ReadHeadRedemption/SeniorDesignSp26Su26/Website/Documents/Team/Andrew Photo.jpg

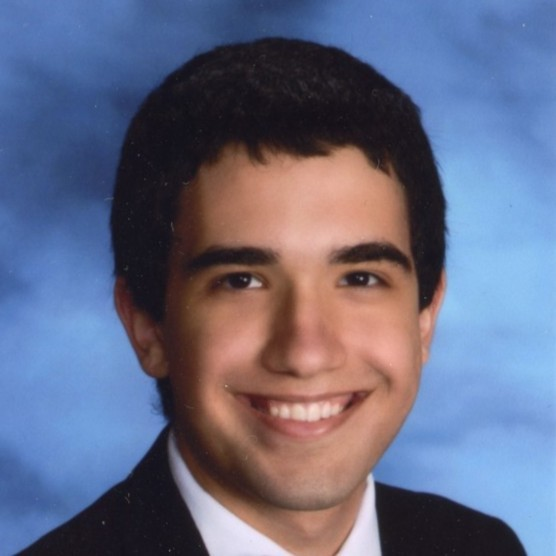
Website/Documents/Team/Andrew Photo.jpg
