ReadHeadRedemption/SeniorDesignSp26Su26/Website/Documents/Team/EthanPhoto.jpg

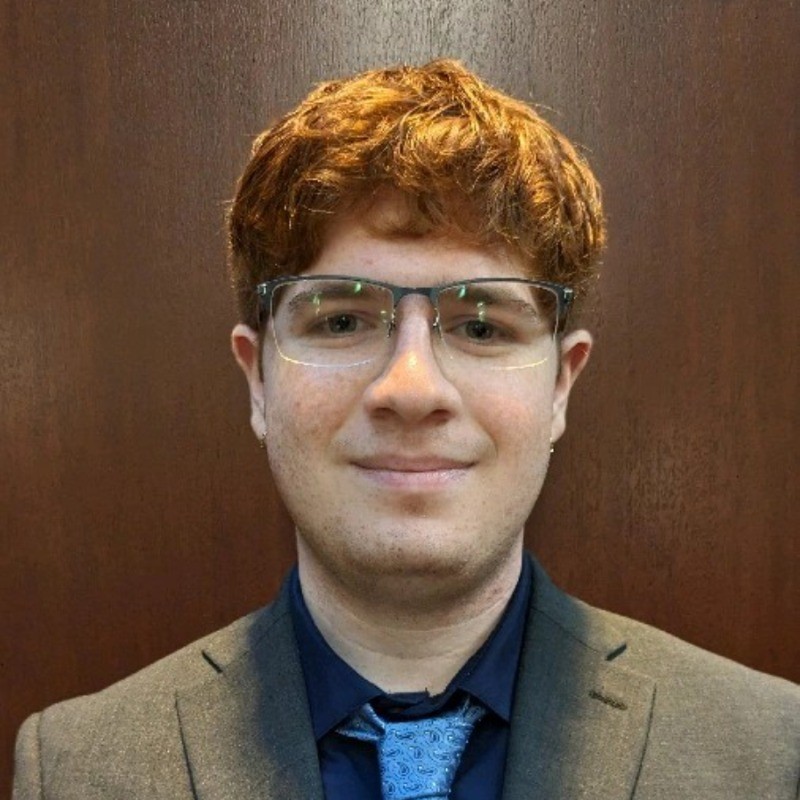
Website/Documents/Team/EthanPhoto.jpg
