ReadHeadRedemption/SeniorDesignSp26Su26/Website/Documents/SD1/D&C Submission.pdf

## Conductive Inking Prototype

Group 7 Authors:

Ethan Baker | Andrew Eppich | Jeremy Jiang | Giancarlo Luna
Computer Engineering | Computer Engineering | Computer Engineering | Electrical Engineering

Review Committee:

Dr. Avra Kundu | ECE | | Lab Manager
Dr. Nazanin Rahnavard | ECE | Professor
Michael Haas (tentative) | Tensentric | Vice President of Engineering

Advisors:

Dr. Arthurs Weeks | ECE | Senior Lecturer/Sponsor
Dr. Chung Yong Chan | ECE | Senior Lecturer

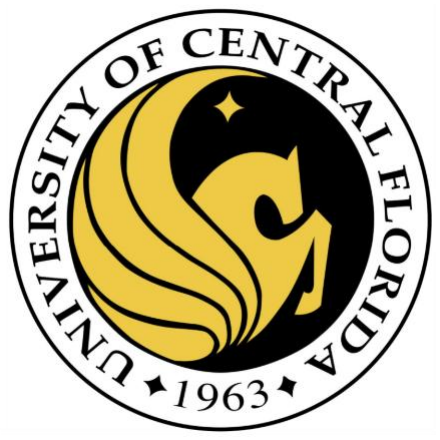
[picture p26: figure]

## Table of Contents

## Table of Figures

Figure 1 - House of Quality | 12
Figure 2 - Prototype Illustration | 13
Figure 3 - Hardware Diagram | 14
Figure 4 - Software Flowchart | 15

## Table of Tables

Table 1 - Engineering Specifications | 10
Table 2 - Project Budget Estimations | 16
Table 3 - Project Milestones | 16
Table 4 - Work Distribution | 17

## Chapter 2 – Project Description

## 2.1 Motivation and Background

Conductive ink and other additive technologies are relatively new methods of creating circuits. Traditionally, Printed Circuit Boards (PCBs) have been complex to design, requiring multiple stages to make a functional board. The simplest boards that most hobbyists can make are nothing more than milled copper using a traditional CNC machine. By using conductive ink, it is possible to make circuits in an additive method. Beyond creating PCBs on rigid surfaces, it allows for new inventive uses such as the uses that have been observed in the RF industry which allow for creating receivers on curved surfaces. Conductive ink also expands the possibilities of what materials can be used in PCB design, allowing for flexible PCBs or ones made for biosensors. Even the simplest uses of conductive ink expand the possibilities for the average individual to get involved in circuit design through conductive ink pens which can be used to literally draw circuits on paper.

The Conductive Inking Prototyping (CIP) is a project for UCF's ECE department senior design course over Spring 2026 – Summer 2026. The CIP is an additive manufacturing device sponsored by Dr. Arthur Weeks to add rapid PCB prototyping using conductive ink to UCF's manufacturing capabilities. By dispensing and then curing conductive ink on an appropriate substrate, it is possible to create both traditional rigid PCBs and also nontraditional PCBs on flexible and environmentally friendly materials. Additionally, it is possible to fix defective PCBs in a more permanent manner. Before this design, someone may need to jump a wire on the board or send a PCB back to design and manufacturing, which is often 2-week lead time at minimum. This solution will ultimately save time and money spent on production and shipping over boards that are made ‘out-of-house'.

The overall goal of this project is to allow UCF ECE department students the ability to design and test circuits more rapidly and with non-traditional technologies, expanding what is possible for their projects. The base of the project will consist of a striped Creality Ender 3 printer, and the electrical and software components will be completely redesigned to implement a modular printing head system. The goal of this system is to allow for printing heads that perform different functions to be swapped out. So not only can there be a conductive ink head that performs printing of traces on the PCB, but also an insulator ink head that would allow for traces to cross over each other, enabling enable more complex circuits.

## 2.2 Existing Product, Past Projects and Related Work

### 2.2.1 Prior Previous Work

2.2.1.1 Solder Paste Dispenser
The Solder Paste Dispenser (SPD) [1] is a previous Department of ECE senior design project by group 4 of fall 2024/spring 2025. The goal of the SPD was to take a modified Ender 3 printer and allow it to automate solder paste dispensing on a PCB when given the Gerber files. The paste would be dispensed via a pneumatic pump that would push the paste out. The SPD would manage quality control through a stereolithography system which could detect PCB placement as well as determining the height of paste mounds. The basic goal of the system was to achieve SMD sizes of 0603(imperial)/1608(metric), 0402(imperial)/1005(metric) as an advanced goal, and 0201(imperial)/0603(metric) as a stretch goal. The SPD replaced all the pre-existing circuitry with a custom motherboard and custom motor drivers. The SPD utilized a Raspberry Pi 4 to host a webserver for uploading Gerber files, as well as managing the stereoscopy. It also uses an ESP32-WROOM-32D to control the motor drivers and pneumatic pump, interface with limit switches and touchscreen, and to connect wirelessly to the Raspberry Pi. The SPD lacked the ability to cure the solder paste and required the use of an external reflow oven to finish the process. This provided a good time saving method for people who had multiple boards to manufacture or lacked a stencil but required the use of a second device to finish the process and could not place components independently.

Our project serves to act as almost a preliminary machine to the SPD through its ability to make the circuit boards that the SPD could finish with solder paste. Our stretch goal of the project is to eliminate the need for the SPD entirely by adding a feature to also extrude solder paste so the PCB can be designed all on one machine. This would create a one stop shop for single sideboard manufacturing and give the ability to solder paste existing circuit boards.

### 2.2.2 Existing and Related Products

2.2.2.1 Voltera V-One
The Voltera V-One [2] is a pre-existing 4 in 1 PCB design platform. The V-One is capable of dispensing silver ink, dispensing solder paste, milling with a drill head, and curing with a reflow heat bed. The Voltera V-One represents an ideal end goal for our project with its manufacturing prowess. It can use silver ink to make PCBs without milling, or it can mill copper boards to design more traditional PCBs. Once the silver ink is set, it can be cured using the built-in reflow hotplate. The V-One is also capable of milling to design two-layer PCBs using rivets to connect their layers. Finally, it can place solder paste to finish the board. Once all components are placed by hand, the V-One can act as a reflow hotplate to cure the solder paste. The V-One is currently listed at $3500 with shipping for the base option and $4200 when adding the milling head. While the V-One provides extensive manufacturing options when making a PCB, its cost keeps it out of the hands of most individuals without significant financial investment.

The high cost of this device has sponsored us to try and make an open-source variant with similar capabilities for less than half the cost. This would lead to a base lack of some features such as milling capabilities as that is a stretch goal for us but would lower the cost significantly and creating an open-source device would allow other users to adding features they want.

2.2.2.2 Voltera NOVA
The Voltera NOVA [3] is another manufacturing device produced by Voltera that is designed for manufacturing that is more like screen printing. The NOVA is more focused on designing circuits on flexible materials. It can design one sided circuits which are ideal for non-traditional boards or wearable electronics. The NOVA uses an insulator ink to allow for crossovers but is incapable of allowing for component placement on both sides of the board. Like the V-One, the NOVA uses EFD 5cc syringe barrels sold by Voltera but also allows for more freedom in material choice by sourcing materials from suppliers. The NOVA does not list a price but instead gives the option to request a quote from Voltera; however, the price of the smart dispenser and smart probe heads are $1599.99 and $1199.99 respectively, which is also prohibitive to many. The NOVA does not have a hotplate or any built-in curing method for materials which provides the need for another device for completing any circuit built by the NOVA.

Our project while heavily inspired by the NOVA and V-One, would make up for the lack of heating ability to finish on the nova and would improve on the high cost of the NOVA and it’s attachments. The probe head would only be needed for a nonplanar base such as a flexible material. As that is a stretch goal for us there is no initial need for such an expensive head. We can also cut down on the cost of the smart dispenser head by keeping it simple and using a linear actuator to extrude ink and determining the amount left by the heigh of the actuator head then the system can accept a variety of materials and also tell their fill state.

2.2.2.3 Circuit Jet
The Circuit Jet by Electronic Inks [4] is a desktop PCB printer that uses inkjet technology like the NOVA to print PCBs on a variety of substrates. The printer uses cartridges similar to traditional ink cartridges, and they can be disposed of in the same way. Not too much is given on the manufacturer's site, but it can be inferred that the Circuit Jet functions in a similar manner to the NOVA and suffers the same drawbacks such as a lack of ink curing capability.

This device, while simplistic in its nature, keeps it comparatively lower cost to the Volterra devices also lacks the curing ability of the Volterra V-One and lacks the variation of materials of the Volterra nova. Our project will strive to add curing features and standardization with the Volterra syringes to give more variety to the ink choice.

2.2.2.4 Brother MFC-J450DW
Brother Inkjet printers (or any other type of classic inkjet printer) can be modified to print with conductive ink [5]. Inkjet printers typically use piezoelectric or heat-based deposition methods. When a current is passed through, the nozzle will either heat slightly, creating a gas bubble depositing the ink, or the piezoelectric material will slightly expand pushing ink out. This option, while the least refined, is also the least expensive option. Using an inkjet printer cuts down on cost and allows rapid prototyping of circuits for under $200 depending on ink material and printer choice. However, the downsides of this method are numerous as the circuits are limited to printing only on paper. This means that traditional soldering or curing won't be a viable option as it will destroy the paper. Copper tape makes it possible to connect the printed traces to components, but tape is not mechanically solid for designing a production circuit. Using a traditional inkjet printer also means there is no way of curing the circuit, such as by UV, which means an additional machine will be needed.

The Brother Inkjet printers provide an initial starting point for considering the design of our printer as an additive device but this modification to the printers serves this project as inspiration and a starting point for us to create a device that can accept standardized syringes rather than having to modify ink cartridges. This project will also allow for real functional PCB design rather than just printing conductive circuits on ink which will allow for real soldering and stronger connectivity between components.

2.2.2.5 Aerosol Jet 5x
The Aerosol Jet 5x designed by Optomec [6] is an advanced 5 axis additive inkjet circuit manufacturing machine. The 5x can print not just with conductive inks but with a variety of other materials. The 5x also has capabilities for UV curing and laser sintering. Using the inkjet methodology and 5-axis printing, the 5x can also print on a variety of material, which allows for both traditional hard and flexible PCBs. On the manufacturer's site there is no price listed, but the option is given to contact for a quote. The only main drawback besides the assumably exorbitant price is the lack of drilling ability, so it is only possible to create circuits that can connect SMD components on one side (unless the object is pre-milled as shown in one of the example videos).

This product serves as a high scale inspiration of what we would like our project to imitate. While infeasible in the time span of senior design this project was chosen to inspire us for additive methods and to serve for future senior design students as a place for them to pick up where our project left off. It would be an ideal stretch goal for our project to be capable of 5 axis additive manufacturing as it would greatly expand the options of how we can manufacture PCBs.

## 2.3 Description of Features and Functionalities

As this project involves modifying an Ender 3, the features and functions that follow are designed to replace most electrical components and printer firmware as well as change the extrusion technology. The resulting system includes integrated features for operational control, design inspection, and verification.

Users begin by transferring a Gerber file of their PCB design to the slicer on their computer, which converts it to G-code for the printer. The system processes the Gerber file and translates the circuit trace patterns into precise movement instructions for the printer. Once the PCB substrate is properly positioned, users initiate the printing process through an integrated interface. The touchscreen interface provides complete control over printer operations, including print initiation, file selection, manual head positioning, and wireless transfer of schematics.

Accurate PCB positioning is achieved through an alignment fixture consisting of an L-bracket and magnets to hold the PCB in place, establishing a consistent reference origin for all printer movements. A magnetic build surface secures the PCB substrate and prevents its movement during the ink dispensing process, ensuring precise trace deposition and minimizing printing errors. Adding a rubber base to the magnets would increase the friction to prevent slippage as well as preventing the magnet bases from overheating.

The printer incorporates an integrated camera mounted to the dispenser assembly for calibration and quality inspection. The imaging system establishes the PCB origin by detecting alignment markers, such as April tags (or some similar way of detecting locations on the baseplate) on positioning brackets or board edges. This enables accurate trace placement relative to the substrate. The camera provides magnified views of deposited traces for manual inspection of trace width, spacing, and continuity. Users can verify each layer's quality before proceeding to the next, ensuring proper alignment and identifying defects such as breaks or spacing errors early in the fabrication process.

## 2.4 Goals and Objectives

2.4.1 Project Goals
The main goal of this project was to build a conductive ink printer to create PCBs by modifying an Ender 3 3D printer into a modular system. The goals are listed below:

2.4.1.1 Basic Goals:
- Modify a Creality Ender 3 to function as a conductive ink printer with 12-16 mils trace widths
- Design and implement a swappable head system to enable rapid switching between conductive ink dispensing and other potential functionalities such as insulator ink
- Develop system for automatic head detection
- Ensure proper trace isolation and spacing (minimum 12 mils) per schematic specifications
- Design and implement a user-friendly printer-side interface for printer control, parameter configuration, and PCB design selection

2.4.2.2 Advanced Goals:
- Use computer vision to validate printed traces against schematic specifications
- Enable the creation of crossover traces
- Allow the user to manually intervene in the operation of the conductive ink printer
- Incorporate a hotplate with programmable temperature control for curing and bonding conductive or insulating ink deposits

2.4.2.3 Stretch Goals:
- Create a head that performs solder pasting
- Enable part avoidance for post-hoc PCB modifications
- Design and integrate a milling head as an additional swappable tool option to enable the milling of vias for double-sided PCBs
- Develop a head for component placement
- Create a head to evenly distribute and cure a varnish to create a solder mask on the PCB while avoiding covering pads that should be exposed
- Create a web server for people to remotely request PCBs to be printed, which then can be fulfilled by an operator
- Enable printing on non-planar surfaces

2.4.2 Project Objectives
The objectives to achieve the goals are as follows:

2.4.2.1 Objectives for Basic Goals:
- Research and select appropriate conductive ink formulations compatible with dispensing systems
- Design custom mounting brackets and adapters for the swappable head mechanism

- Implement I2C or serial communication between the printer and tool heads with embedded identification chips, enabling firmware to detect head type and configure parameters accordingly
- Implement a slicer to convert a copper layer schematic into G-code
- Find what amount of pressure on the ink is necessary to obtain various desired trace widths through the nozzle
- Calibrate X/Y/Z axis movements and dispensing rates to achieve precise trace placement
- Select appropriate touchscreen hardware, develop GUI software, and integrate with printer firmware for seamless user control

Our basic goals focus on providing advanced PCB prototyping capabilities to existing, functional 3D printing platforms. Using a swappable head design, we can expand the range of fabrication modes and applications beyond standard FDM printing. Additionally, developing multi-layer deposition techniques with dielectric insulating layers would allow the creation of crossover traces, significantly expanding circuit design possibilities beyond simple single-layer circuits. The implementation of intelligent tool detection and configuration allows the system to automatically adapt to slicer parameters based on the installed head type using unique head IDs. The firmware modifications enable seamless transitions between different fabrication processes with minimal manual reconfiguration. The integration of computer vision for automated quality inspection provides users with real-time validation of printed traces against their original schematics, ensuring accuracy and reducing material waste from failed prints.

2.4.2.2 Objectives for Advanced Goals:
- Select and integrate appropriate solder paste dispensing hardware
- Incorporate a display directly on the printer for direct interaction
- Source a hotplate with programmable temperature control for reflow profiles
- Mount camera system to print head and implement computer vision algorithms to automatically inspect and validate printed traces against the original schematic design
- Implement pause/resume functionality, emergency stop controls, and manual parameter adjustment through the printer interface to enable operator intervention during printing
- Develop multi-layer deposition techniques for creating crossover traces with insulating ink

Conductive ink printers have a wide range of applications involving various PCB designs and complexities. Due to the unique requirements of complete PCB assembly, printing conductive traces alone is insufficient for functional prototypes. Many designs require component placement and soldering to create working circuits. To address this limitation while expanding the system's capabilities, our advanced goals provide the ability to create complete PCB assemblies through integrated solder paste dispensing and reflow soldering. These features streamline the entire fabrication process from trace printing to component bonding, minimizing manual intervention between stages. For example, a multi-layer PCB prototype can be fabricated over several hours with semi-automated transitions between conductive ink deposition, solder paste application, and thermal reflow for component attachment.

2.4.2.3 Objectives for Stretch Goals:
- Research CNC milling requirements, select compatible spindle/motor, and develop tool path generation algorithms for PCB milling and via drilling operations
- Implement model upload and part identification to avoid current packages on the PCB to place new traces without collision
- Implement surface scanning or mapping capabilities for non-planar detection
- Develop adaptive G-code generation for curved surface printing
- Design and integrate solder paste dispensing head with pneumatic pressure control system for automated paste deposition
- Develop pick-and-place head mechanism with vacuum gripper for automated component placement
- Develop web-based interface with user authentication, job queue management, and operator dashboard for remote PCB fabrication request fulfillment
- Design solder mask dispensing system with controlled application patterns and UV curing capabilities while implementing pad masking algorithms to preserve exposed connection points

As previously mentioned, the versatility of PCB prototyping platforms requires them to accommodate various substrate materials and fabrication techniques. Traditional subtractive methods like PCB milling remain essential for certain applications, particularly when working with rigid substrates or creating isolated copper regions. Complex circuit designs often require traces to cross over one another without electrical connection, a capability typically achieved through multi-layer PCBs or insulating bridge layers. Advanced prototyping scenarios may also involve non-planar surfaces for wearable electronics or conformal applications. If the system is limited to flat, single-layer substrate printing, it cannot accommodate these specialized use cases. Our stretch goals introduce CNC milling capabilities as an additional swappable head option, enabling both additive and subtractive fabrication methods on a single platform. By implementing surface scanning and adaptive path generation, we can accommodate curved or irregular surfaces for conformal electronics applications. This expansion would transform the platform from a single-purpose conductive ink printer into a comprehensive PCB prototyping workstation capable of addressing diverse fabrication requirements that researchers and makers encounter in their projects.

## 2.5 Engineering Specifications

Table 1 - Engineering Specifications

System Spec | Value | Description
Max flow rate | >=0.4 mL/s | The maximum rate we can extrude silver ink, relates to the production rate. Limited by the control mechanism that outputs ink.
Ink laying precision* | .3 +/- mm | Informs ink placement

Trace width | 12 - 16 mil | The width that the machine is capable of performing at
Print area | ≥200 mm × ≥200 mm | The total area on the plate we can work on top of
XYZ resolution | .1 +/- mm | The precision of the printer
Syringe capacity | 10 mL | Total capacity that the machine can hold of ink
Substrate thickness | >=5 mm | The max thickness of the material to print on
Connectivity | 50 – 150 Mbps
Cost | >= 300 $ | The total this machine has been budgeted for in dollars
Max print speed | >=200 mm/s | Informs rate of production
Power consumption | ≤200 W average; ≤400 W peak | Measured at wall outlet
Component spec | Value | Description
connectivity | 50 – 150 Mbps | The goal is to create a stable connection for transmitting g-code
Curing temp* | <=175 C | The rated temperature for our ‘reference ink’ to cure at
Cure time* | <=5 Minutes | The time at rated temp it takes to cure

* - dependent on ink properties

## 2.6 House of Quality

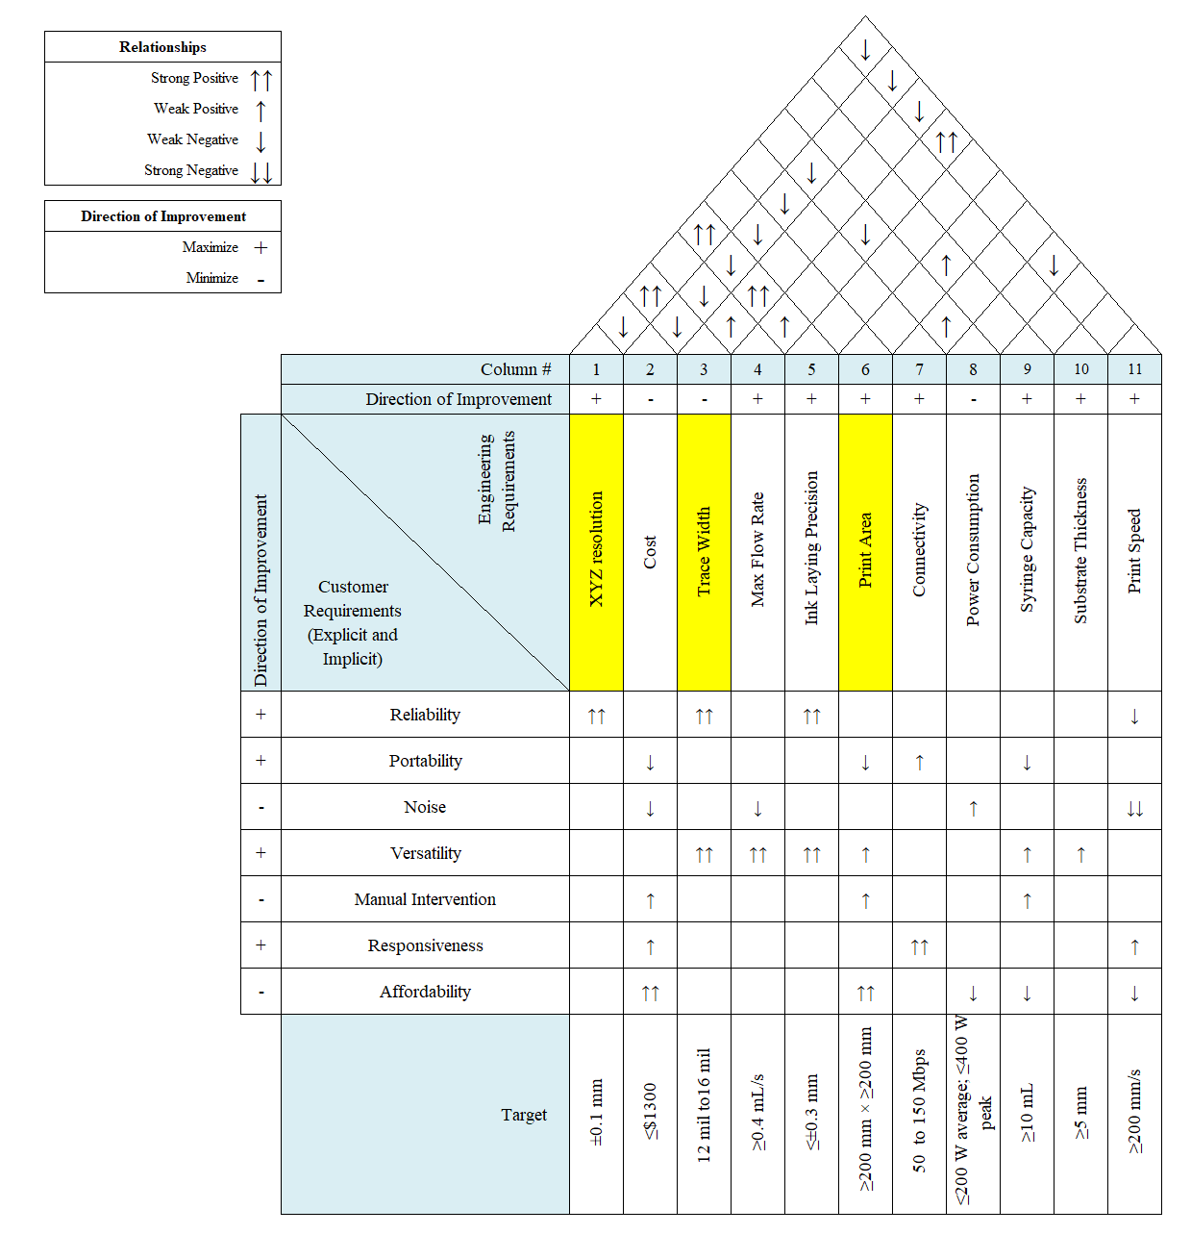
[picture p27: figure]

Figure 1 - House of Quality

We felt the customer would prioritize the requirements listed above for various reasons. The machine should have high accuracy to be effective for PCB prototyping. If the traces are too large or overlap, then it would lead to a failure of a PCB. Increased accuracy also relates to increased versatility, which we feel is a big selling point for this machine. We hope to increase surface area and support as many PCB designs as possible.

In addition, we decided customers would prefer high portability, low noise, minimized manual intervention, and high responsiveness as quality-of-life improvements. The printer should be relatively portable to compete with other printers like Voltera and beat large and immobile mills. Using an existing 3D printer somewhat restrains this portability in terms of dimensions, but increasing wireless connectivity and decreasing print area could help. For customers to willingly use this machine on their desktop or in a workshop, it would be preferable to keep noise low so as not to bother the user. Minimizing power consumption and spending more on quieter and more power efficient parts would help reduce noise. As for manual intervention, we would like to keep the need for it as minimal as possible, only requiring the user to upload the Gerber file, swap a head if necessary, and start the printing process. However, we intend to support complete control over the machine by the user if desired.

Additionally, we would like to minimize the cost of this project to make it a less expensive product compared to alternatives.

## 2.7 Prototype Illustration

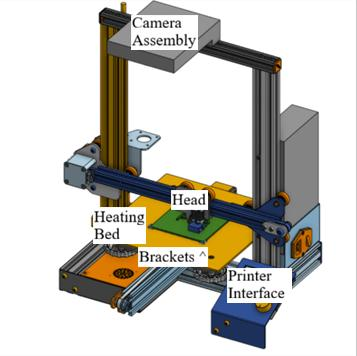
[picture p28: figure]

Figure 2 - Prototype Illustration

This image represents a rough draft of the finalized product. The base of it will be a modified version of an Ender 3. Most of the mechanical body will be kept the same, but the printer's electronics will be replaced. The standard dial and screen will be replaced with updated components to further electrical component replacement. A camera will be added (location may vary) to capture an image of the PCB that will be lined up with and compared to the Gerber reference. Mounts will also be added to hold the PCB in place while the ink printer is active. The base of the printer will be replaced with a new heat bed to reach the higher temperatures needed for the silver ink to cure. The head of the printer will finally be replaced completely with a new head capable of storing an ink cartridge with a linear actuator to push silver ink onto the PCB. The head will also be designed to be modular to allow for the variety of inks (and further features in our stretch goals).

## 2.8 Hardware Flowchart

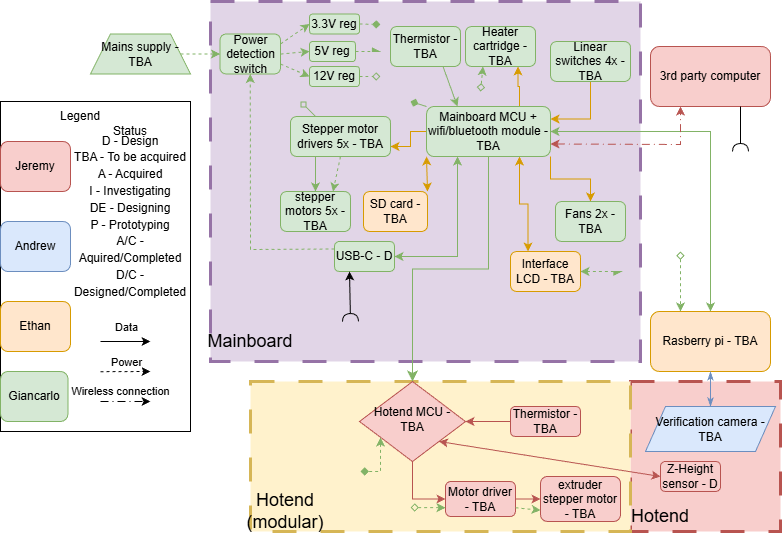
[picture p29: figure]

Figure 3 - Hardware Diagram

This hardware flowchart makes a couple of assumptions. That all data lines will use some kind of protocol and for legibility we chose to not denote the exact protocol. We will be documenting the exact protocols in use in another diagram better suited for this info.

## 2.9 Software Flowchart

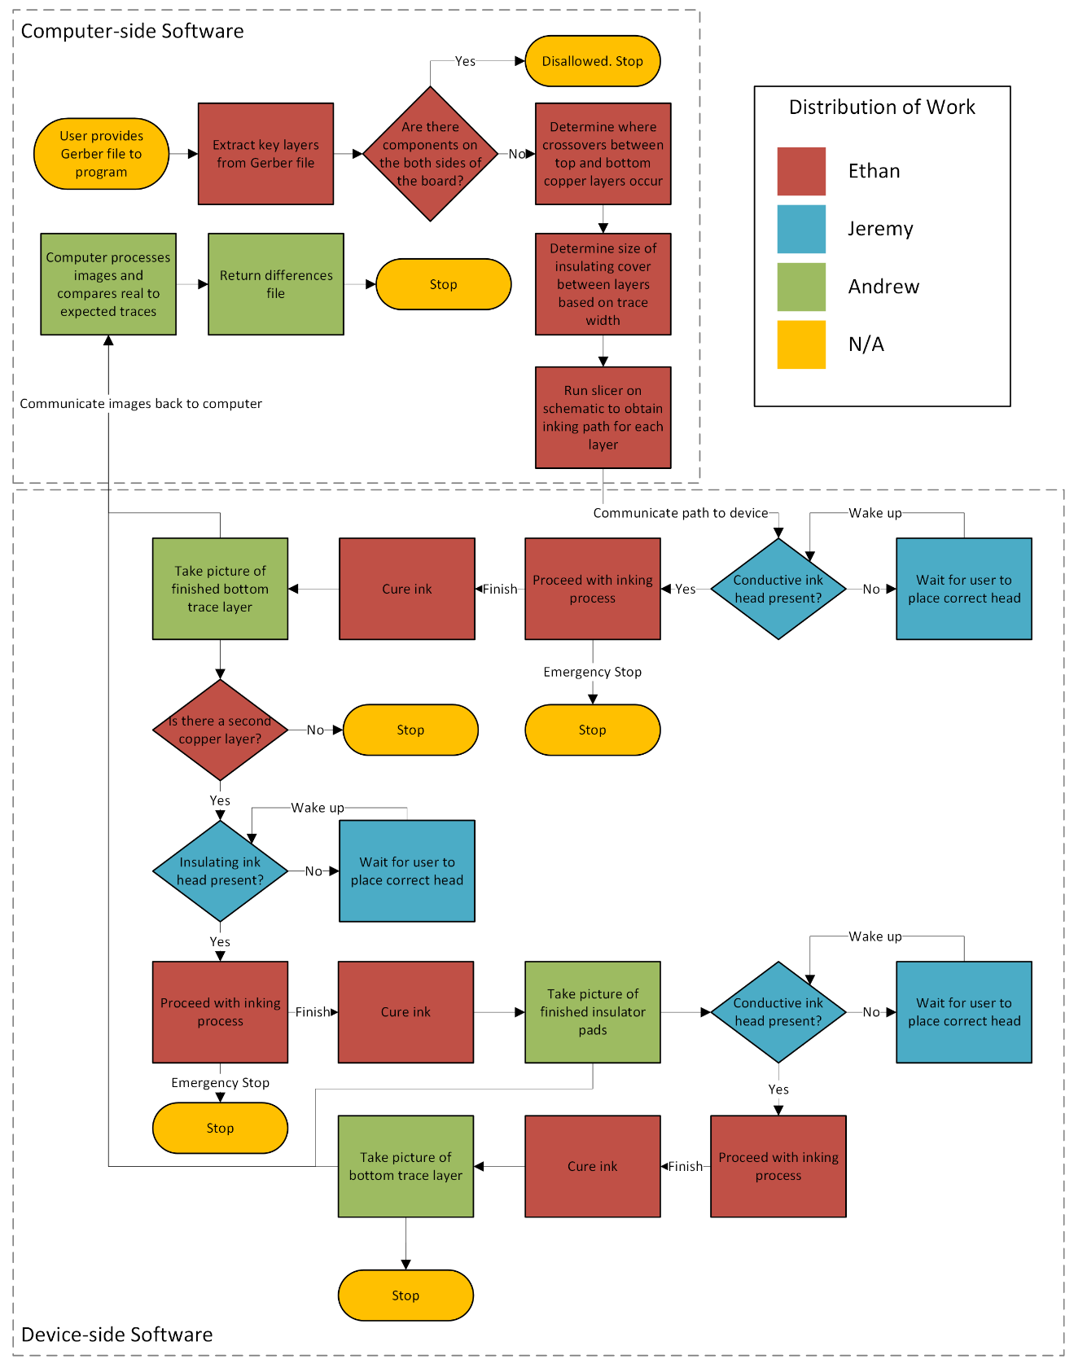
[picture p30: figure]

Figure 4 - Software Flowchart

## 2.10 Budget and Financing

This project is being sponsored by Dr. Arthur Weeks from the Department of Electrical and Computer Engineering at UCF. The budget table is provided below:

Table 2 - Project Budget Estimations

Subsystem/Category | Estimated Cost
Printer Hardware* | $280
Dispensing System | $305
Control System | $90
Swappable Head System | $70
Vision System | $70
Mechanical Components | $80
PCB Manufacturing | $140
Shipping & Handling | $50
Contingency (20%) | $215
Total | $1300
*The 3D printer was donated to the project and excluded from the total cost

## 2.11 Milestones

Table 3 - Project Milestones

Milestone Number | Milestone Description | Start Date | Estimated End Date | Advisors and requirements
1 | Select Reviewers and sponsors | 1/13/26 | 1/26/25 | Get email agreement from all reviewers and secure sponsorship
2 | Finish D&C Report | 1/13/26 | 1/25/26 | All team members finish writing respective sections of D&C report and we have 1 week to review
3 | D&C Review Meeting | 1/26/26 | 1/29/26 | Review D&C report with Dr. Chan and finish any edits before due date on 1/30/26
4 | D&C Group Meeting | 2/2/26 | 2/4/26 | Meet with group advisor for approval of D&C and overall project
5 | Upload D&C to website | 2/4/26 | 2/6/26 | Upload D&C to website and ensure all reviewers have access
6 | Start Midterm Report | 2/9/26 | 3/26/28 | Work on midterm report and finish a week early to give more time to meet with advisors/reviewers
7 | Start working on demo | 2/9/26 | 4/14/26 | Work on demo while finishing paper
8 | Work on PCB Design | 3/10/26 | 4/28/26 | Work on PCB design for motherboard and order over break

9 | Midterm Report Meeting | 3/30/26 | 4/1/26 | Meet with advisor to discuss midterm report
10 | Finish Final Report | 4/6/26 | 4/21/26 | Finish writing final report once midterm report is finished
11 | Record Demo Video | 4/14/26 | 4/21/26 | Record demo video

Table 4 - Work Distribution

Task | Primary | Secondary
Motherboard PCB Design | Gianni | Ethan
System Power | Gianni | Ethan
Standard Head PCB Design | Jeremy | Andrew
Slicer Modification | Ethan | Andrew
Camera Vision | Andrew | Ethan
Head Embedded Programing | Jeremy | Andrew
Device Communication Handshakes | Gianni | Jeremy
Printer Interface Embedded Programming | Ethan | Andrew
Head Housing CAD Design | Jeremy | Gianni

## Appendices

## Appendix A – References

[1] “Project showcases,” Spring 2025 Showcase – CREOL, The College of Optics and Photonics, https://creol.ucf.edu/academics/senior-design/spring-2025/ (accessed Jan. 25, 2026).
[2] | “Voltera | V-one | PCB | printer: | Drill, | dispense, | and | reflow,” | Voltera,
https://store.voltera.io/products/v-one (accessed Jan. 21, 2026).
[3] “Flexible material dispensing - nova printed electronics platform,” Voltera Inc., https://www.voltera.io/products/nova (accessed Jan. 25, 2026).
[4] “Circuit jet,” Electroninks, https://electroninks.com/circuit-jet/ (accessed Jan. 25, 2026).
[5] Maximous, “Print conductive circuits with an inkjet printer,” Instructables, https://www.instructables.com/Print-Conductive-Circuits-With-An-Inkjet-Printer/(accessed Jan. 25, 2026).
[6] “AJ 5X,” Optomec, https://optomec.com/aj-5x/ (accessed Jan. 25, 2026).
