ReadHeadRedemption/SeniorDesignSp26Su26/Website/Documents/Team/Gianni Photo.jpg

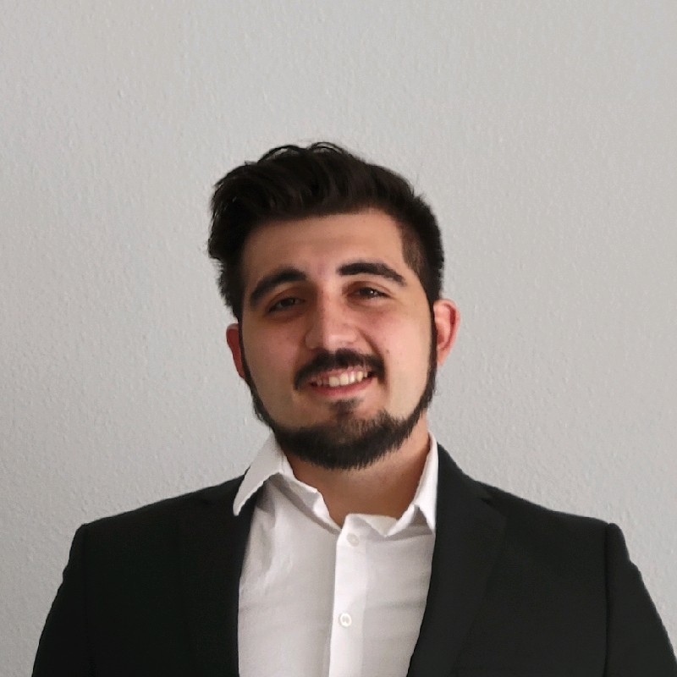
Website/Documents/Team/Gianni Photo.jpg
