ReadHeadRedemption/SeniorDesignSp26Su26/Website/Documents/Team/Jeremy Photo.jpg

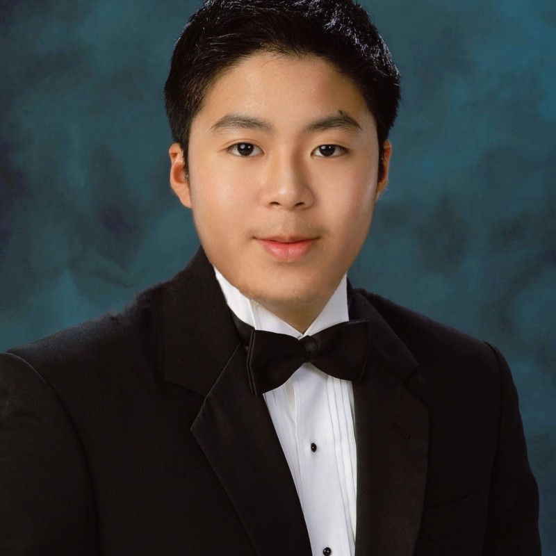
Website/Documents/Team/Jeremy Photo.jpg
