ReadHeadRedemption/SeniorDesignSp26Su26/Hardware/Folder of holdin/ESP32-S3-WROOM-2_Reference_Design/ESP32-S3-WROOM-2_V1.3_Reference_Design/05_BOM/BOM(V0.7)_ESP32-S3-WROOM-2.xls

BOM(V0.7)_ESP32-S3-WROOM-2
Item | Quantity | Reference | Value | Package | ICs | Description | Notes
1 | 2 | C1, C4 | TBD | C0201 | Capacitor | Ceramic Capacitors | Defined by RF Test
2 | 1 | C2 | 10 nF / 10 V (10%) | C0201 | Capacitor | Ceramic Capacitors
3 | 3 | C3, C7, C14 | 1 uF / 6.3 V (20%) | C0201 | Capacitor | Ceramic Capacitors
4 | 1 | C6 | 10 uF / 6.3 V (20%) | C0402 | Capacitor | Ceramic Capacitors
5 | 5 | C8, C9, C10, C13, C15 | 0.1 uF / 6.3 V (10%) | C0201 | Capacitor | Ceramic Capacitors
6 | 1 | C11 | TBD | C0201 | Capacitor | Ceramic Capacitors | Defined by RF Test
7 | 1 | C12 | TBD | C0201 | Capacitor | Ceramic Capacitors | Defined by RF Test
8 | 1 | L2 | TBD | L0201 | Inductor | Inductor | Defined by RF Test
9 | 1 | L3 | TBD | L0201 | Inductor | Inductor | Defined by RF Test
10 | 1 | C16 | TBD | C0201 | Capacitor | Ceramic Capacitors | Defined by RF Test
11 | 1 | L1 | 2.0 nH (0.1 nH), 600 mA | L0201 | Inductor | Inductor | Defined by RF Test
12 | 1 | R4 | 24 nH (3%), 140 mA | L0201 | Inductor | Inductor | Defined by RF Test
13 | 2 | R1(NC), R11, R12 | 10 KΩ (1%), 1/20 W | R0201 | Resistor | Chip Resistors
14 | 1 | R3 | 499 Ω (1%), 1/20 W | R0201 | Resistor | Chip Resistors
15 | 10 | R5, R6, R7, R8, R9, R10, R13, R14, R15, R16 | 0 Ω (1%), 1/20 W | R0201 | Resistor | Chip Resistors
16 | 1 | D1 | TVS Diode, Bi-Direction, 3.3V | SOD882 | ESD / TVS | TVS Diode, 3.3 V
17 | 1 | U1 | ESP32-S3R8V, Wi-Fi + BT + MCU + 8MB 1.8V OSPI PSRAM | QFN56_0P4_7 | Chip | Wi-Fi + BT + MCU + PSRAM
18 | 1 | U2 | 1.65 ~ 2.0 V, 200MHz, Standard & Octal SPI & DOPI | BGA25-6X8-1P0 | Chip | 1.8 V OSPI FLASH
19 | 1 | Y1 | 40 MHz, ±10 ppm, 15 pF, 100 uW | XTAL3225 | Cystal | 40 MHz Cystal
20 | 1 | Shield Box | Shield Box Size: 17.6 mm * 15.8 mm * 2.3 mm, T = 0.20 mm | - | - | -
21 | 1 | PCB | ESP32-S3-WROOM-2 V1.2, 4L, 18 mm * 25.5 mm * 0.8 mm, Halogen-free, Matte black for Solder mask and white for silkscreen, immersion gold and 50 Ω impedance control. | - | - | -
*Please be noted that C16, C11, C12, L2 and L3 are recommended to use Murata for good quality and accuracy.
