ReadHeadRedemption/SeniorDesignSp26Su26/Hardware/KiCAD files/Footprint libraries/PCA9534PW/PCA9534PW_118.step

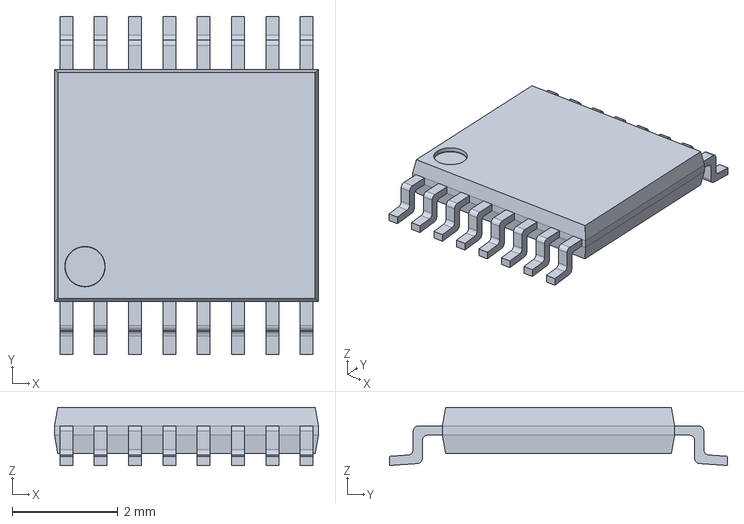
[picture p33: CAD file, 2026-04-26]
Hardware/KiCAD files/Footprint libraries/PCA9534PW/PCA9534PW_118.step
5.00 x 6.41 x 1.10 mm
