ReadHeadRedemption/SeniorDesignSp26Su26/Hardware/KiCAD files/LM2576_Var_Volt_Reg/LibraryFiles/MBR360G/MBR360G.step

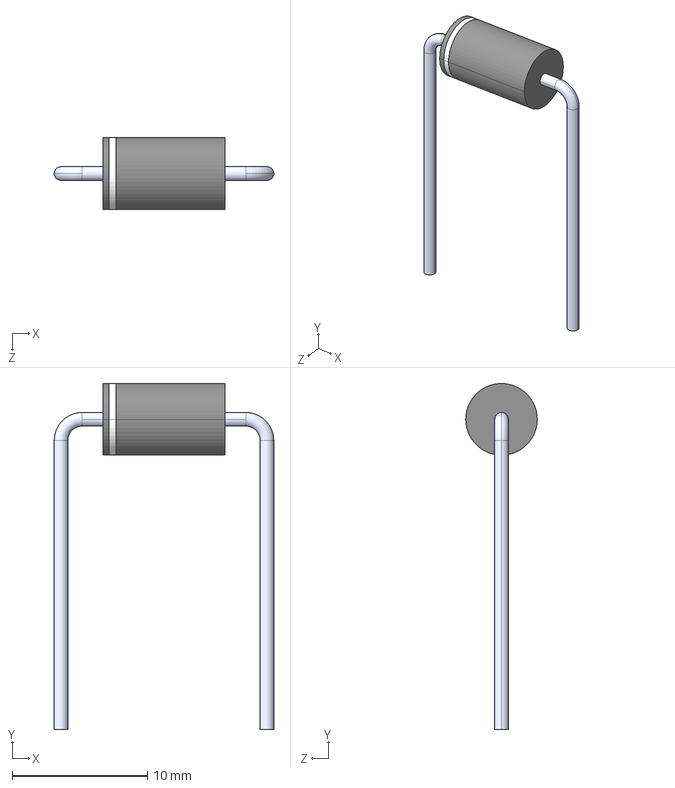
[picture p34: CAD file, 2026-04-08]
Hardware/KiCAD files/LM2576_Var_Volt_Reg/LibraryFiles/MBR360G/MBR360G.step
16.3 x 25.6 x 5.30 mm
