ReadHeadRedemption/SeniorDesignSp26Su26/Hardware/KiCAD files/LM2679PiRegulator/PartsLibrary/2100LL-221H-RC/3D/2100LL-221H-RC.stp

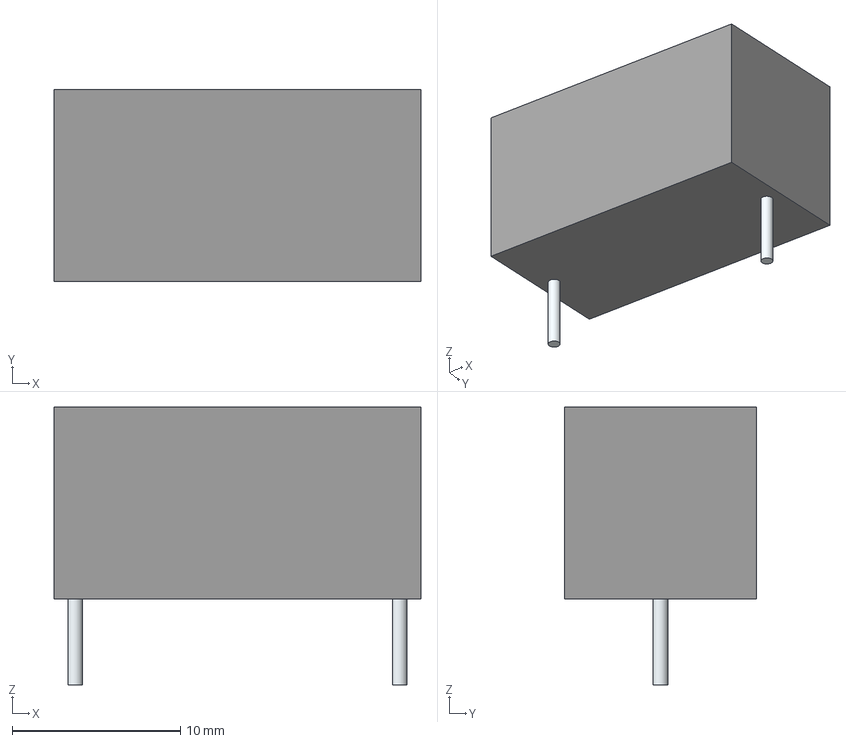
[picture p35: CAD file, 2026-04-21]
Hardware/KiCAD files/LM2679PiRegulator/PartsLibrary/2100LL-221H-RC/3D/2100LL-221H-RC.stp
21.8 x 11.4 x 16.5 mm
Leads
