ReadHeadRedemption/SeniorDesignSp26Su26/Hardware/KiCAD files/parts libraries/exported libraries/DRV8825pwp/DRV8825PWP.step

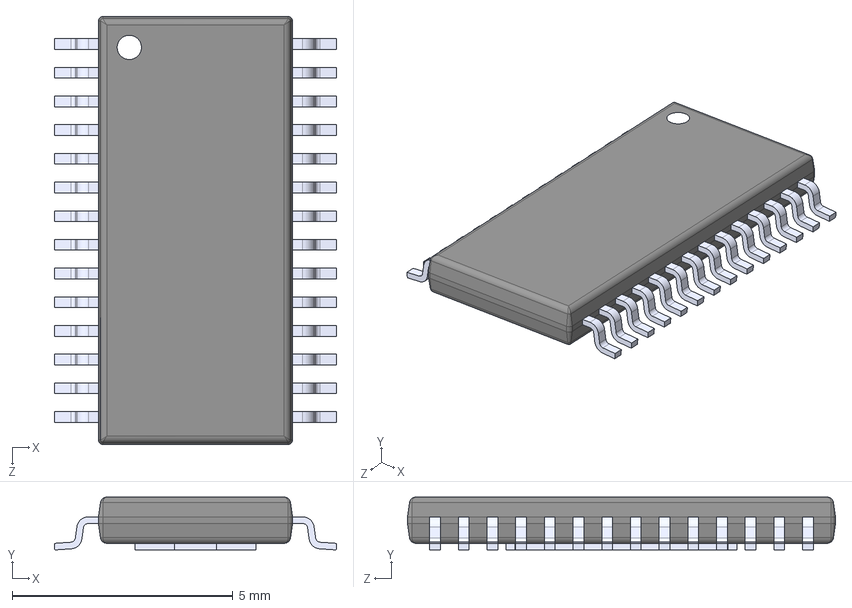
[picture p36: CAD file, 2026-04-20]
Hardware/KiCAD files/parts libraries/exported libraries/DRV8825pwp/DRV8825PWP.step
6.40 x 1.20 x 9.70 mm
