ReadHeadRedemption/SeniorDesignSp26Su26/Hardware/KiCAD files/parts libraries/exported libraries/IL9341 TFT/TFT_320x240_touch_r0.step

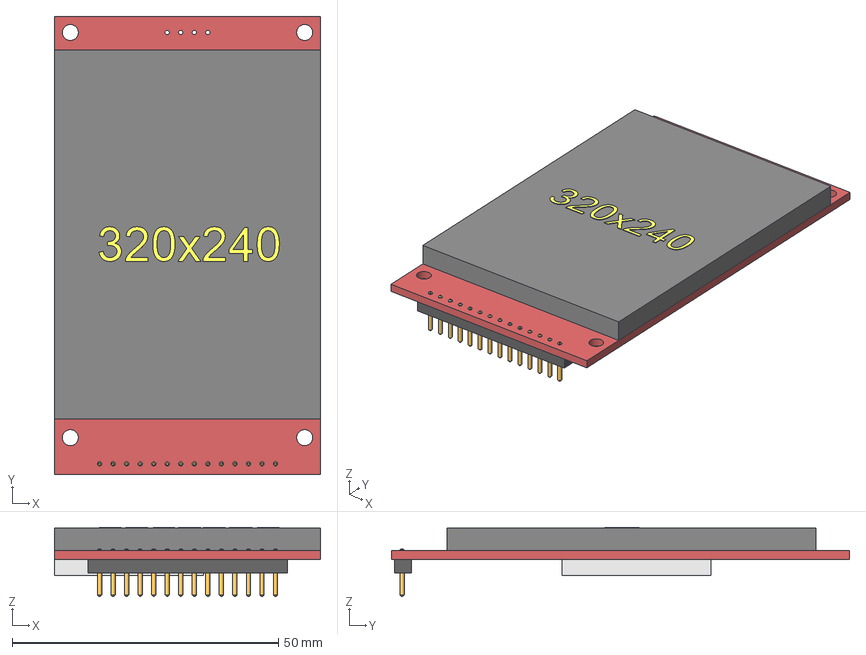
[picture p37: CAD file, 2026-04-02]
Hardware/KiCAD files/parts libraries/exported libraries/IL9341 TFT/TFT_320x240_touch_r0.step
50.0 x 86.0 x 13.1 mm
Body-header
Body-pins
Body-display
Body-sdcard
Body-board
