ReadHeadRedemption/SeniorDesignSp26Su26/Hardware/KiCAD files/parts libraries/exported libraries/STM32H7/STM32H723VEH6/3D/STM32H723VEH6.stp

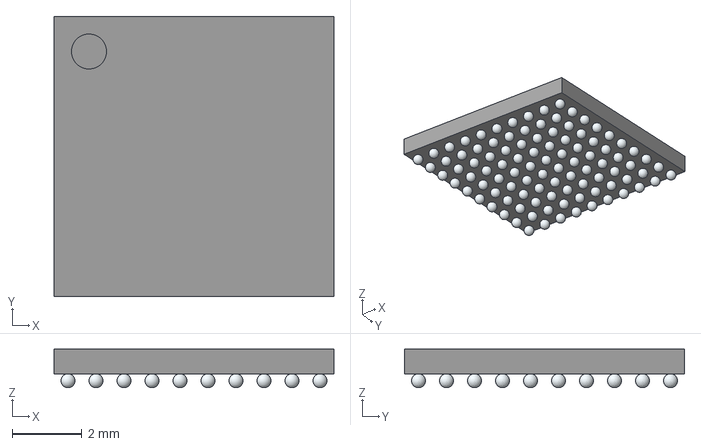
[picture p38: CAD file, 2026-04-02]
Hardware/KiCAD files/parts libraries/exported libraries/STM32H7/STM32H723VEH6/3D/STM32H723VEH6.stp
8.00 x 8.00 x 1.10 mm
