ReadHeadRedemption/SeniorDesignSp26Su26/Hardware/KiCAD files/parts libraries/exported libraries/Trimmer pot. 100k/3361P-1-104GLF.step

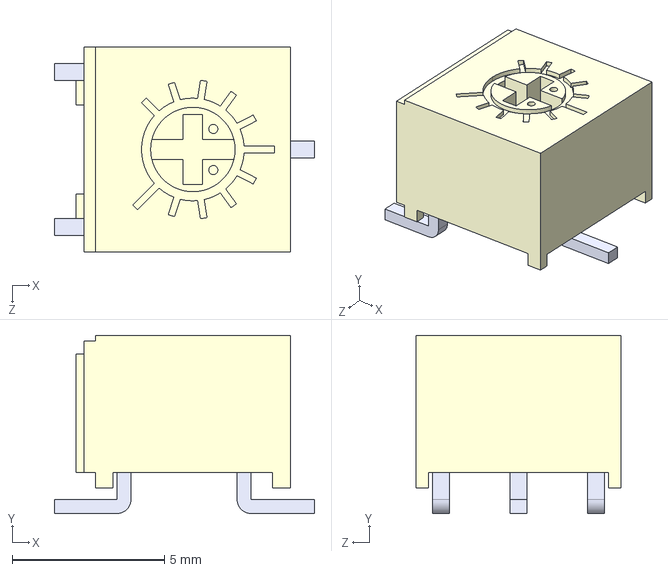
[picture p39: CAD file, 2026-04-20]
Hardware/KiCAD files/parts libraries/exported libraries/Trimmer pot. 100k/3361P-1-104GLF.step
8.53 x 5.84 x 6.71 mm
