ReadHeadRedemption/SeniorDesignSp26Su26/Hardware/KiCAD files/parts libraries/exported libraries/USB_Connectors/USB-A1VSB6.step

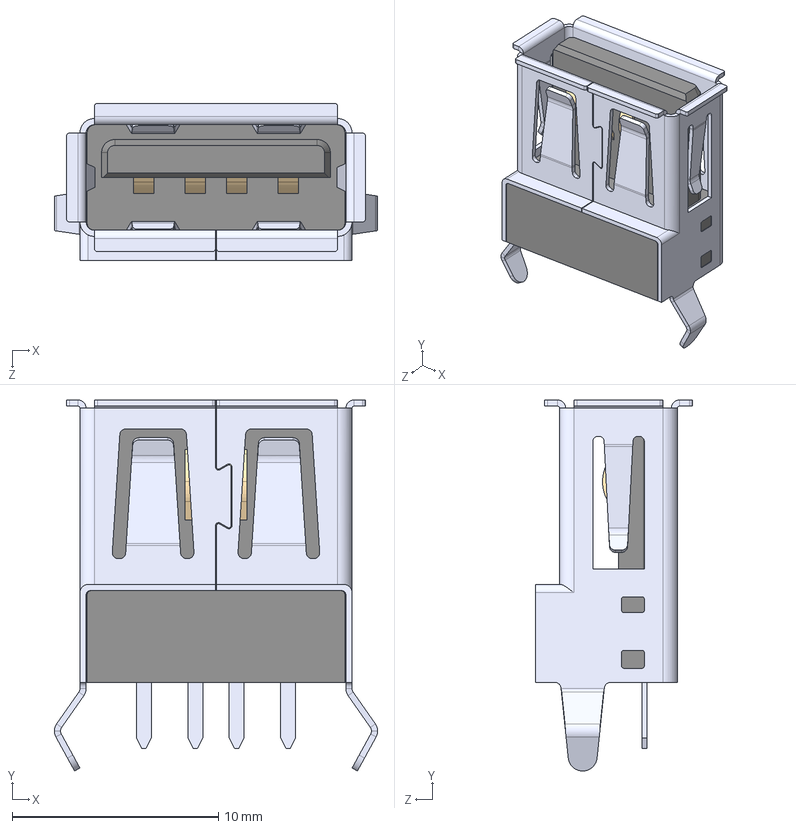
[picture p40: CAD file, 2026-04-08]
Hardware/KiCAD files/parts libraries/exported libraries/USB_Connectors/USB-A1VSB6.step
15.7 x 18.0 x 7.64 mm
