ReadHeadRedemption/SeniorDesignSp26Su26/Hardware/KiCAD files/reference schematics/Senior design/drv8825 reference/Stepper-motor-driver-DRV8825-board-hardware-design-main/OUTPUTS/V1.2.0/Stepper_driver_DRV8825_3D.step

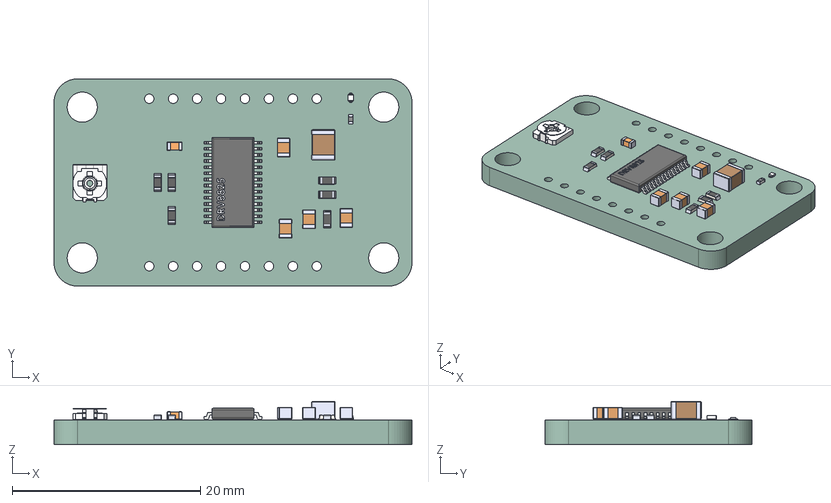
[picture p41: CAD file, 2026-04-21]
Hardware/KiCAD files/reference schematics/Senior design/drv8825 reference/Stepper-motor-driver-DRV8825-board-hardware-design-main/OUTPUTS/V1.2.0/Stepper_driver_DRV8825_3D.step
38.0 x 22.0 x 4.58 mm
User Library-R0603-1 x 6
CL21A106KPFNNWE x 4
DRV8825 IC
06035A910JAT2A
SML-P11MTT86
User Library-TC-33X-2
RL0402JR-070R51L
C1210C335K5RACAUTO
_autosave-Stepper motor driver DRV8825 board_PCB
