ReadHeadRedemption/SeniorDesignSp26Su26/(list of files, cad)

Other CAD files:
Hardware/KiCAD files/LM2679PiRegulator/PartsLibrary/2100LL-221H-RC/Allegro/2100ll221hrc.psm
Hardware/KiCAD files/LM2679PiRegulator/PartsLibrary/2100LL-221H-RC/DEHDL/2100ll_221h_rc/chips/chips.prt
Hardware/KiCAD files/parts libraries/exported libraries/STM32H7/STM32H723VEH6/Allegro/bga100c80p10x10_800x800x110.psm
Hardware/KiCAD files/parts libraries/exported libraries/STM32H7/STM32H723VEH6/DEHDL/stm32h723veh6/chips/chips.prt
Hardware/KiCAD files/parts libraries/exported libraries/STM32H723zGT6 THIS ONE/STM32H723ZGT6/Allegro/qfp50p2200x2200x160-144n.psm
Hardware/KiCAD files/parts libraries/exported libraries/STM32H723zGT6 THIS ONE/STM32H723ZGT6/DEHDL/stm32h723zgt6/chips/chips.prt
