ReadHeadRedemption/SeniorDesignSp26Su26/Hardware/KiCAD files/reference schematics/Senior design/drv8825 reference/Stepper-motor-driver-DRV8825-board-hardware-design-main/CAD/Change Log.xlsx

CHANGE LOG
 | Latest version |  |  | v1.1.1
 |  | Product name: |  | Stepper motor driver DRV8825 board
 |  | Release date: |  | 12.7.2021.
 |  | Release author: |  | Ivan
Version: | v1.0.0 | Author: | Ivan | Date: | 15.4.2021.
List of Changes
 | Initial document
Version: | v1.1.1 | Author: | Ivan | Date: | 12.7.2021.
List of Changes
 | Dodana PWR LED
 | Pomaknute oznake na zadnjoj strani jer ih header prekrije kada se stavi
 | OSH logo pomaknut na sredinu pločice
 | Dodan pull-up na SLEEP i RST pin
 | Stavljen simbol za motor
 | Stavljen novi fiducial
 | Popravljen footprint za C1 s 0805 na 1210
