ReadHeadRedemption/SeniorDesignSp26Su26/Hardware/KiCAD files/Swapping hotend board/Swapping hotend board-B_Mask.pdf

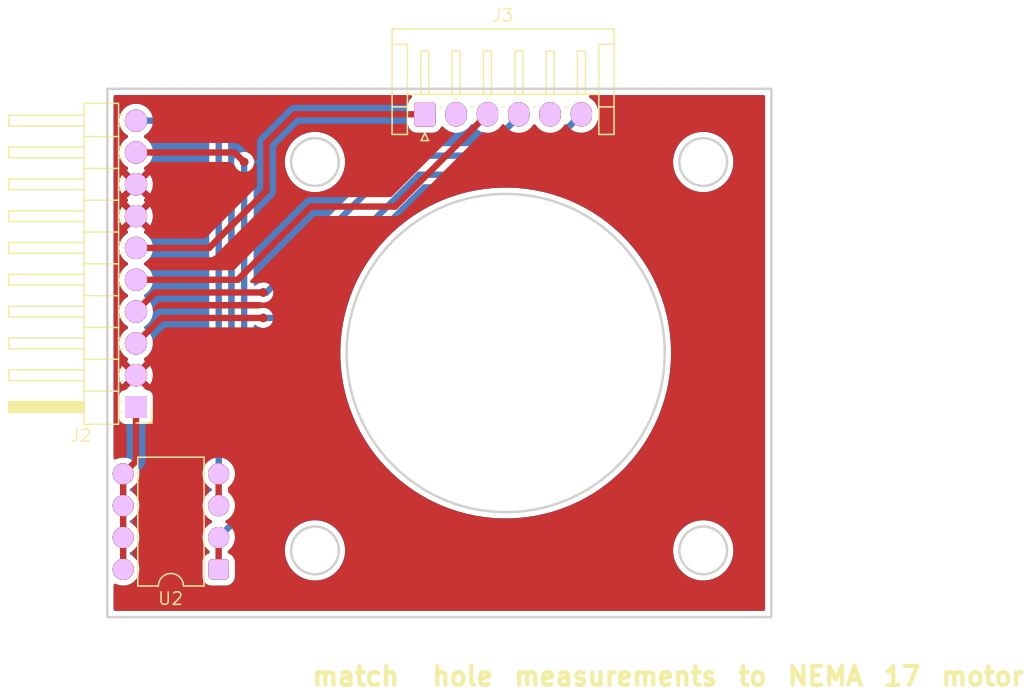
[picture p43: page 1]

match hole measurements to NEMA 17 motor U2
