ReadHeadRedemption/SeniorDesignSp26Su26/Hardware/KiCAD files/Swapping hotend board/Swapping hotend board-B_Silkscreen.pdf

match hole measurements to NEMA 17 motor U2
