ReadHeadRedemption/SeniorDesignSp26Su26/Hardware/KiCAD files/Swapping hotend board/Swapping hotend board-Edge_Cuts.pdf

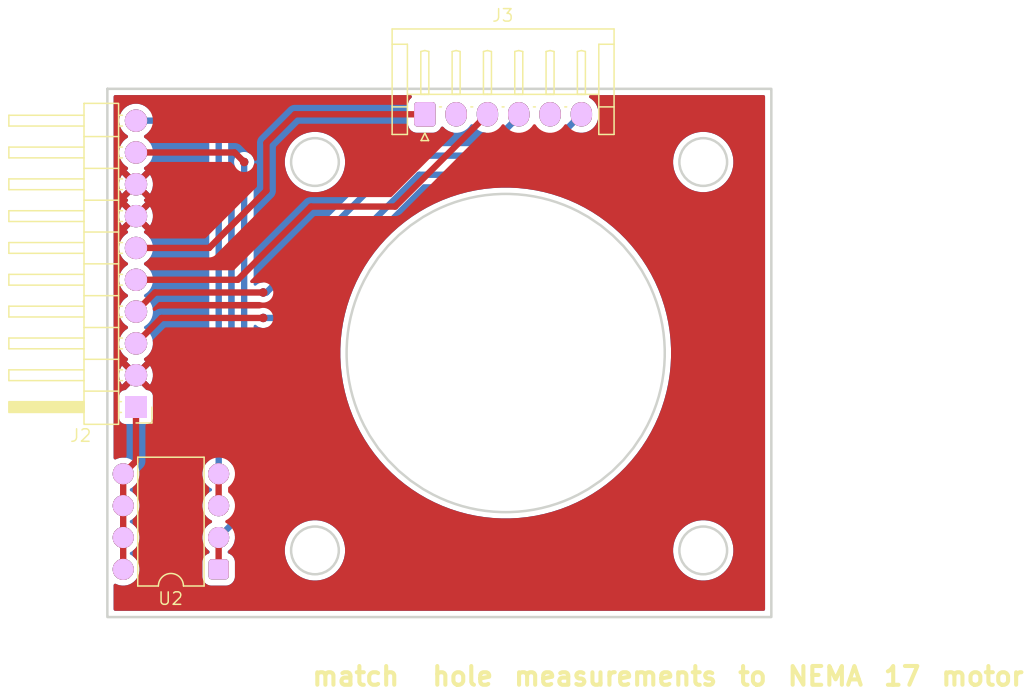
[picture p44: page 1]

match hole measurements to NEMA 17 motor U2
