ReadHeadRedemption/SeniorDesignSp26Su26/Hardware/KiCAD files/Swapping hotend board/Swapping hotend board-F_Mask.pdf

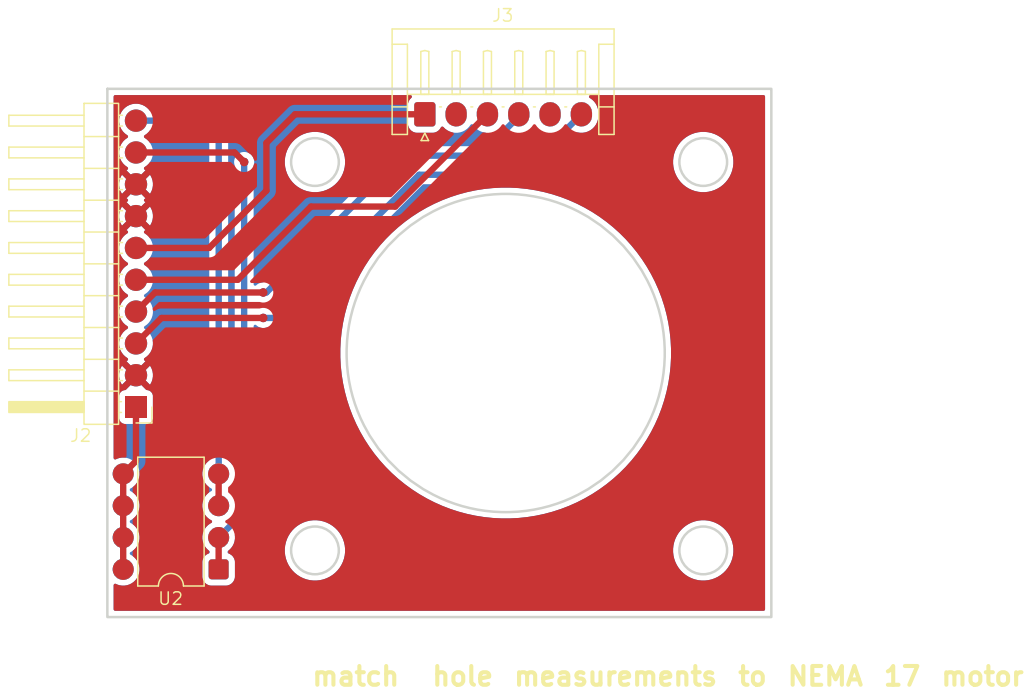
[picture p46: page 1]

match hole measurements to NEMA 17 motor U2
