ReadHeadRedemption/SeniorDesignSp26Su26/Hardware/Review PDF's/Initial PCB review/Mainboard Layout 5-22-2026 Schem.pdf

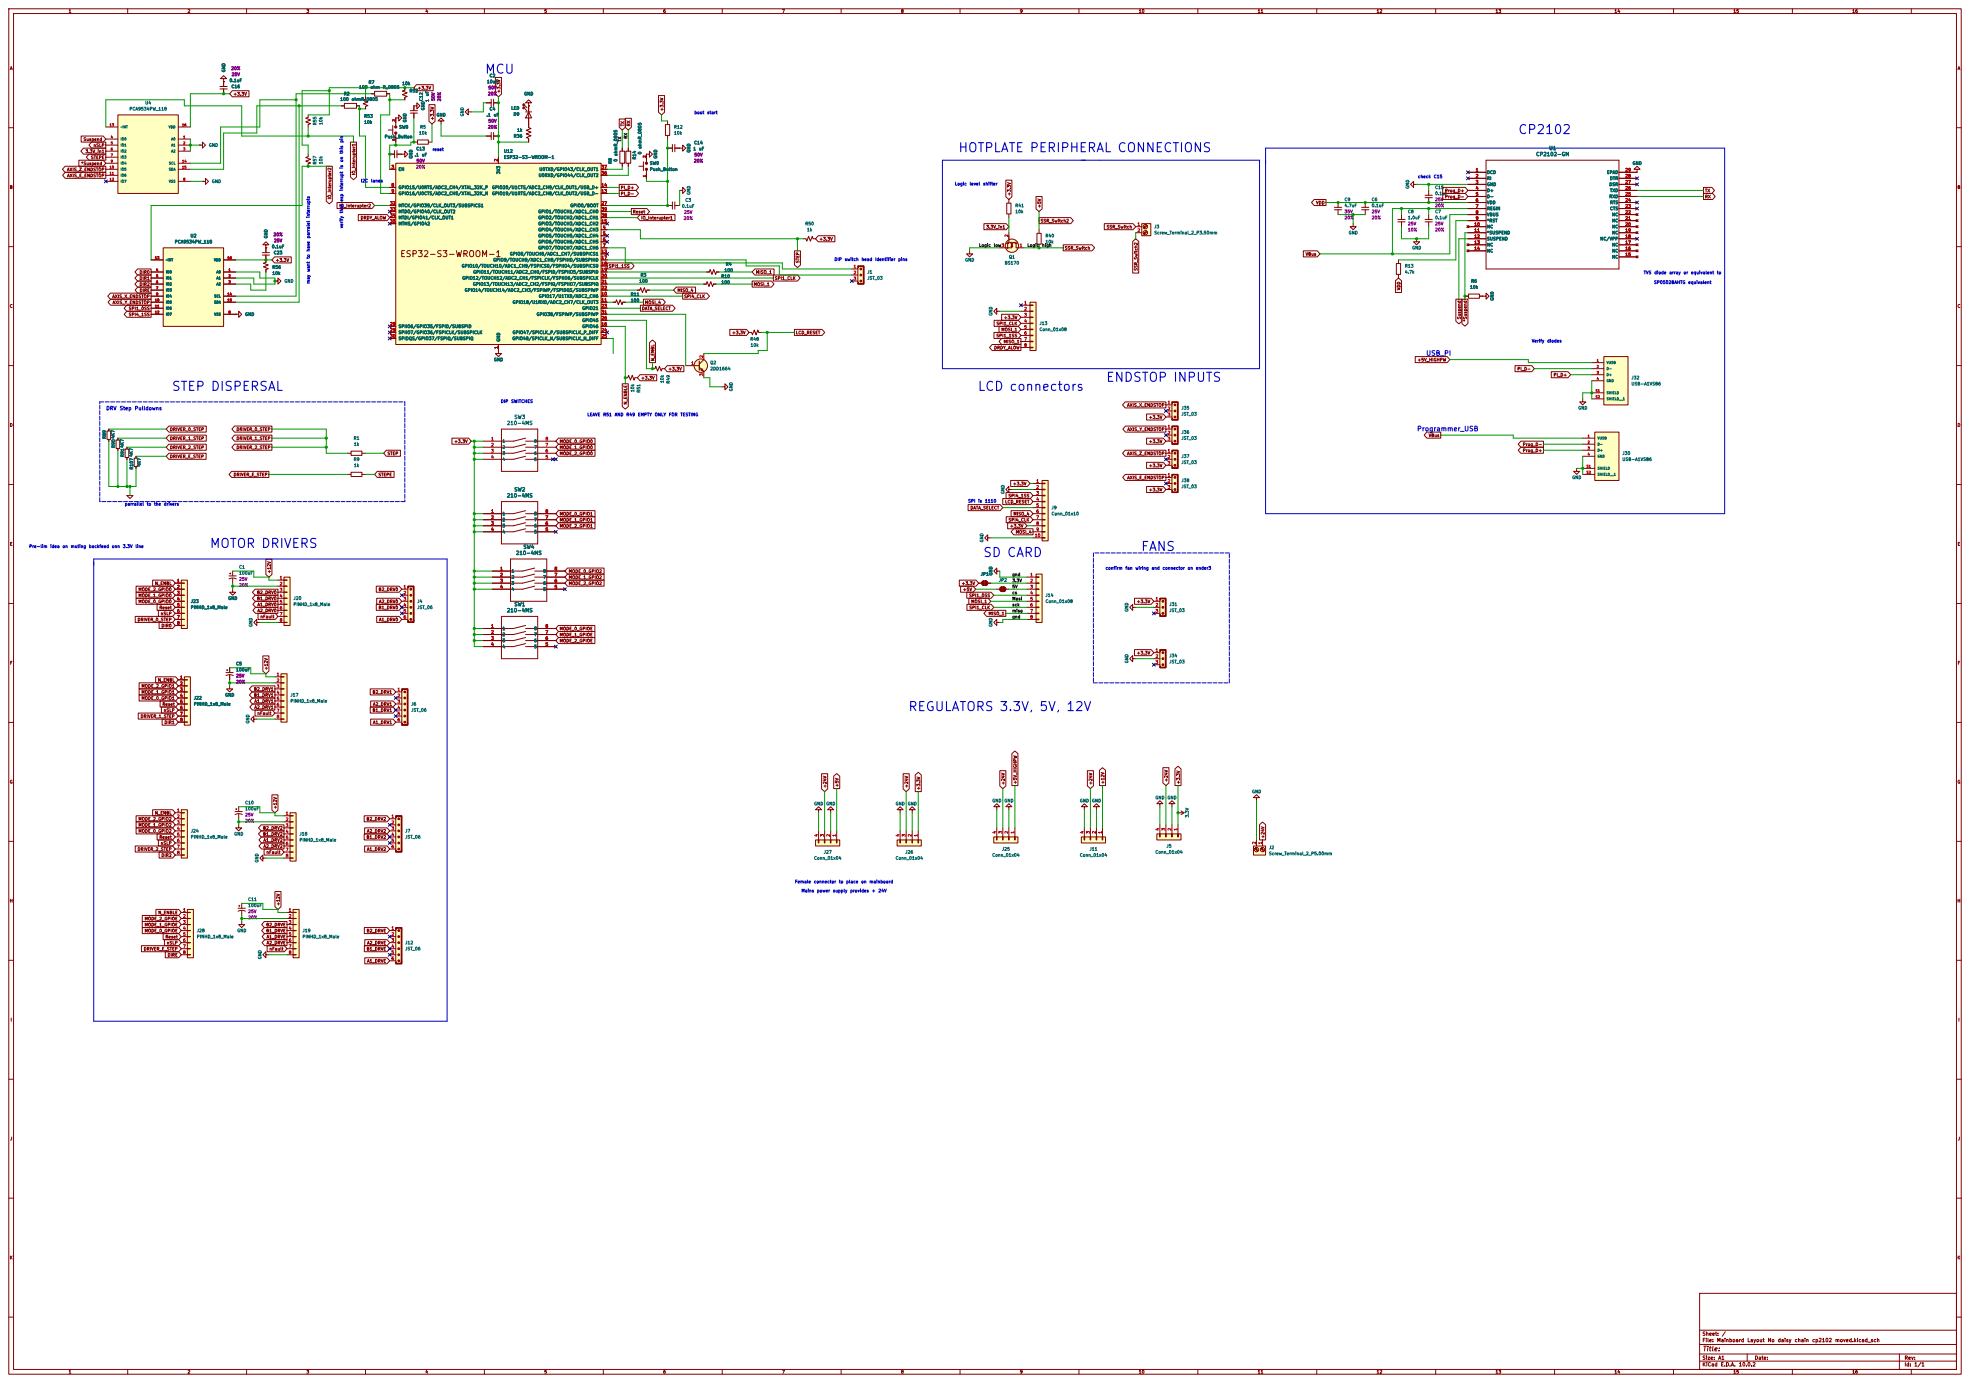
[picture p48: page 1]

boot start may want to have parralel interrupts

Logic level shifter HOTPLATE PERIPHERAL CONNECTIONS

USB_PI DIP switch head Identifier pins

TVS diode array or equivalent to SP0502BAHTG equivalent

LEAVE R51 AND R49 EMPTY ONLY FOR TESTING

Pre-lim idea on muting backfeed onn 3.3V line

confirm fan wiring and connector on ender3

Mains power supply provides + 24V

Sheet: /
File: Mainboard Layout No daisy chain cp2102 moved.kicad_sch
Title:

Size: A1 | Rev:
KiCad E.D.A. 10.0.2 | Id: 1/1
