ReadHeadRedemption/SeniorDesignSp26Su26/Hardware/Review PDF's/Initial PCB review/Max temperature V1 board layout.pdf

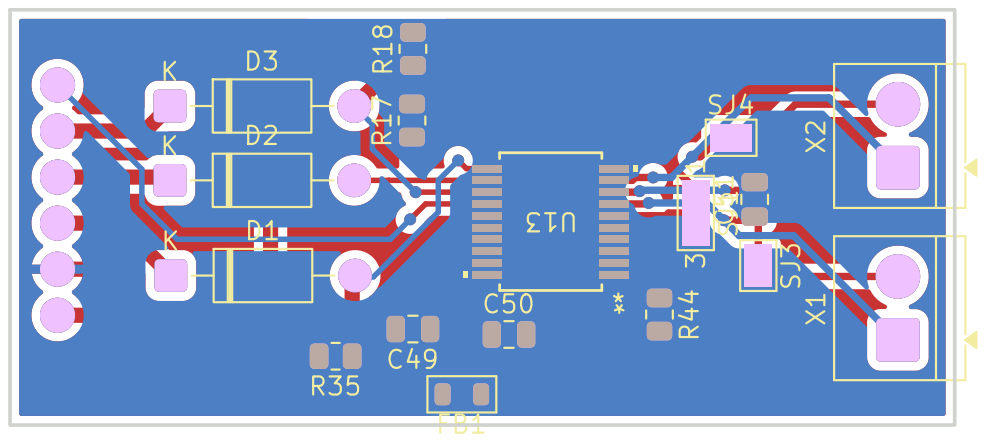
[picture p49: page 1]

Size: A4 | Rev:
KiCad E.D.A. 10.0.2 | Id: 1/2

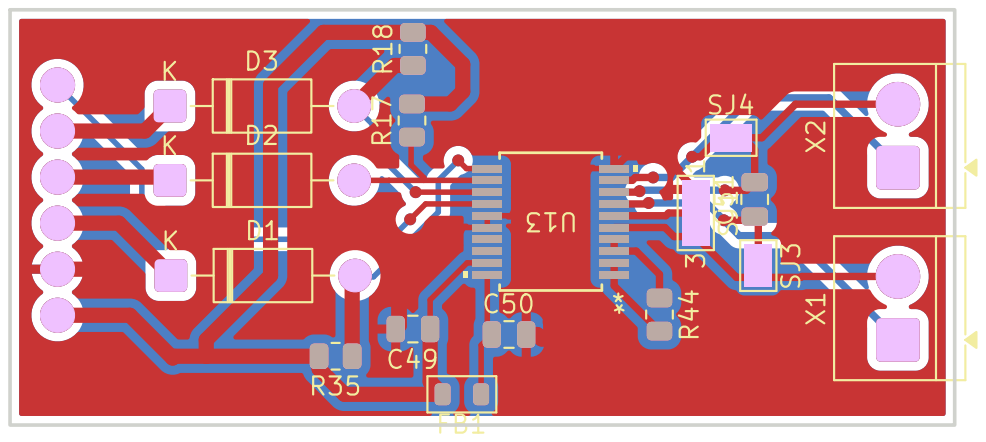
[picture p50: page 2]

Size: A4 | Rev:
KiCad E.D.A. 10.0.2 | Id: 2/2
