ReadHeadRedemption/SeniorDesignSp26Su26/Hardware/Review PDF's/Initial PCB review/Max temperature V1 Schem.pdf

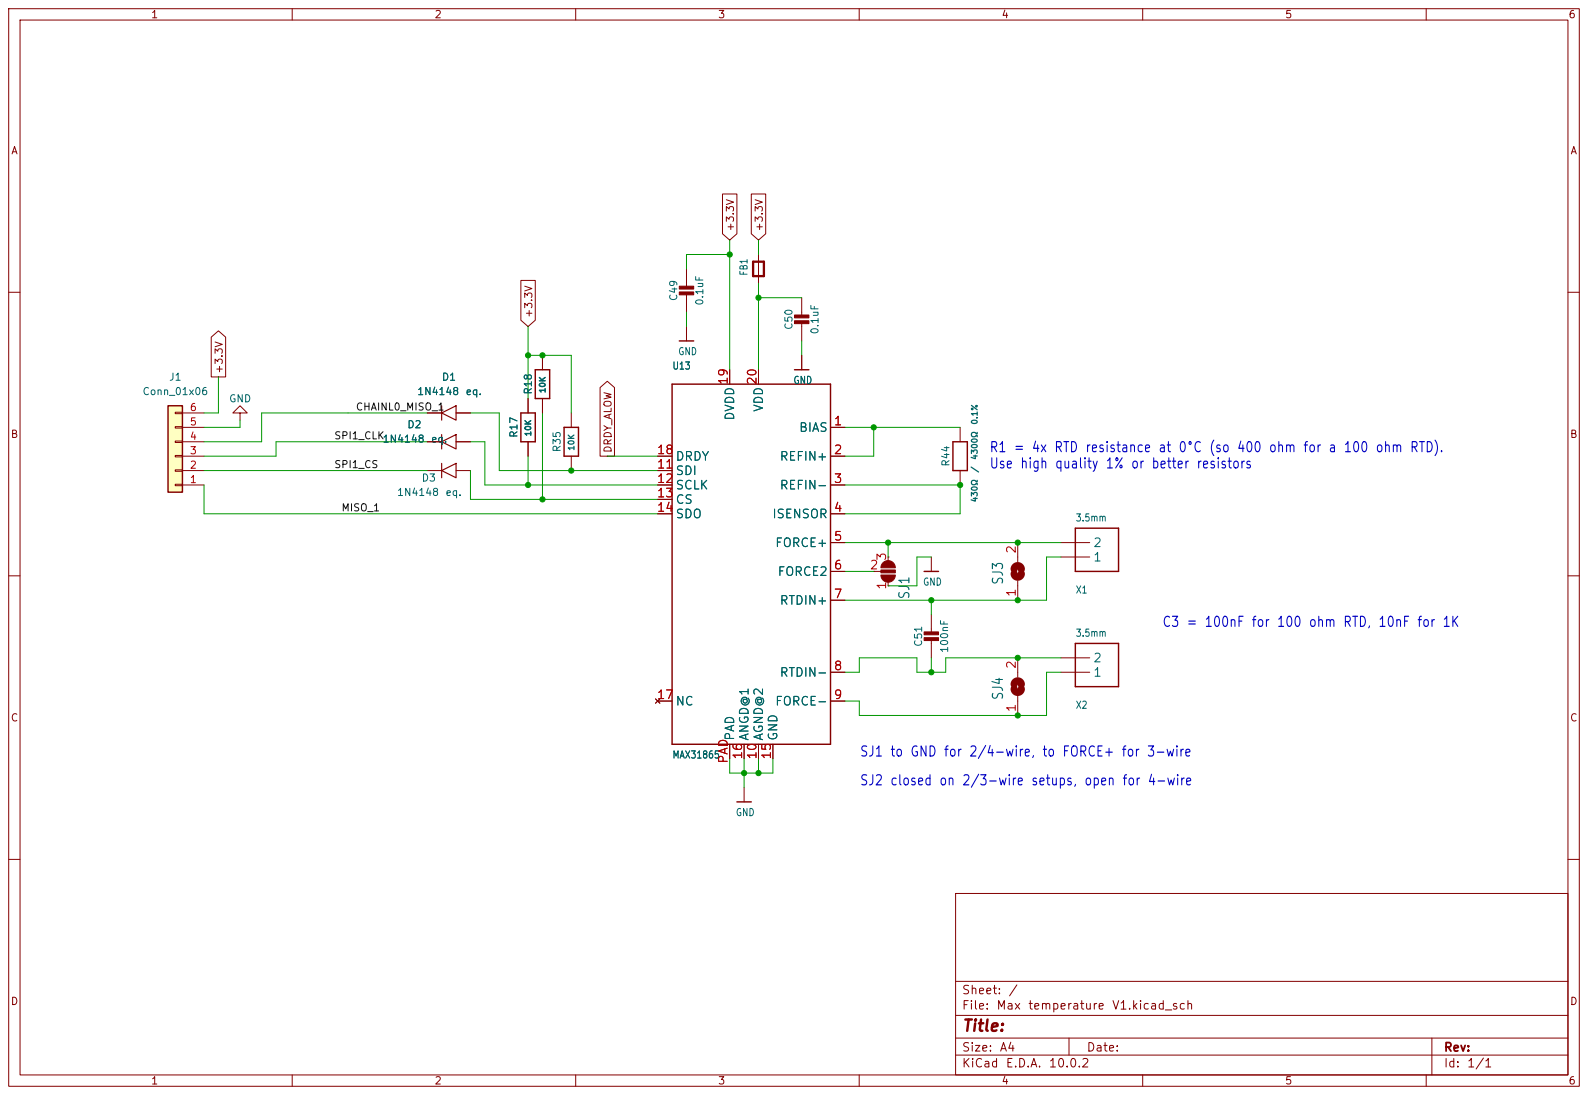
[picture p51: page 1]

R1 = 4x RTD resistance at 0°C (so 400 ohm for a 100 ohm RTD).
Use high quality 1% or better resistors

SJ2 closed on 2/3-wire setups, open for 4-wire

Size: A4 | Rev:
KiCad E.D.A. 10.0.2 | Id: 1/1
