ReadHeadRedemption/SeniorDesignSp26Su26/Hardware/Review PDF's/Initial PCB review/Swapping hotend board layout.pdf

match hole measurements to NEMA 17 motor U2


match hole measurements to NEMA 17 motor U2
