ReadHeadRedemption/SeniorDesignSp26Su26/Hardware/KiCAD files/reference schematics/Senior design/Duet3-Mainboard-6HC-master/Duet3_Mainboard_6HC_v1.02/Duet3_MB_6HC_Schematic_v1.02.pdf

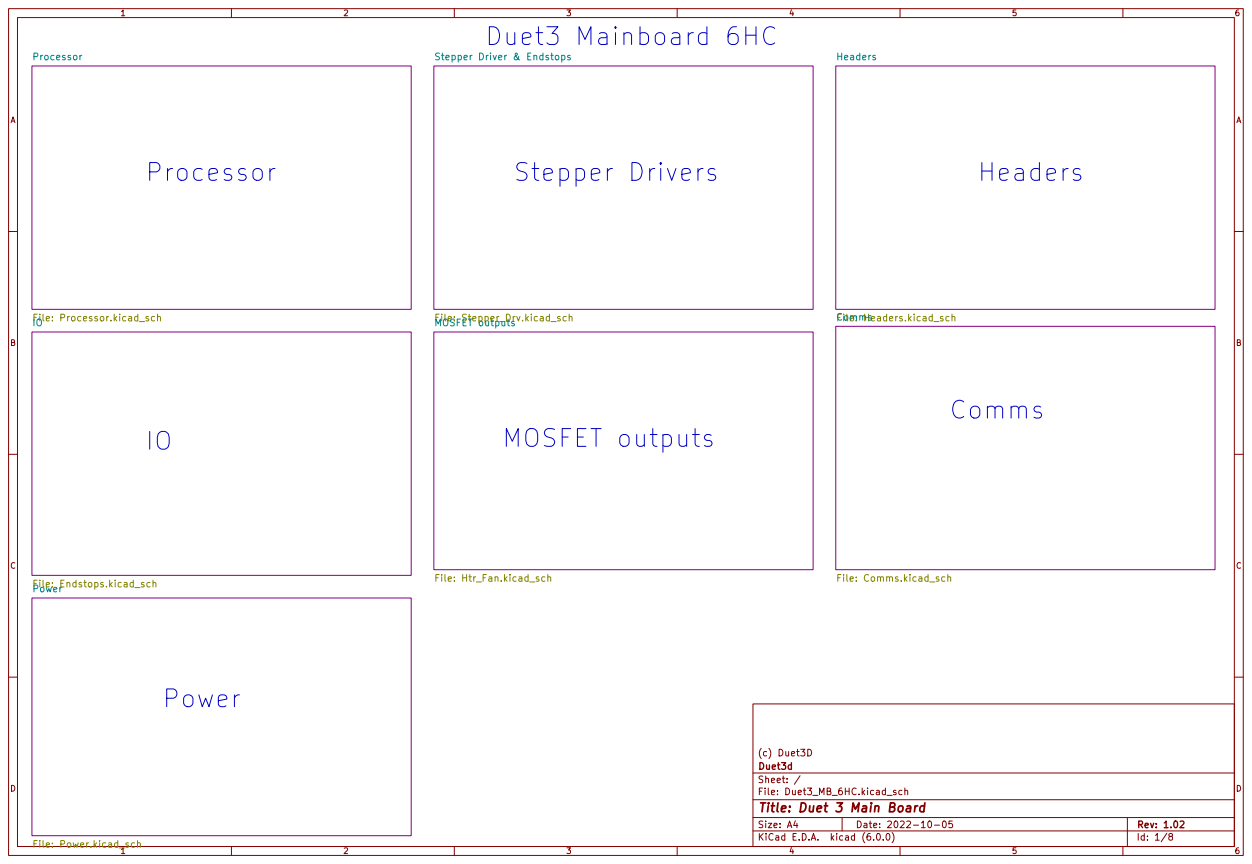
[picture p52: page 1]

Processor File: Processor.kicad_sch Power File: Power.kicad_sch

Headers Comms File: Headers.kicad_sch

Id: 1/8 Title: Duet 3 Main Board

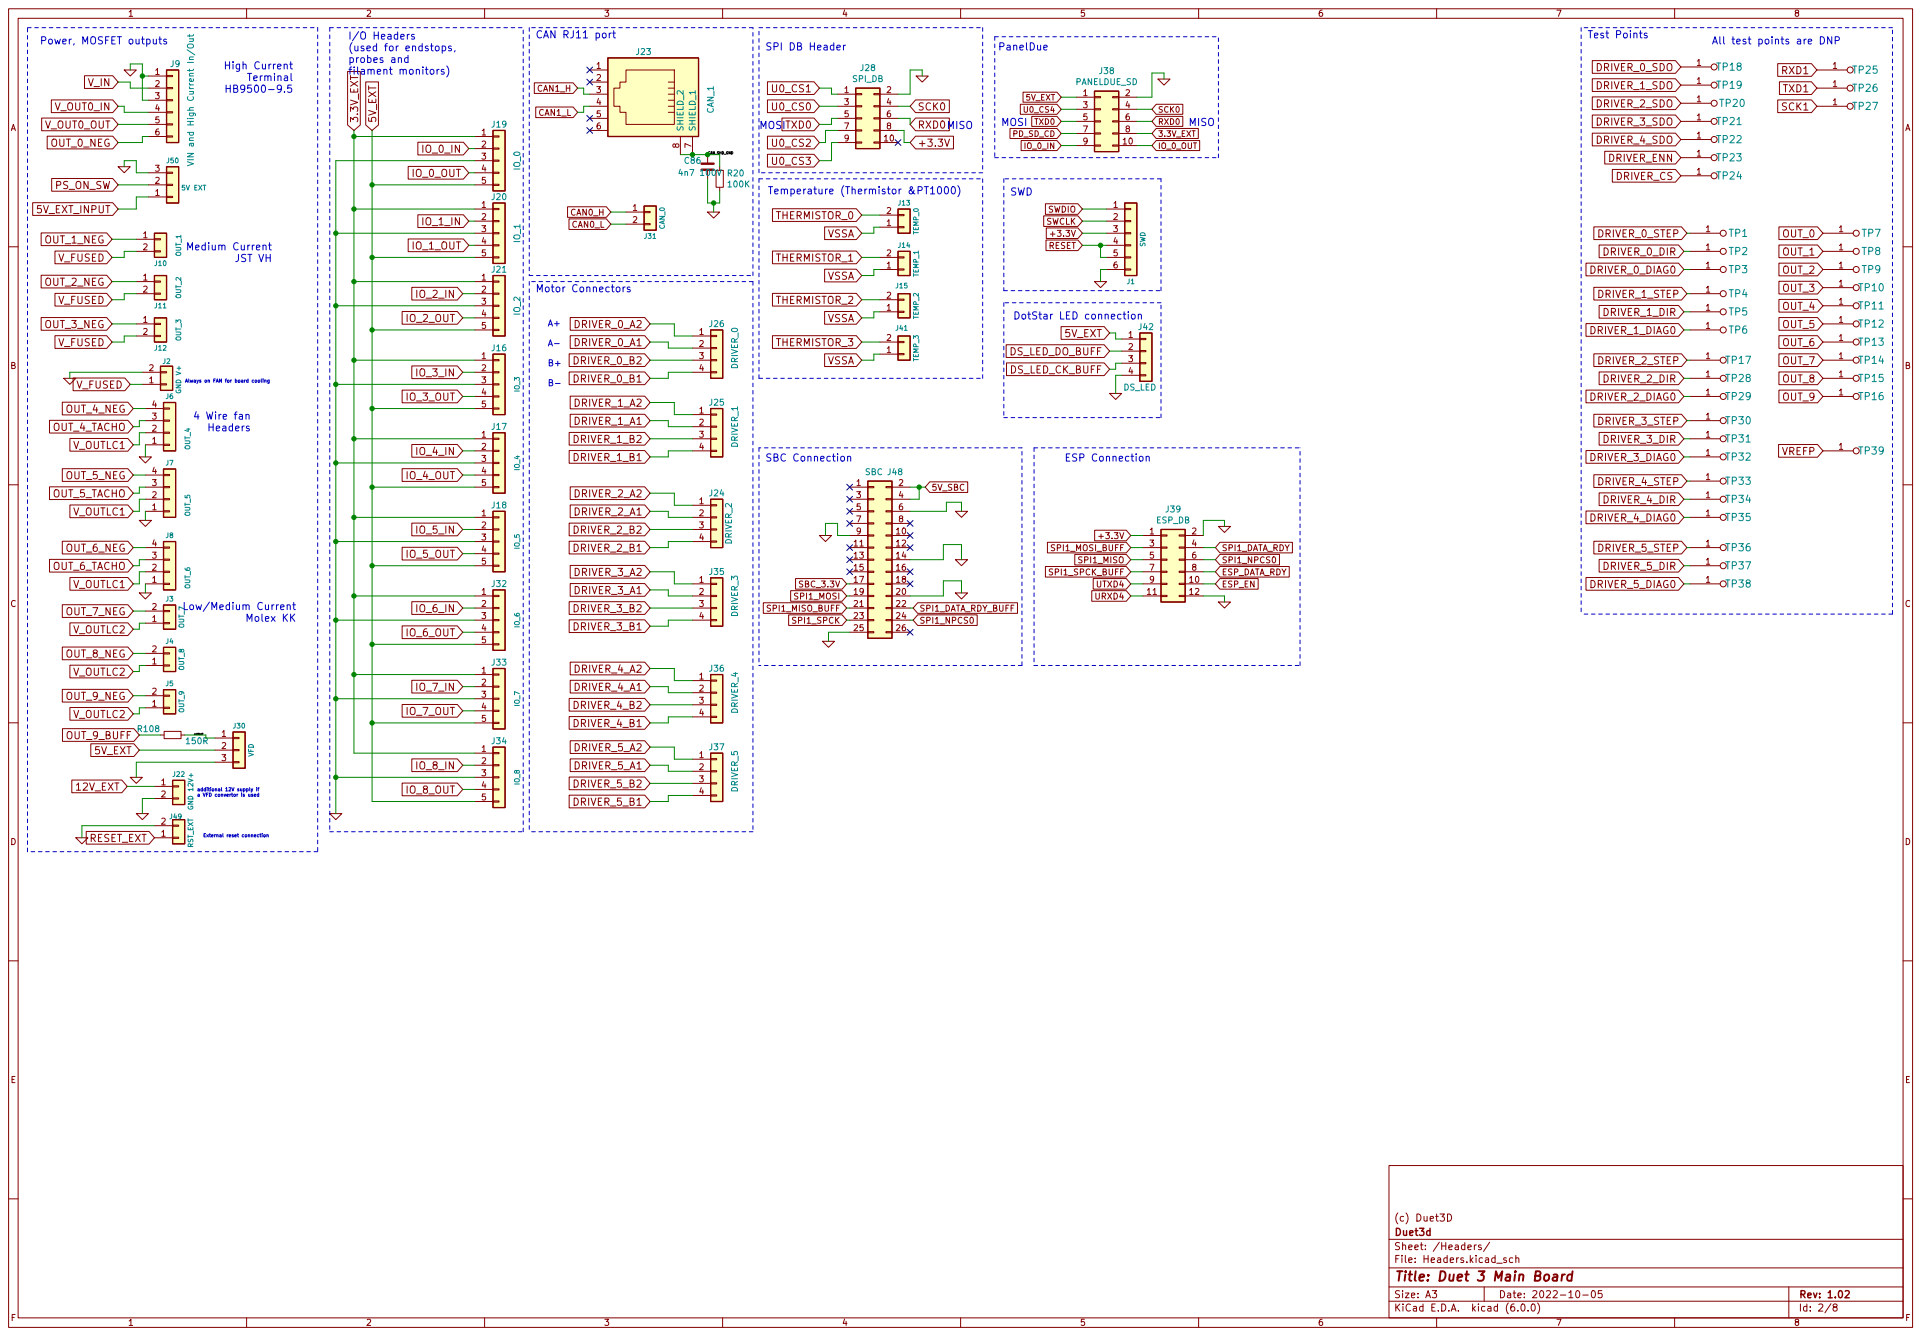
[picture p53: page 2]

J9 VIN and High Current In/Out 1
Always on FAN for board cooling High Current Terminal HB9500-9.5 Medium Current
5V EXT 1

SWD

additional 12V supply if a VFD convertor is used

(c) Duet3D
File: Headers.kicad_sch Sheet: /Headers/ Duet3d

Id: 2/8 Title: Duet 3 Main Board

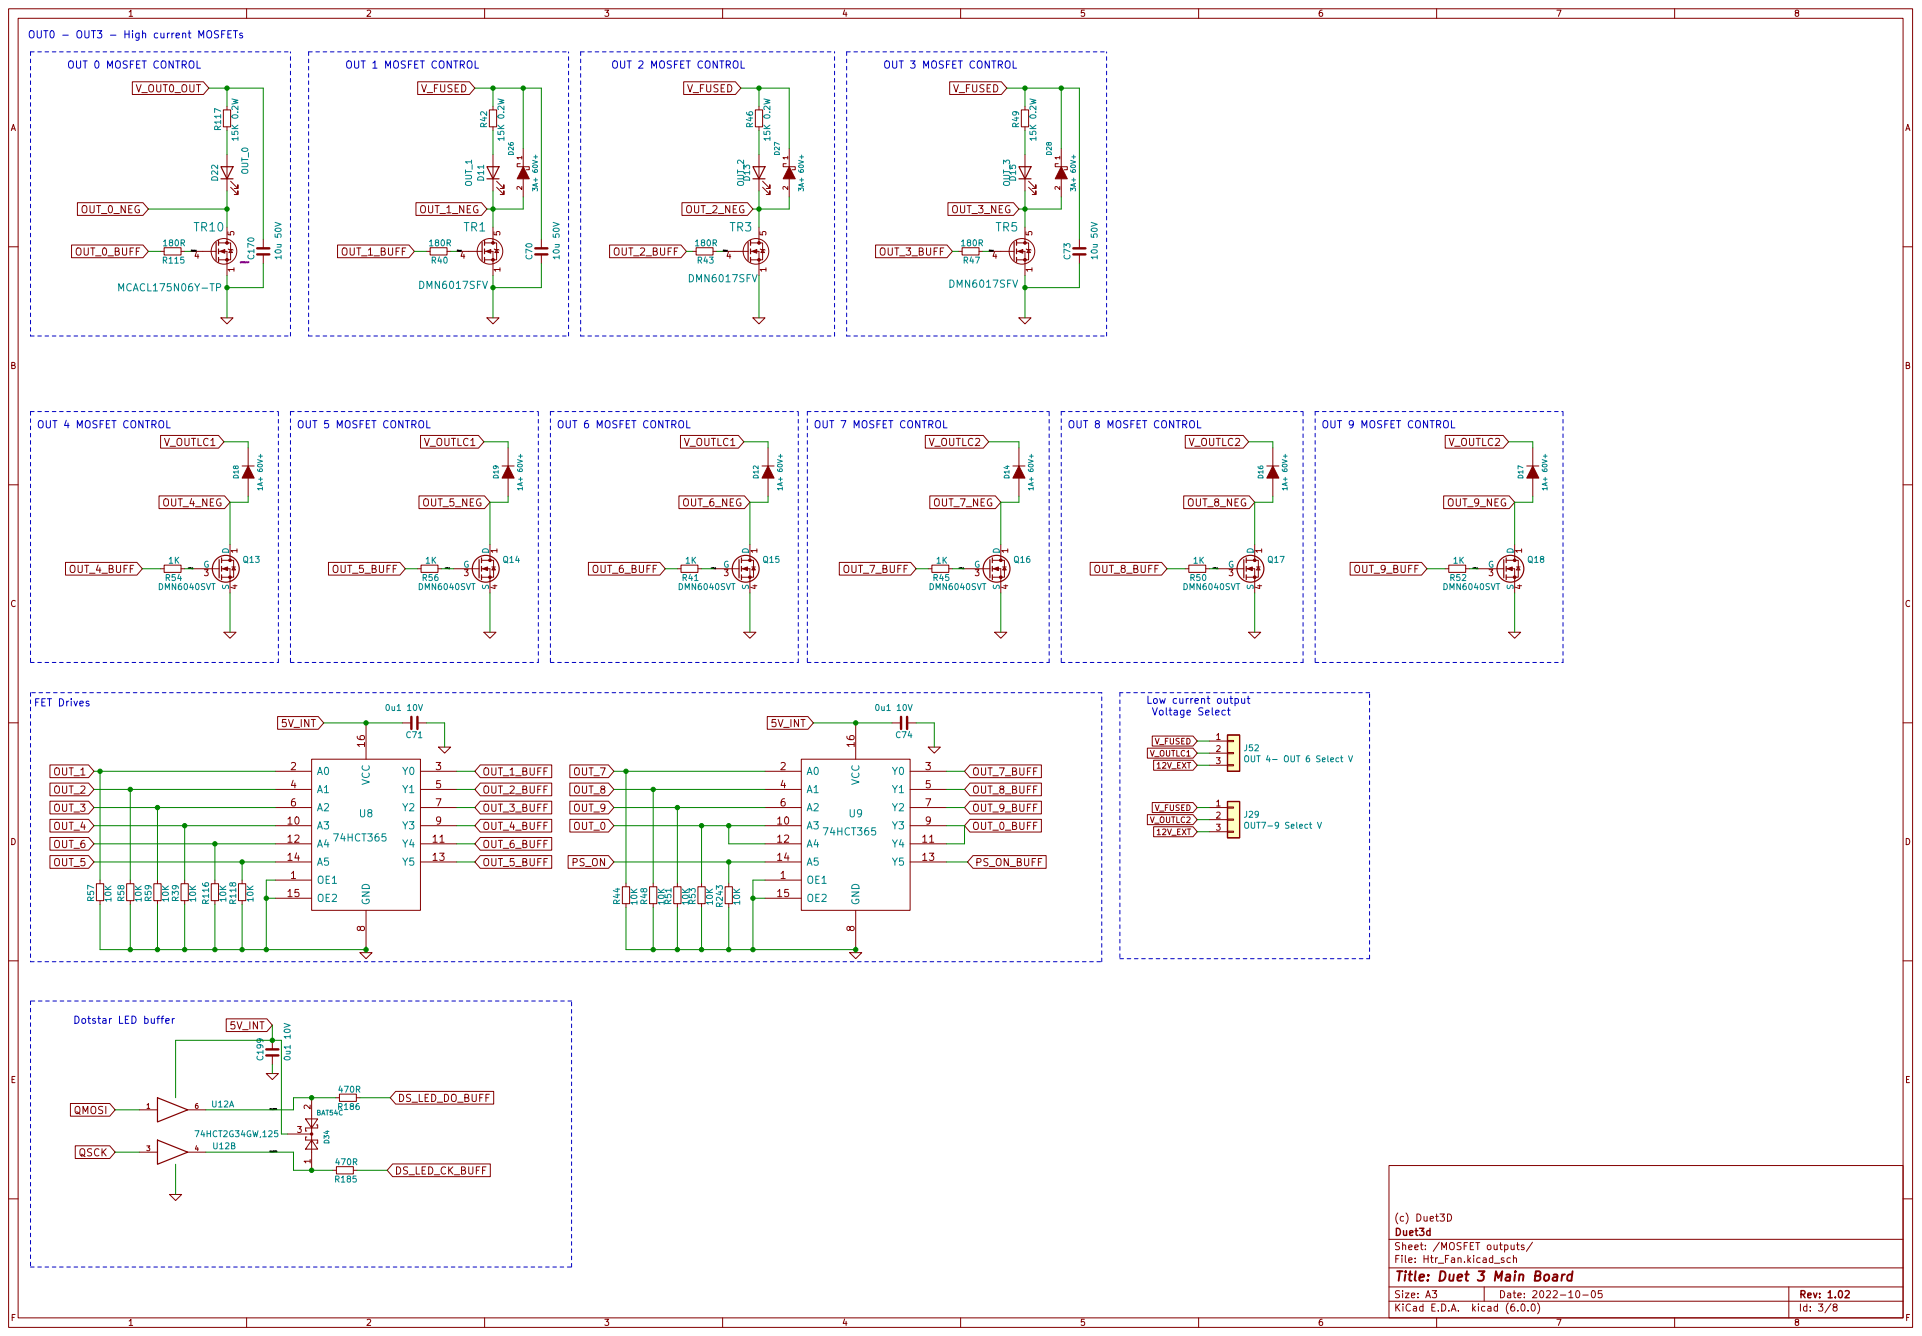
[picture p54: page 3]

OUT_1_NEG
FET Drives OUT 4 MOSFET CONTROL

File: Htr_Fan.kicad_sch
Id: 3/8 Title: Duet 3 Main Board

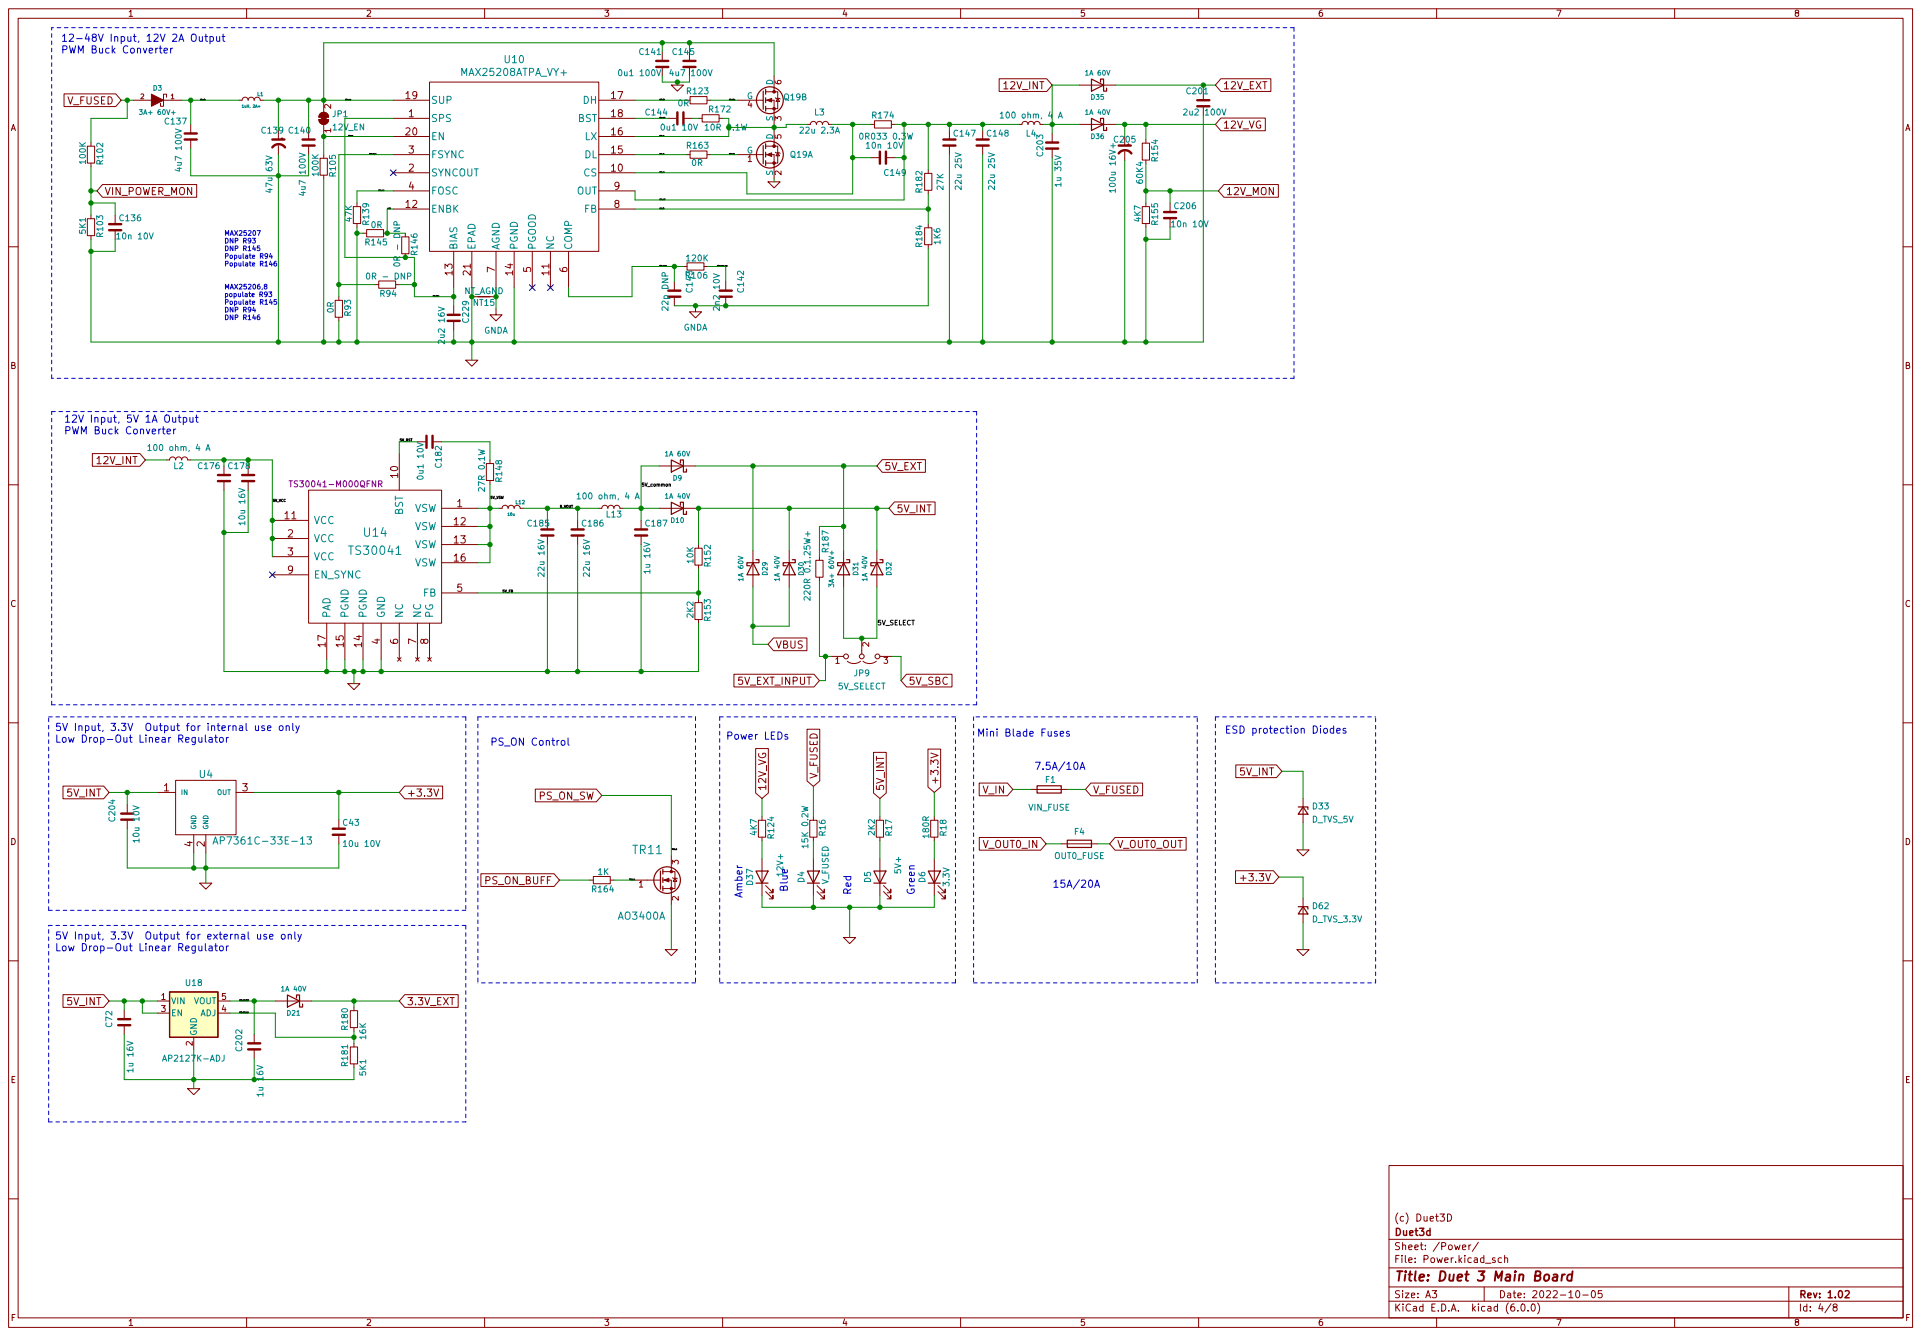
[picture p55: page 4]

2 EN 3 ADJ 4 VOUT 5 U18 AP2127K-ADJ C143 22p DNP R152 10K R153 2K2 C147 22u 25V

Low Drop-Out Linear Regulator

5V Input, 3.3V Output for external use only

(c) Duet3D
File: Power.kicad_sch Sheet: /Power/ Duet3d

Id: 4/8 Title: Duet 3 Main Board

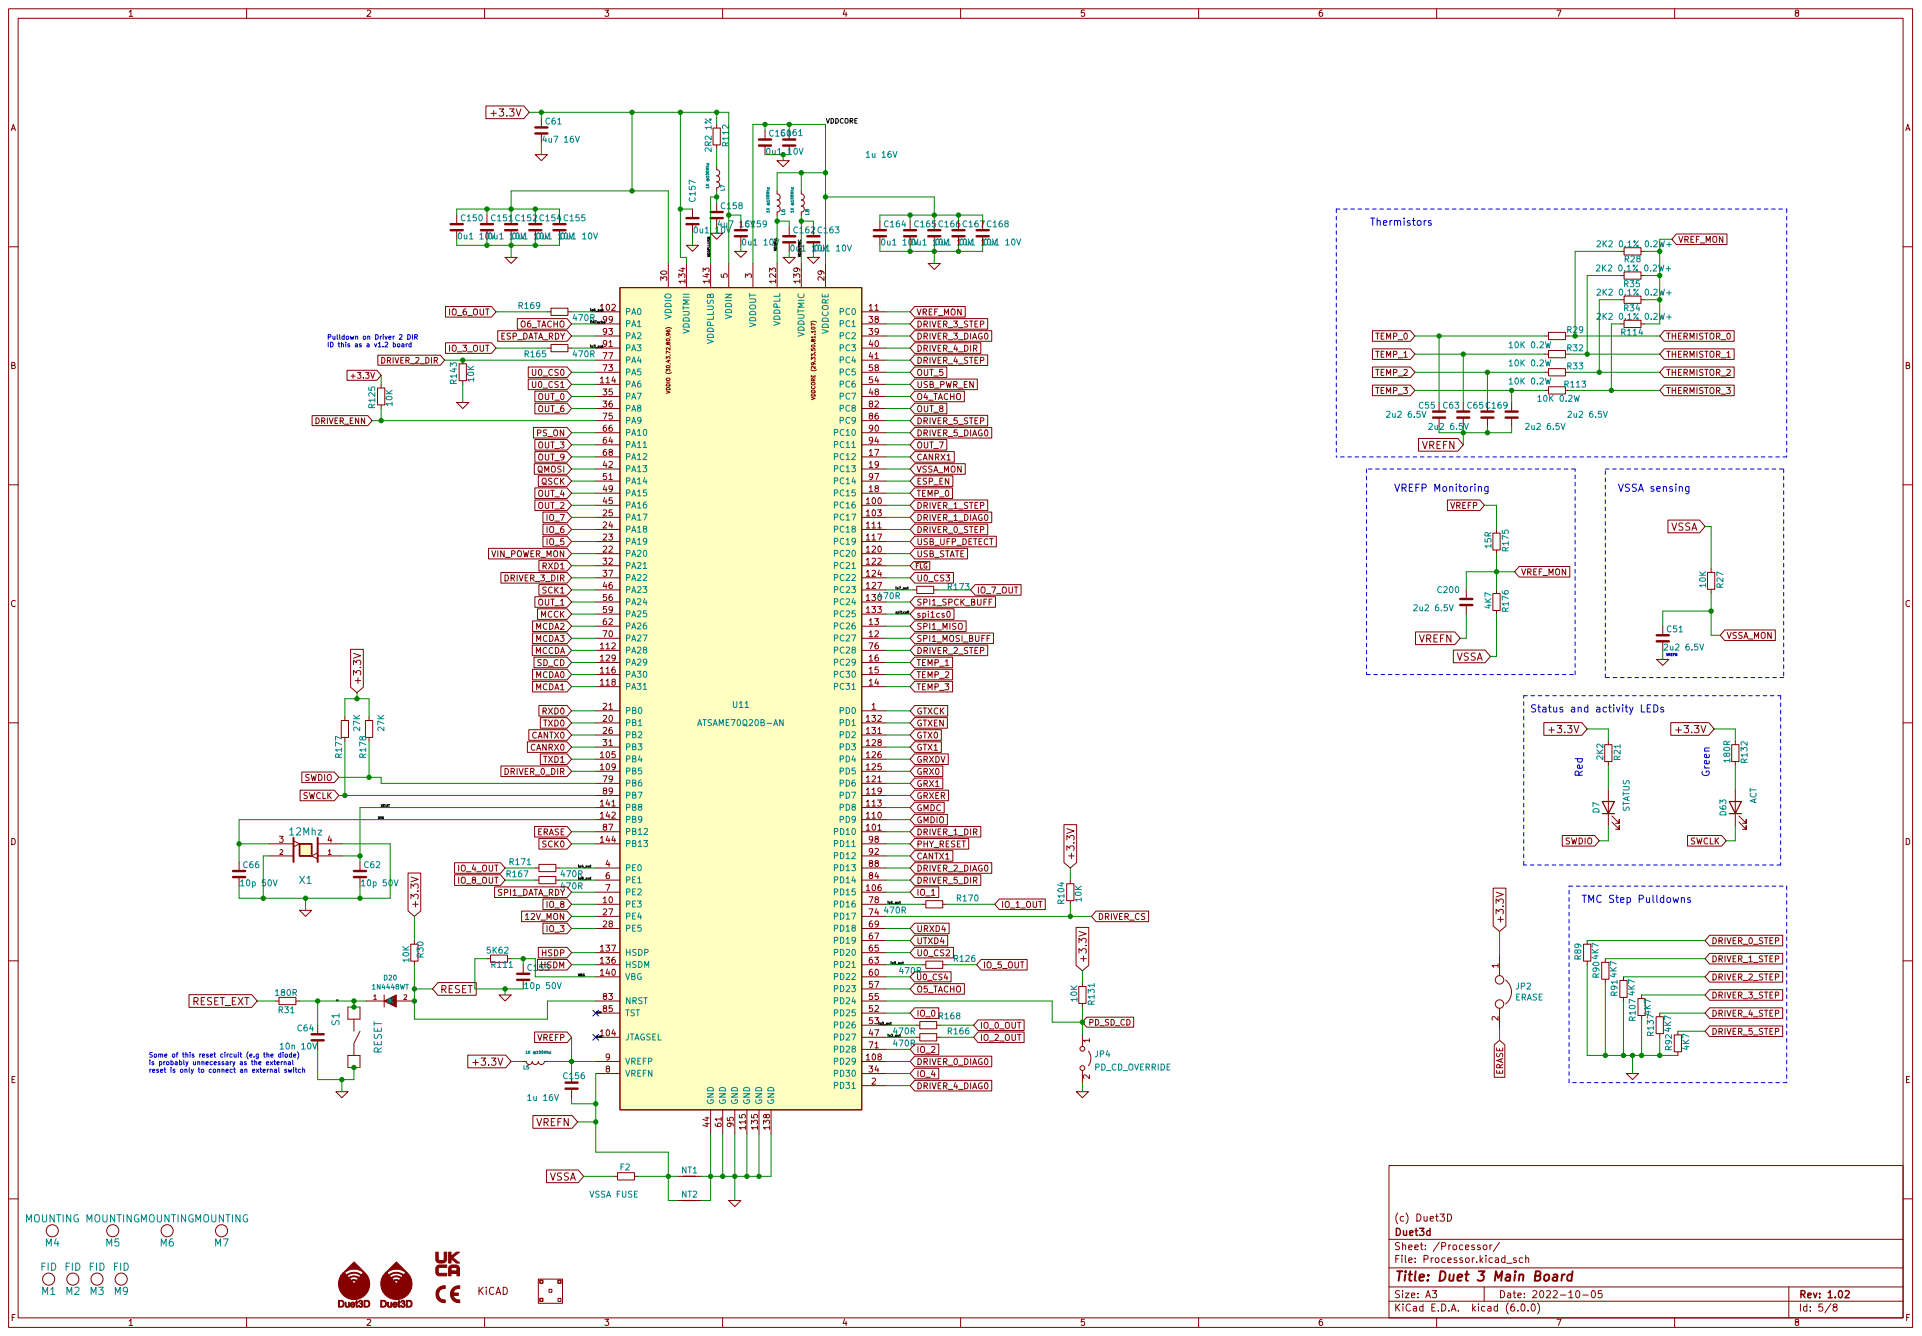
[picture p56: page 5]

Pulldown on Driver 2 DIR

10K 0.2W R32
10K 0.2W R33

Some of this reset circuit (e.g the diode)
is probably unnecessary as the external reset is only to connect an external switch

File: Processor.kicad_sch Sheet: /Processor/ Duet3d

Id: 5/8 Title: Duet 3 Main Board

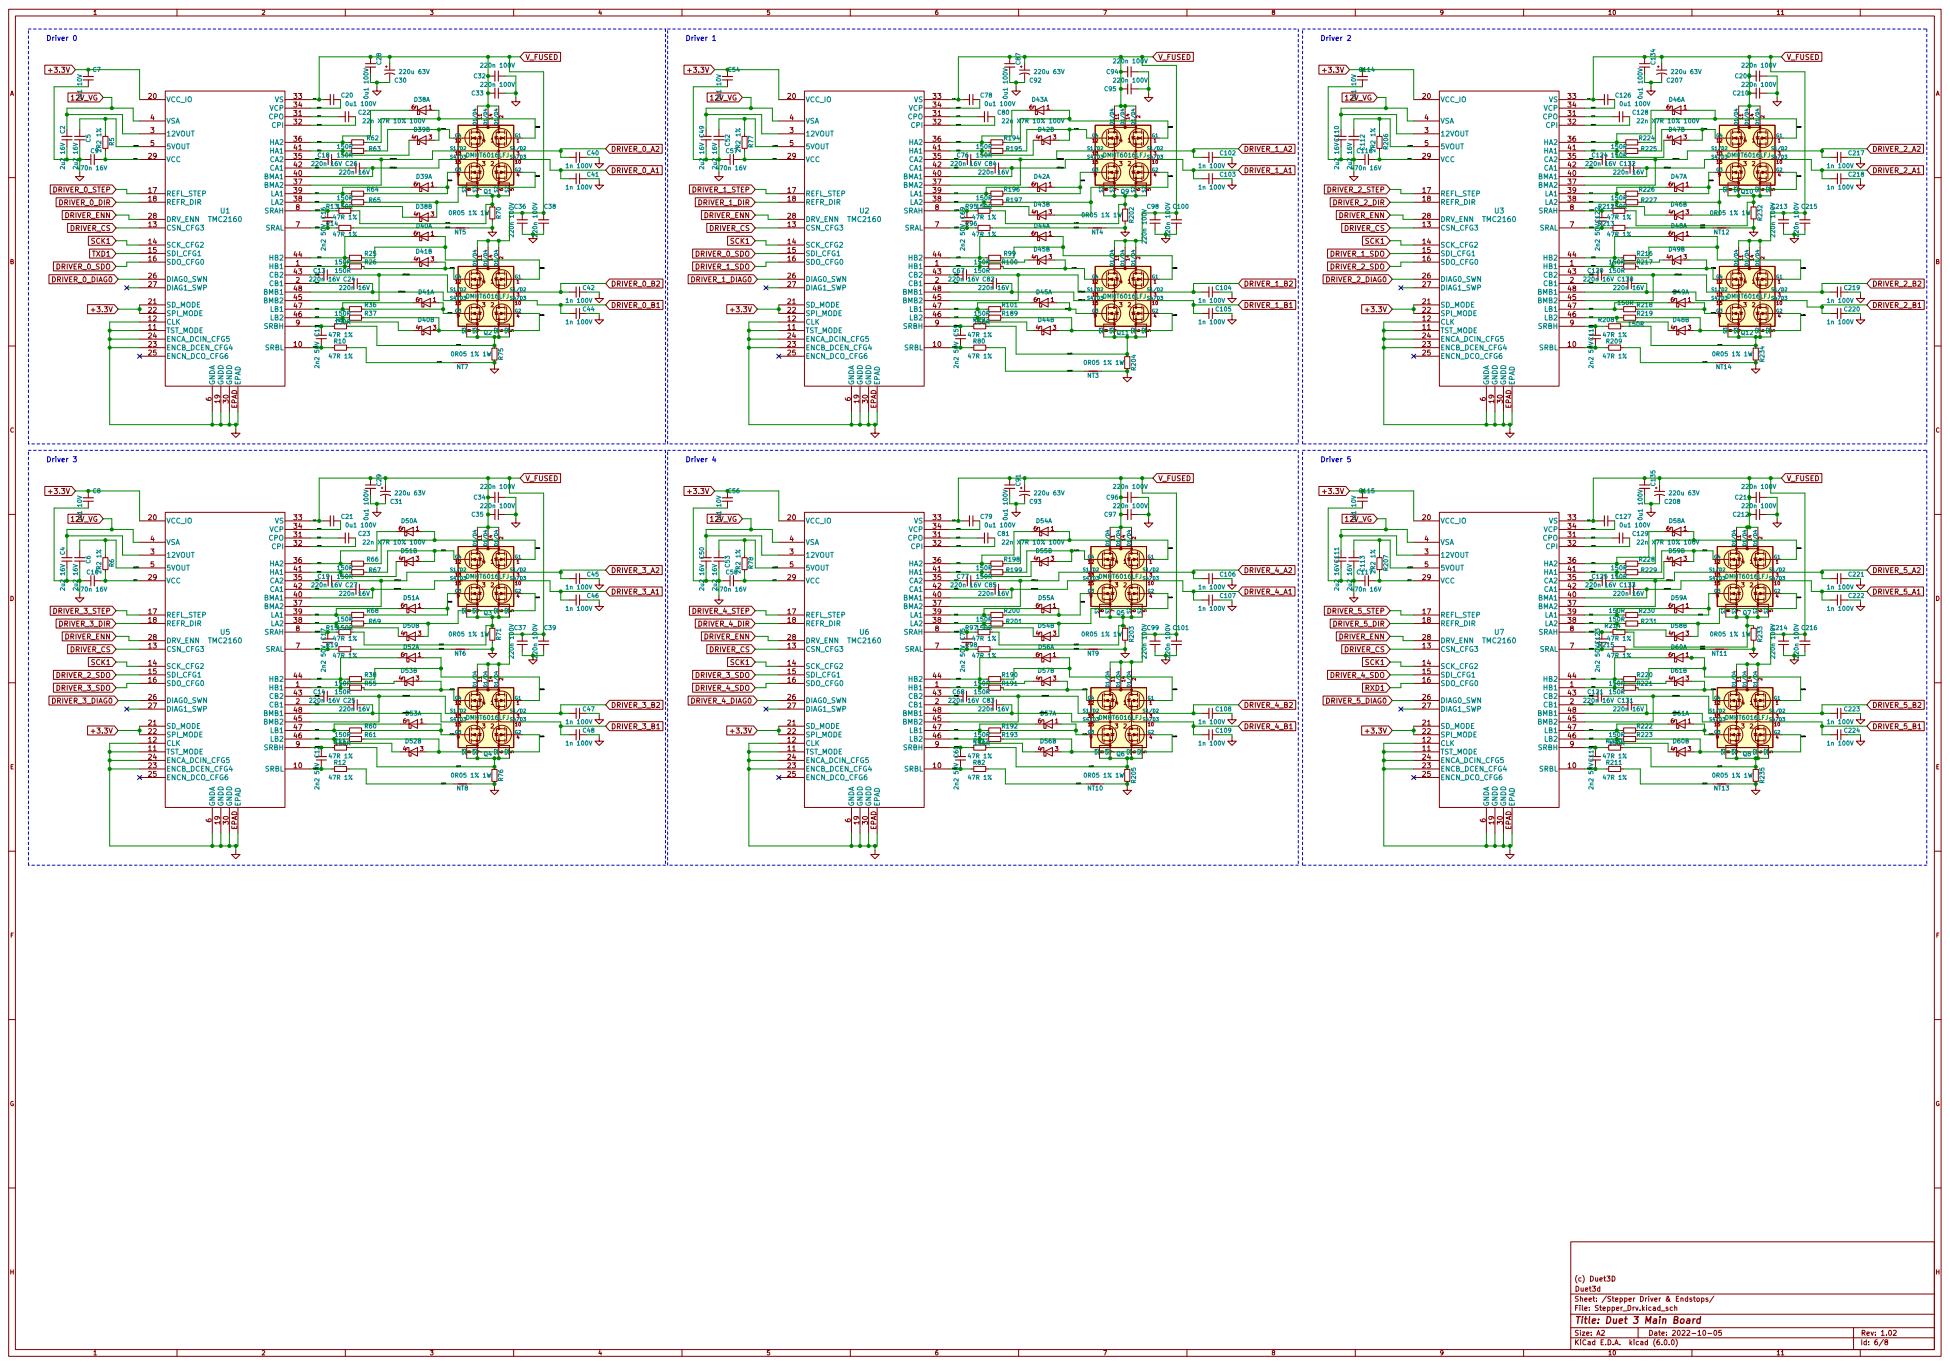
[picture p57: page 6]

6 SRAL 7 SRAH 8 SRBH 9 EPAD EPAD U1 TMC2160 R202 0R05 1% 1W

6 SRAL 7 SRAH 8 SRBH 9 EPAD EPAD U2 TMC2160 C59 2n2 50V

6 SRAL 7 SRAH 8 SRBH 9 EPAD EPAD U5 TMC2160 C10

6 SRAL 7 SRAH 8 SRBH 9 EPAD EPAD U6 TMC2160

(c) Duet3D
Sheet: /Stepper Driver & Endstops/ Duet3d

File: Stepper_Drv.kicad_sch
Id: 6/8 Title: Duet 3 Main Board

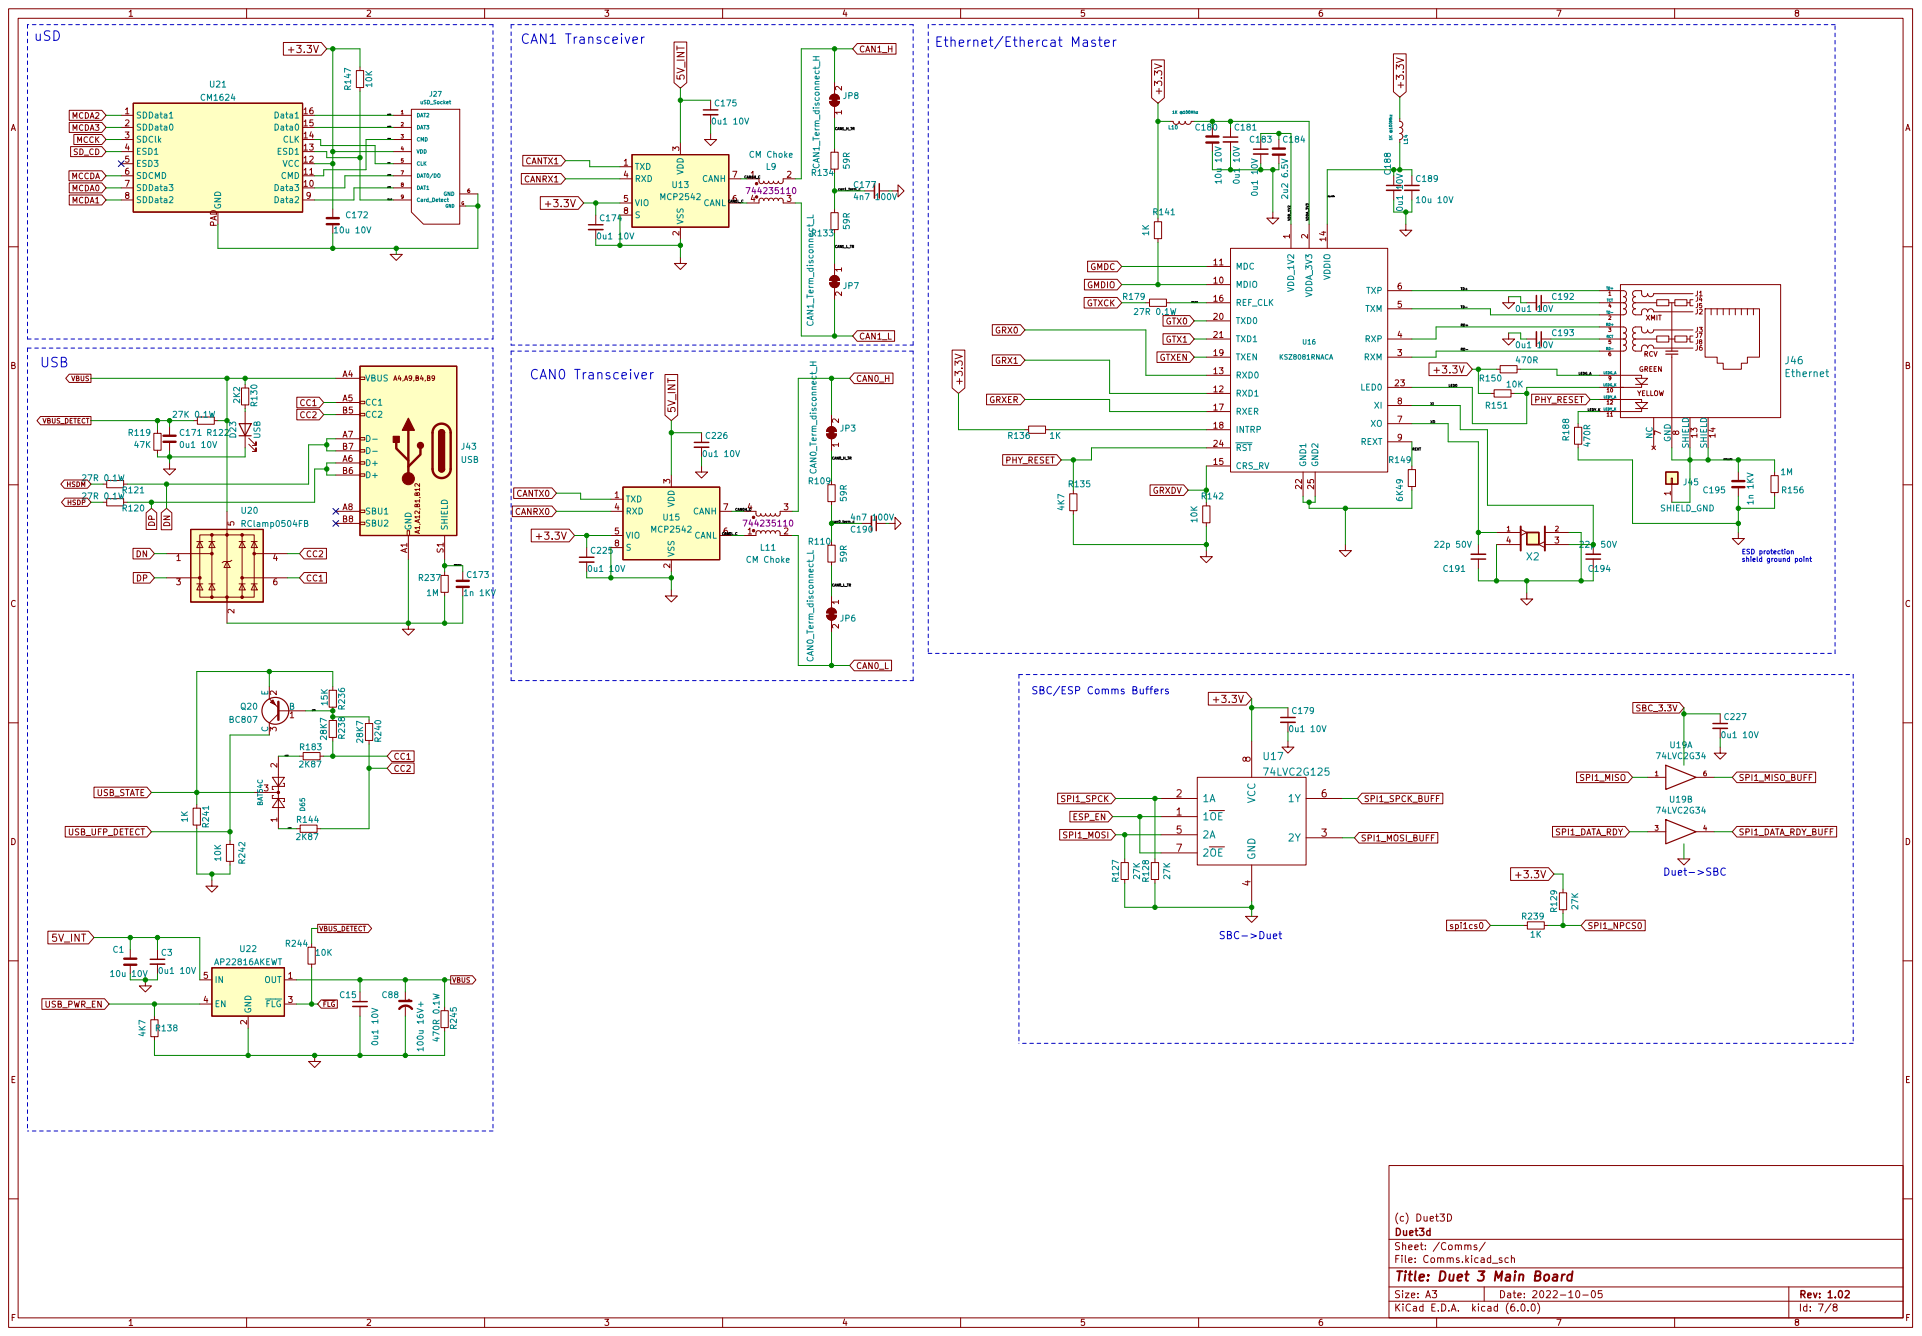
[picture p58: page 7]

3 RXD 4 VIO 5 CANL 6 CANH 7 S

1 MDIO 10 MDC 11 RXD1 12 RXD0 13 VDDIO 14 CRS_RV 15 REF_CLK 16 RXER 17

SBC/ESP Comms Buffers

(c) Duet3D
File: Comms.kicad_sch Sheet: /Comms/ Duet3d

Id: 7/8 Title: Duet 3 Main Board

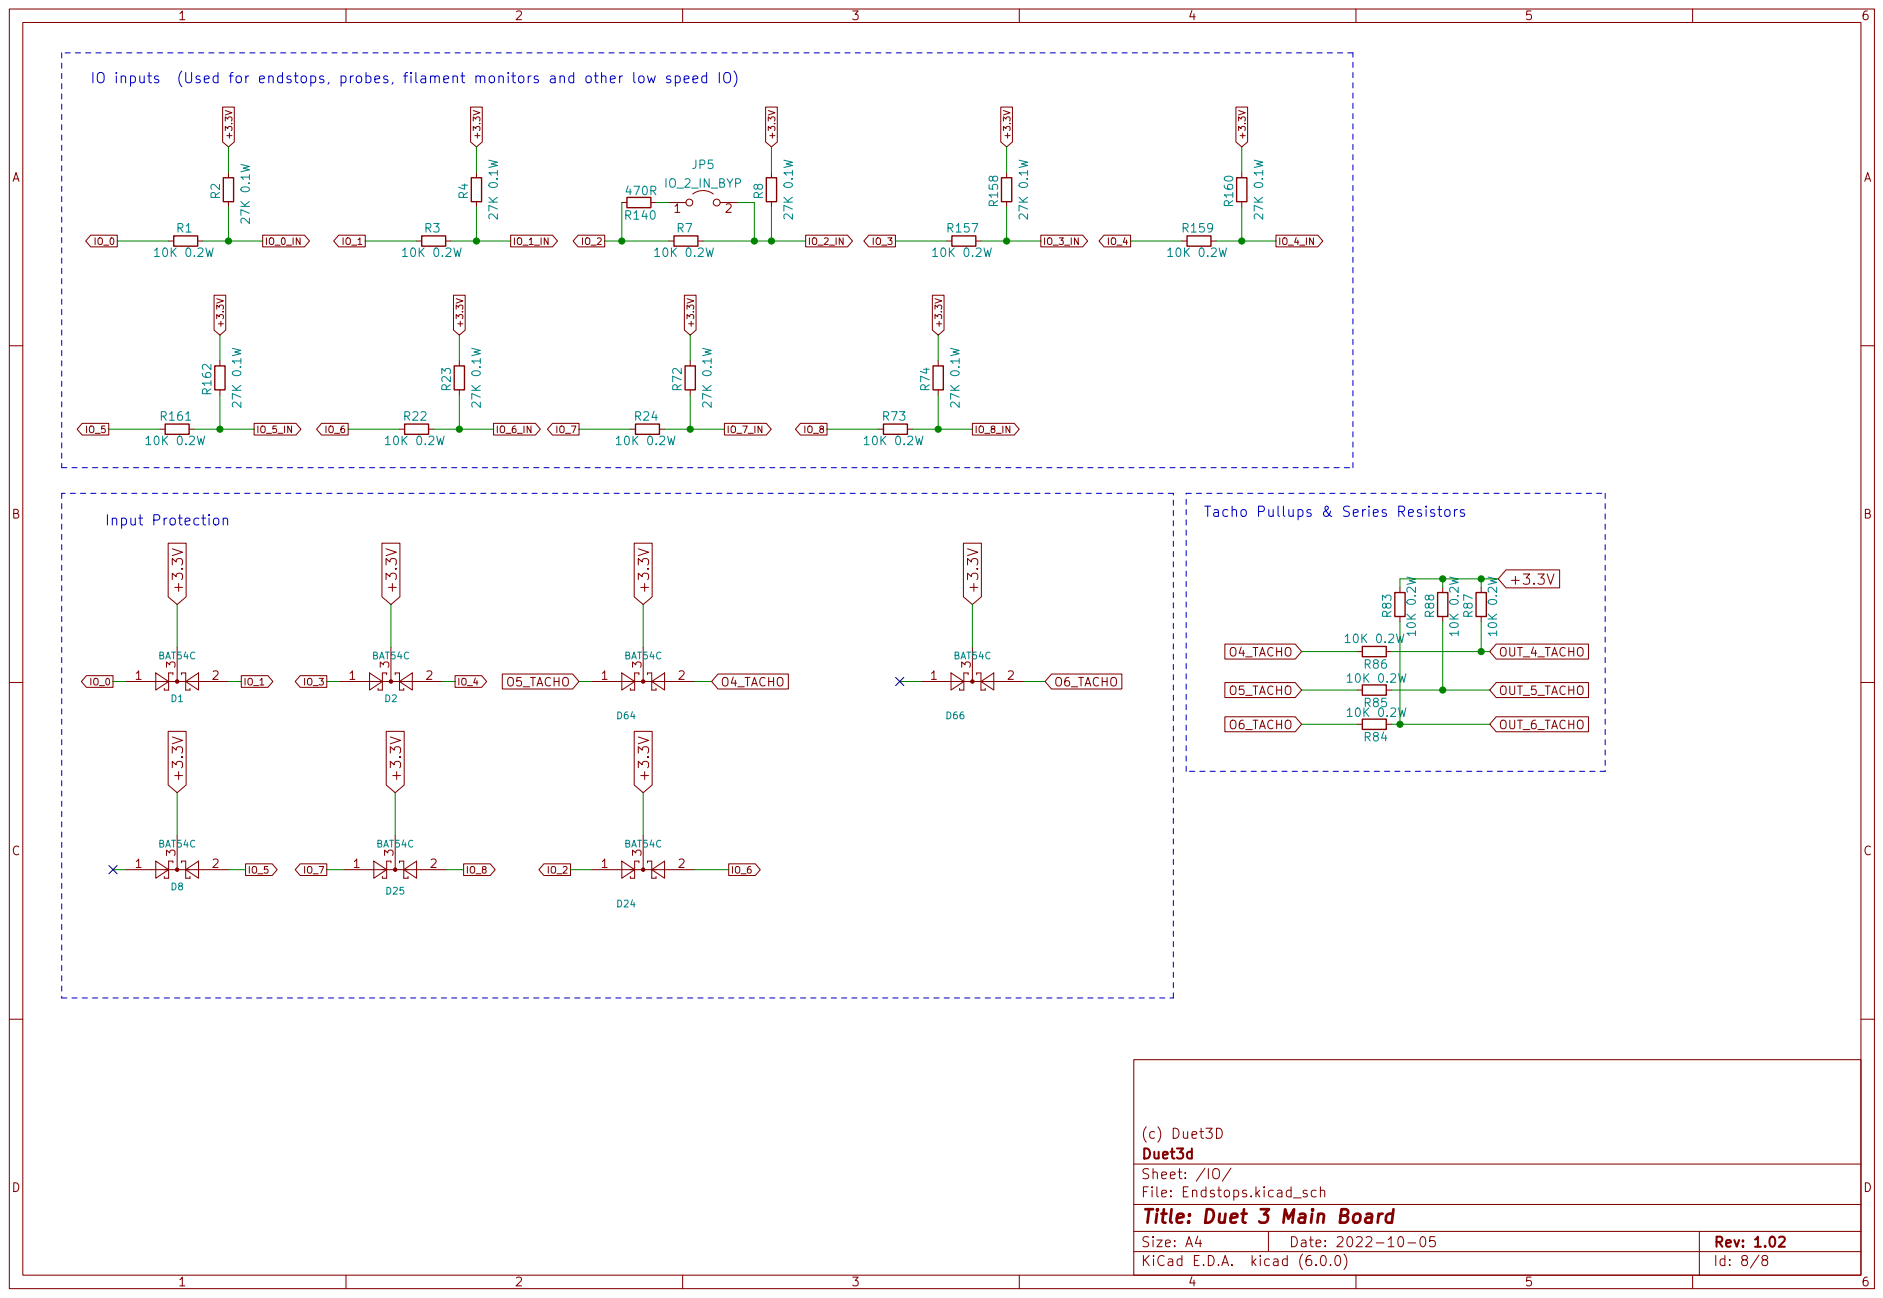
[picture p59: page 8]

IO inputs (Used for endstops, probes, filament monitors and other low speed IO)

(c) Duet3D
File: Endstops.kicad_sch Sheet: /IO/ Duet3d

Id: 8/8 Title: Duet 3 Main Board
