ReadHeadRedemption/SeniorDesignSp26Su26/Review PDF's/Initial PCB review/LM2576_Var_Volt_Reg.pdf

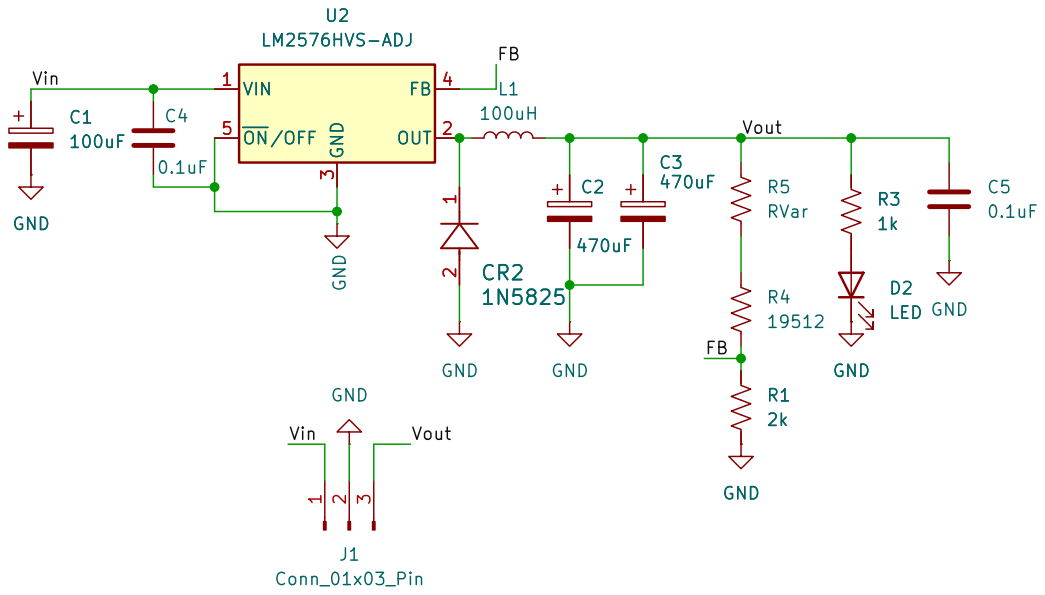
[picture p60: page 1]

Size: A4 | Rev:
KiCad E.D.A. 10.0.2 | Id: 1/1
