ReadHeadRedemption/SeniorDesignSp26Su26/Review PDF's/Initial PCB review/Swapping hotend board.pdf

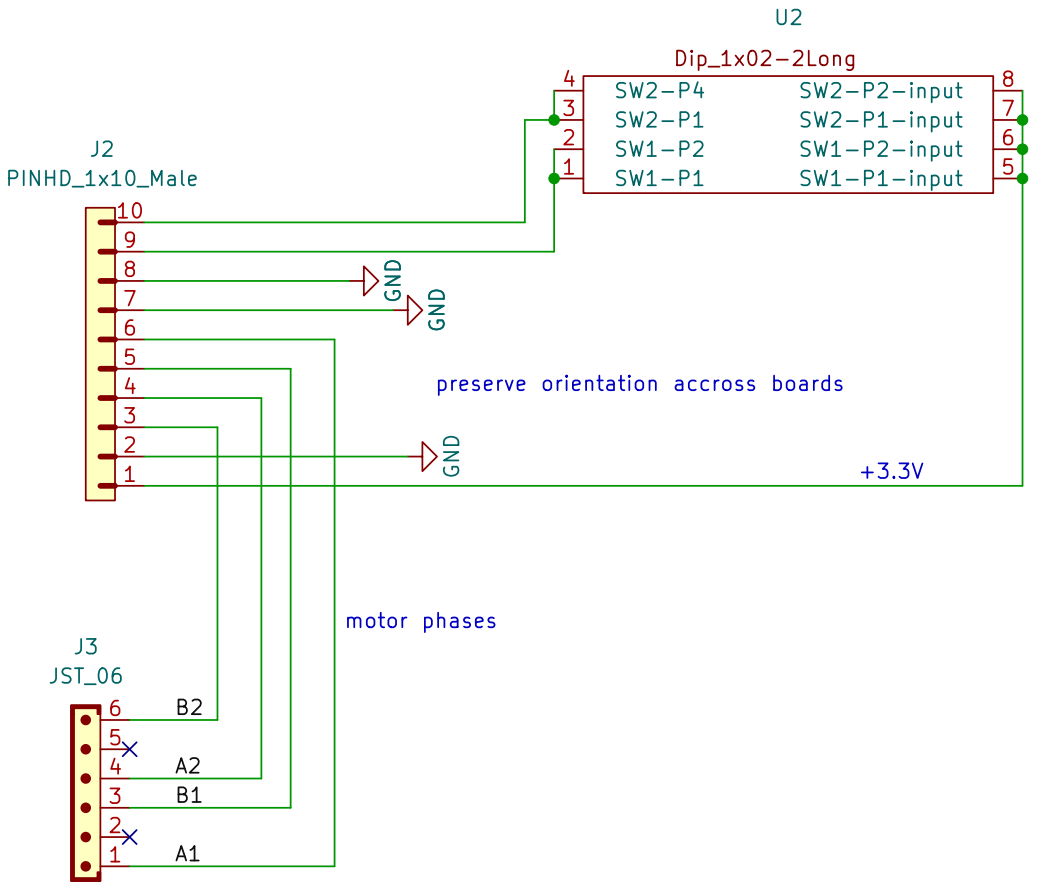
[picture p61: page 1]

preserve orientation accross boards +3.3V motor phases GNDGND

Sheet: /
File: Swapping hotend board.kicad_sch
Title:

Size: A4 | Rev:
KiCad E.D.A. 10.0.2 | Id: 1/1
