ReadHeadRedemption/SeniorDesignSp26Su26/Hardware/Review PDF's/Initial PCB review/LM2576_Var_Volt_Reg board layout.pdf

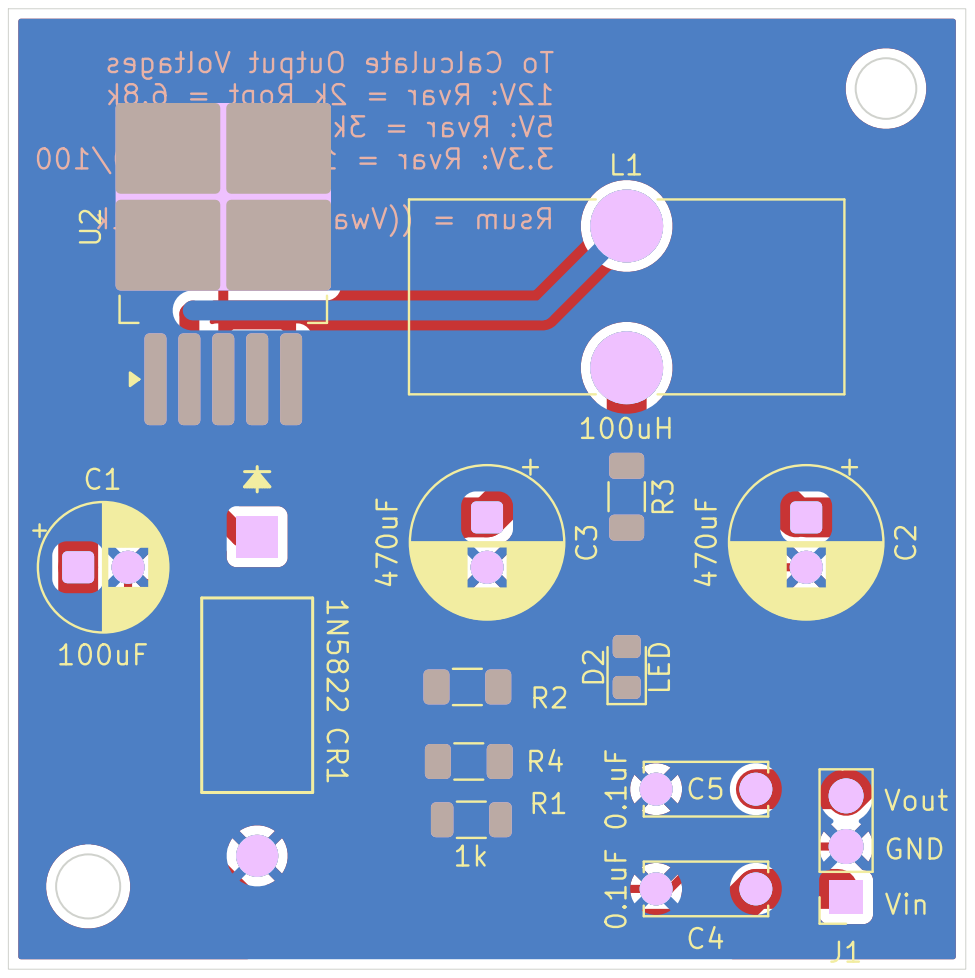
[picture p62: page 1]

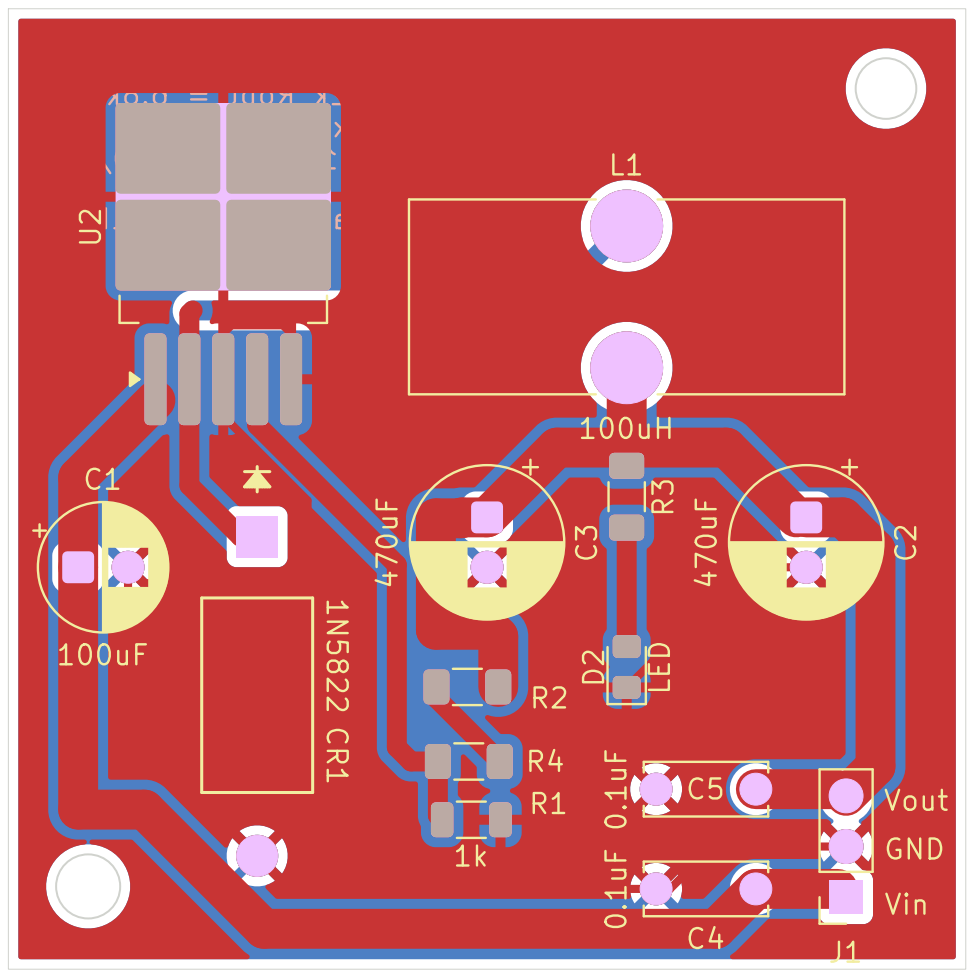
[picture p63: page 2]
