ReadHeadRedemption/SeniorDesignSp26Su26/Hardware/Review PDF's/Initial PCB review/LM2576_Var_Volt_reg Schem.pdf

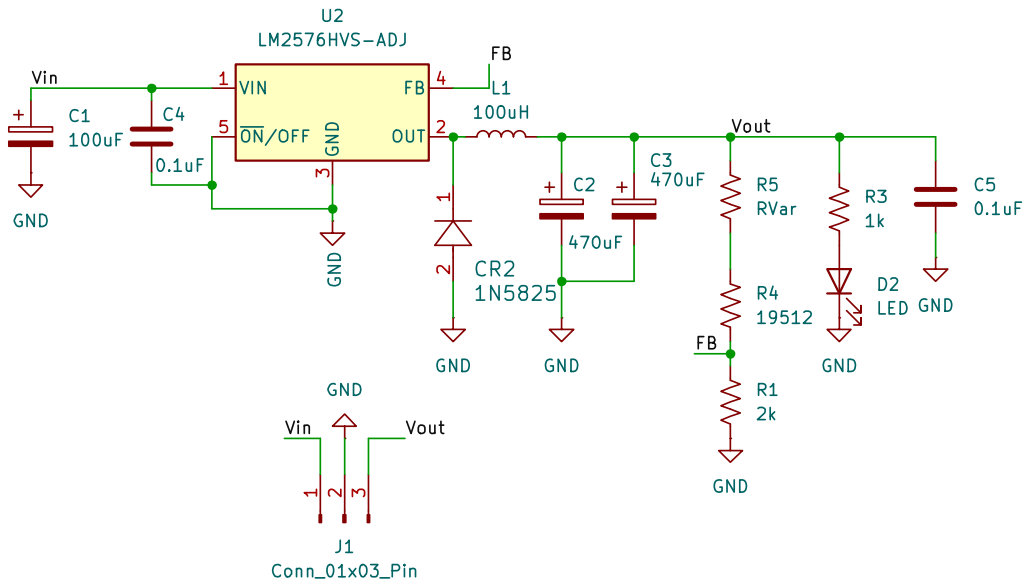
[picture p64: page 1]
