ReadHeadRedemption/SeniorDesignSp26Su26/Hardware/Review PDF's/Initial PCB review/LM2679PiRegulator Board Layout.pdf

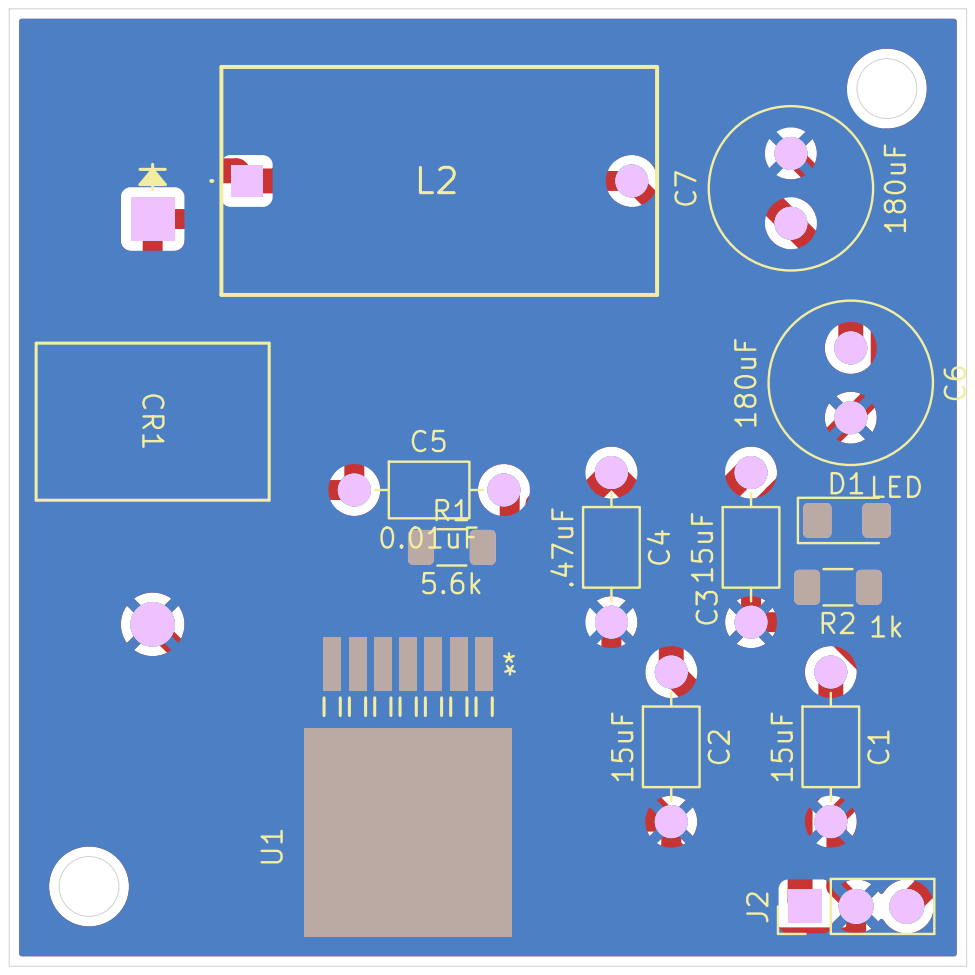
[picture p65: page 1]

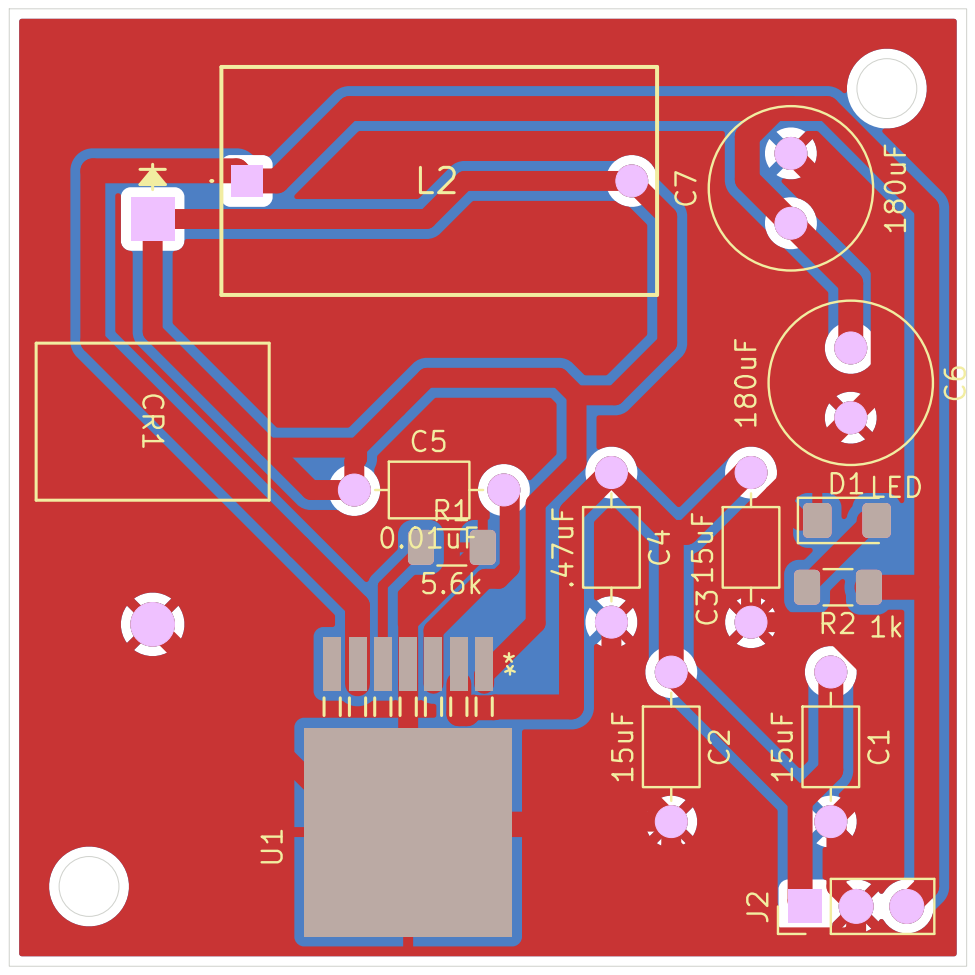
[picture p66: page 2]
