ReadHeadRedemption/SeniorDesignSp26Su26/Hardware/Review PDF's/Initial PCB review/Mainboard Layout 5-22-2026 board layout.pdf

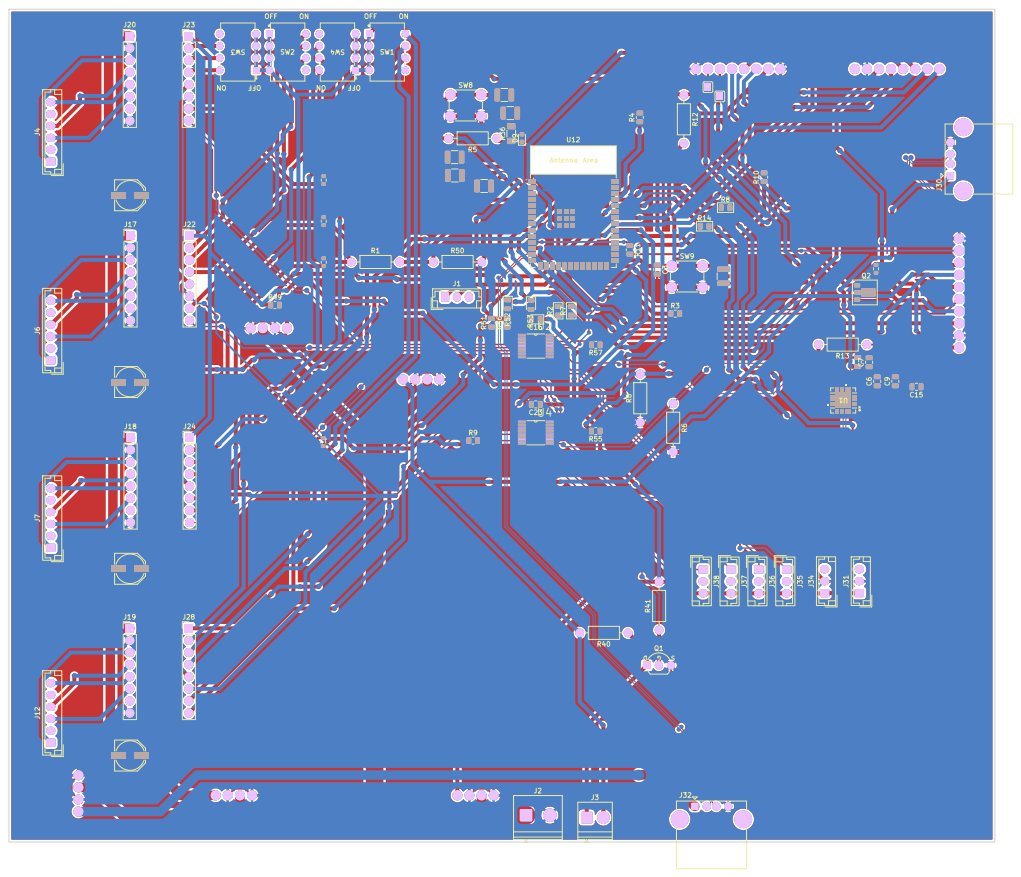
[picture p67: page 1]

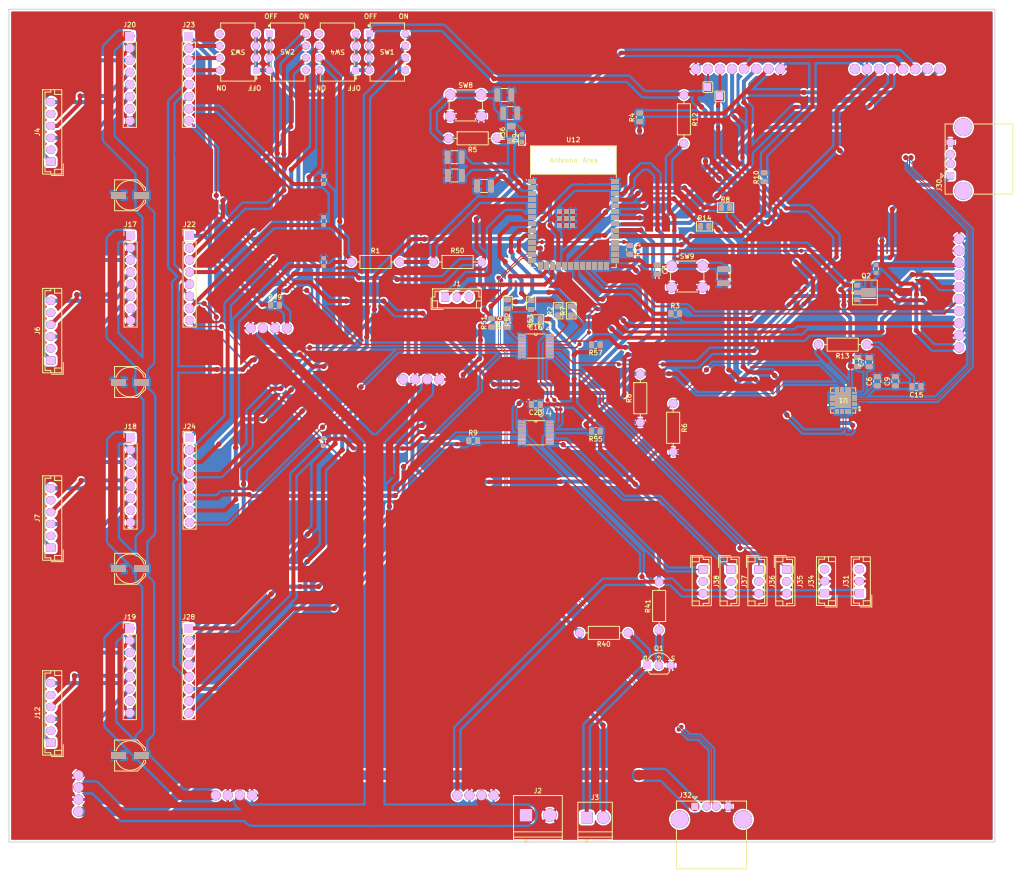
[picture p68: page 2]
