ReadHeadRedemption/SeniorDesignSp26Su26/Hardware/Review PDF's/Initial PCB review/ML2679PIRegulator Schem.pdf

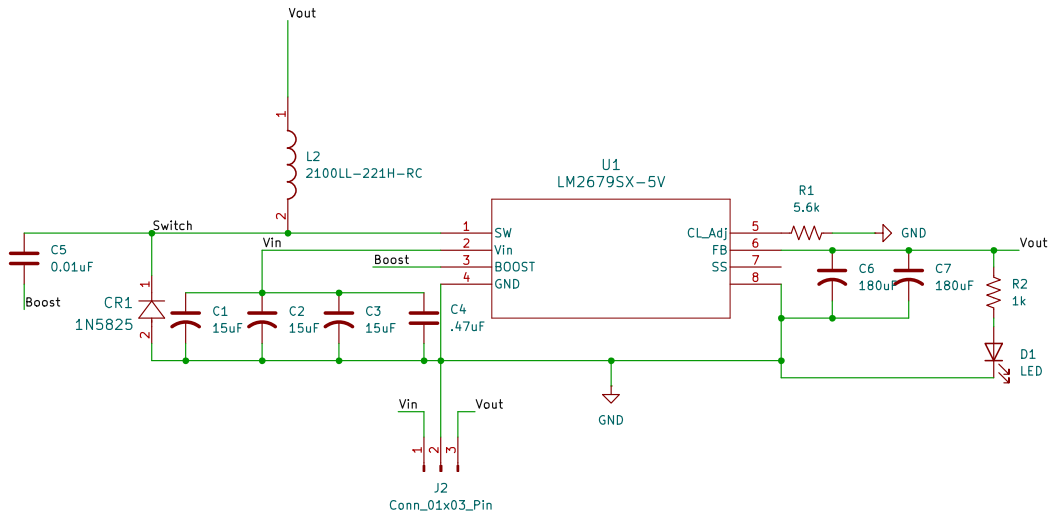
[picture p69: page 1]
