ReadHeadRedemption/SeniorDesignSp26Su26/Hardware/Review PDF's/Initial PCB review/Non swapping head board layout.pdf

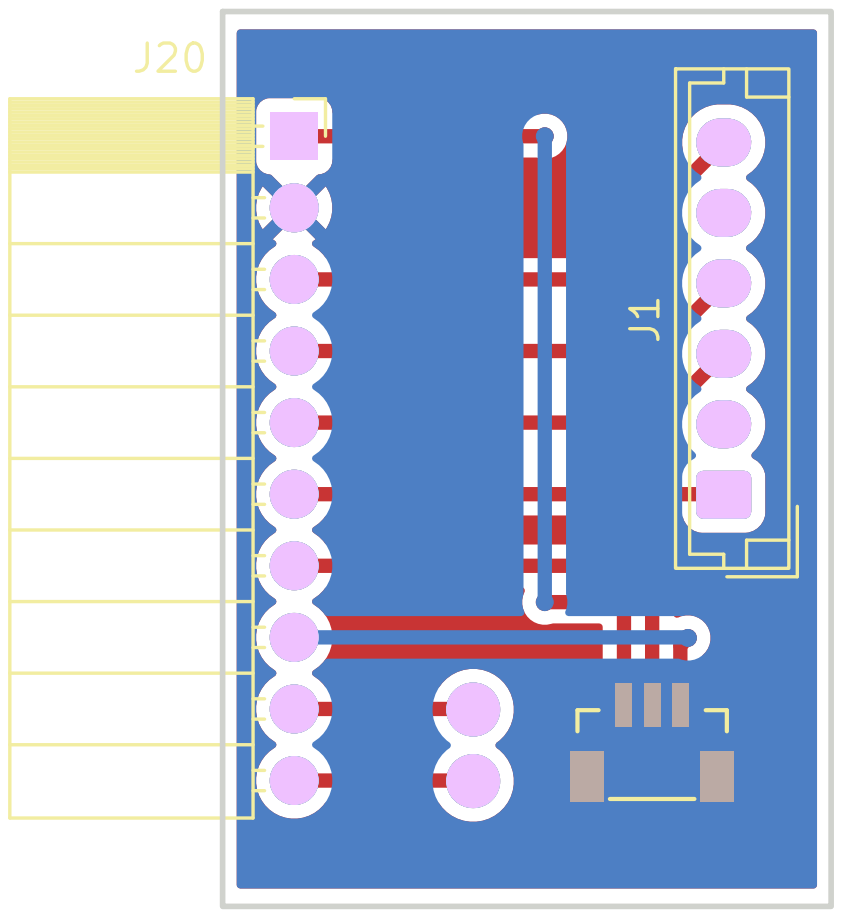
[picture p70: page 1]

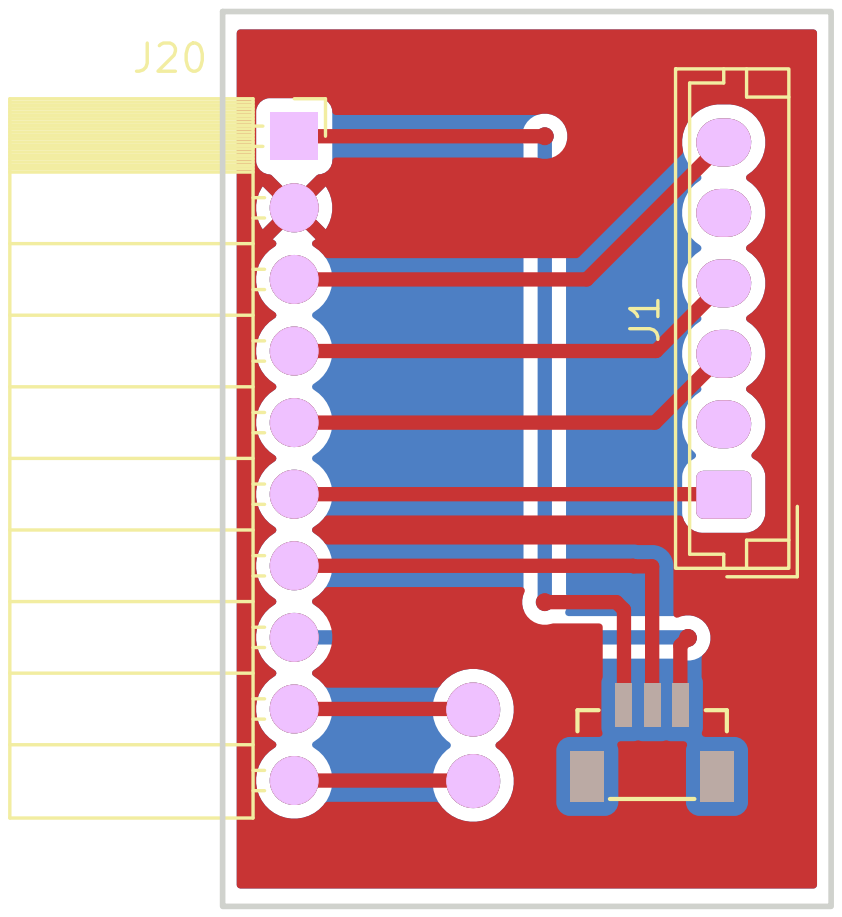
[picture p71: page 2]
