ReadHeadRedemption/SeniorDesignSp26Su26/Hardware/Review PDF's/Initial PCB review/Non Swapping Hotend Schem.pdf

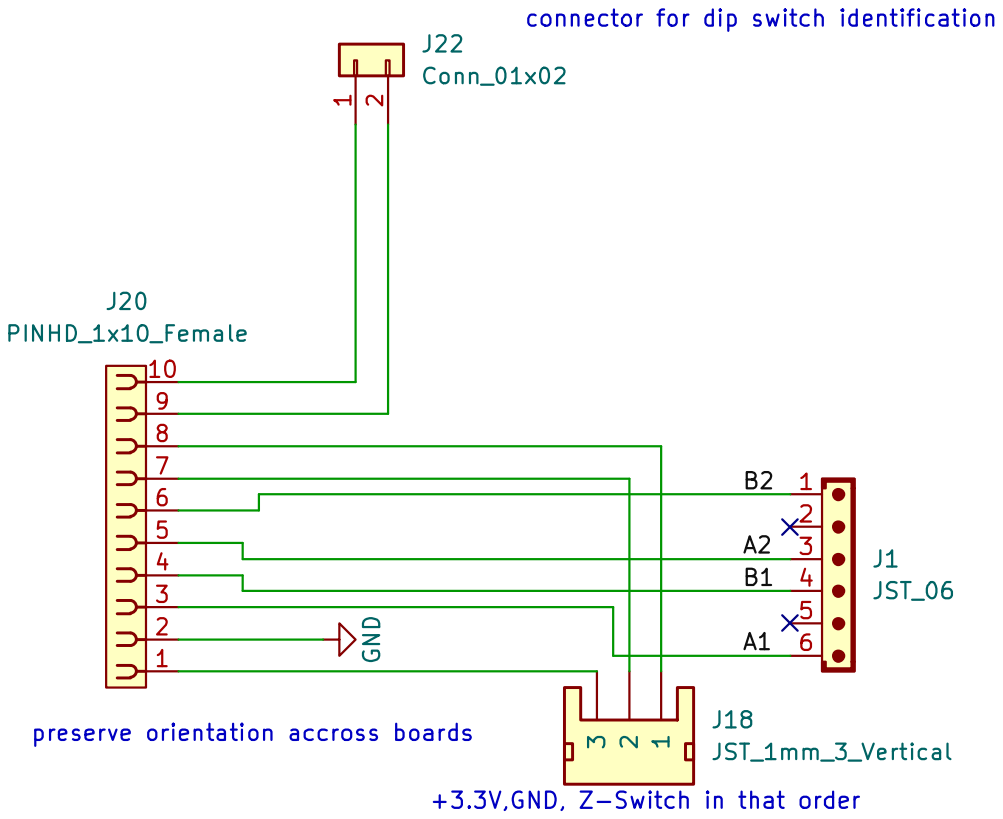
[picture p72: page 1]
