ReadHeadRedemption/SeniorDesignSp26Su26/Hardware/Review PDF's/Initial PCB review/Swapping Hotend Schem.pdf

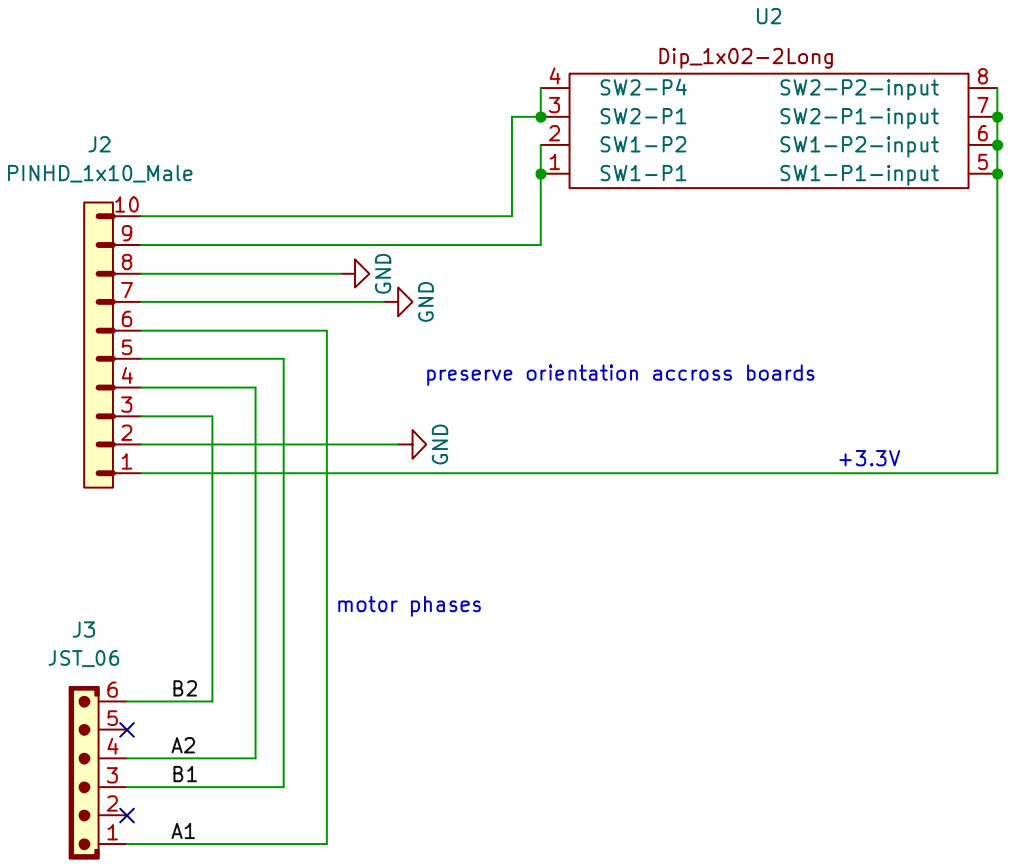
[picture p73: page 1]
