ReadHeadRedemption/SeniorDesignSp26Su26/Hardware/KiCAD files/reference schematics/Senior design/Duet3-Mainboard-6HC-master/Duet3_Mainboard_6HC_v0.5/Duet3_MB_schematic_v0.5.pdf

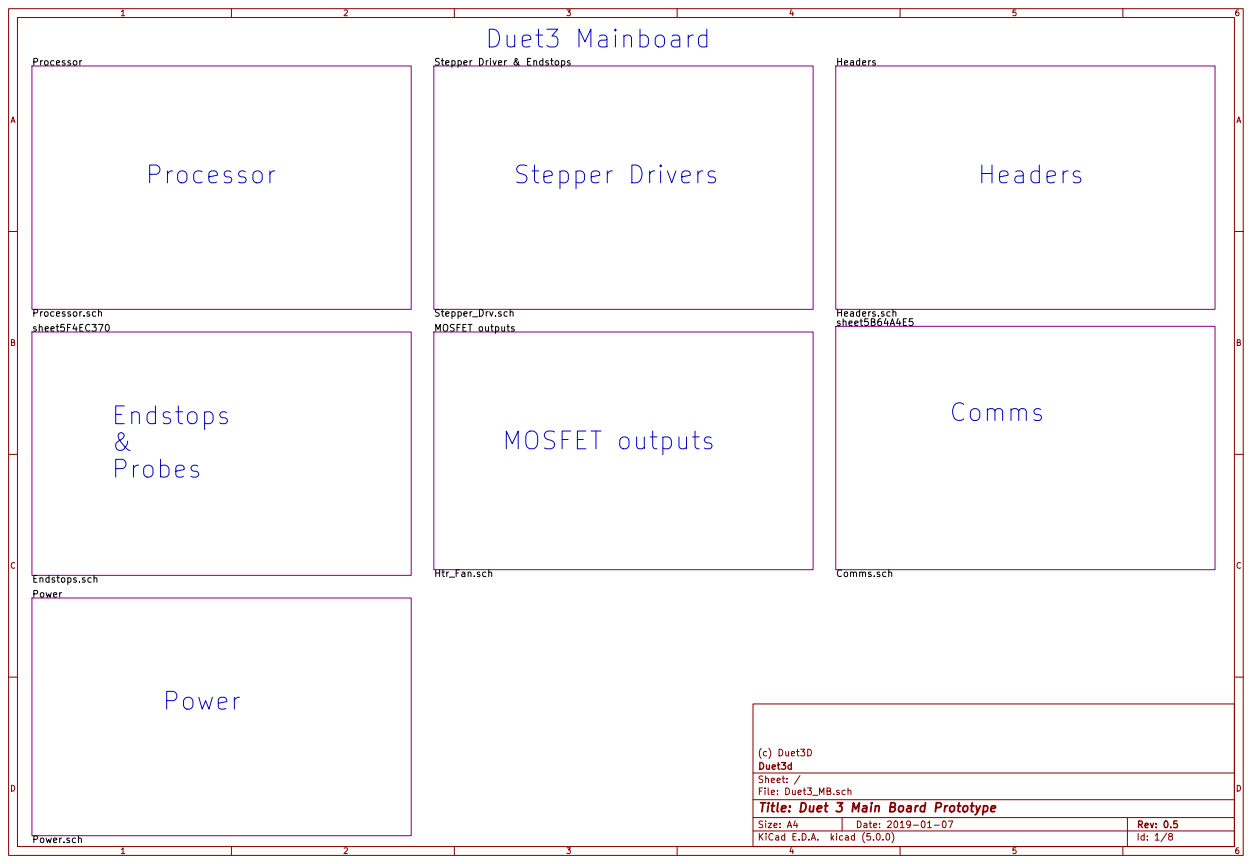
[picture p74: page 1]

Id: 1/8 Title: Duet 3 Main Board Prototype

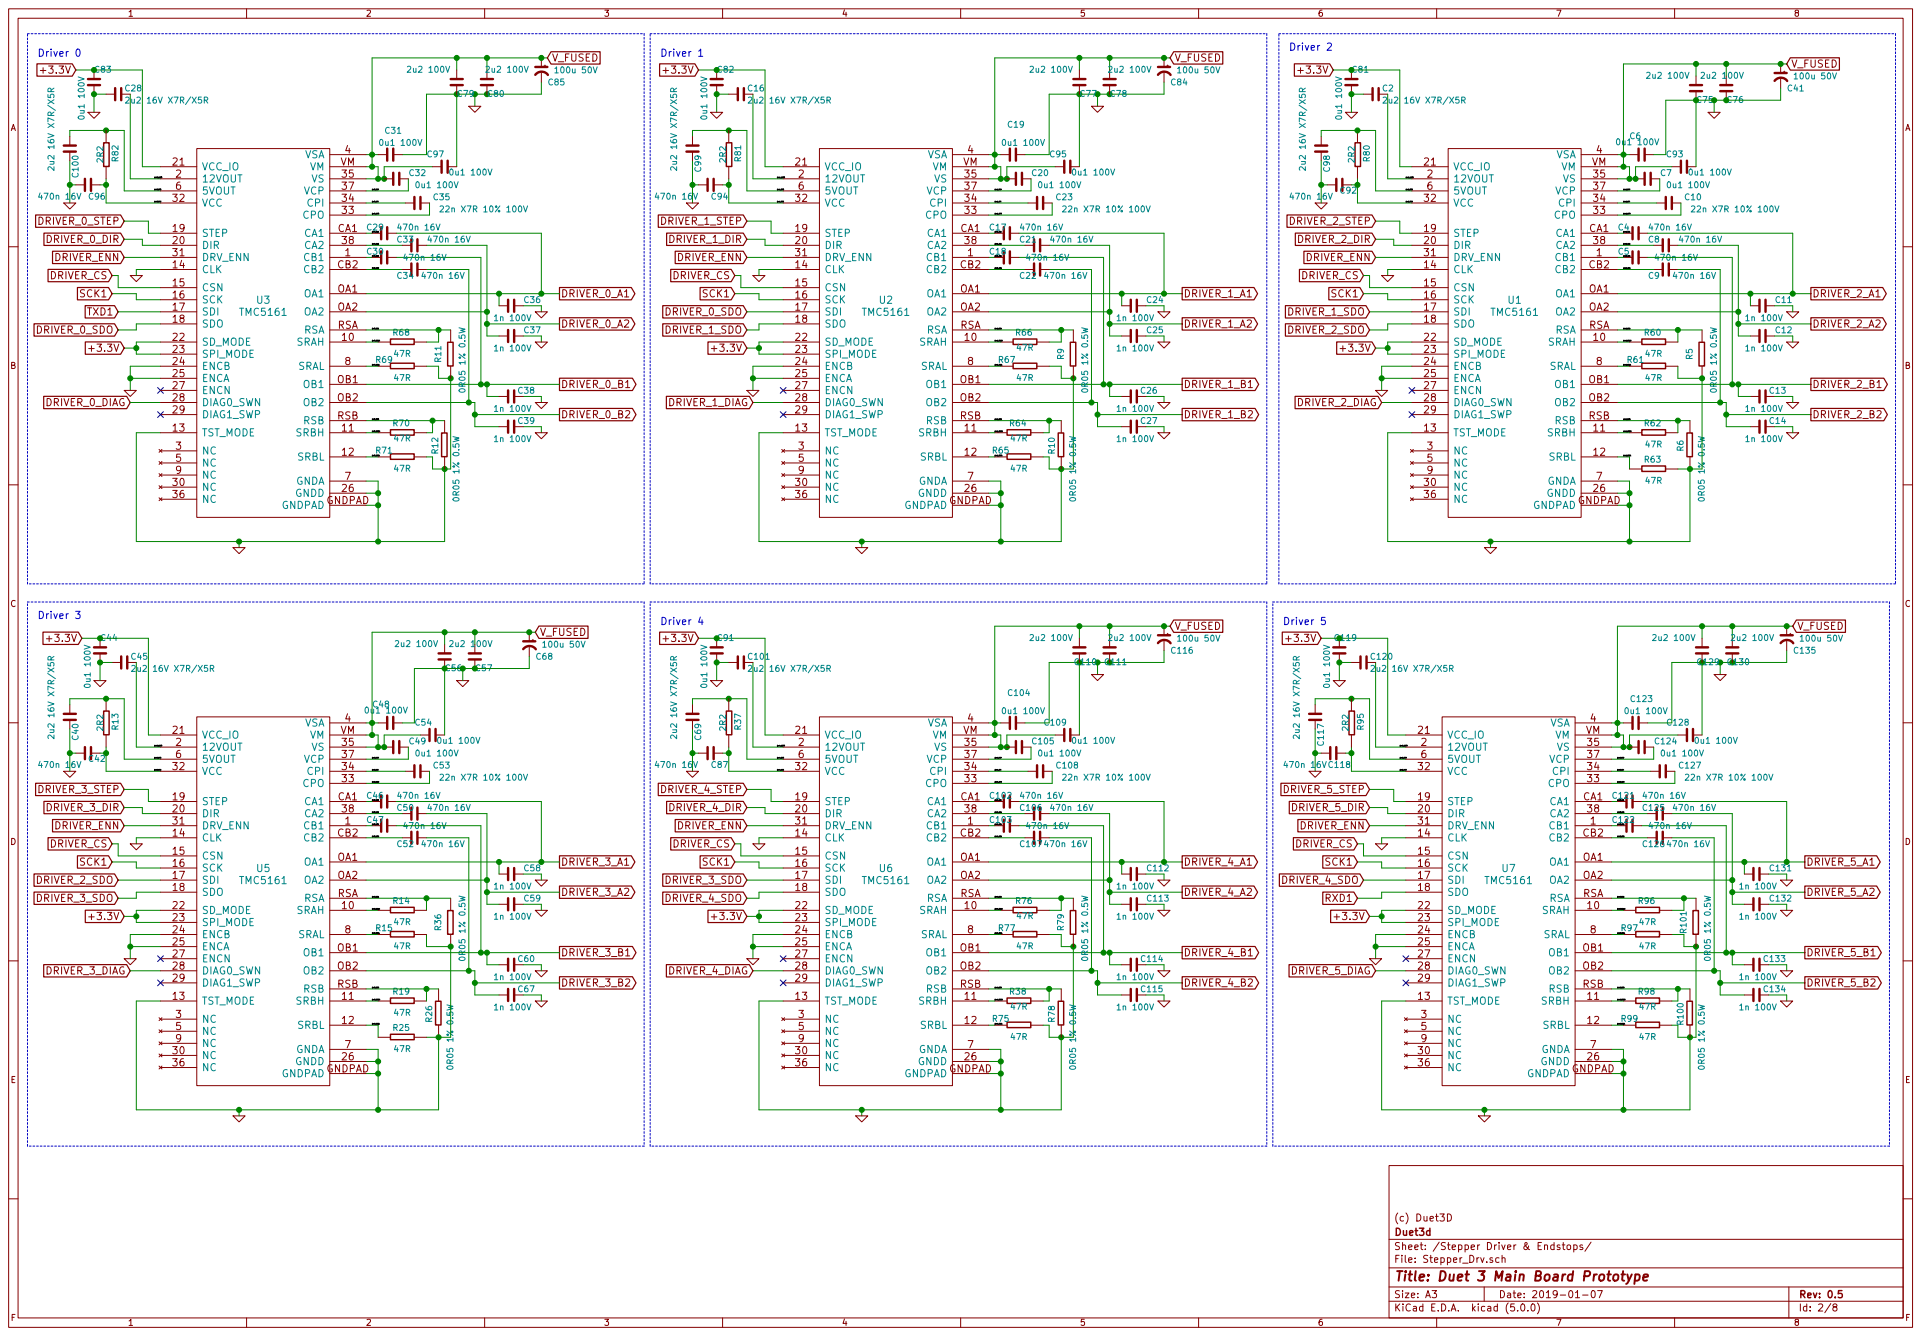
[picture p75: page 2]

(c) Duet3D
Sheet: /Stepper Driver & Endstops/ Duet3d

File: Stepper_Drv.sch
Id: 2/8 Title: Duet 3 Main Board Prototype

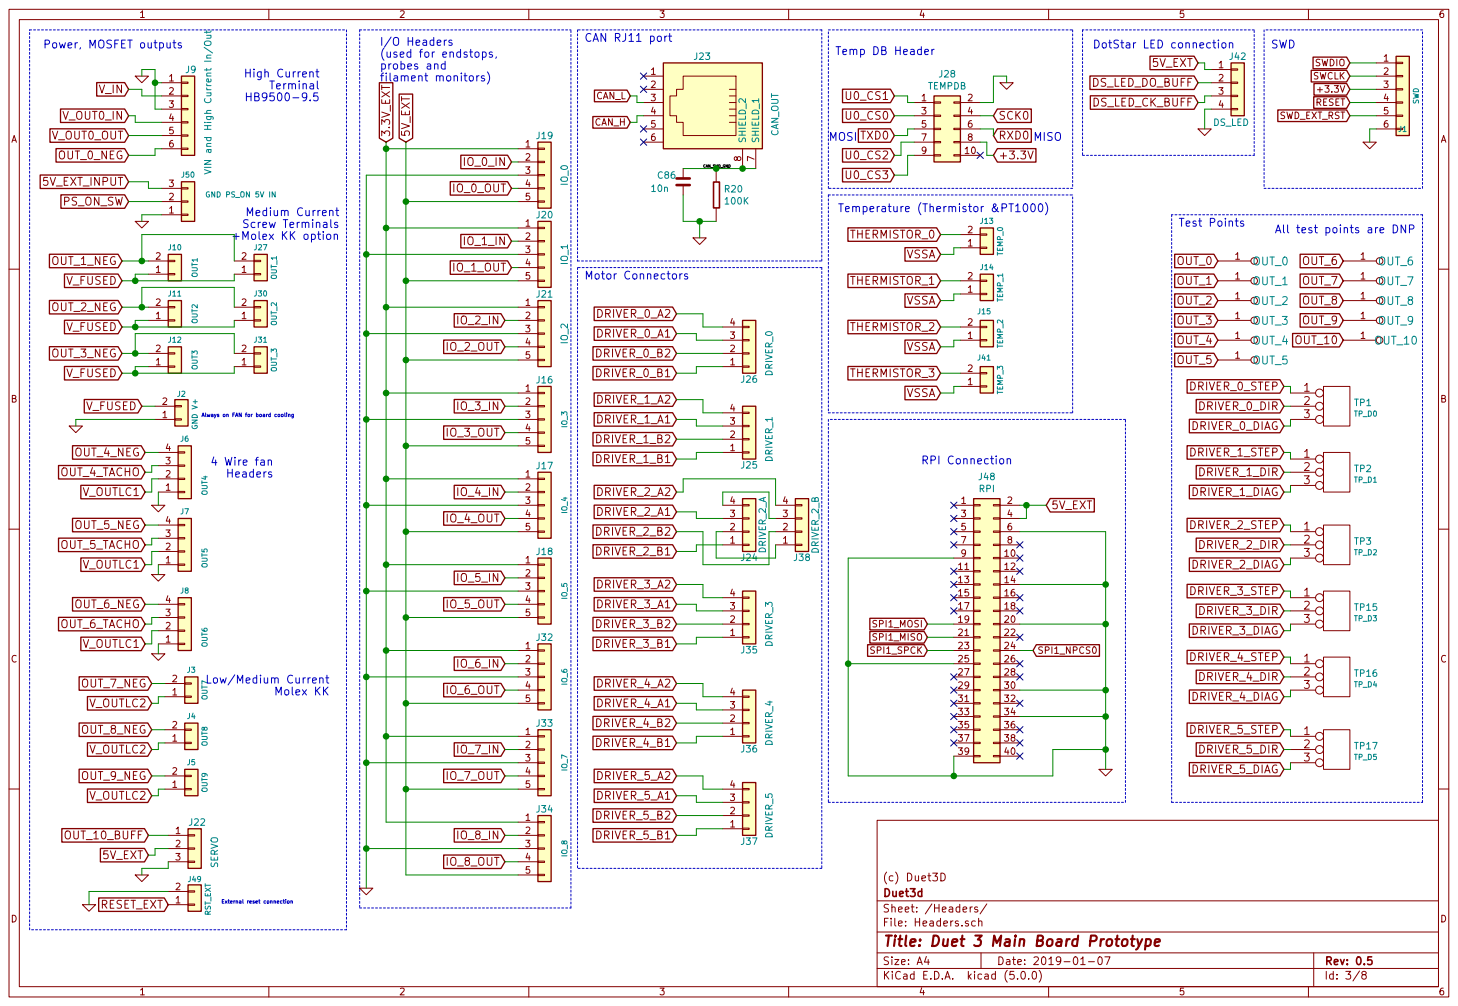
[picture p76: page 3]

All test points are DNP

Always on FAN for board cooling V_OUTLC2

(c) Duet3D
Id: 3/8 Title: Duet 3 Main Board Prototype File: Headers.sch Sheet: /Headers/ Duet3d

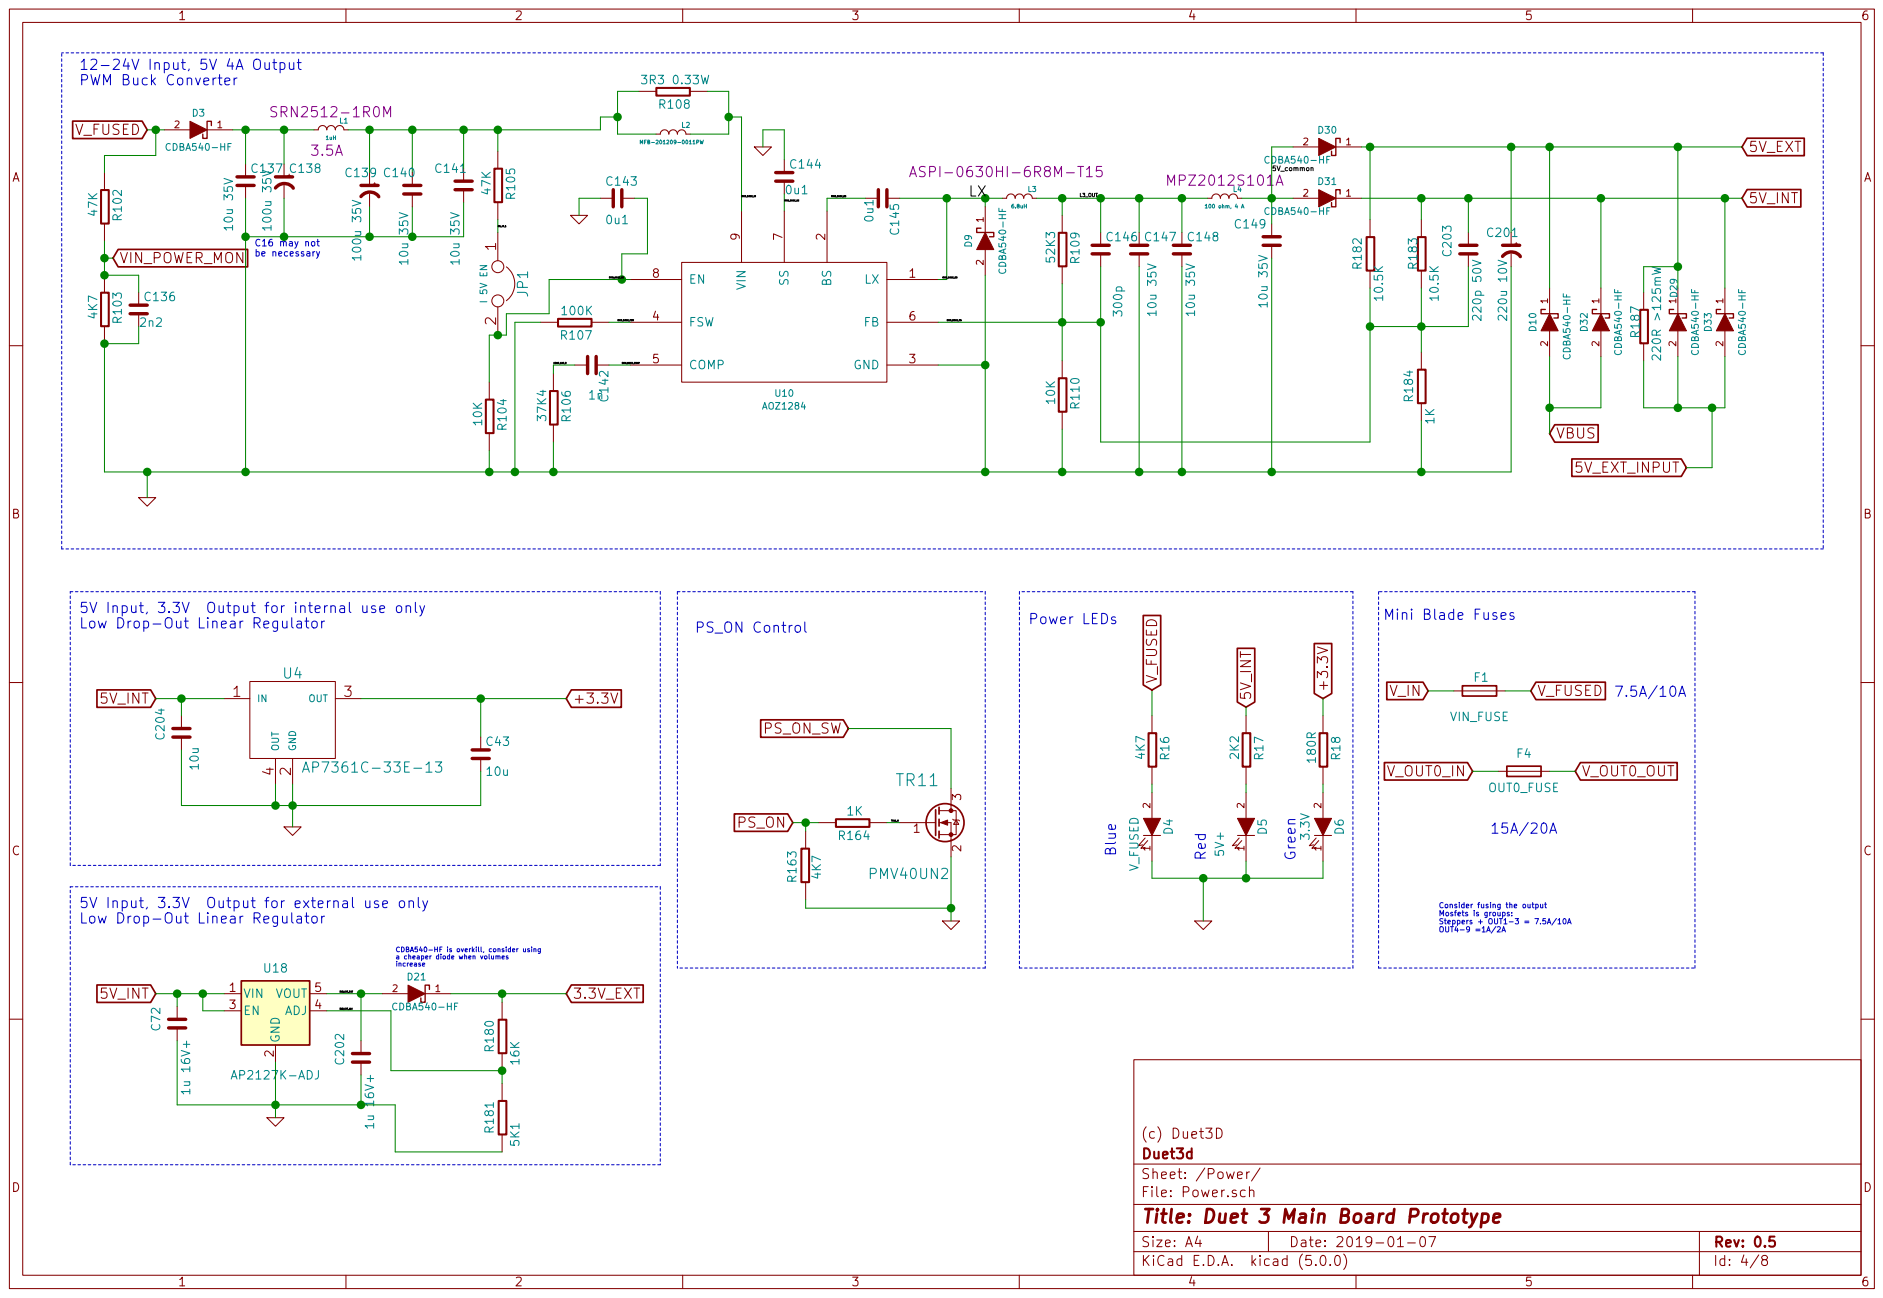
[picture p77: page 4]

2 GND 3 FSW 4 COMP 5 FB 6 SS

5V Input, 3.3V Output for internal use only
Low Drop-Out Linear Regulator

Consider fusing the output Mosfets is groups: Steppers + OUT1-3 = 7.5A/10A OUT4-9 =1A/2A 1

5V Input, 3.3V Output for external use only

CDBA540-HF is overkill, consider using
a cheaper diode when volumes

2 EN 3 ADJ 4 VOUT 5 U18 AP2127K-ADJ C72 1u 16V+ C202 1u 16V+ R180 16K

(c) Duet3D
Id: 4/8 Title: Duet 3 Main Board Prototype File: Power.sch Sheet: /Power/ Duet3d

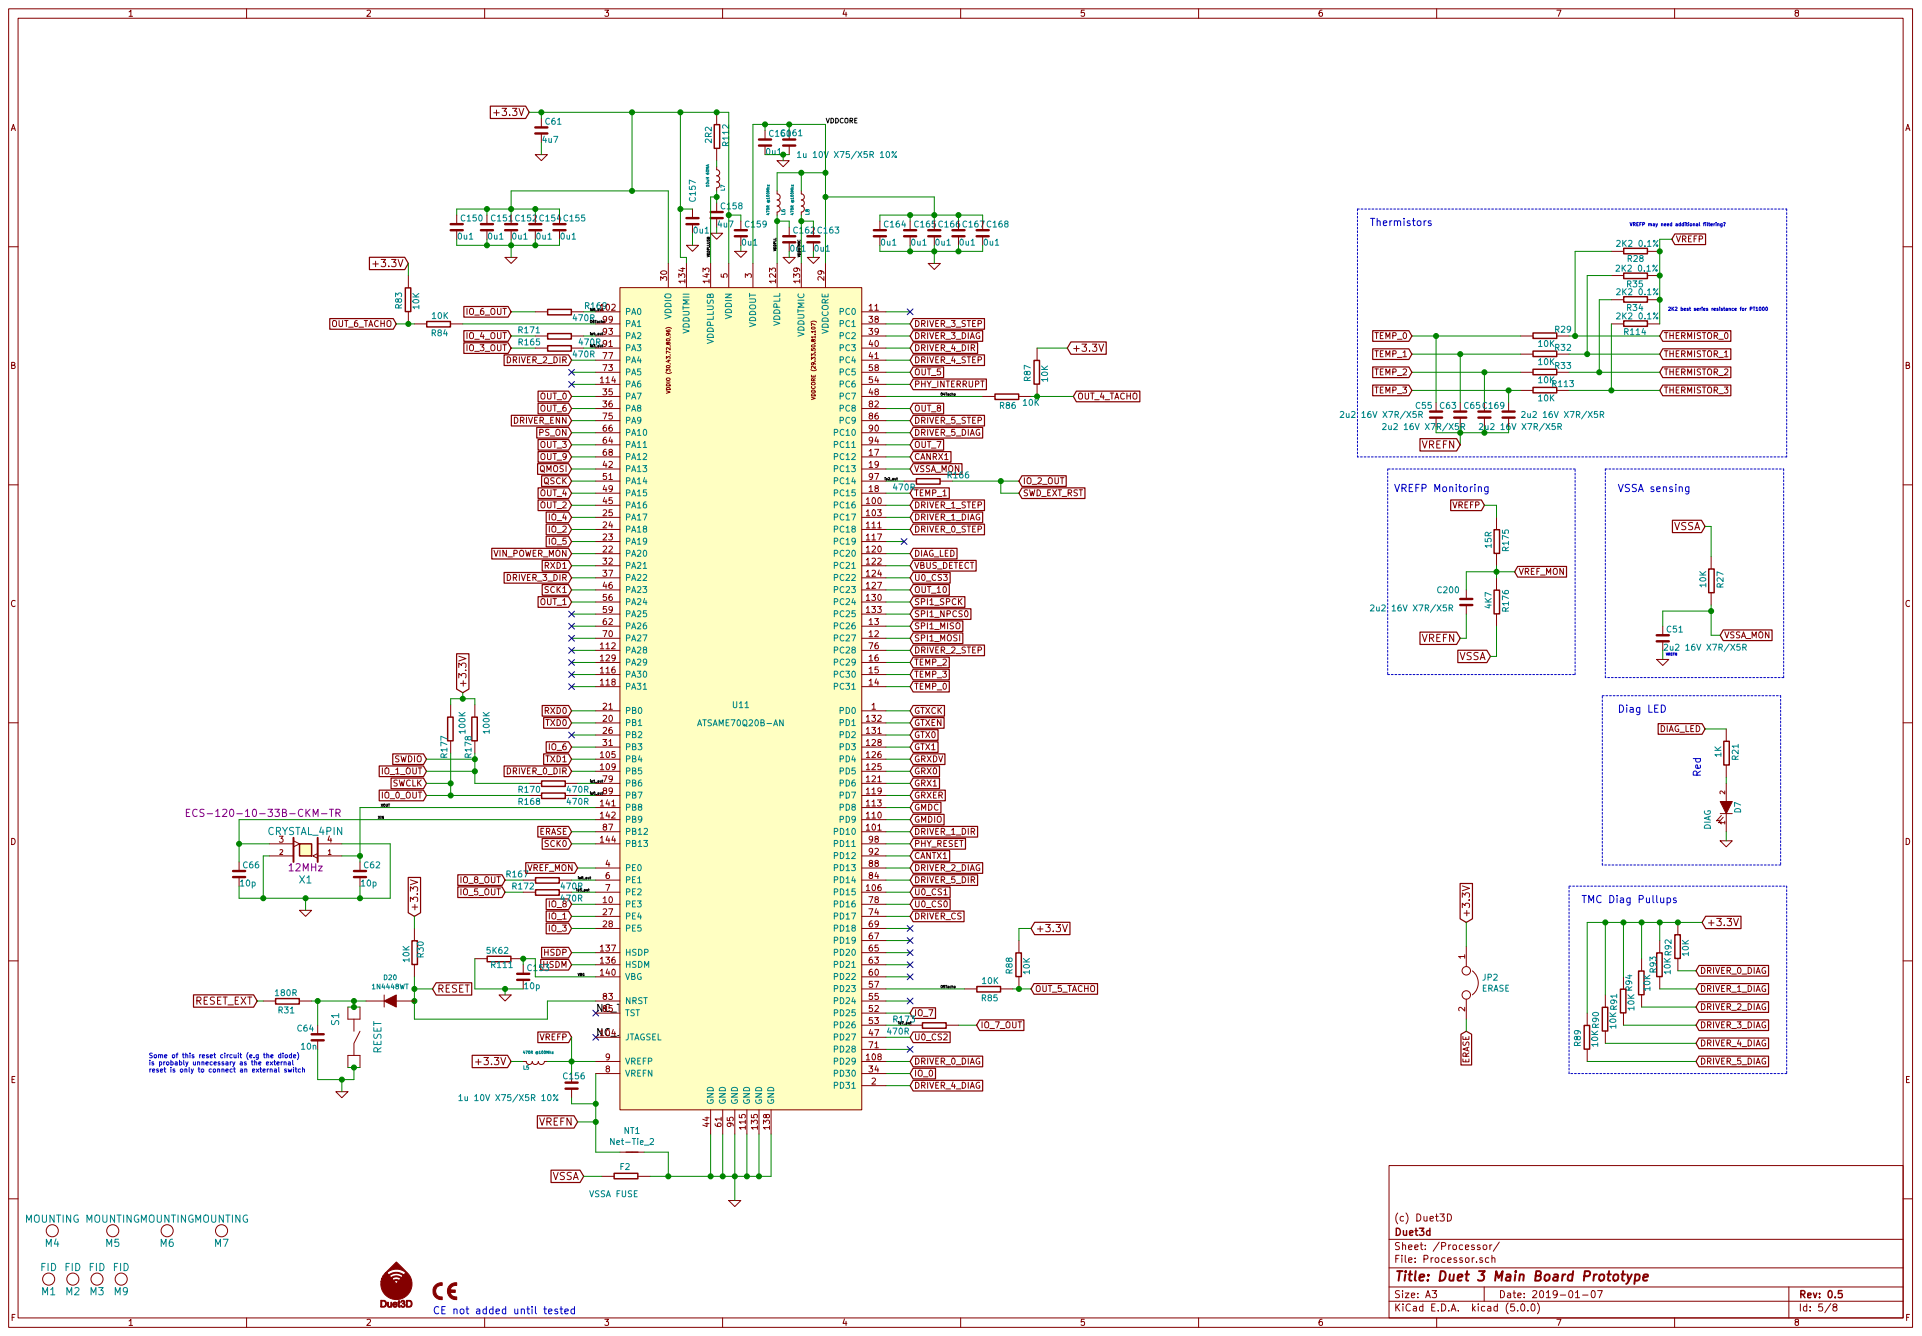
[picture p78: page 5]

1N4448WT Some of this reset circuit (e.g the diode)

(c) Duet3D
Id: 5/8 Title: Duet 3 Main Board Prototype File: Processor.sch Sheet: /Processor/ Duet3d

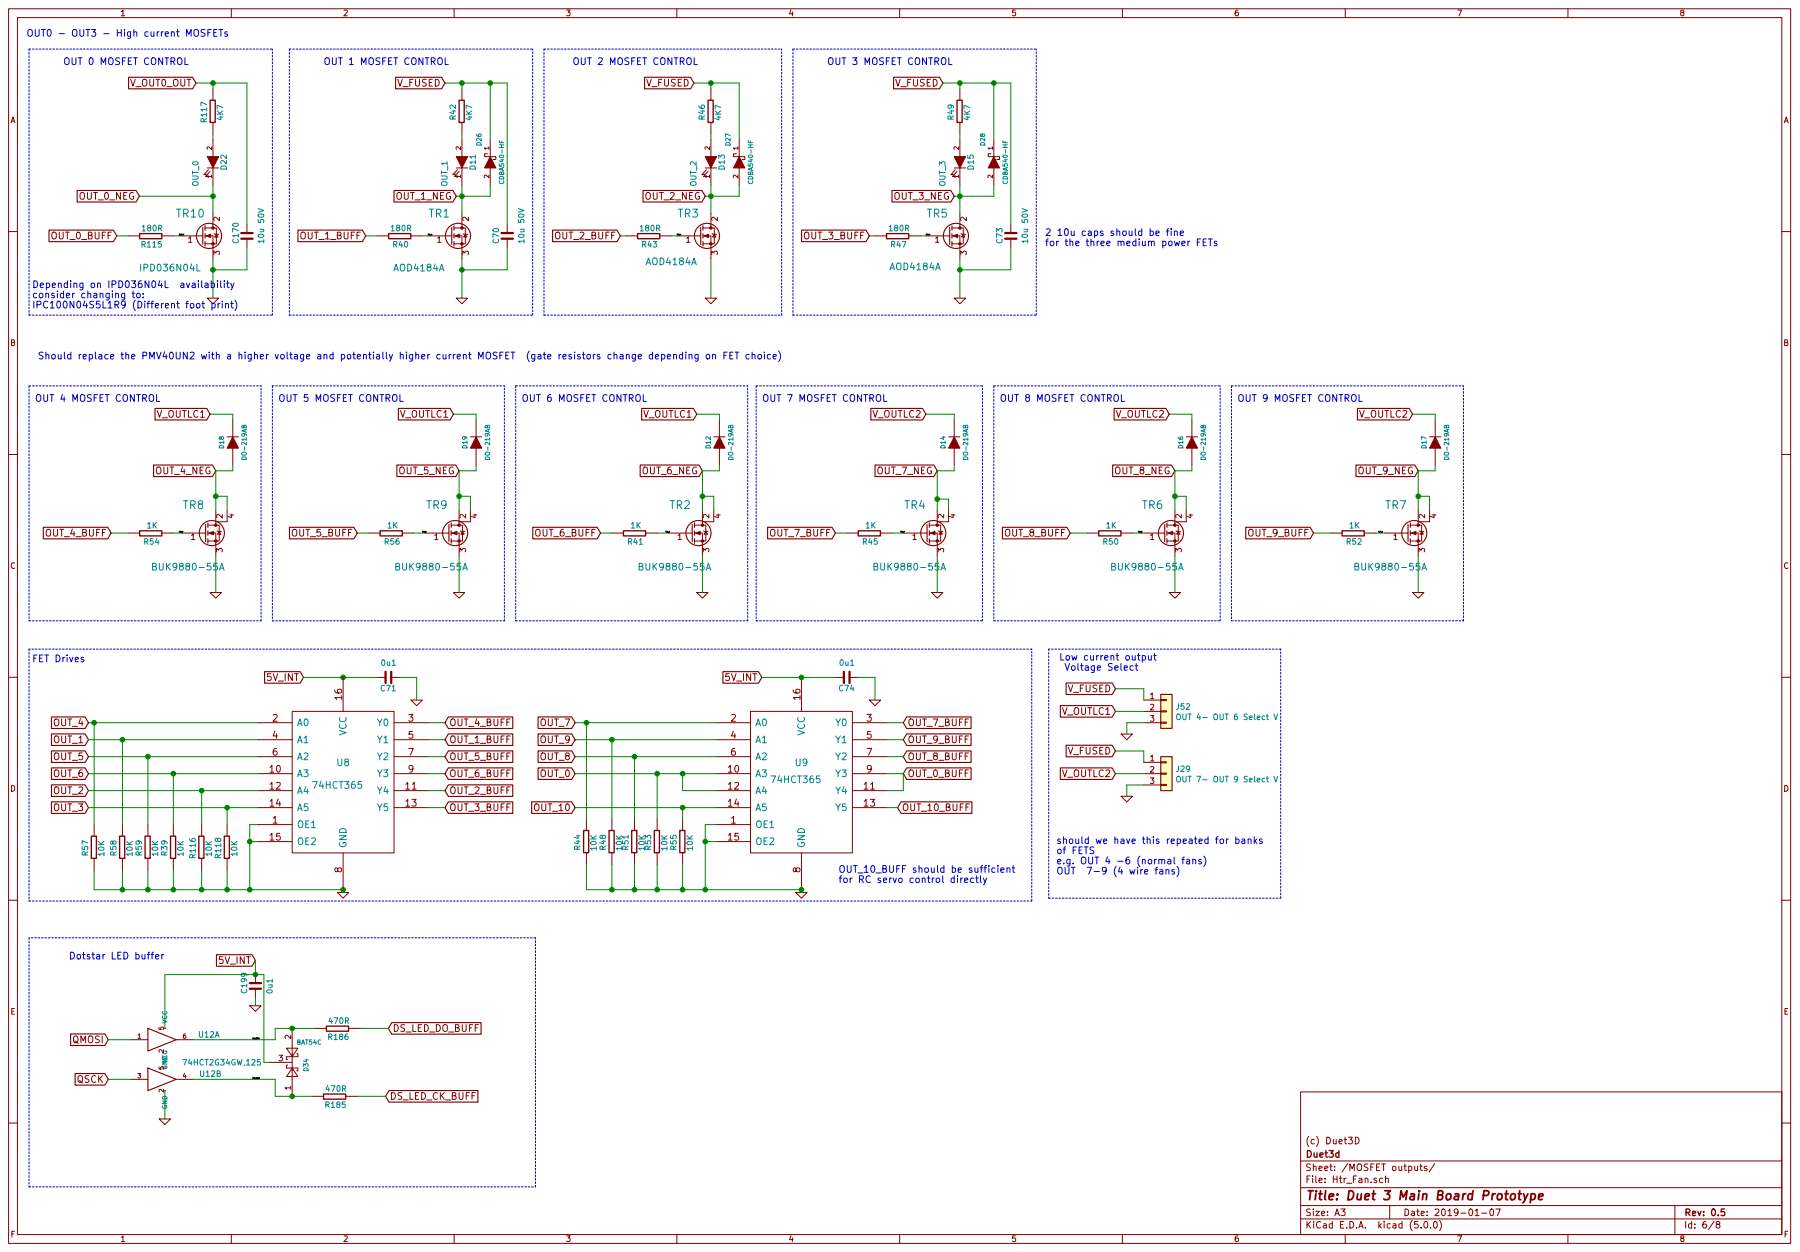
[picture p79: page 6]

OUT_0_BUFF
Should replace the PMV40UN2 with a higher voltage and potentially higher current MOSFET (gate resistors change depending on FET choice) 1

2 10u caps should be fine
for the three medium power FETs

J29OUT 7- OUT 9 Select V Low current output
Voltage Select

should we have this repeated for banks
of FETS
e.g. OUT 4 -6 (normal fans)

for RC servo control directly GND

File: Htr_Fan.sch
Id: 6/8 Title: Duet 3 Main Board Prototype

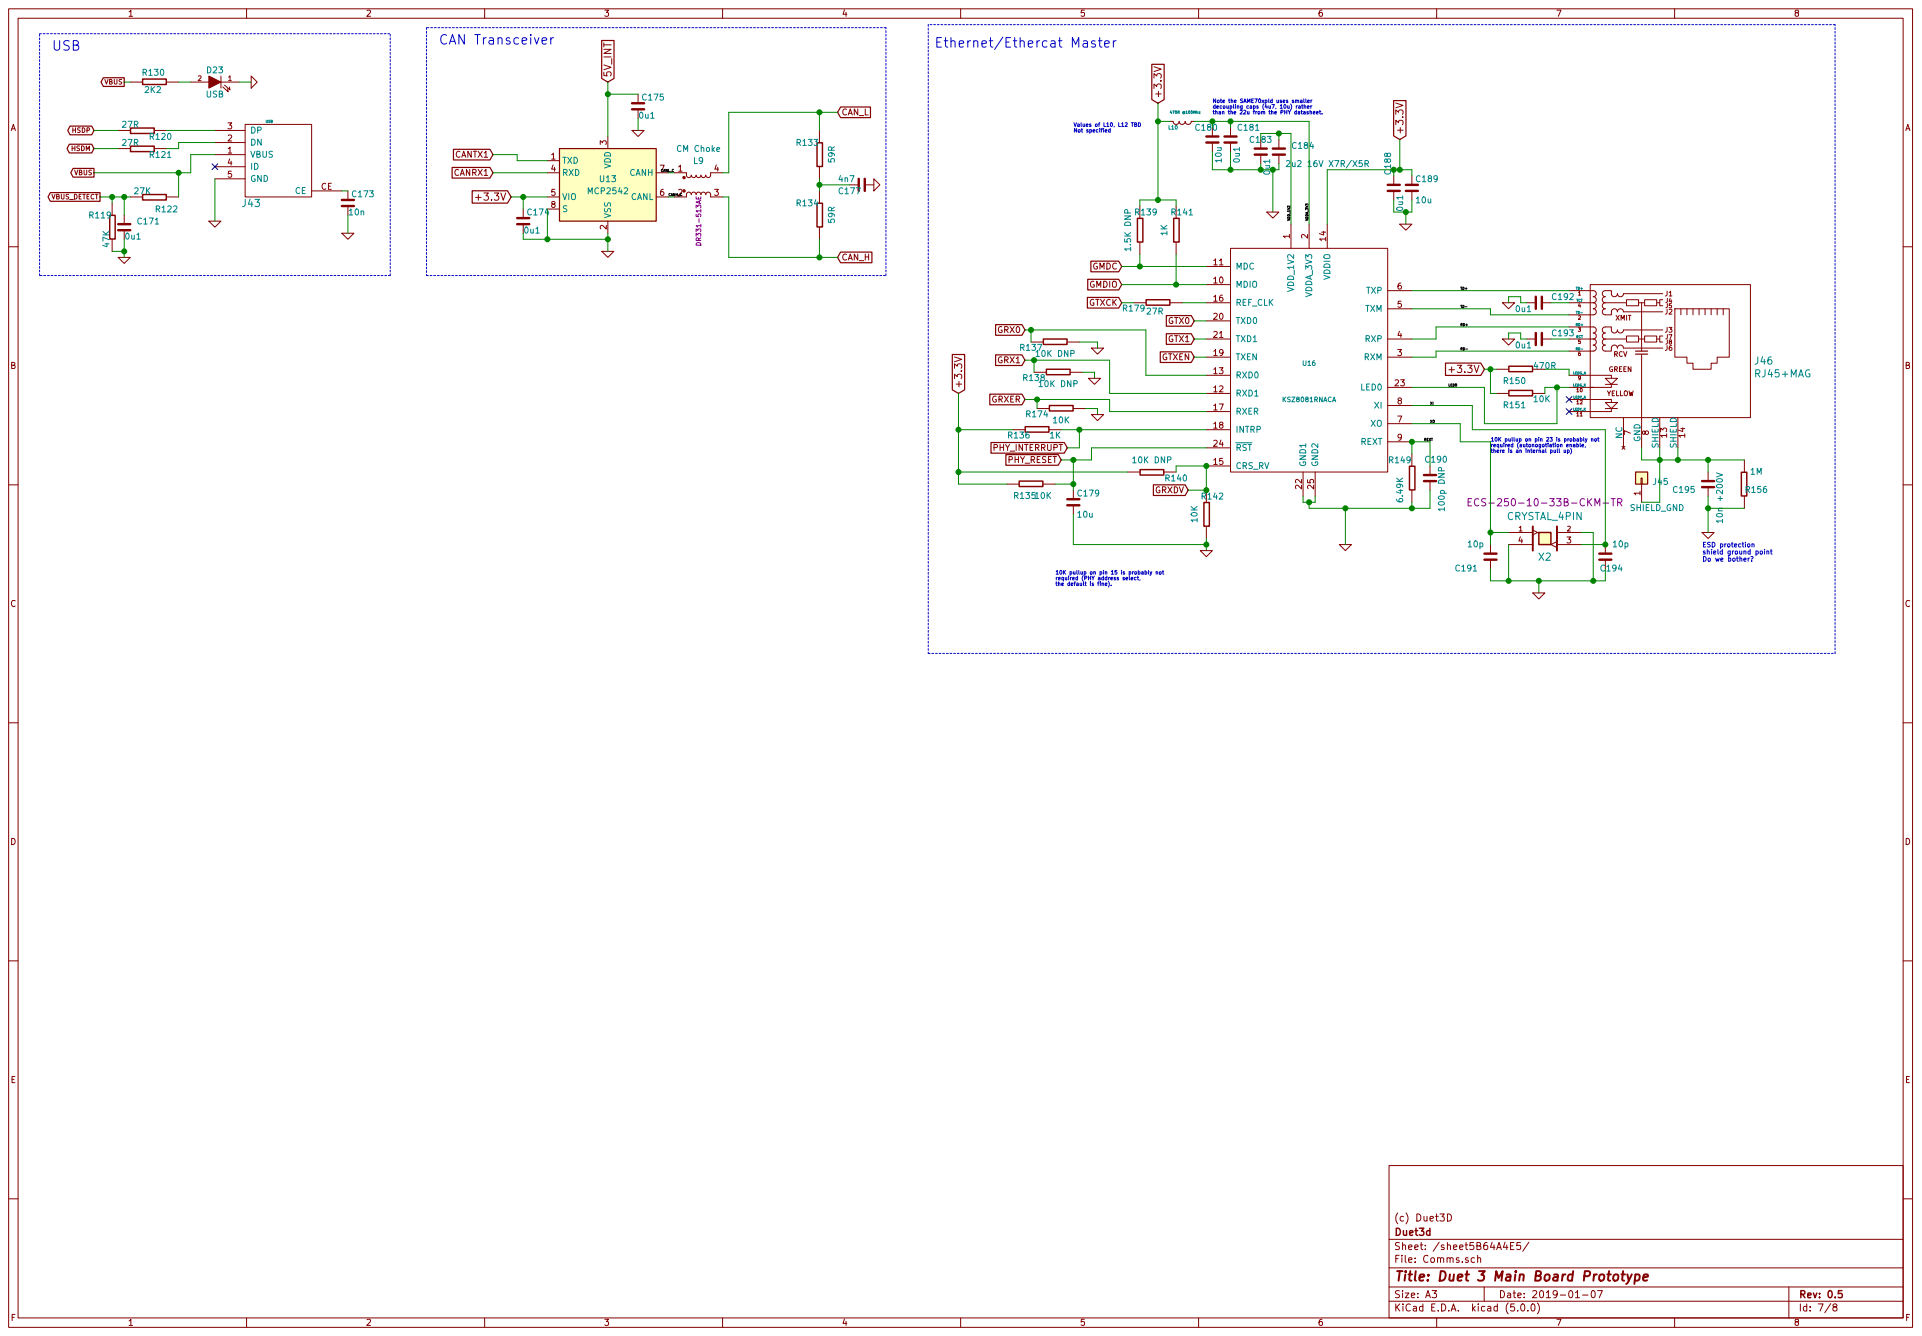
[picture p80: page 7]

CAN Transceiver

there is an internal pull up) Ethernet/Ethercat Master

R130 2 2K2 | 1 D23 USB R121

Note the SAME70xpld uses smaller decoupling caps (4u7, 10u) rather

than the 22u from the PHY datasheet.

3 RXD 4 VIO 5 CANL 6 CANH 7 S

1 MDIO 10 MDC 11 RXD1 12 RXD0 13 VDDIO 14 CRS_RV 15 REF_CLK 16 RXER 17

RD- RD+ TD- TD+ REXTXI XO

J45 SHIELD_GND
shield ground point Do we bother? 1

10K pullup on pin 15 is probably not required (PHY address select,

(c) Duet3D
Id: 7/8 Title: Duet 3 Main Board Prototype File: Comms.sch Sheet: /sheet5B64A4E5/ Duet3d

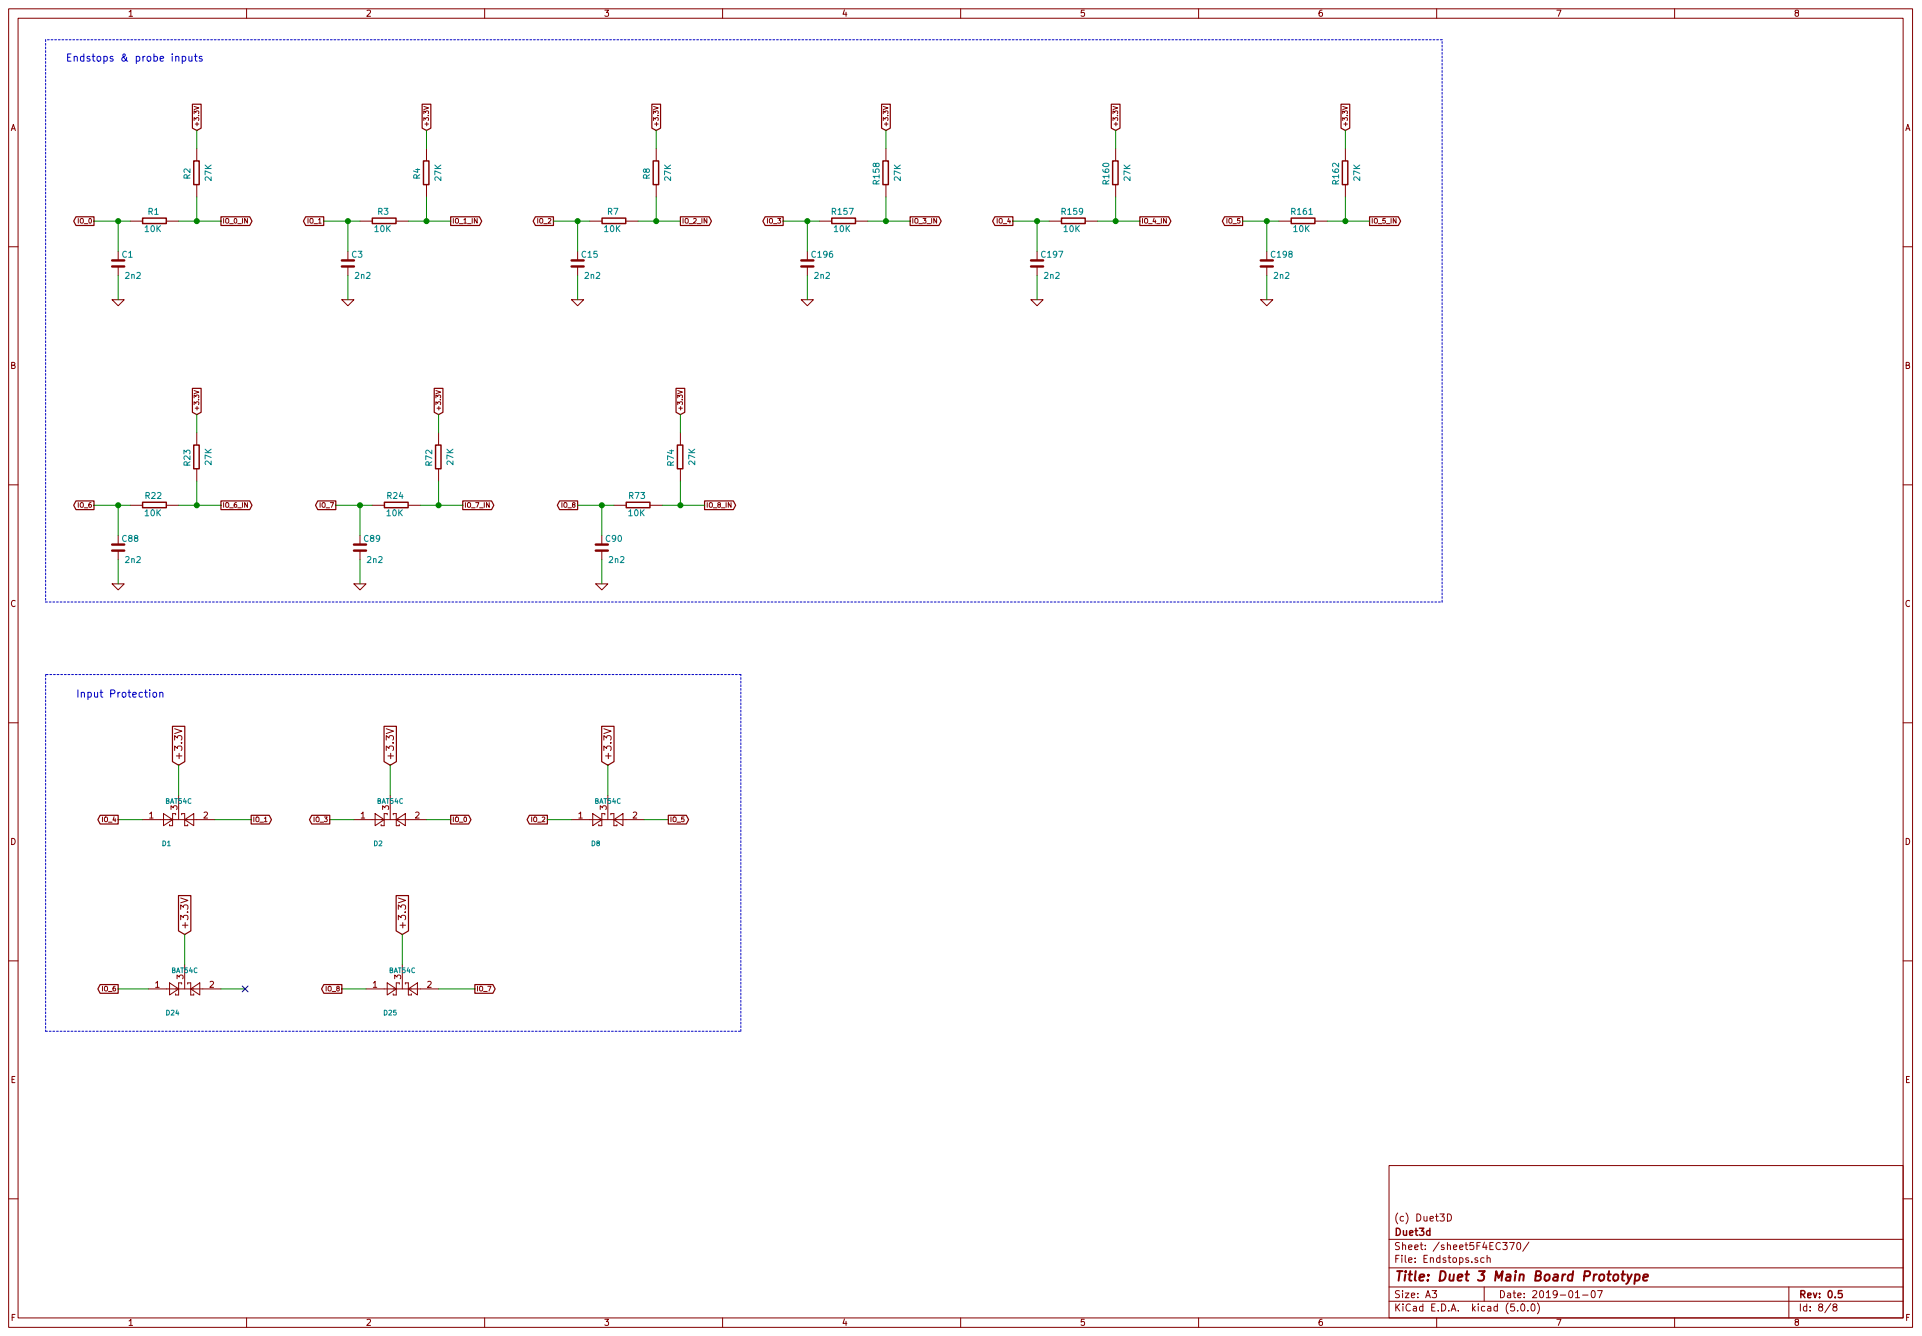
[picture p81: page 8]

File: Endstops.sch Sheet: /sheet5F4EC370/ Duet3d

Id: 8/8 Title: Duet 3 Main Board Prototype
