ReadHeadRedemption/SeniorDesignSp26Su26/Hardware/KiCAD files/reference schematics/Senior design/Duet3-Mainboard-6HC-master/Duet3_Mainboard_6HC_v0.6/Duet3_MB_schematic_v0.6.pdf

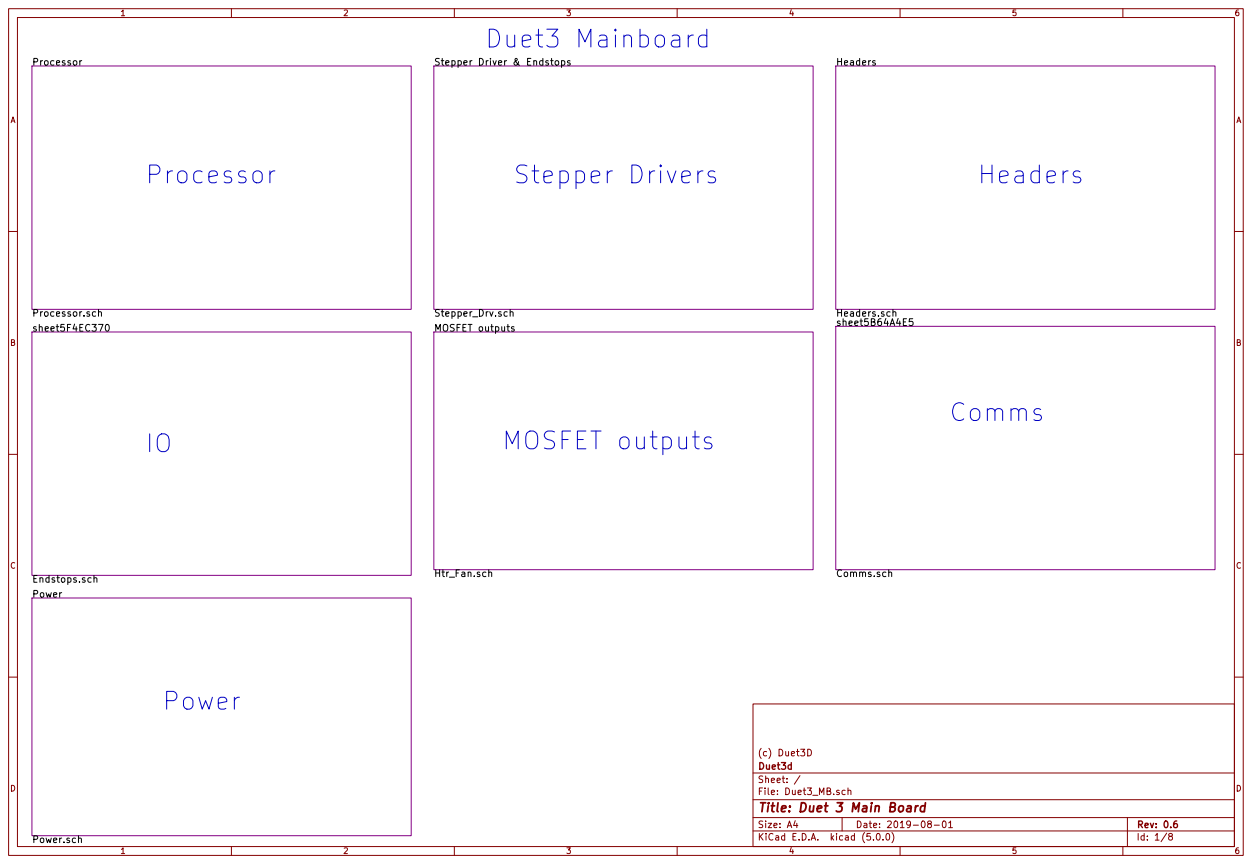
[picture p82: page 1]

Id: 1/8 Title: Duet 3 Main Board

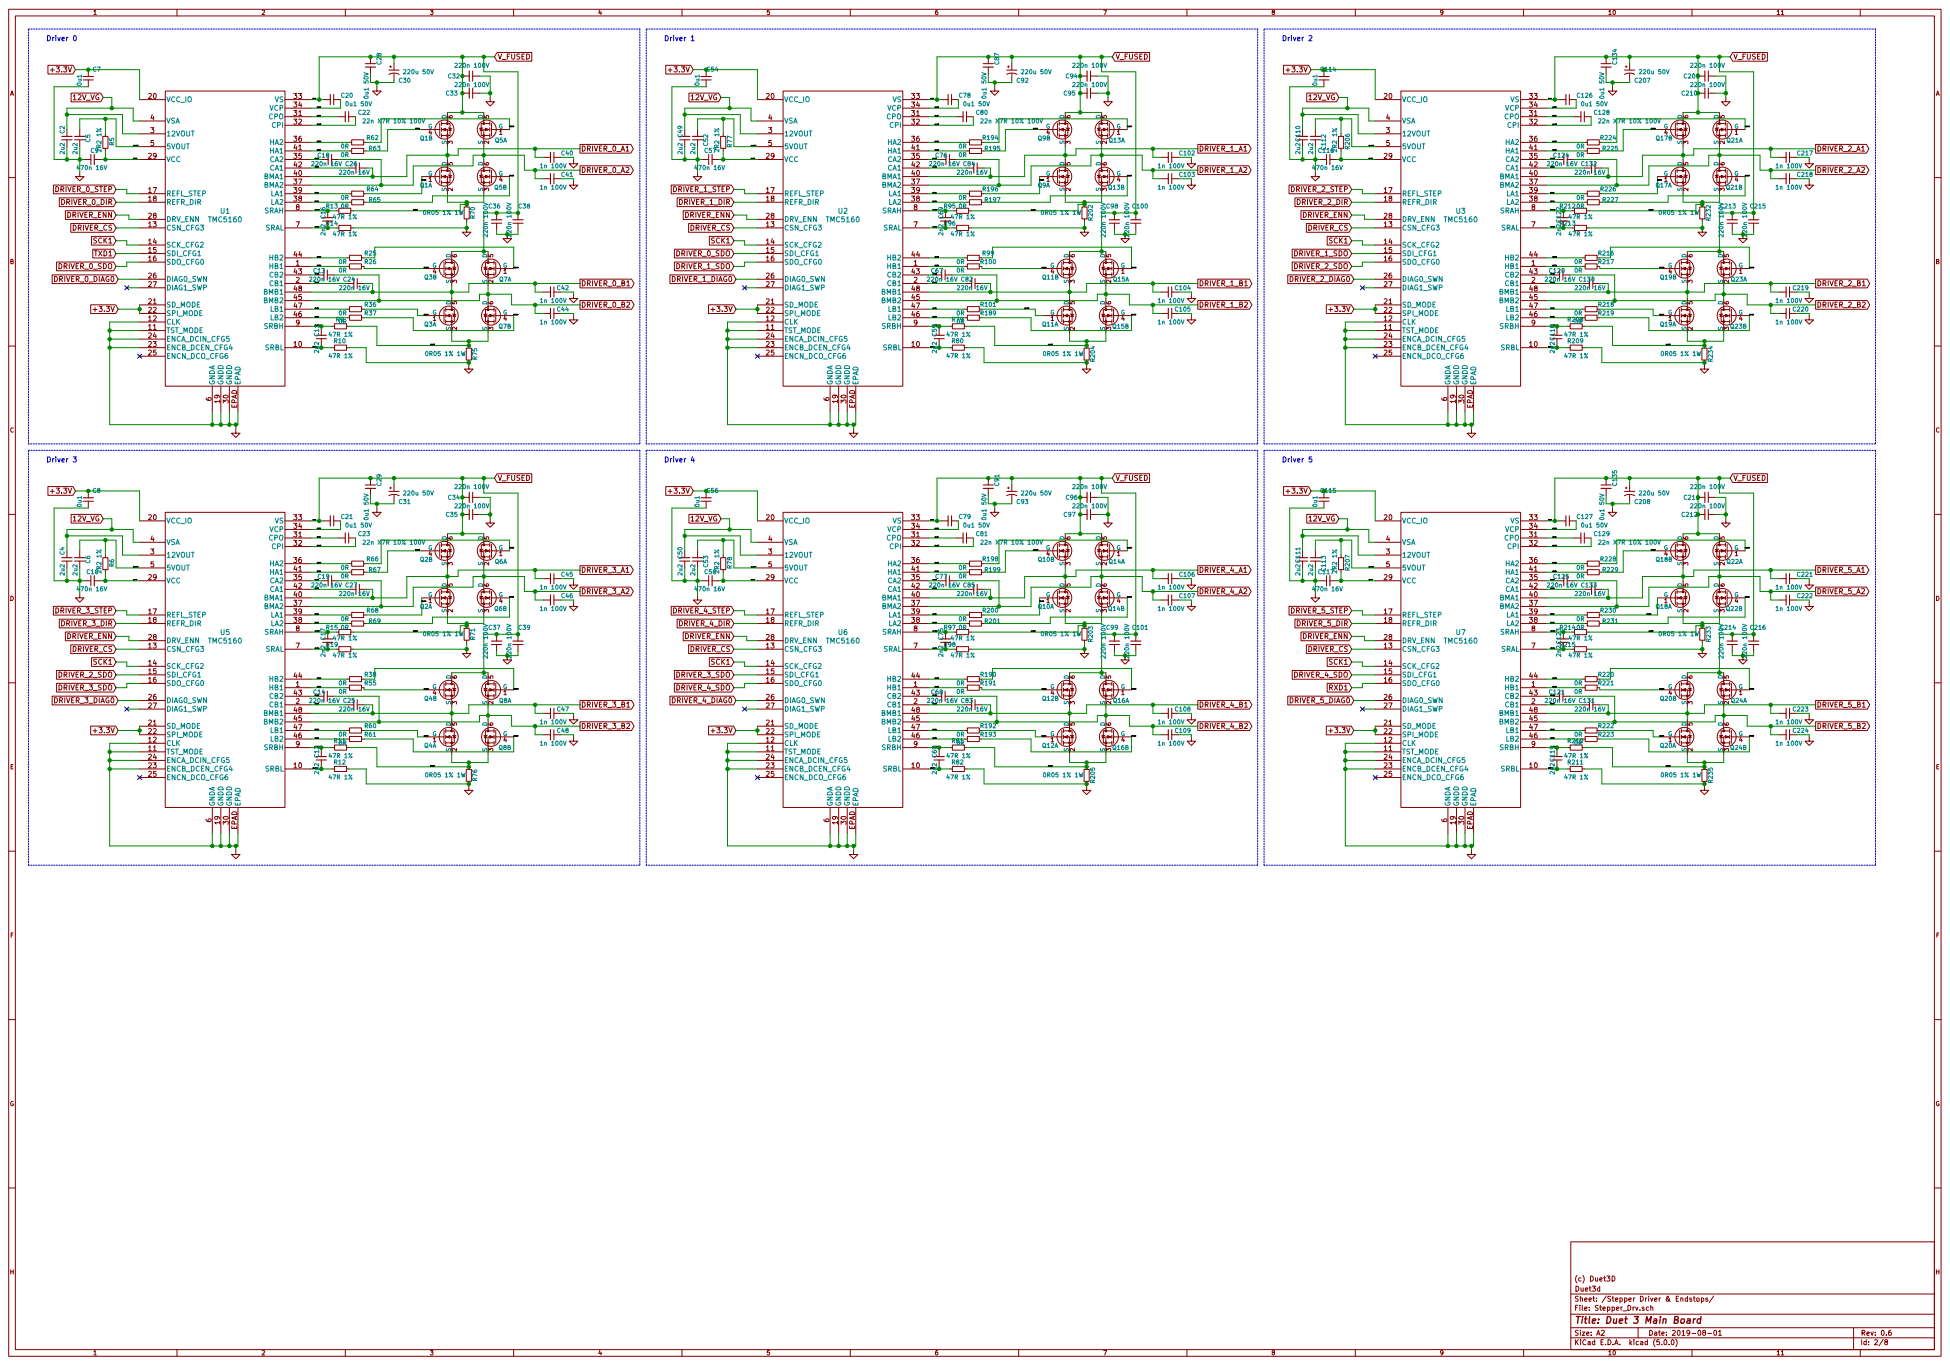
[picture p83: page 2]

6 SRAL 7 SRAH 8 SRBH 9 EPAD EPAD U1 TMC5160

6 SRAL 7 SRAH 8 SRBH 9 EPAD EPAD U2 TMC5160

6 SRAL 7 SRAH 8 SRBH 9 EPAD EPAD U5 TMC5160

6 SRAL 7 SRAH 8 SRBH 9 EPAD EPAD U6 TMC5160

(c) Duet3D
Sheet: /Stepper Driver & Endstops/ Duet3d

File: Stepper_Drv.sch
Id: 2/8 Title: Duet 3 Main Board

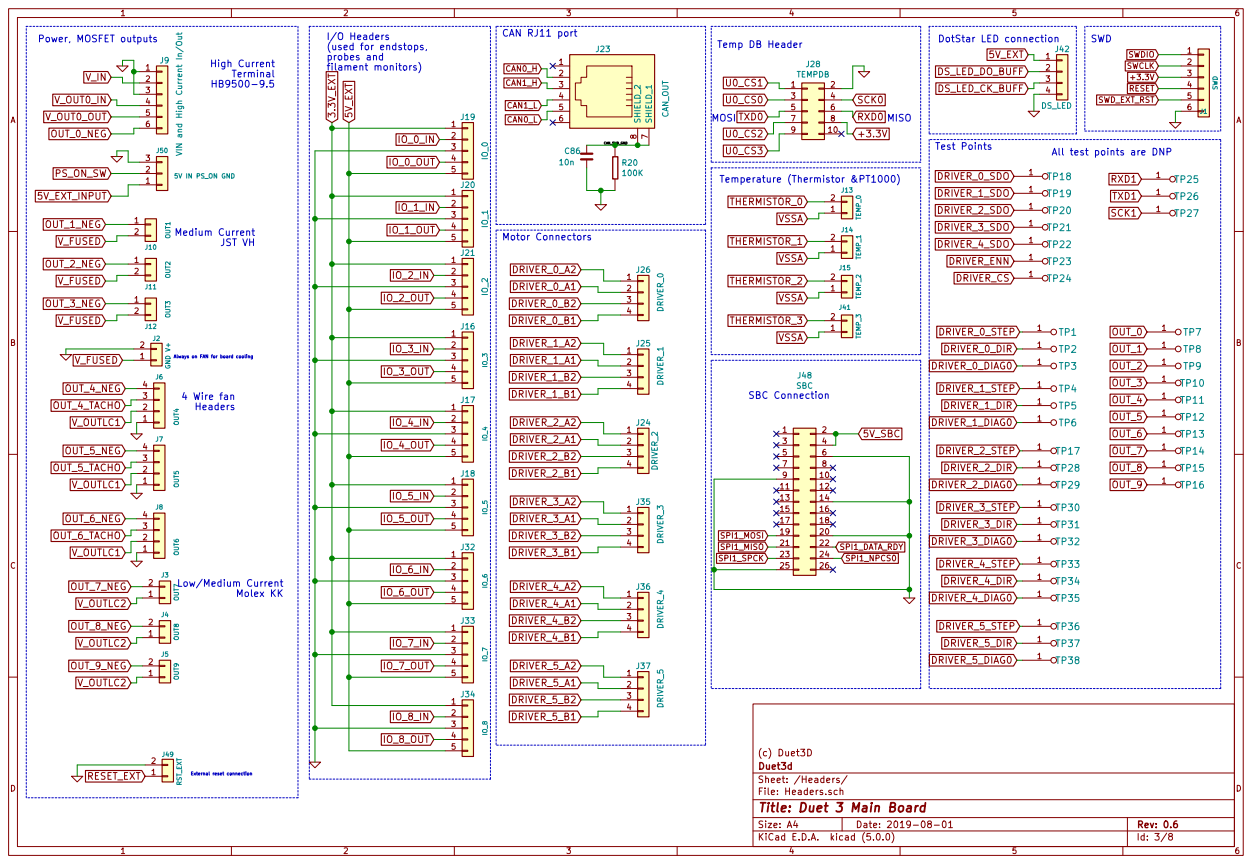
[picture p84: page 3]

J9 VIN and High Current In/Out OUT_0_NEG

All test points are DNP

Always on FAN for board cooling V_OUTLC2
V_FUSED

(c) Duet3D
File: Headers.sch Sheet: /Headers/ Duet3d

Id: 3/8 Title: Duet 3 Main Board

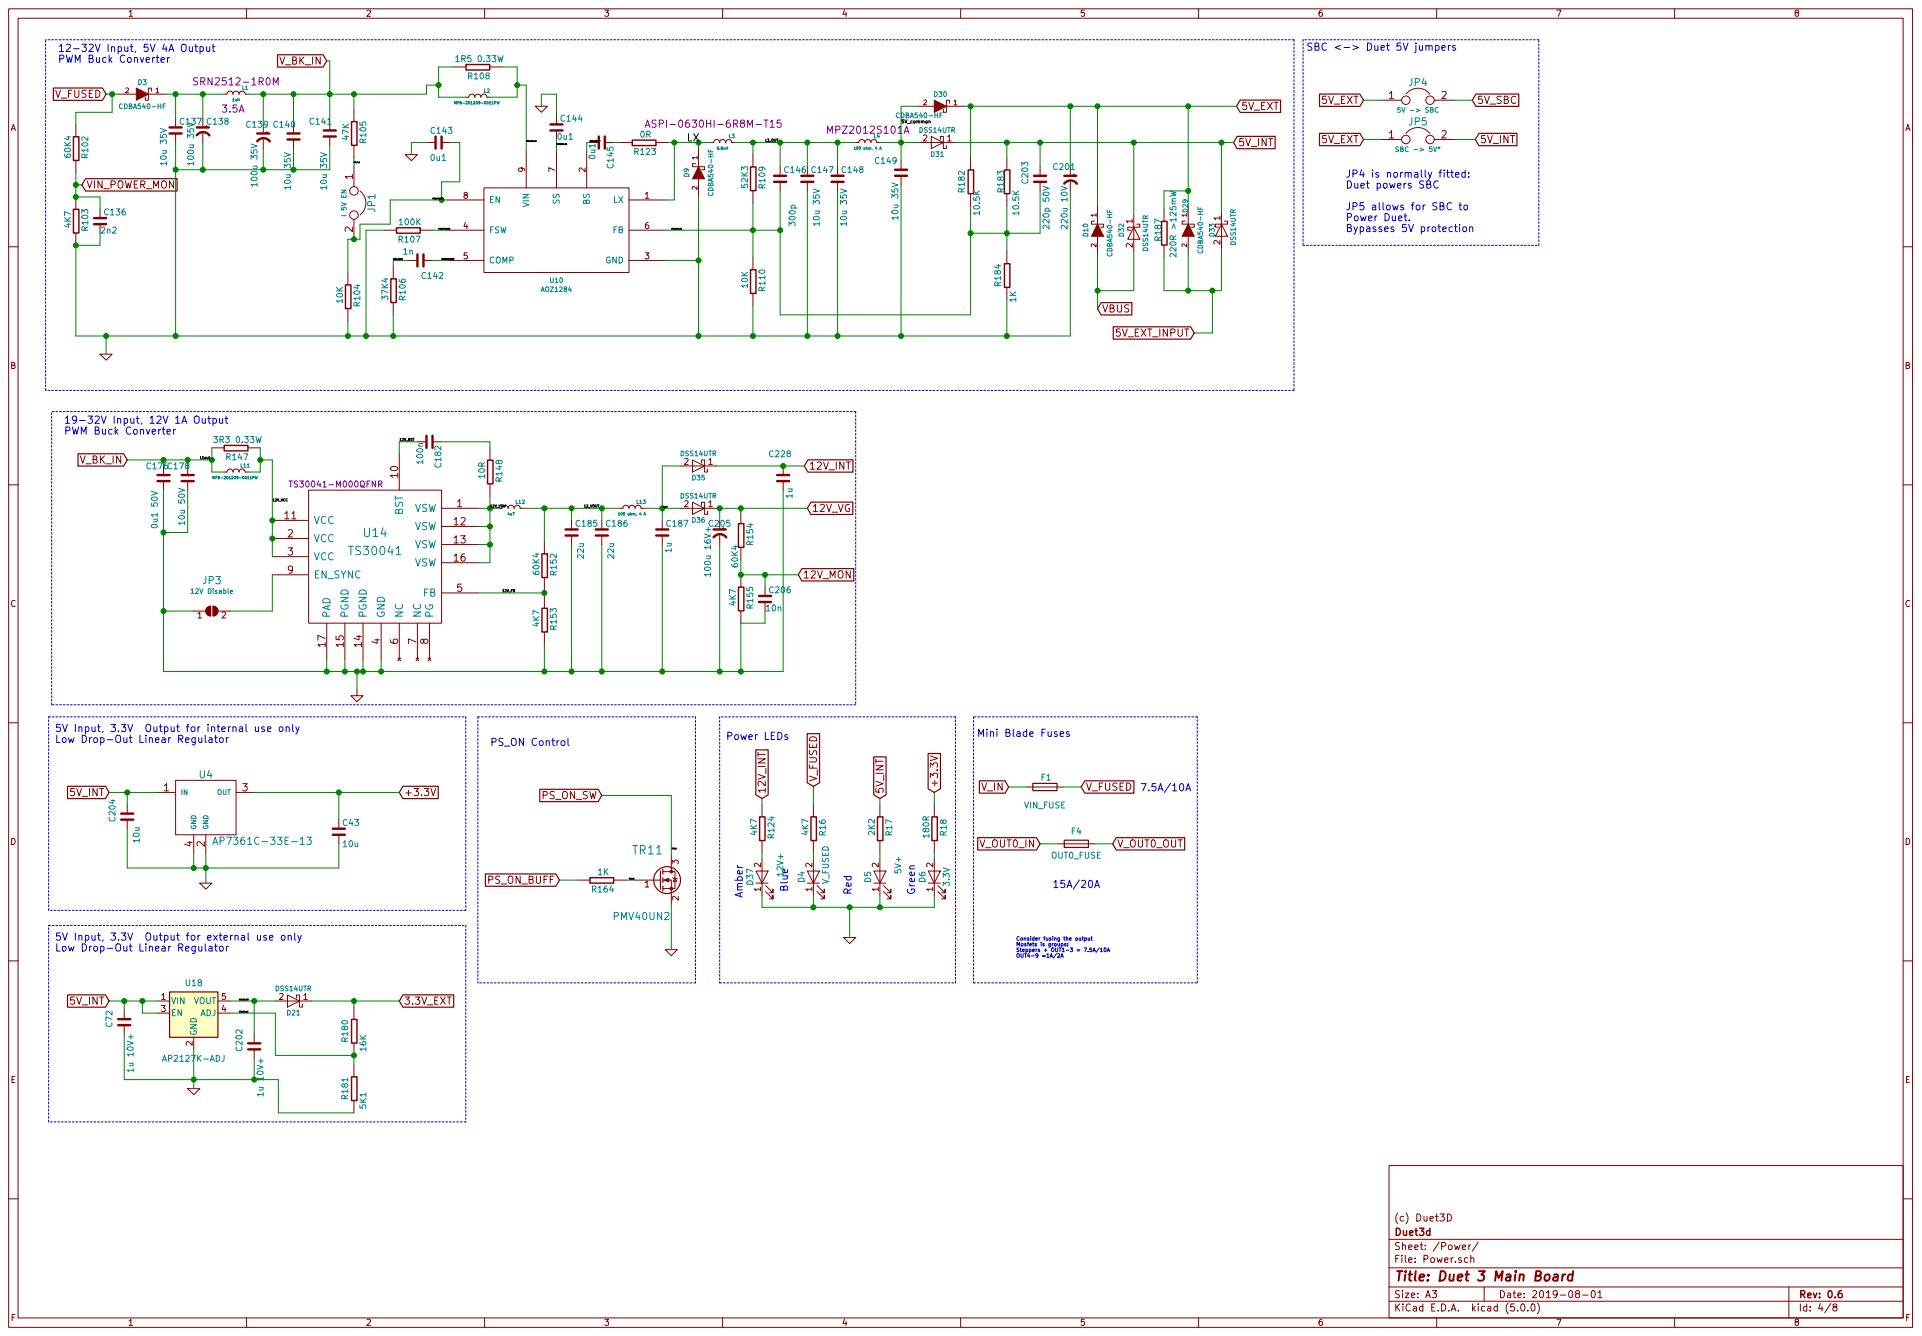
[picture p85: page 4]

2 GND 3 FSW 4 COMP 5 FB 6 SS

JP4 is normally fitted:
Duet powers SBC
JP5 allows for SBC to Power Duet. Bypasses 5V protection

5V Input, 3.3V Output for internal use only
Low Drop-Out Linear Regulator

Consider fusing the output Mosfets is groups: Steppers + OUT1-3 = 7.5A/10A OUT4-9 =1A/2A R164

5V Input, 3.3V Output for external use only

2 EN 3 ADJ 4 VOUT 5 U18 AP2127K-ADJ C72 1u 10V+ C202 1u 10V+ R180 16K R181 5K1

(c) Duet3D
File: Power.sch Sheet: /Power/ Duet3d

Id: 4/8 Title: Duet 3 Main Board

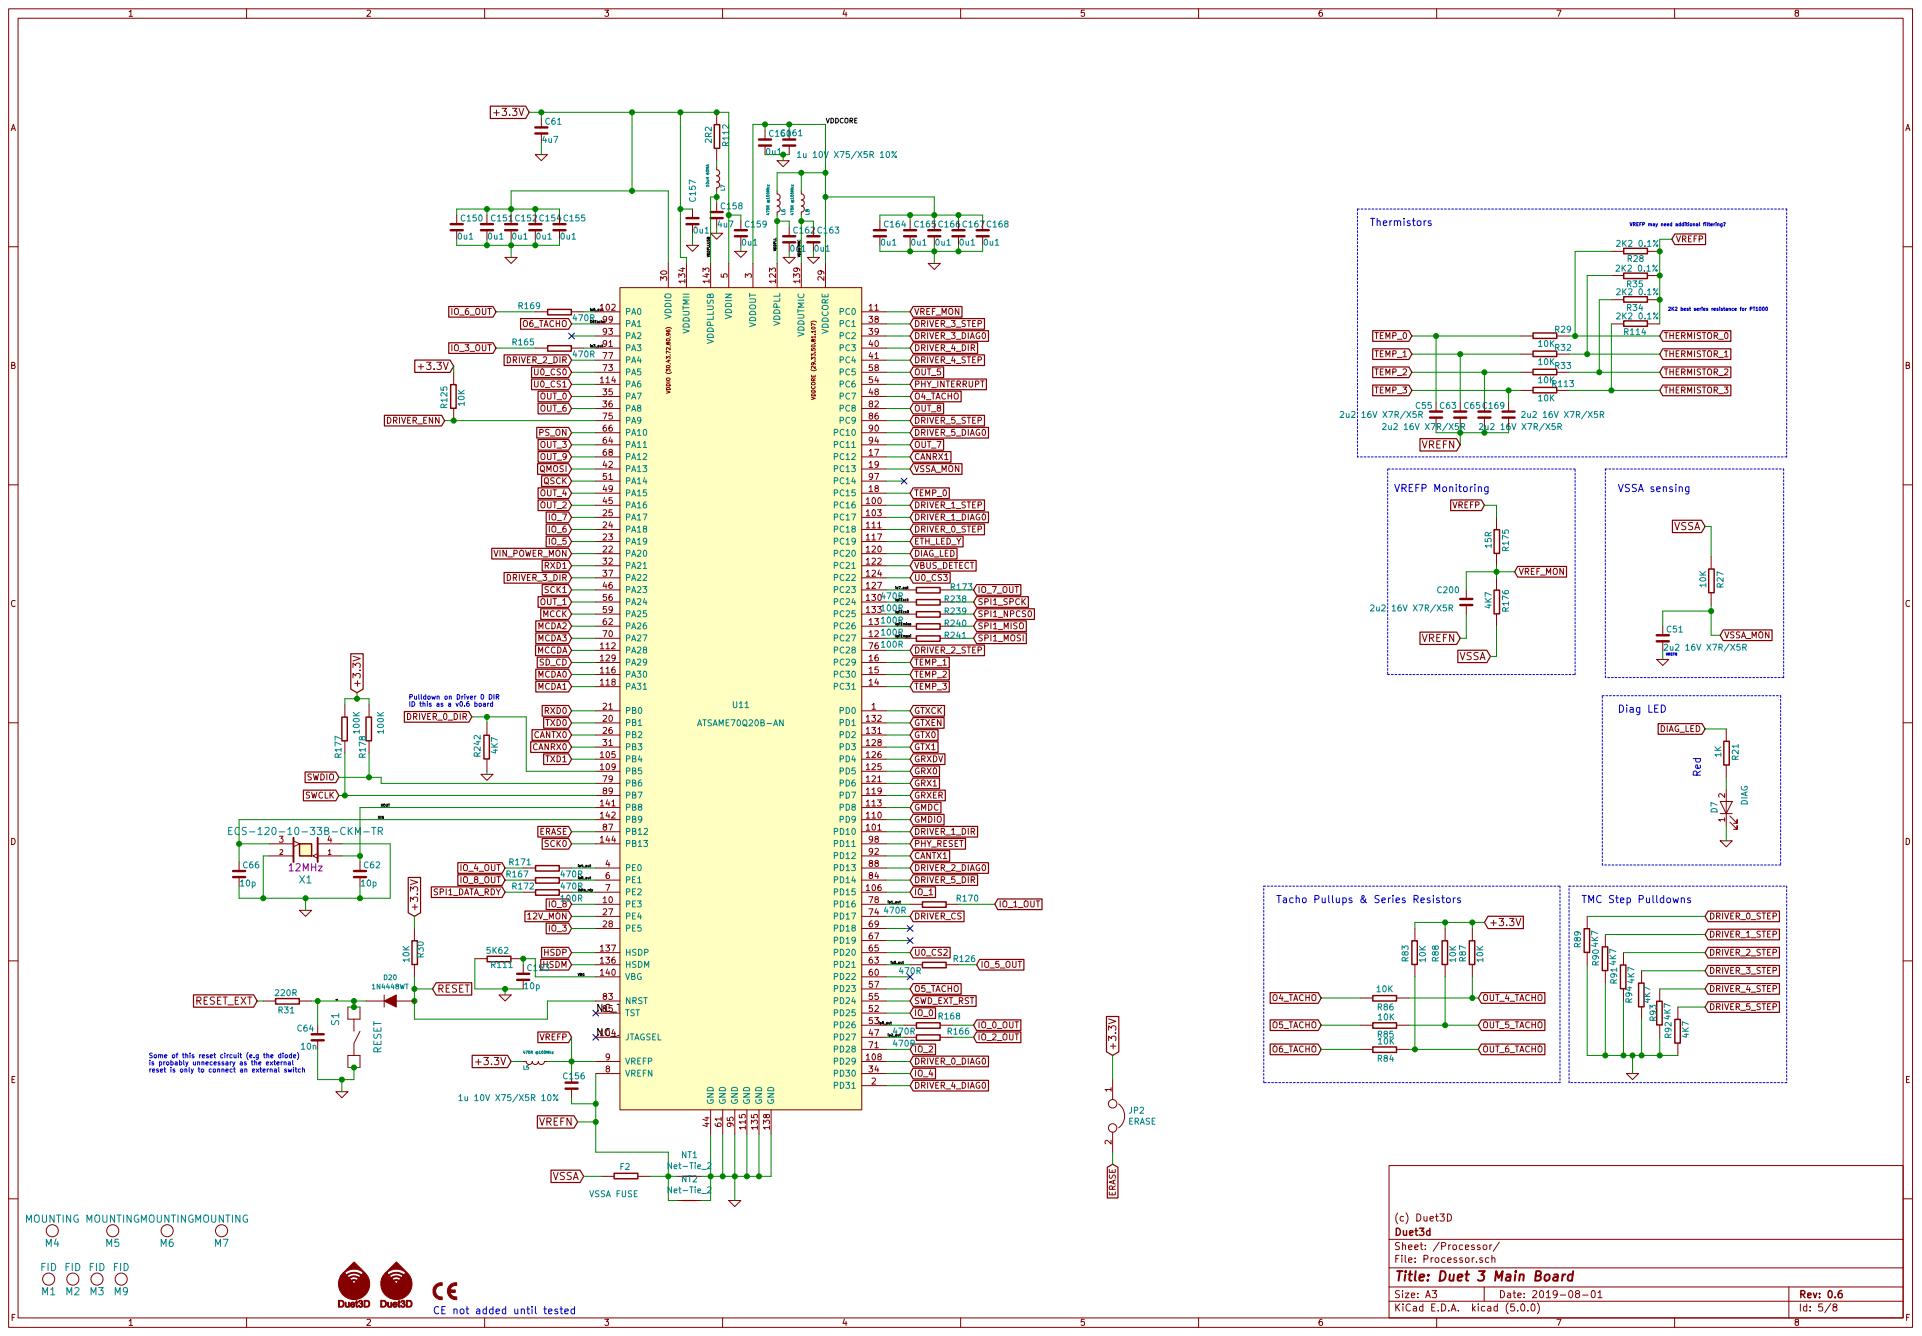
[picture p86: page 5]

Pulldown on Driver 0 DIR

1N4448WT Some of this reset circuit (e.g the diode)

(c) Duet3D
File: Processor.sch Sheet: /Processor/ Duet3d

Id: 5/8 Title: Duet 3 Main Board

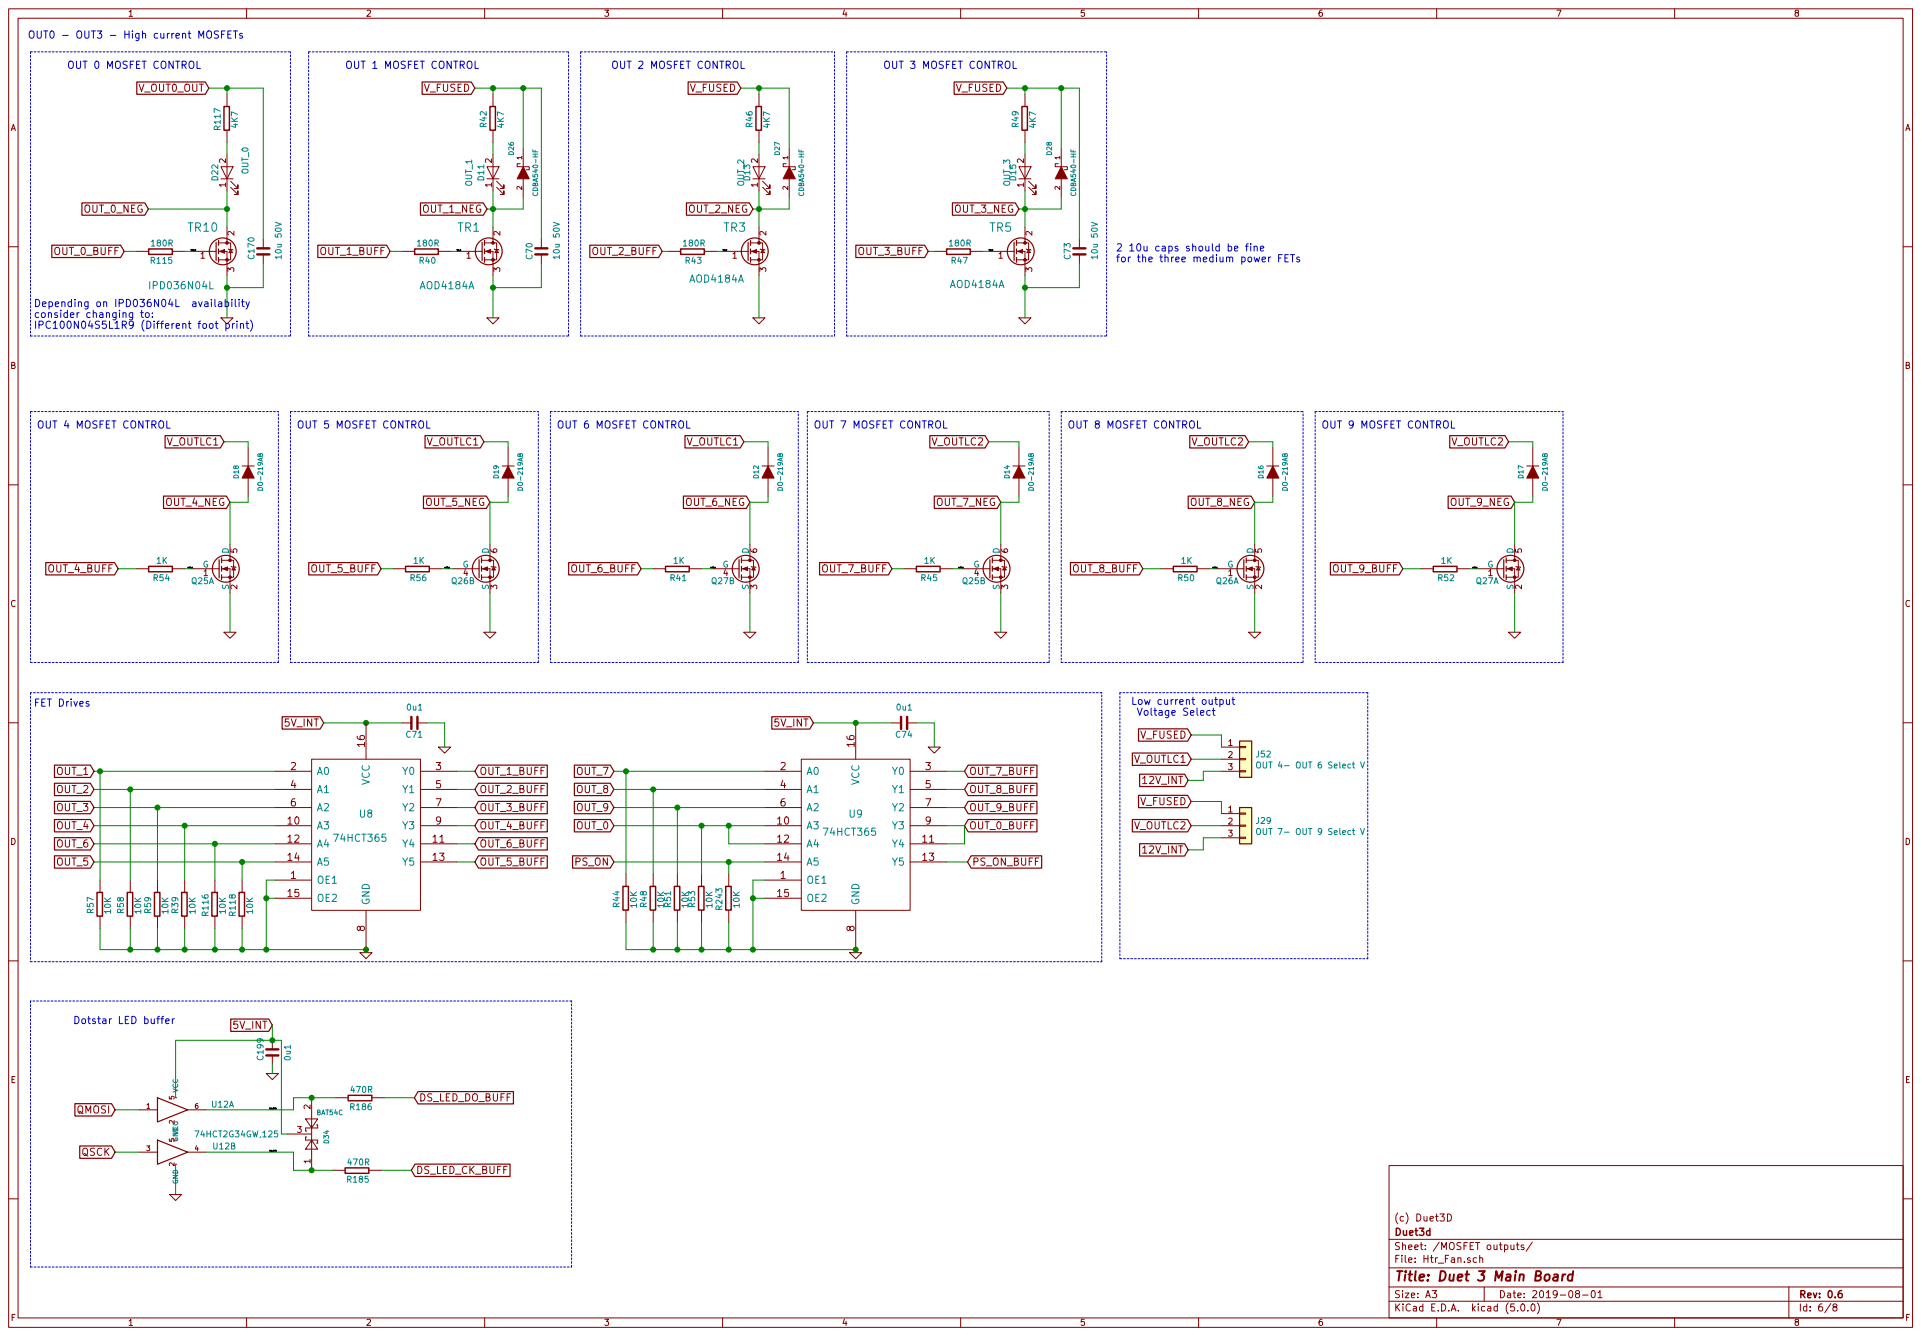
[picture p87: page 6]

2 10u caps should be fine
for the three medium power FETs

J29OUT 7- OUT 9 Select V Low current output
Voltage Select

File: Htr_Fan.sch
Id: 6/8 Title: Duet 3 Main Board

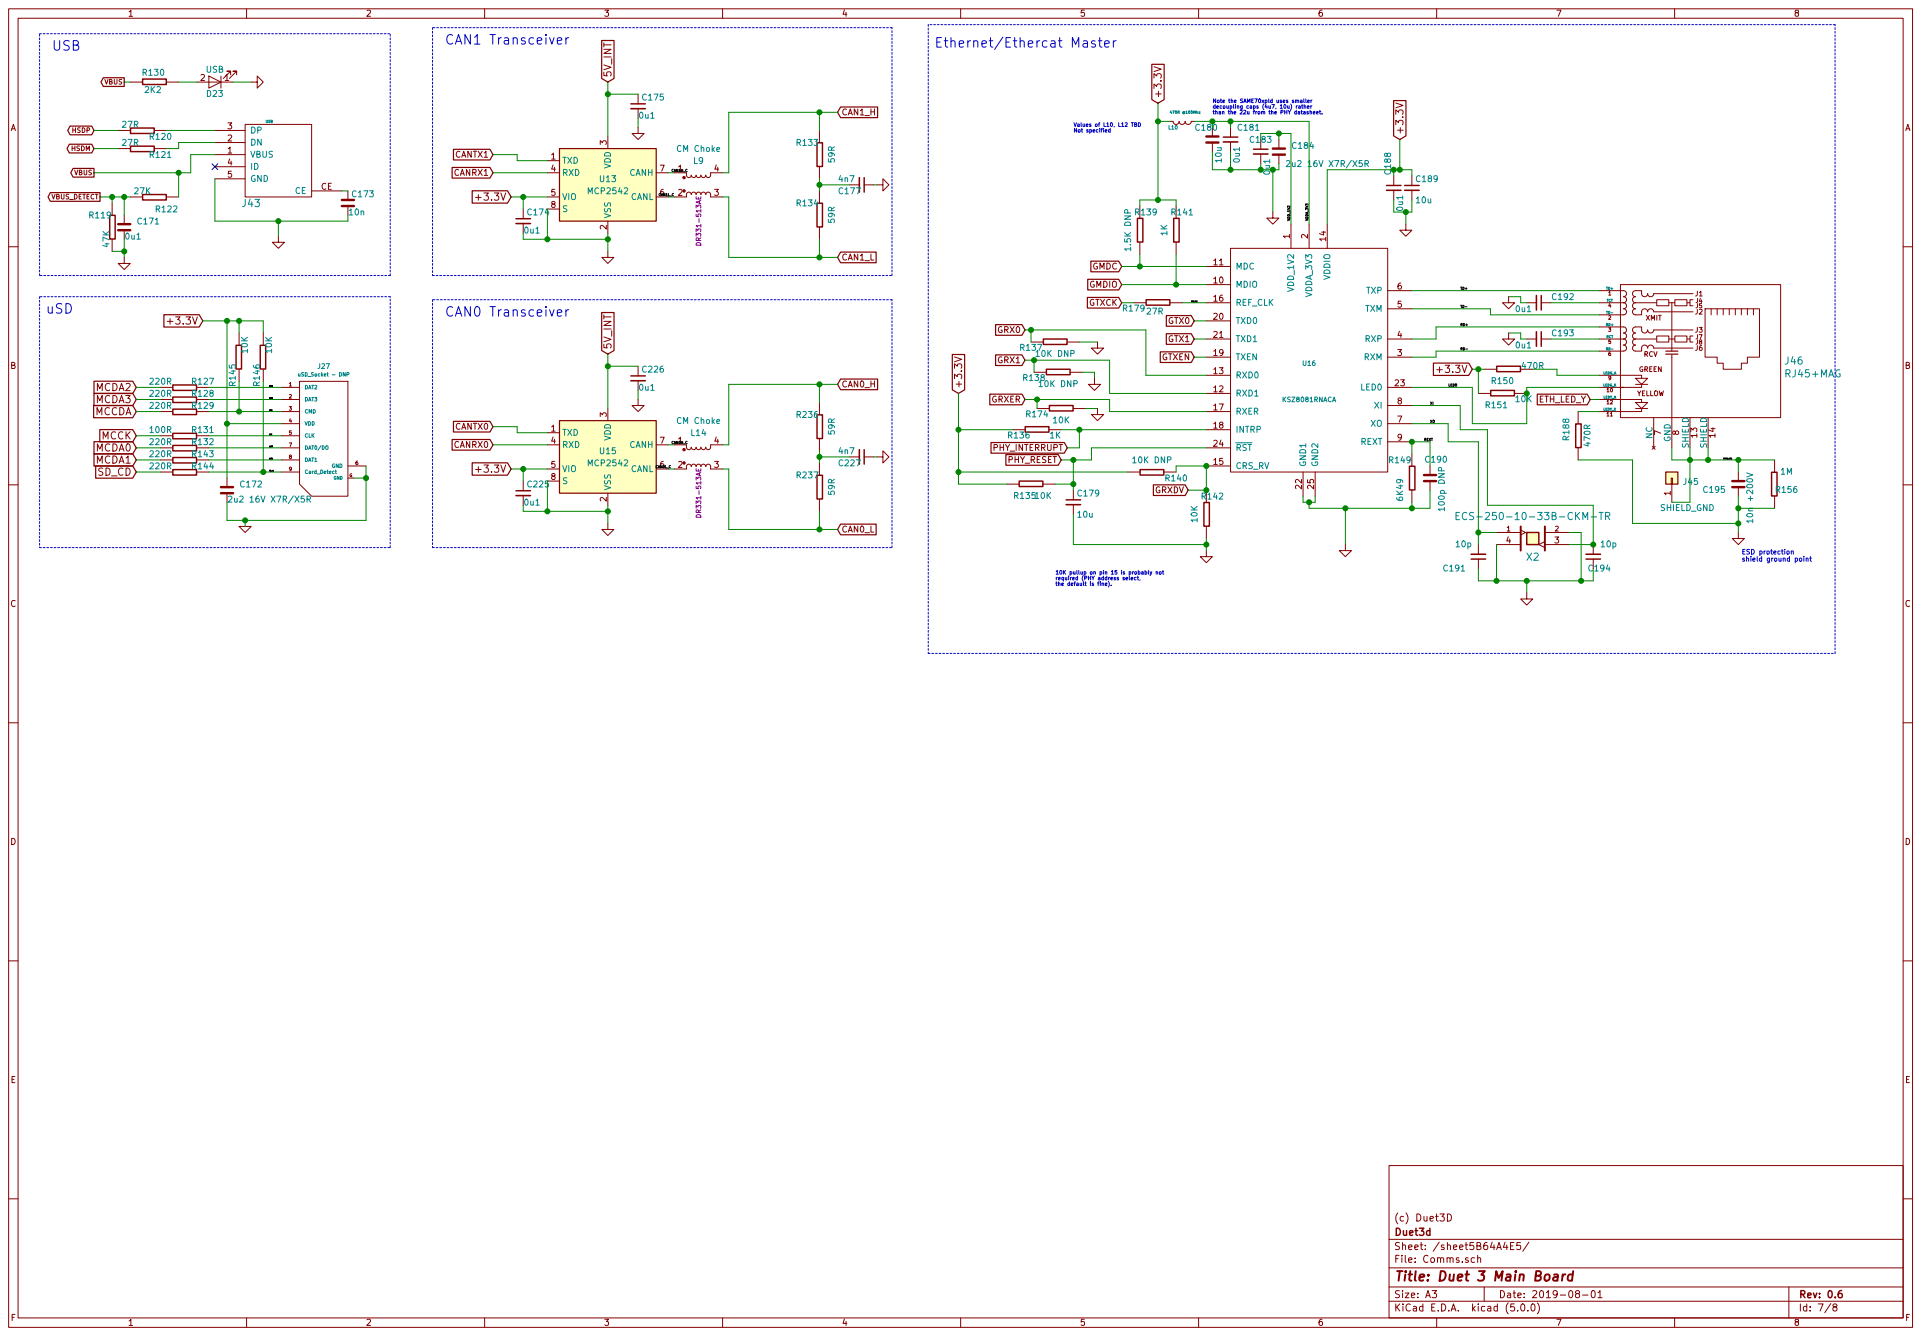
[picture p88: page 7]

CAN1 Transceiver

the default is fine). Ethernet/Ethercat Master

R130 2 2K2 | 1 D23 USB R121

Note the SAME70xpld uses smaller decoupling caps (4u7, 10u) rather

than the 22u from the PHY datasheet.

3 RXD 4 VIO 5 CANL 6 CANH 7 S

1 MDIO 10 MDC 11 RXD1 12 RXD0 13 VDDIO 14 CRS_RV 15 REF_CLK 16 RXER 17

RD- RD+ TD- TD+ REXTXI XO

10K pullup on pin 15 is probably not required (PHY address select,

(c) Duet3D
File: Comms.sch Sheet: /sheet5B64A4E5/ Duet3d

Id: 7/8 Title: Duet 3 Main Board

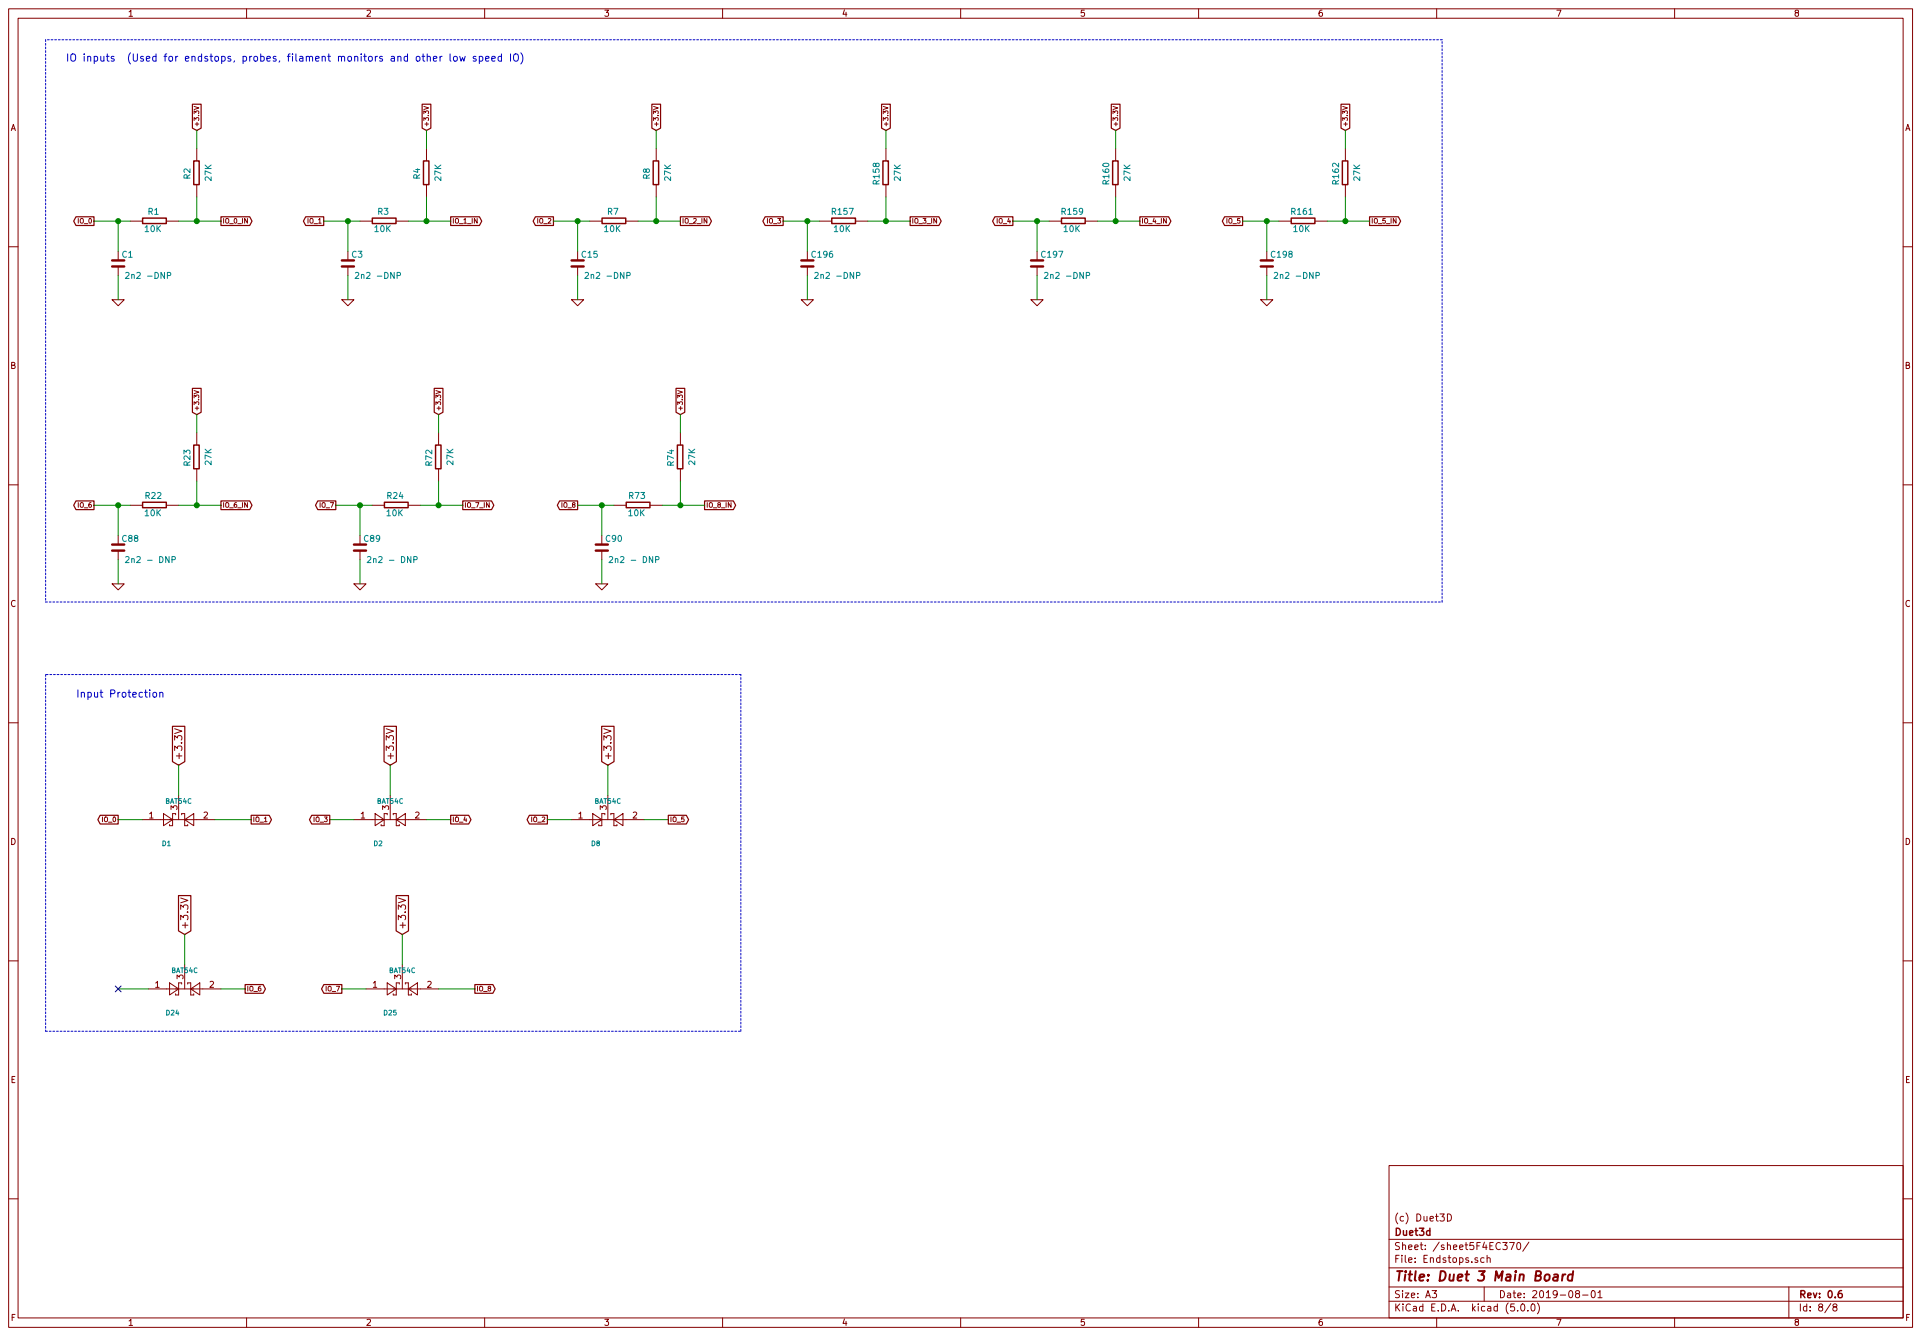
[picture p89: page 8]

File: Endstops.sch Sheet: /sheet5F4EC370/ Duet3d

Id: 8/8 Title: Duet 3 Main Board
