ReadHeadRedemption/SeniorDesignSp26Su26/Hardware/KiCAD files/reference schematics/Senior design/Duet3-Mainboard-6HC-master/Duet3_Mainboard_6HC_v1.0/Duet3_MB_schematic_v1.0.pdf

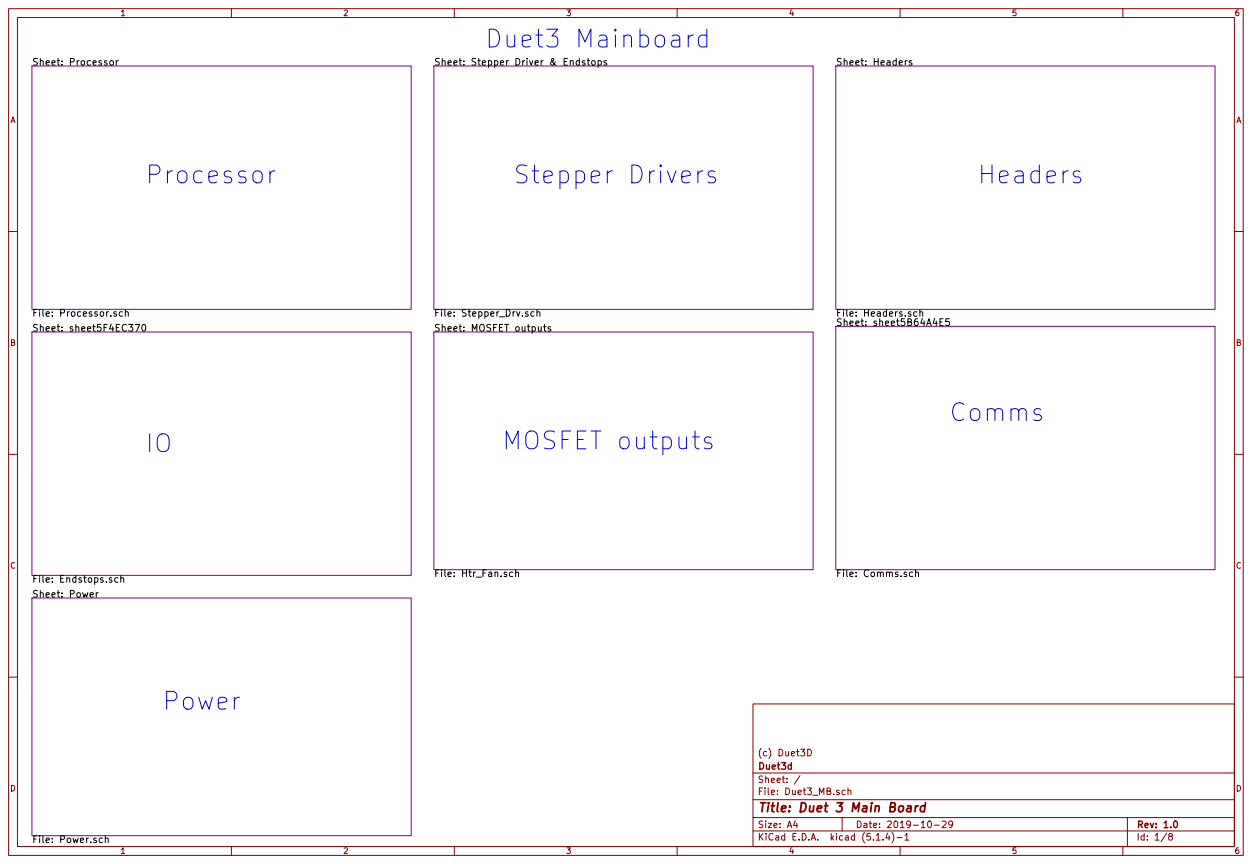
[picture p90: page 1]

Sheet: Headers File: Headers.sch Sheet: Power File: Power.sch

Sheet: Stepper Driver & Endstops

Id: 1/8 Title: Duet 3 Main Board

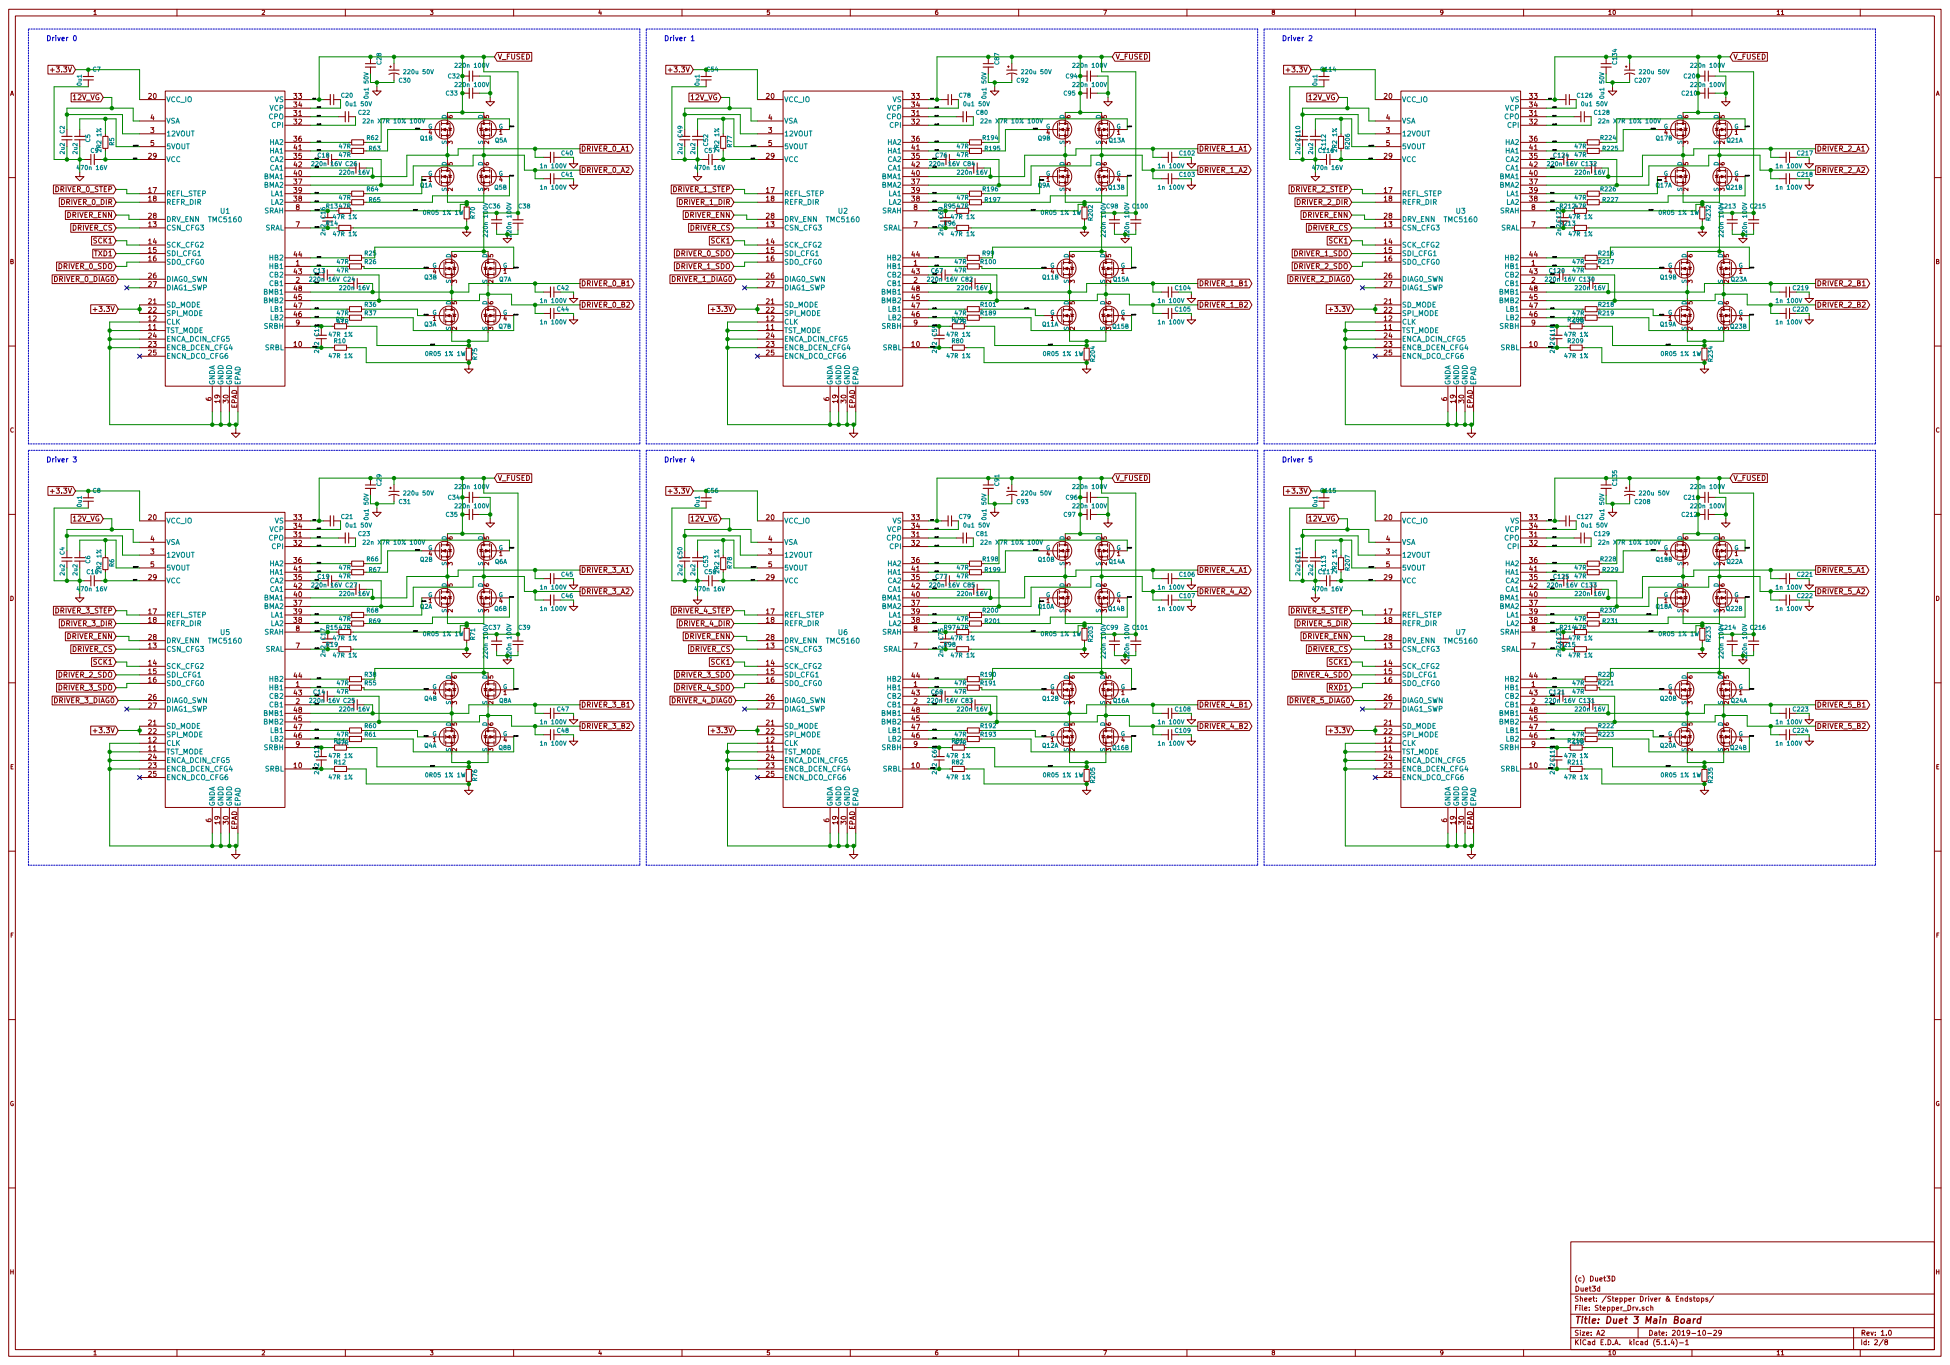
[picture p91: page 2]

6 SRAL 7 SRAH 8 SRBH 9 EPAD EPAD U5 TMC5160 C6 2u2 R62

6 SRAL 7 SRAH 8 SRBH 9 EPAD EPAD U1 TMC5160 C5 2u2 C9

6 SRAL 7 SRAH 8 SRBH 9 EPAD EPAD U6 TMC5160

(c) Duet3D
Sheet: /Stepper Driver & Endstops/ Duet3d

File: Stepper_Drv.sch
Id: 2/8 Title: Duet 3 Main Board

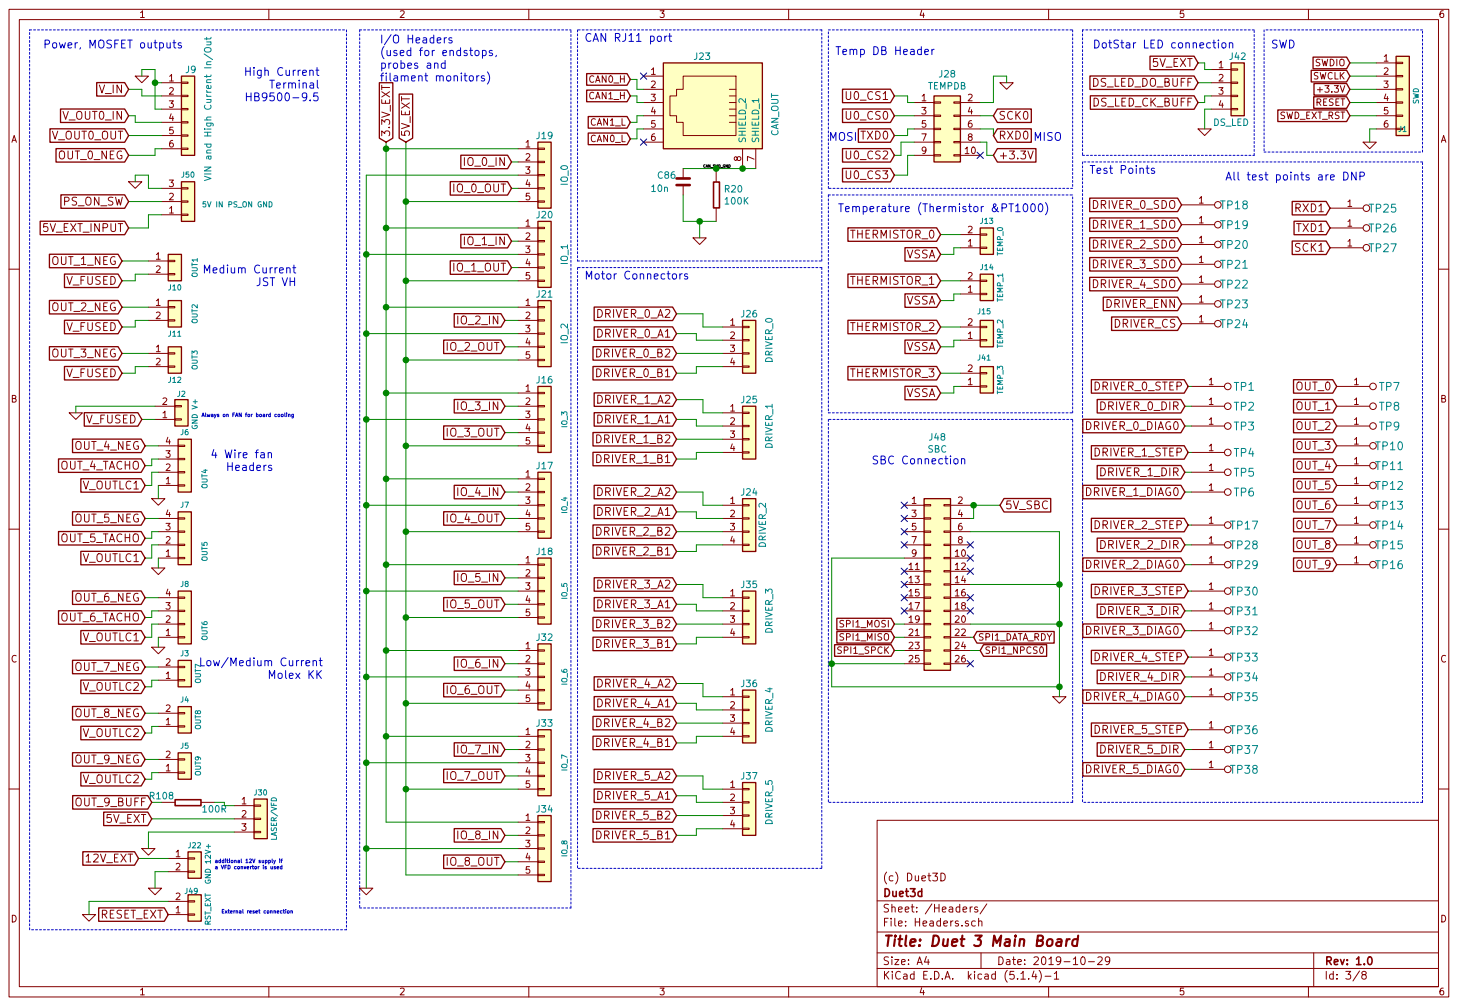
[picture p92: page 3]

High Current Terminal HB9500-9.5 Medium Current

IO_2_OUT
4 Wire fan Headers Low/Medium Current Molex KK

Always on FAN for board cooling

additional 12V supply if a VFD convertor is used

(c) Duet3D
File: Headers.sch Sheet: /Headers/ Duet3d

Id: 3/8 Title: Duet 3 Main Board

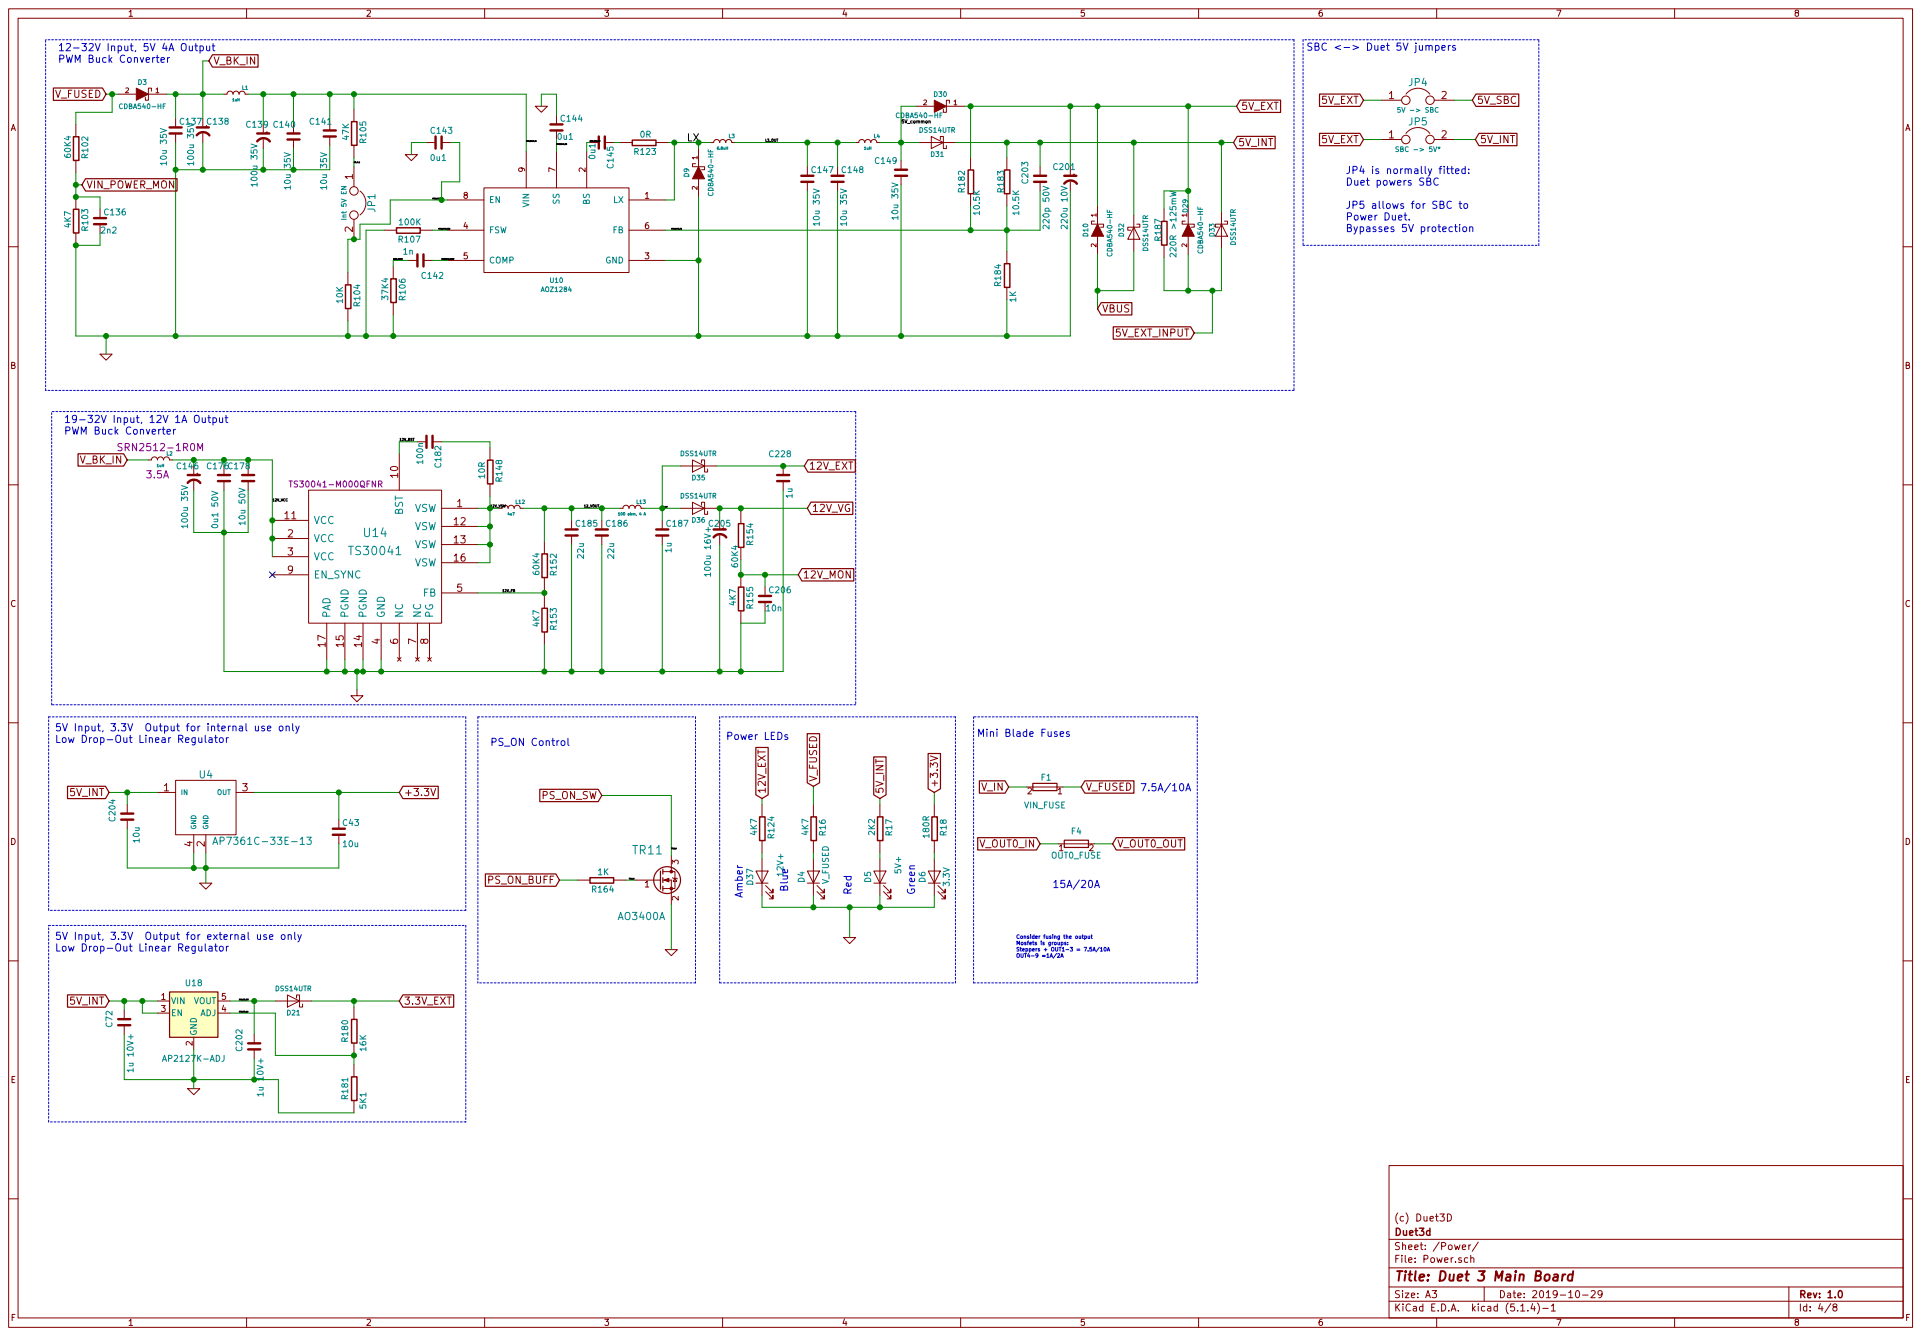
[picture p93: page 4]

SBC <-> Duet 5V jumpers Mini Blade Fuses

2 EN 3 ADJ 4 VOUT 5 U18 AP2127K-ADJ R105 47K R104 10K

2 GND 3 FSW 4 COMP 5 FB 6 SS

JP5 allows for SBC to Power Duet. Bypasses 5V protection

Low Drop-Out Linear Regulator

5V Input, 3.3V Output for external use only

Consider fusing the output Mosfets is groups: Steppers + OUT1-3 = 7.5A/10A OUT4-9 =1A/2A

(c) Duet3D
File: Power.sch Sheet: /Power/ Duet3d

Id: 4/8 Title: Duet 3 Main Board

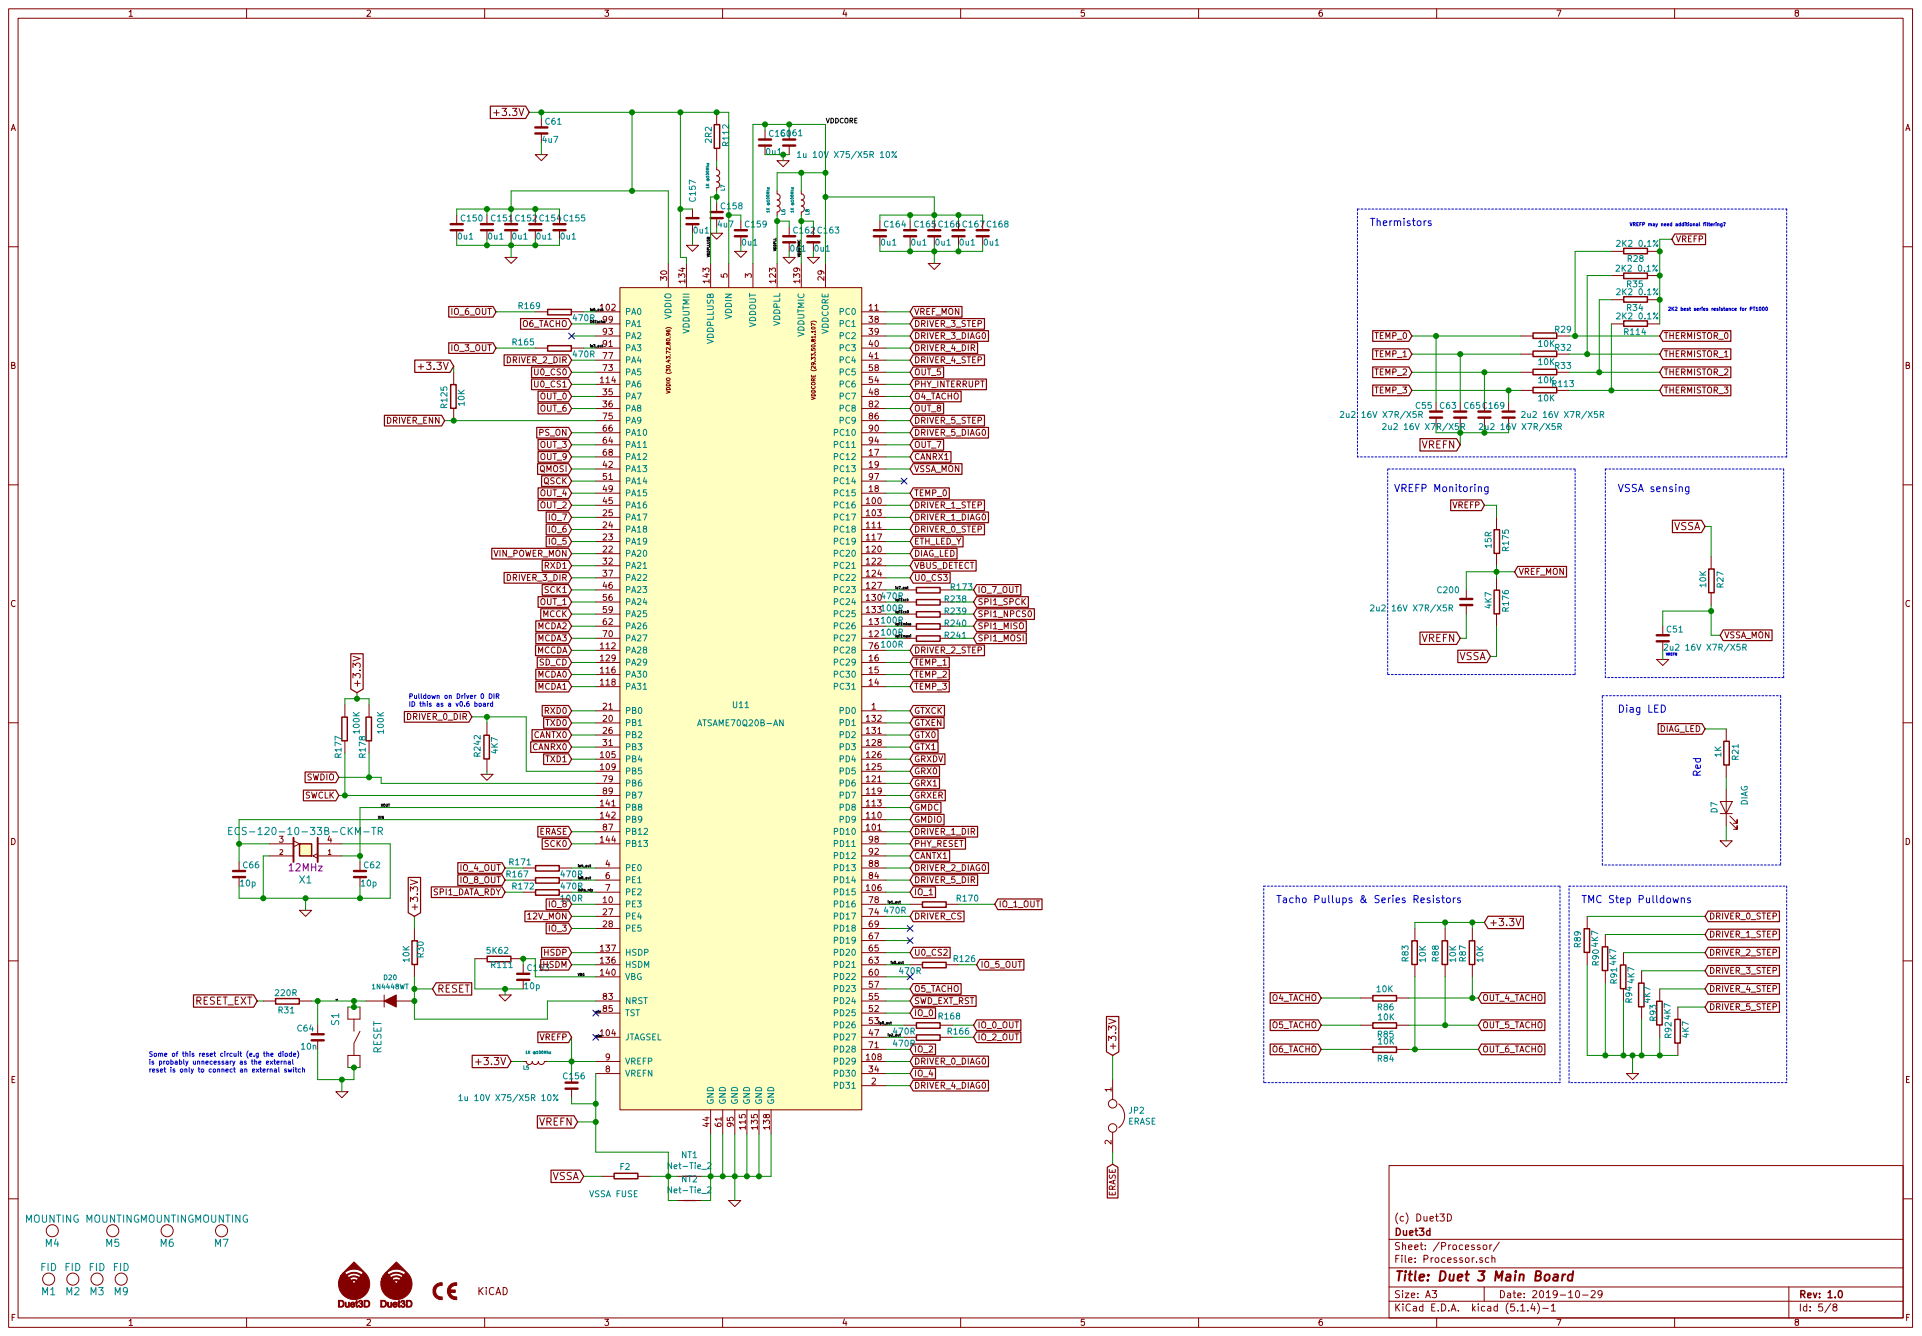
[picture p94: page 5]

VREFP may need additional filtering?
THERMISTOR_2 VREFP
THERMISTOR_0VSSA_MON VSSA

Pulldown on Driver 0 DIR
ID this as a v0.6 board
IO_1_OUT DRIVER_0_DIR

Tacho Pullups & Series Resistors

Some of this reset circuit (e.g the diode)

(c) Duet3D
File: Processor.sch Sheet: /Processor/ Duet3d

Id: 5/8 Title: Duet 3 Main Board

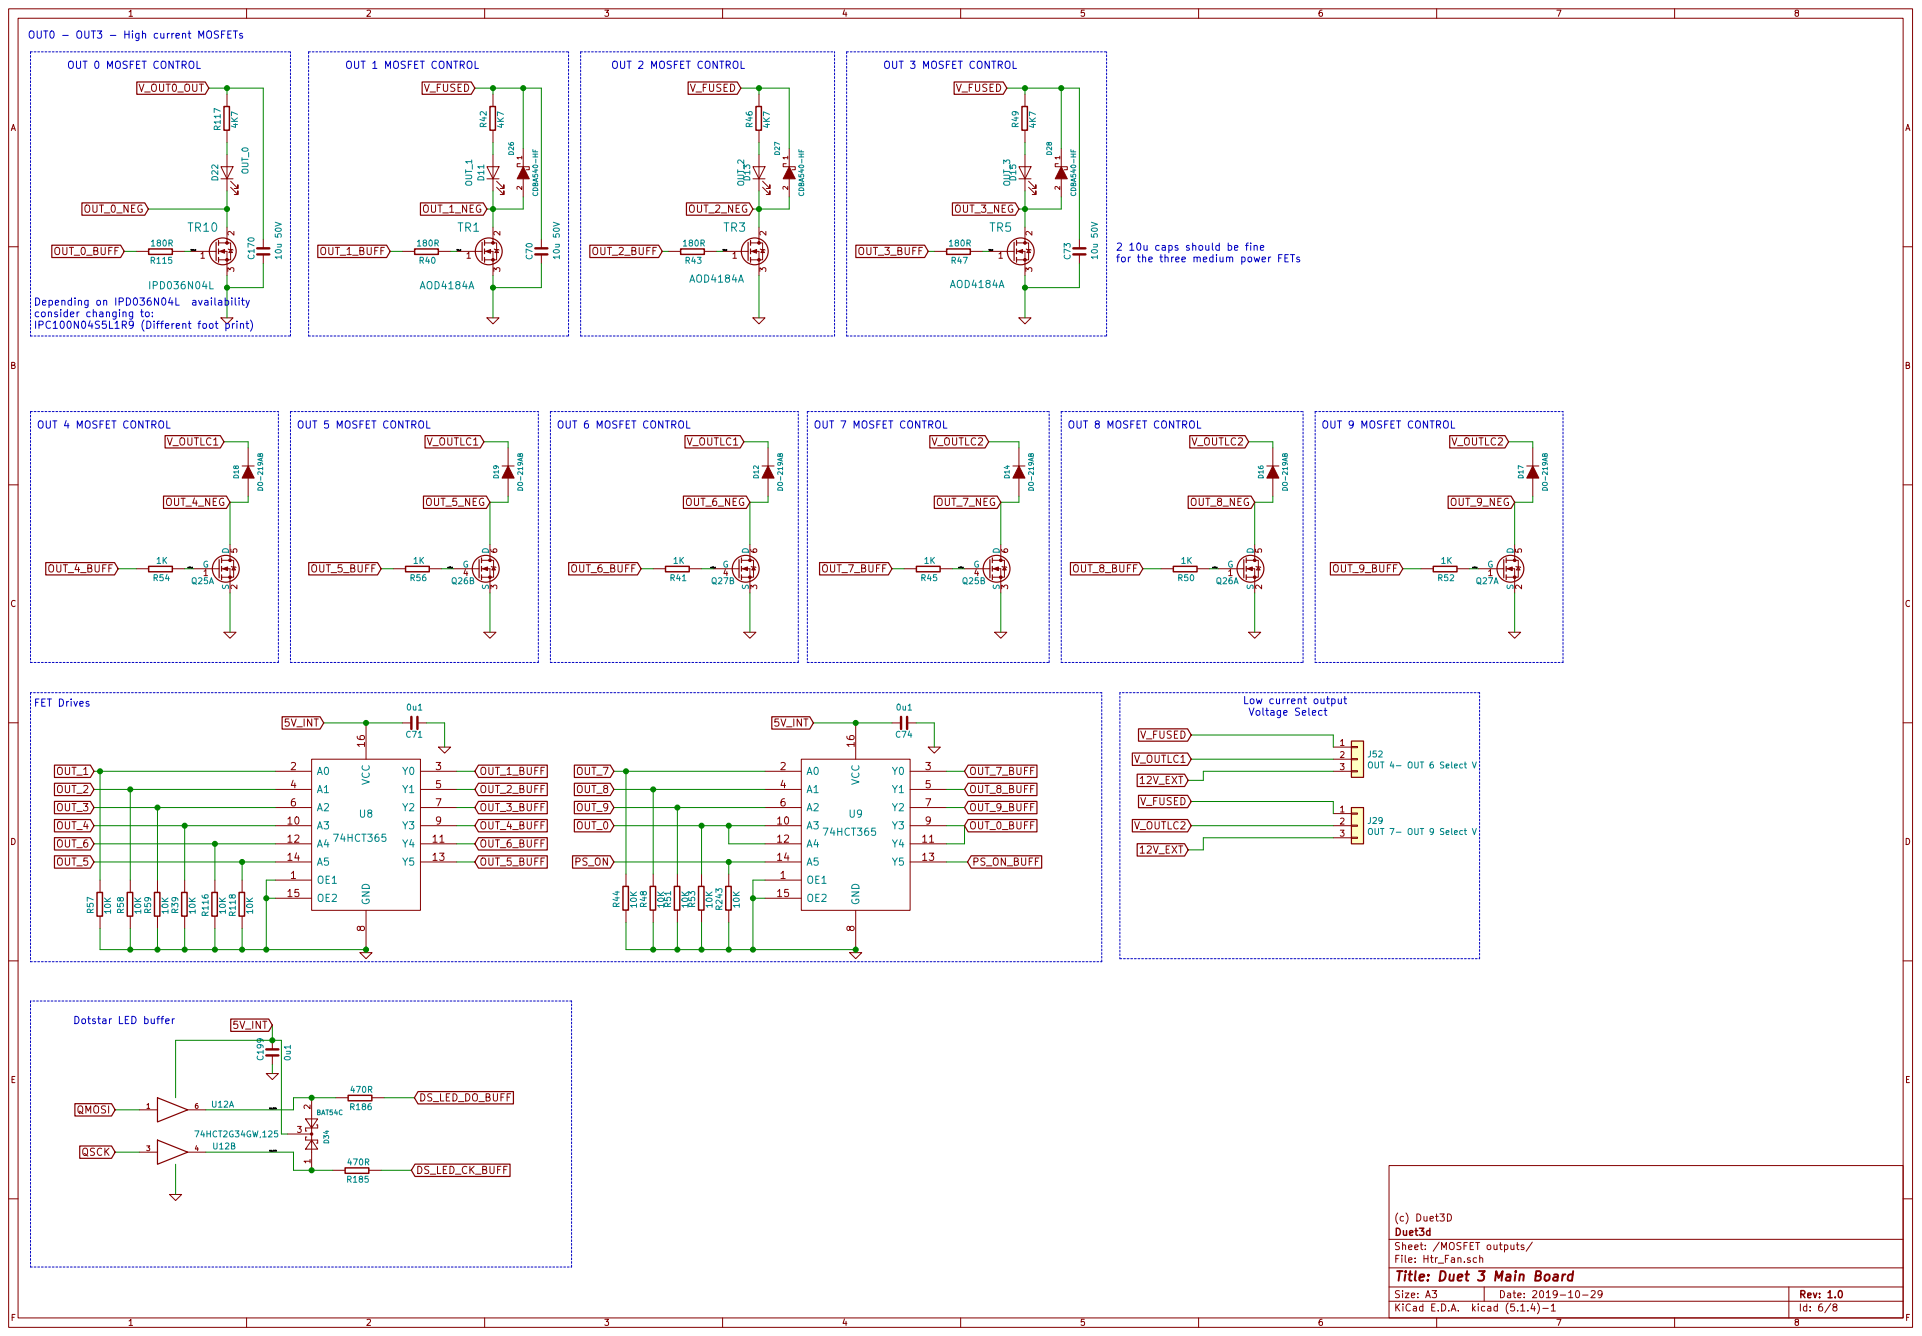
[picture p95: page 6]

OUT 1 MOSFET CONTROL FET Drives

2 10u caps should be fine
for the three medium power FETs

File: Htr_Fan.sch
Id: 6/8 Title: Duet 3 Main Board

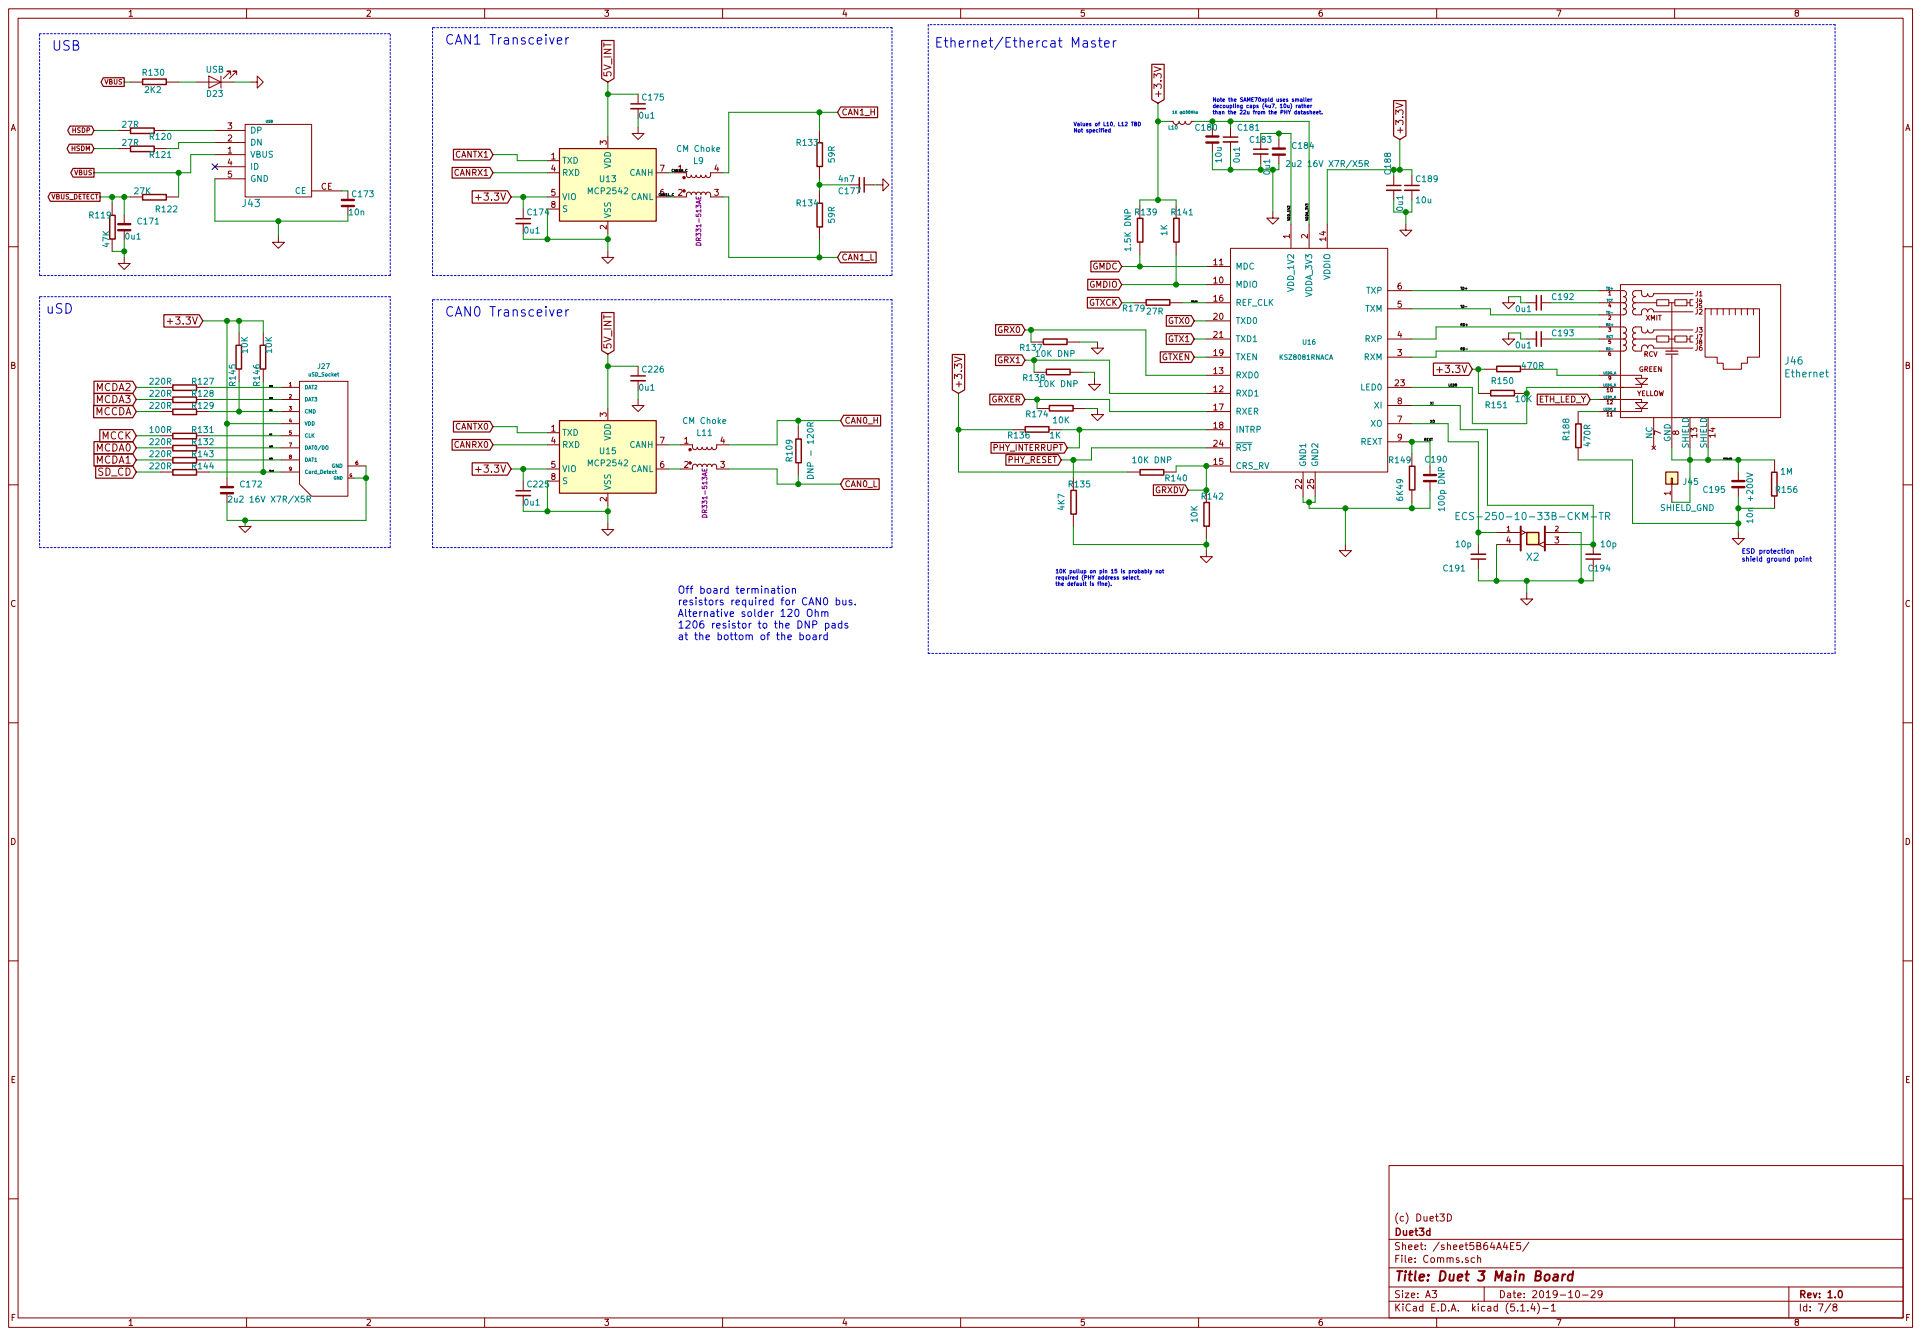
[picture p96: page 7]

the default is fine). CAN1 Transceiver

shield ground point USB

than the 22u from the PHY datasheet. Ethernet/Ethercat Master

Note the SAME70xpld uses smaller decoupling caps (4u7, 10u) rather

3 RXD 4 VIO 5 CANL 6 CANH 7 S

1 MDIO 10 MDC 11 RXD1 12 RXD0 13 VDDIO 14 CRS_RV 15 REF_CLK 16 RXER 17

Off board termination
resistors required for CAN0 bus.
Alternative solder 120 Ohm
1206 resistor to the DNP pads at the bottom of the board

(c) Duet3D
File: Comms.sch Sheet: /sheet5B64A4E5/ Duet3d

Id: 7/8 Title: Duet 3 Main Board

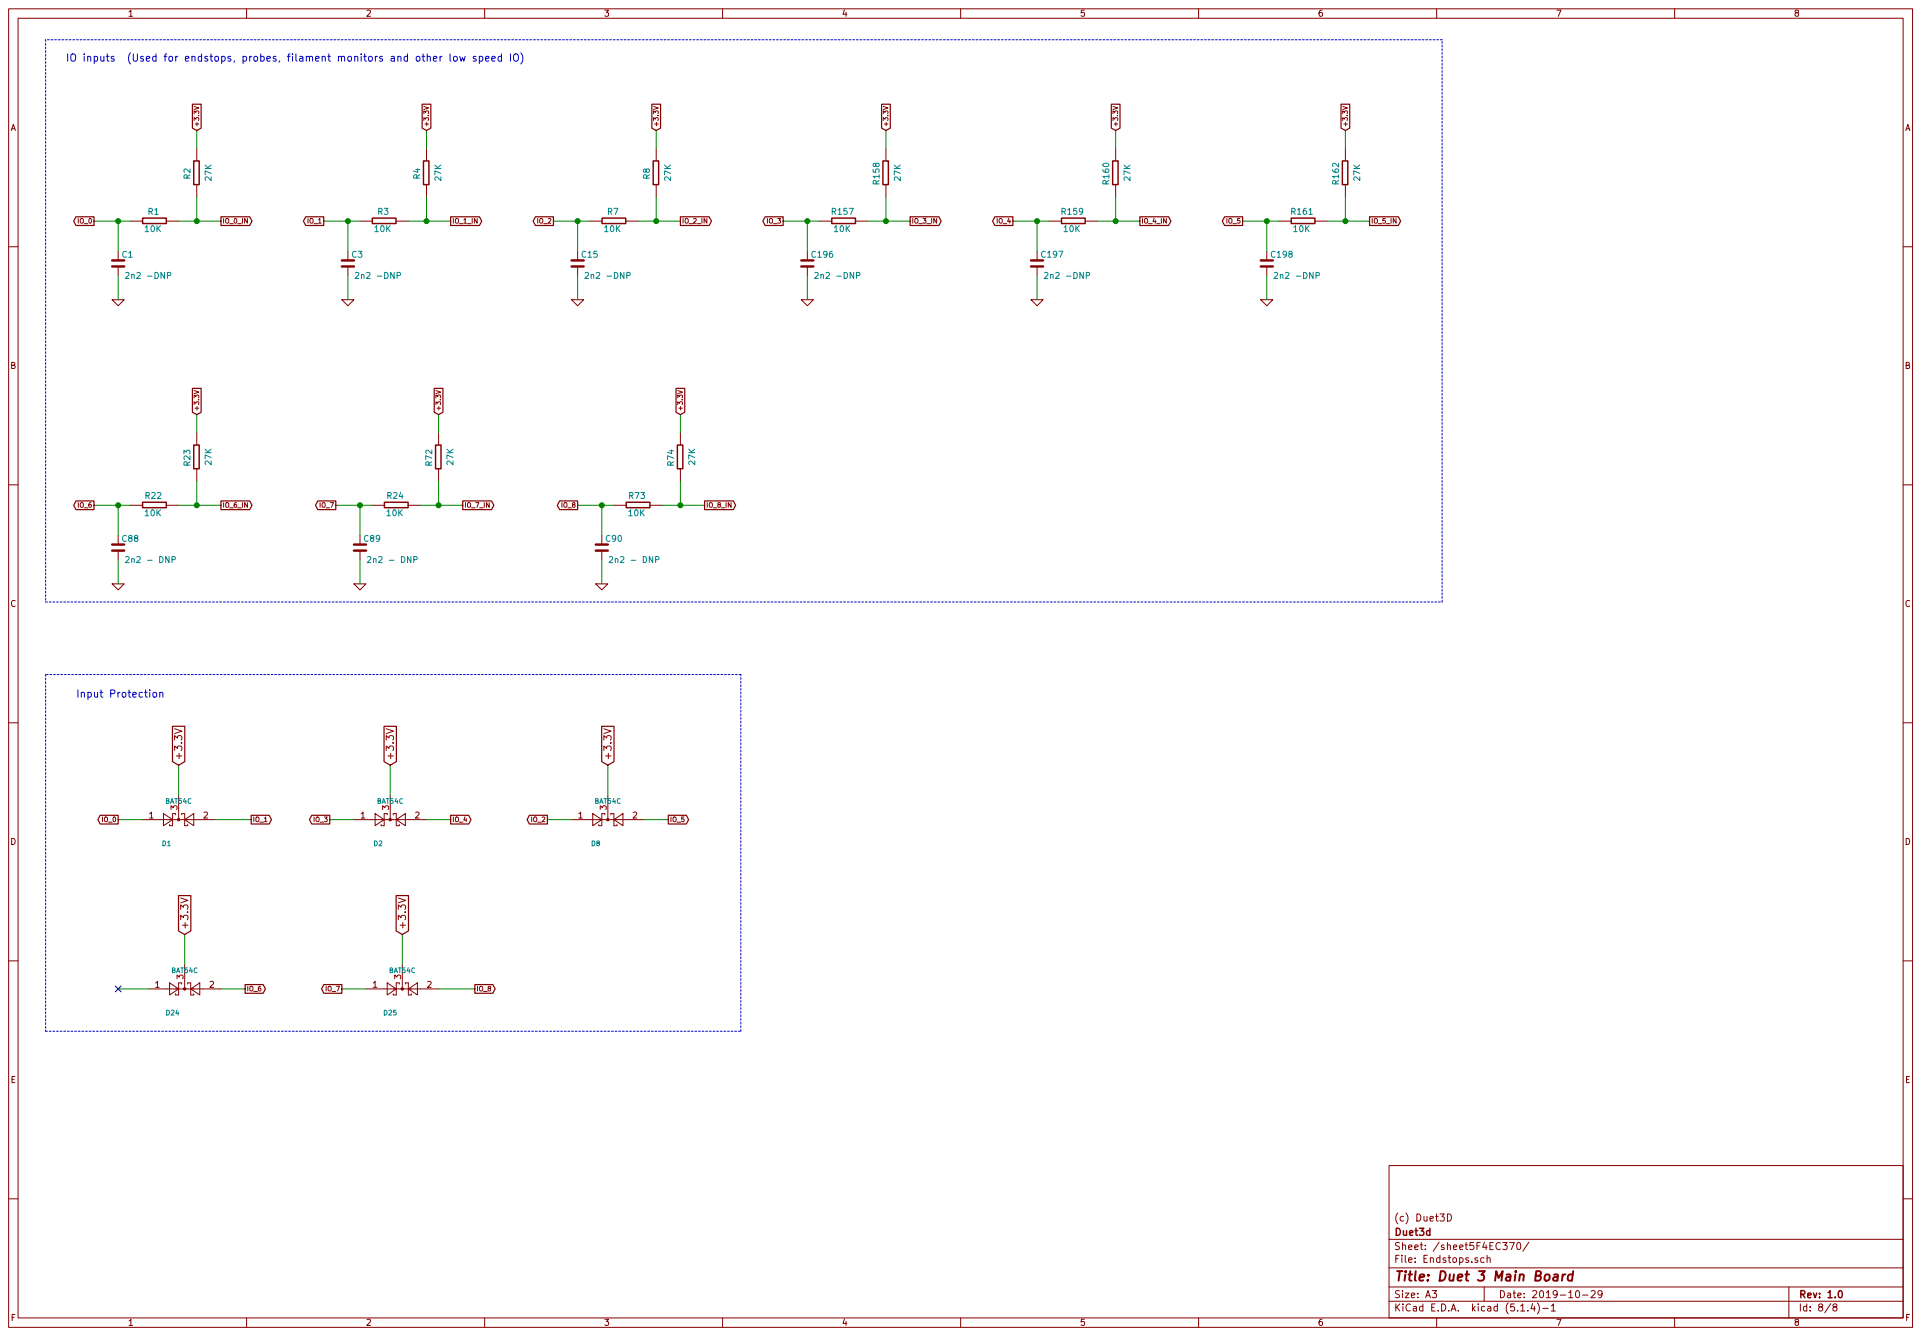
[picture p97: page 8]

IO inputs (Used for endstops, probes, filament monitors and other low speed IO)

(c) Duet3D
File: Endstops.sch Sheet: /sheet5F4EC370/ Duet3d

Id: 8/8 Title: Duet 3 Main Board
