ReadHeadRedemption/SeniorDesignSp26Su26/(list of files, drawings)

Other design files:
Hardware/Folder of holdin/ESP32-S3-WROOM-2_Reference_Design/ESP32-S3-WROOM-2_V1.3_Reference_Design/01_Schematic/SCH_ESP32-S3-WROOM-2_V1.3_20230222.DSN
Hardware/Folder of holdin/ESP32-S3-WROOM-2_Reference_Design/ESP32-S3-WROOM-2_V1.3_Reference_Design/02_PCB/PCB_ESP32-S3-WROOM-2_V1.2_20220705.pcb
Hardware/Folder of holdin/TMC2160-EVAL-OrCAD/TMC2160-EVAL.DSN
Hardware/KiCAD files/LM2679PiRegulator/PartsLibrary/2100LL-221H-RC/Altium/2100LL221HRC.PcbLib
Hardware/KiCAD files/LM2679PiRegulator/PartsLibrary/2100LL-221H-RC/Altium/2100LL-221H-RC.SchLib
Hardware/KiCAD files/Mainboard Layout No daisy chain/freerouting.dsn
Hardware/KiCAD files/Mainboard Layout No daisy chain/temp-freerouting.dsn
Hardware/KiCAD files/Mainboard layout/freerouting.dsn
Hardware/KiCAD files/Mainboard layout/temp-freerouting.dsn
Hardware/KiCAD files/parts libraries/exported libraries/STM32H7/STM32H723VEH6/Altium/BGA100C80P10X10_800X800X110.PcbLib
Hardware/KiCAD files/parts libraries/exported libraries/STM32H7/STM32H723VEH6/Altium/STM32H723VEH6.SchLib
Hardware/KiCAD files/parts libraries/exported libraries/STM32H723zGT6 THIS ONE/STM32H723ZGT6/Altium/QFP50P2200X2200X160-144N.PcbLib
Hardware/KiCAD files/parts libraries/exported libraries/STM32H723zGT6 THIS ONE/STM32H723ZGT6/Altium/STM32H723ZGT6.SchLib
Hardware/KiCAD files/Swapping hotend board/freerouting.dsn
Hardware/KiCAD files/Swapping hotend board/temp-freerouting.dsn
