ReadHeadRedemption/SeniorDesignSp26Su26/Hardware/KiCAD files/Mainbourd layout pre-weeks check 1/Mainboard Layout No daisy chain cp2102 moved/_restore_backup_2026-06-08T18-46-17-246/Mainboard Layout No daisy chain cp2102 moved.kicad_pcb

## KiCad design Hardware/KiCAD files/Mainbourd layout pre-weeks check 1/Mainboard Layout No daisy chain cp2102 moved/_restore_backup_2026-06-08T18-46-17-246/Mainboard Layout No daisy chain cp2102 moved.kicad_pcb (2026-05-30)

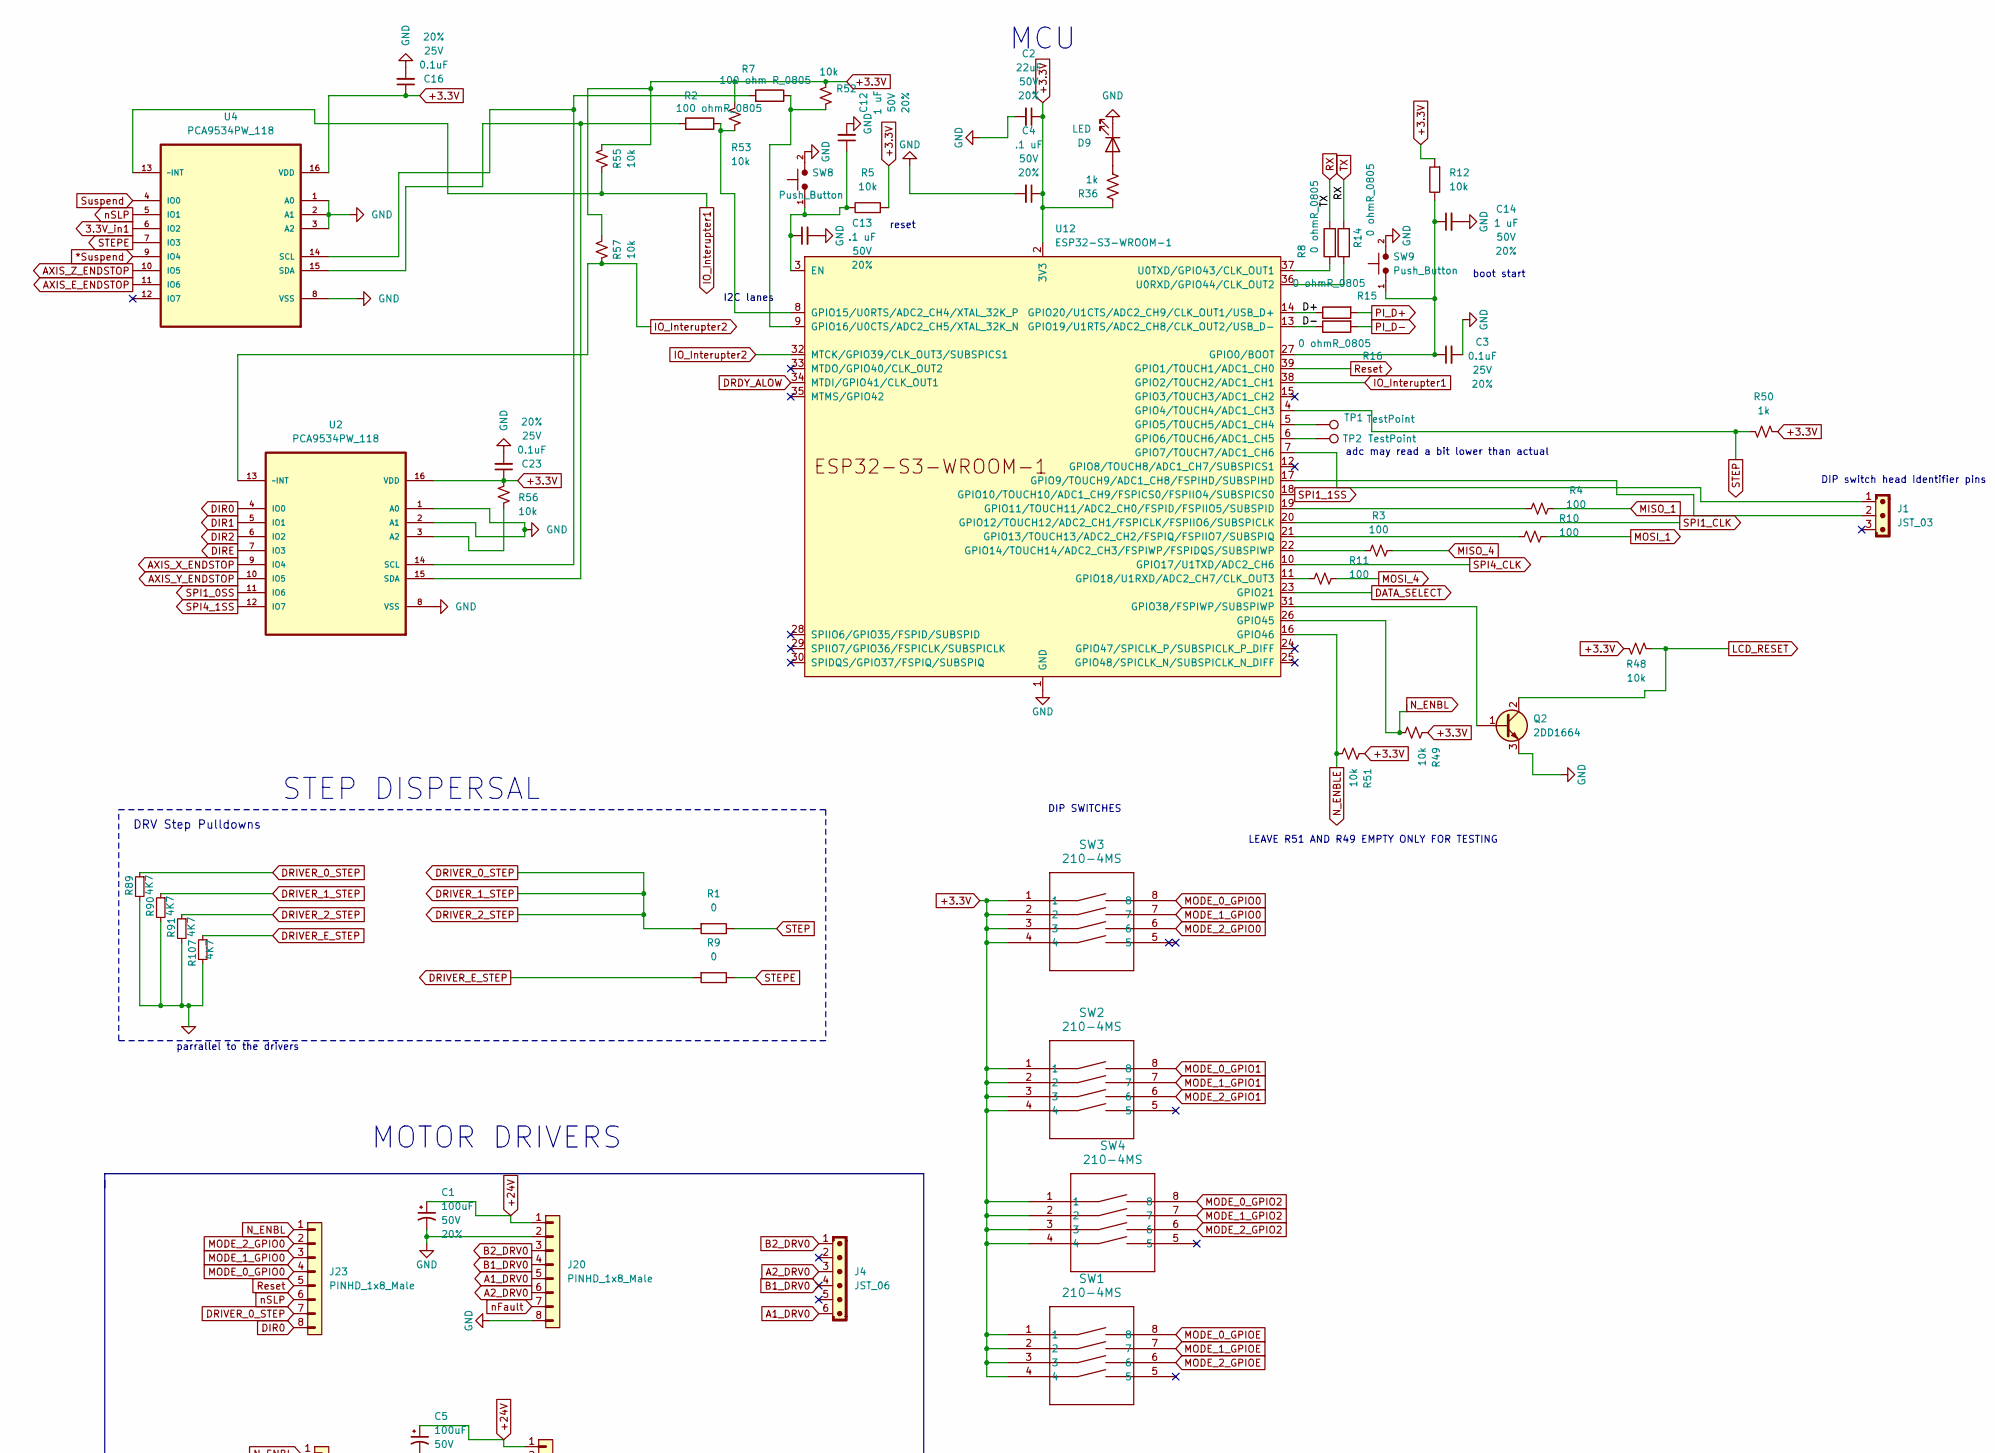
[picture p106: schematic Mainboard Layout No daisy chain cp2102 moved.kicad_sch, part in row 1, column 1]

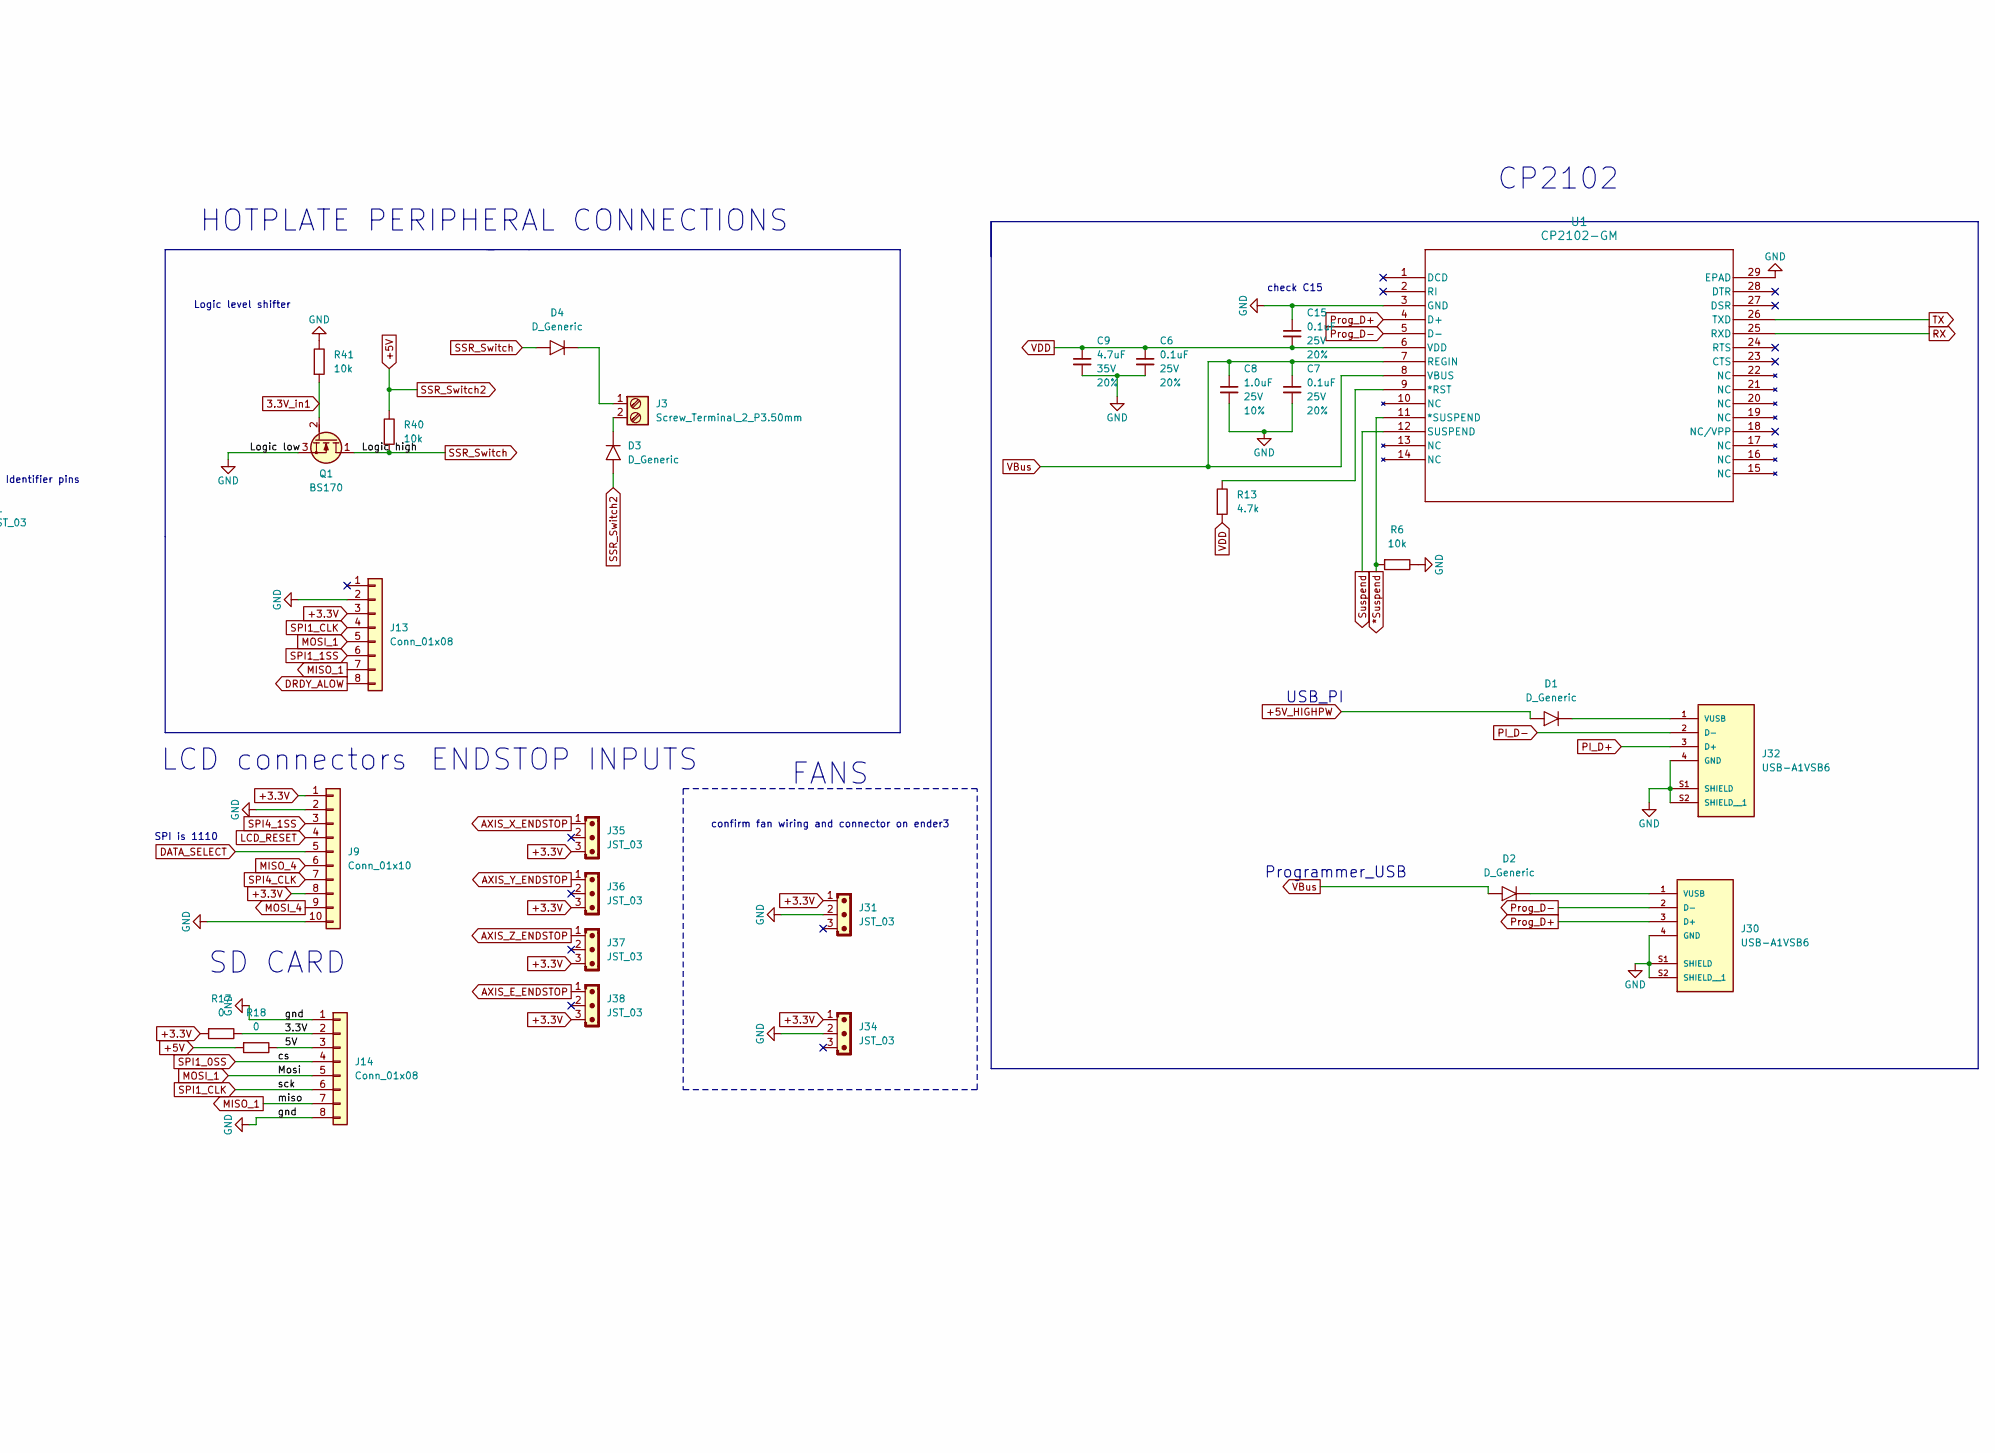
[picture p107: schematic Mainboard Layout No daisy chain cp2102 moved.kicad_sch, part in row 1, column 2]

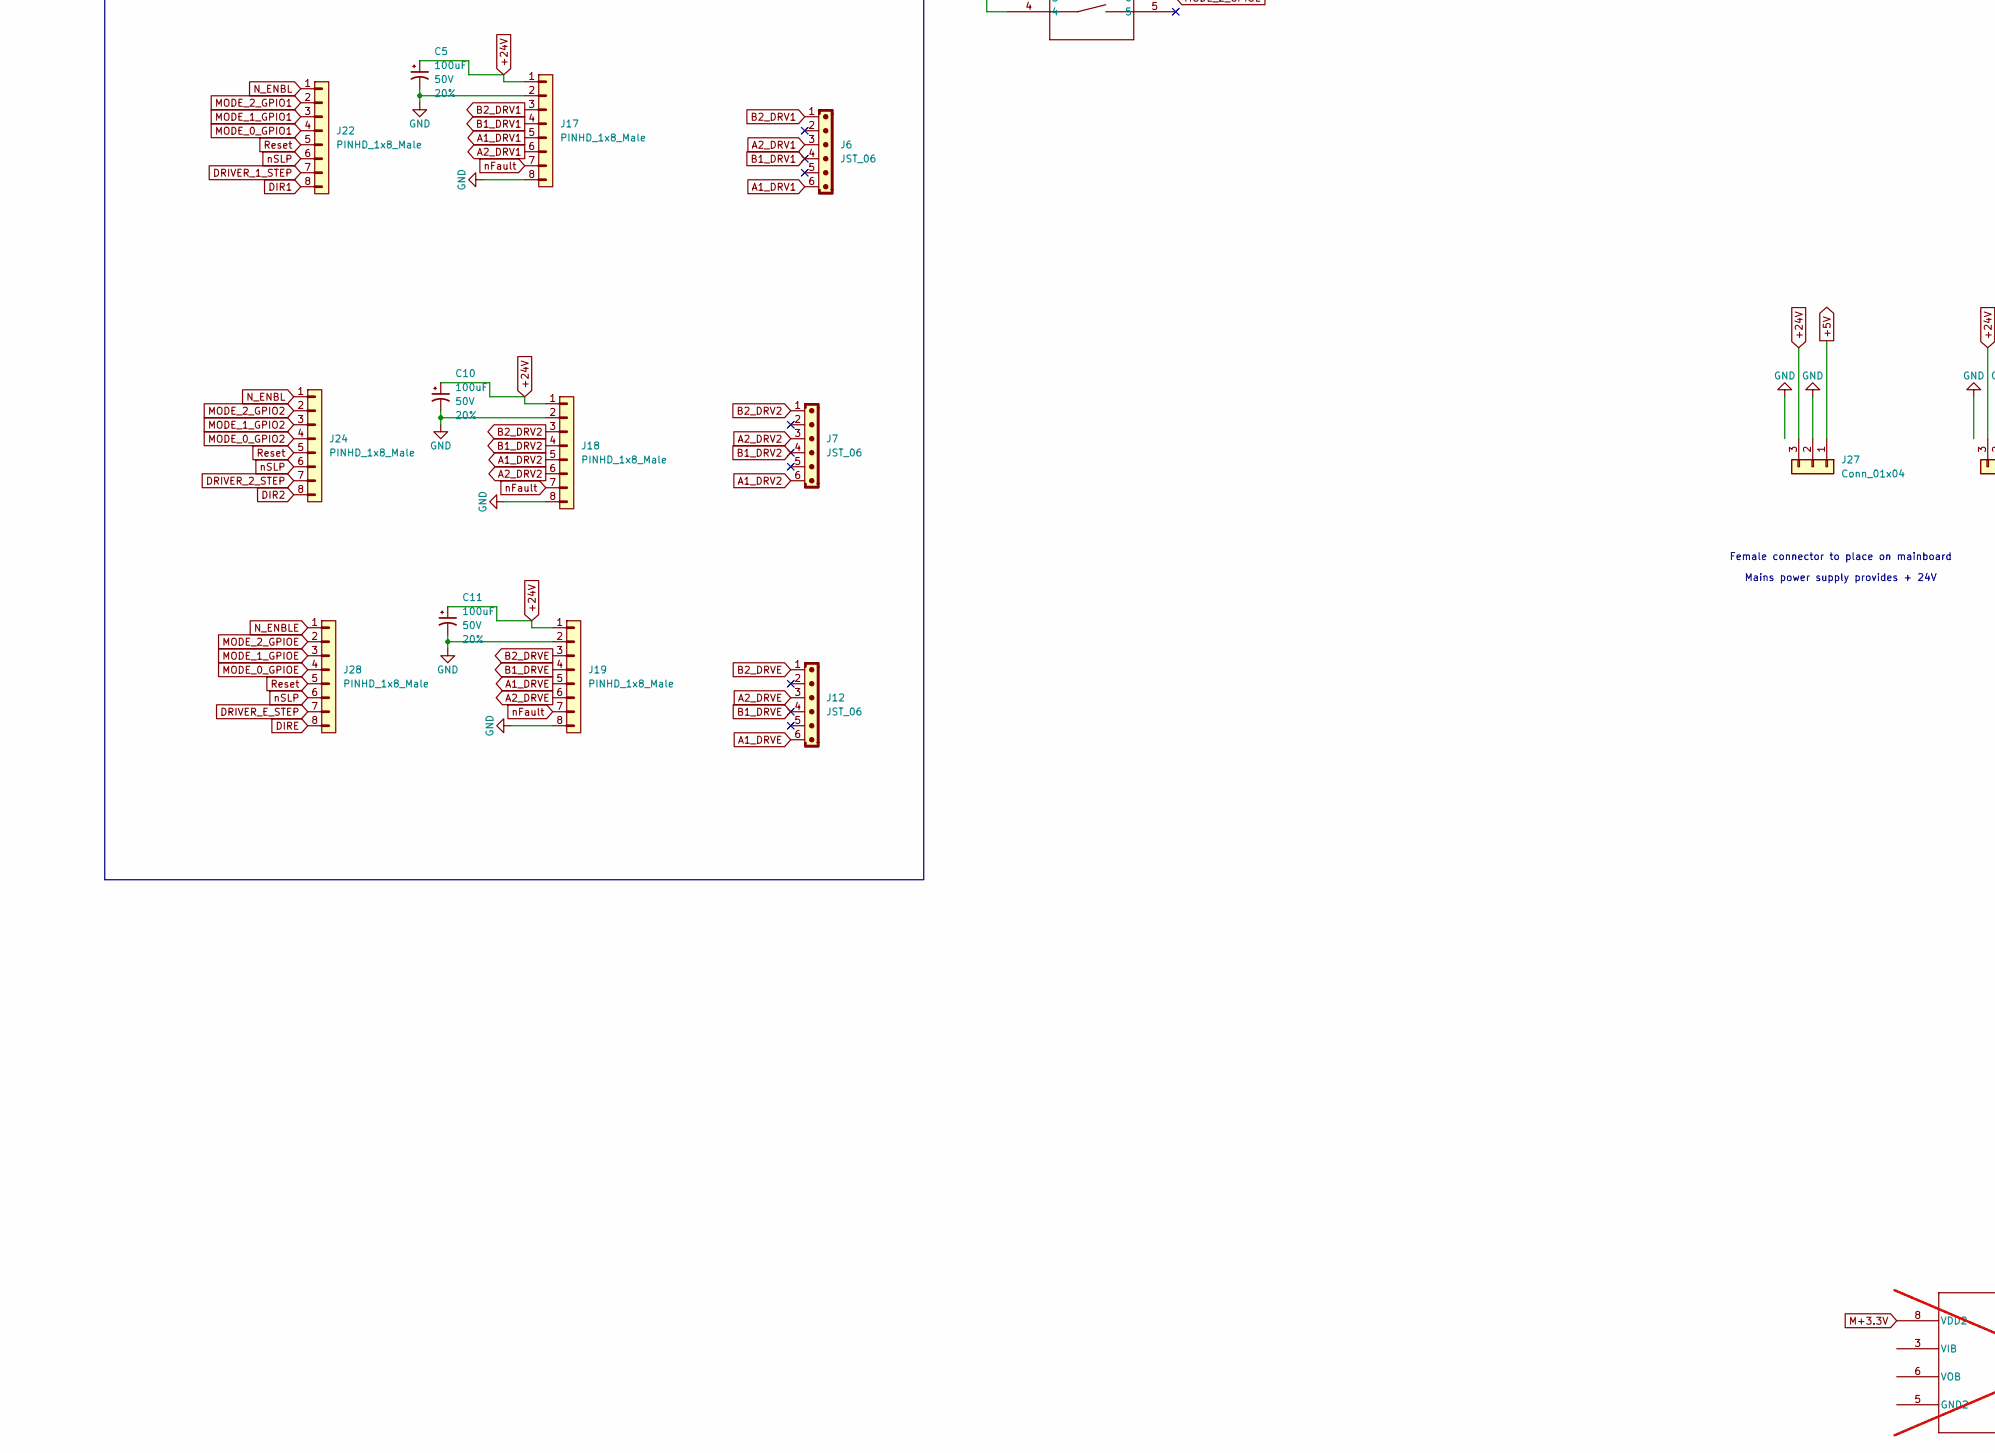
[picture p108: schematic Mainboard Layout No daisy chain cp2102 moved.kicad_sch, part in row 2, column 1]

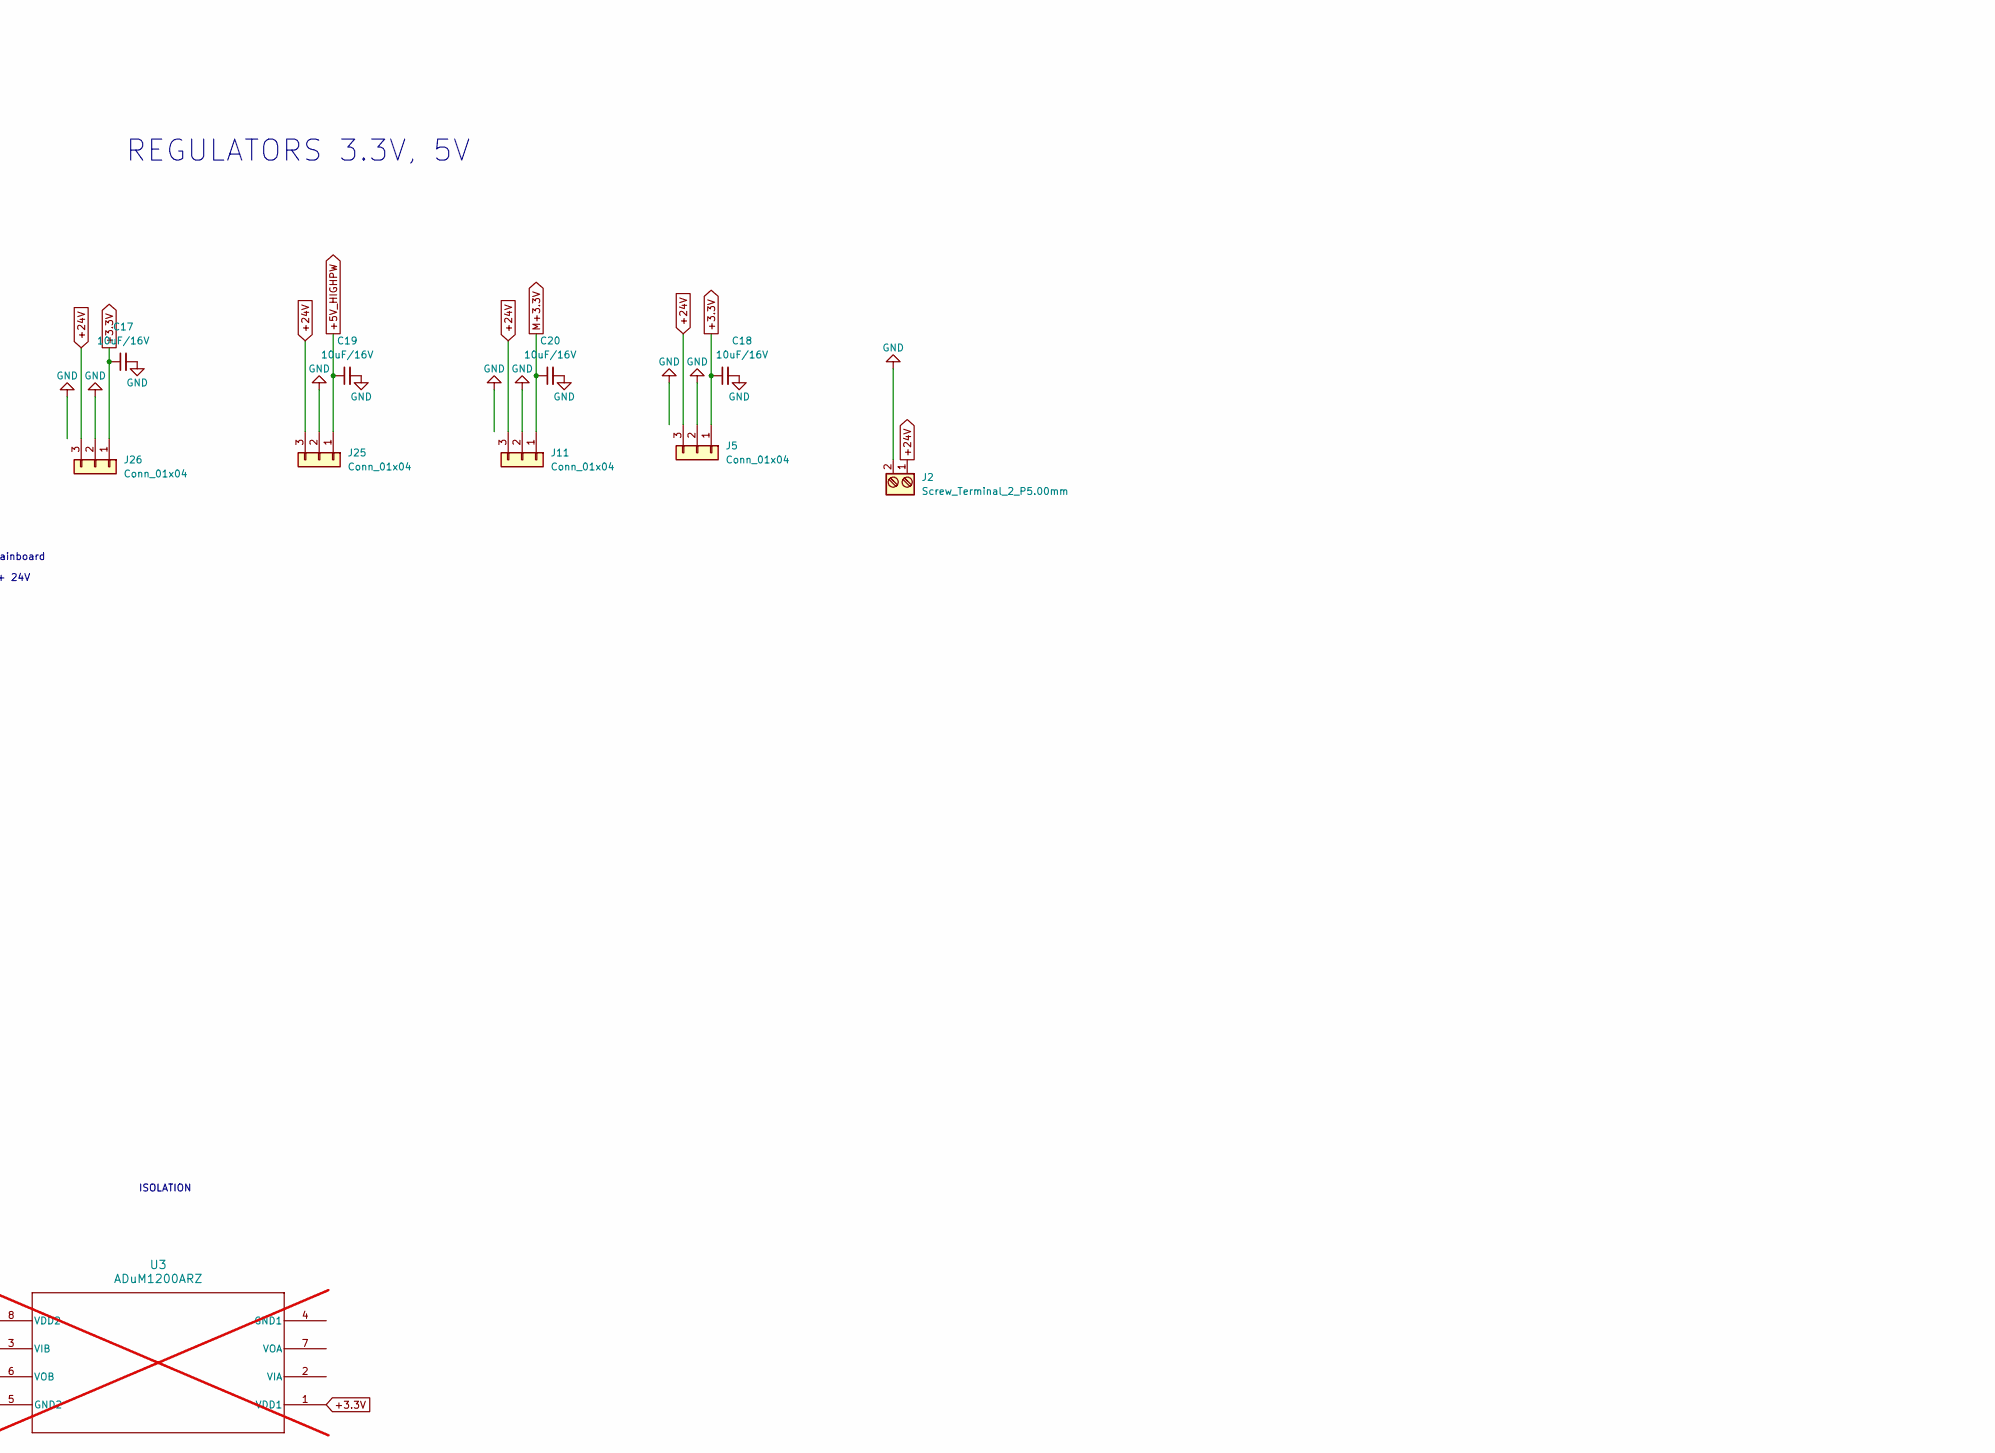
[picture p109: schematic Mainboard Layout No daisy chain cp2102 moved.kicad_sch, part in row 2, column 2]

Parts:
C1, C5, C10, C11: 100uF; C_Rect_L11.0mm_W3.5mm_P10.00mm_MKT; Voltage 50V; Tolerance 20%
C2: 22uF; C_1210_3225Metric; Voltage 50V; Tolerance 20%
C3, C6, C7, C15, C23: 0.1uF; C_0805_2012Metric; Voltage 25V; Tolerance 20%
C4, C13: .1 uF; C_1210_3225Metric; Voltage 50V; Tolerance 20%
C8: 1.0uF; C_0805_2012Metric; Voltage 25V; Tolerance 10%
C9: 4.7uF; C_0805_2012Metric; Voltage 35V; Tolerance 20%
C12, C14: 1 uF; C_1210_3225Metric; Voltage 50V; Tolerance 20%
C16: 0.1uF; LED_0805_2012Metric; Voltage 25V; Tolerance 20%
C17, C18, C19, C20: 10uF_1210_35V; C_1210_3225Metric; Part Number GMK325BJ106MN-T; JLCPCB ID C172721
D1, D2, D3, D4: D_Generic; D_DO-201AD_P15.24mm_Horizontal
D9: LED; LED_0603_1608Metric
J1, J31, J34, J35, J36, J37, J38: JST_03; JST_EH_B3B-EH-A_1x03_P2.50mm_Vertical
J2: Screw_Terminal_2_P5.00mm; TerminalBlock_Phoenix_PT-1,5-2-5.0-H_1x02_P5.00mm_Horizontal
J3: Screw_Terminal_2_P3.50mm; TerminalBlock_Phoenix_PT-1,5-2-3.5-H_1x02_P3.50mm_Horizontal
J4, J6, J7, J12: JST_06; JST_EH_B6B-EH-A_1x06_P2.50mm_Vertical
J5, J11, J25, J26, J27: Conn_01x04; 1x03_P2.54mm
J9: Conn_01x10; 1x10_P2.54mm
J13, J14: Conn_01x08; 1x08_P2.54mm
J17, J18, J19, J20, J22, J23, J24, J28: PINHD_1x8_Male; PinHeader_1x08_P2.54mm_Vertical
J30, J32: USB-A1VSB6; USB_A_Kycon_KUSBX-AS1N-B_Horizontal; PARTREV D
Q1: BS170; TO-92_Inline_Wide_DGS
Q2: 2DD1664; SOT-89-3
R1, R9, R17, R18: 0; R_0805_2012Metric
R2: 100 ohmR_0805; R_0805_2012Metric
R3, R4, R10, R11: 100; R_0805_2012Metric
R5, R6, R12, R40, R41: 10k; R_Axial_DIN0207_L6.3mm_D2.5mm_P10.16mm_Horizontal
R7: 100 ohm R_0805; R_0805_2012Metric
R8, R14, R15, R16: 0 ohmR_0805; R_0805_2012Metric
R13: 4.7k; R_Axial_DIN0207_L6.3mm_D2.5mm_P10.16mm_Horizontal
R36: 1k; R_1206_3216Metric_Pad1.30x1.75mm_HandSolder
R48: 10k; R_0603_1608Metric
R49, R51, R55, R56, R57: 10k; R_0805_2012Metric
R50: 1k; R_Axial_DIN0207_L6.3mm_D2.5mm_P10.16mm_Horizontal
R52, R53: 10k; LED_0805_2012Metric
R89, R90, R91, R107: 4K7; R_0603_1608Metric; Part Number RK73H1ETTP4701F
SW1, SW2, SW3, SW4: 210-4MS; DIP8_210-4_CTS
SW8, SW9: Push_Button; SW_PUSH_6mm
TP1, TP2: TestPoint; TestPoint_Loop_D3.80mm_Drill2.5mm
U1: CP2102-GM; QFN28_5X5_SIL
U2, U4: PCA9534PW_118; SOP65P640X110-16N; MPN PCA9534PW,118
U3: ADuM1200ARZ; R_8_ADI; not fitted
U12: ESP32-S3-WROOM-1

Connections:
3.3V_in1: Q1.2 (G), R41.1, U4.6 (IO2)
*Suspend: R6.1, U1.11 (*SUSPEND), U4.9 (IO4)
+3.3V: C2.1, C4.1, C16.1, C17.1, C18.1, C23.1, J5.1, J9.1, J9.8, J13.3, J26.1, J31.1, J34.1, J35.3, J36.3, J37.3, J38.3, R5.1, R12.1, R17.1, R36.1, R48.1, R49.2, R50.2, R51.2, R52.2, R53.2, R55.1, R56.2, R57.1, SW1.1, SW1.2, SW1.3, SW1.4, SW2.1, SW2.2, SW2.3, SW2.4, SW3.1, SW3.2, SW3.3, SW3.4, SW4.1, SW4.2, SW4.3, SW4.4, U2.16 (VDD), U3.1 (VDD1), U4.16 (VDD), U12.2 (3V3)
+5V: D3.2 (A), J27.1, R18.1, R40.2
+5V_HIGHPW: C19.1, D1.2 (A), J25.1
+24V: C1.1, C5.1, C10.1, C11.1, J2.1, J5.3, J11.3, J17.1, J18.1, J19.1, J20.1, J25.3, J26.3, J27.3
/3.3V: J14.2, R17.2
/5V: J14.3, R18.2
/D+: R15.2, U12.14 (GPIO20/U1CTS/ADC2_CH9/CLK_OUT1/USB_D+)
/D-: R16.2, U12.13 (GPIO19/U1RTS/ADC2_CH8/CLK_OUT2/USB_D-)
A1_DRV0: J4.6, J20.5
A1_DRV1: J6.6, J17.5
A1_DRV2: J7.6, J18.5
A1_DRVE: J12.6, J19.5
A2_DRV0: J4.3, J20.6
A2_DRV1: J6.3, J17.6
A2_DRV2: J7.3, J18.6
A2_DRVE: J12.3, J19.6
AXIS_E_ENDSTOP: J38.1, U4.11 (IO6)
AXIS_X_ENDSTOP: J35.1, U2.9 (IO4)
AXIS_Y_ENDSTOP: J36.1, U2.10 (IO5)
AXIS_Z_ENDSTOP: J37.1, U4.10 (IO5)
B1_DRV0: J4.4, J20.4
B1_DRV1: J6.4, J17.4
B1_DRV2: J7.4, J18.4
B1_DRVE: J12.4, J19.4
B2_DRV0: J4.1, J20.3
B2_DRV1: J6.1, J17.3
B2_DRV2: J7.1, J18.3
B2_DRVE: J12.1, J19.3
DATA_SELECT: J9.5, U12.23 (GPIO21)
DIR0: J23.8, U2.4 (IO0)
DIR1: J22.8, U2.5 (IO1)
DIR2: J24.8, U2.6 (IO2)
DIRE: J28.8, U2.7 (IO3)
DRDY_ALOW: J13.8, U12.34 (MTDI/GPIO41/CLK_OUT1)
DRIVER_0_STEP: J22.7, J23.7, J24.7, R1.1, R89.1, R90.1, R91.1
DRIVER_E_STEP: J28.7, R9.1, R107.1
IO_Interupter1: R55.2, U4.13 (~INT), U12.38 (GPIO2/TOUCH2/ADC1_CH1)
IO_Interupter2: R57.2, U2.13 (~INT), U12.32 (MTCK/GPIO39/CLK_OUT3/SUBSPICS1)
LCD_RESET: J9.4, Q2.2 (C), R48.2
M+3.3V: C20.1, J11.1, U3.8 (VDD2)
MISO_1: J13.7, J14.7, R4.2
MISO_4: J9.6, R3.2
MODE_0_GPIO0: J23.4, SW3.8
MODE_0_GPIO1: J22.4, SW2.8
MODE_0_GPIO2: J24.4, SW4.8
MODE_0_GPIOE: J28.4, SW1.8
MODE_1_GPIO0: J23.3, SW3.7
MODE_1_GPIO1: J22.3, SW2.7
MODE_1_GPIO2: J24.3, SW4.7
MODE_1_GPIOE: J28.3, SW1.7
MODE_2_GPIO0: J23.2, SW3.6
MODE_2_GPIO1: J22.2, SW2.6
MODE_2_GPIO2: J24.2, SW4.6
MODE_2_GPIOE: J28.2, SW1.6
MOSI_1: J13.5, J14.5, R10.2
MOSI_4: J9.9, R11.2
N_ENBL: J22.1, J23.1, J24.1, R49.1, U12.26 (GPIO45)
N_ENBLE: J28.1, R51.1, U12.16 (GPIO46)
unnamed: D1.1 (K), J32.1 (VUSB)
unnamed: D2.1 (K), J30.1 (VUSB)
unnamed: D3.1 (K), J3.2
unnamed: D4.1 (K), J3.1
unnamed: D9.2 (A), R36.2
unnamed: Q2.1 (B), U12.31 (GPIO38/FSPIWP/SUBSPIWP)
unnamed: R13.2, U1.9 (*RST)
unnamed: R56.1, U2.3 (A2)
unnamed: R7.1, U2.14 (SCL), U4.14 (SCL)
unnamed: R2.1, U2.15 (SDA), U4.15 (SDA)
unnamed 70: C12.1, C13.1, R5.2, SW8.1, U12.3 (EN); also elsewhere on the board
unnamed: C3.1, C14.1, R12.2, SW9.1, U12.27 (GPIO0/BOOT)
unnamed: TP1.1 (1_1), U12.5 (GPIO5/TOUCH5/ADC1_CH4)
unnamed: TP2.1 (1_1), U12.6 (GPIO6/TOUCH6/ADC1_CH5)
unnamed: J1.1, U12.7 (GPIO7/TOUCH7/ADC1_CH6)
unnamed: J1.2, U12.17 (GPIO9/TOUCH9/ADC1_CH8/FSPIHD/SUBSPIHD)
unnamed: R4.1, U12.19 (GPIO11/TOUCH11/ADC2_CH0/FSPID/FSPIIO5/S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)
unnamed: R10.1, U12.21 (GPIO13/TOUCH13/ADC2_CH2/FSPIQ/FSPIIO7/S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)
unnamed: R3.1, U12.22 (GPIO14/TOUCH14/ADC2_CH3/FSPIWP/FSPIDQS/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)
unnamed: R2.2, R53.1, U12.8 (GPIO15/U0RTS/ADC2_CH4/XTAL_32K_P)
unnamed: R7.2, R52.1, U12.9 (GPIO16/U0CTS/ADC2_CH5/XTAL_32K_N)
unnamed: R11.1, U12.11 (GPIO18/U1RXD/ADC2_CH7/CLK_OUT3)
unnamed: R14.1, U12.36 (U0RXD/GPIO44/CLK_OUT2)
PI_D+: J32.3 (D+), R15.1
PI_D-: J32.2 (D-), R16.1
Prog_D+: J30.3 (D+), U1.4 (D+)
Prog_D-: J30.2 (D-), U1.5 (D-)
Reset: J22.5, J23.5, J24.5, J28.5, U12.39 (GPIO1/TOUCH1/ADC1_CH0)
SPI1_0SS: J14.4, U2.11 (IO6)
SPI1_1SS: J13.6, U12.18 (GPIO10/TOUCH10/ADC1_CH9/FSPICS0/FSPIIO4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)
SPI1_CLK: J13.4, J14.6, U12.20 (GPIO12/TOUCH12/ADC2_CH1/FSPICLK/FSPIIO6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)
SPI4_1SS: J9.3, U2.12 (IO7)
SPI4_CLK: J9.7, U12.10 (GPIO17/U1TXD/ADC2_CH6)
SSR_Switch: D4.2 (A), Q1.1 (D), R40.1
STEP: R1.2, R50.1, U12.4 (GPIO4/TOUCH4/ADC1_CH3)
STEPE: R9.2, U4.7 (IO3)
VBus: C7.1, C8.1, D2.2 (A), U1.7 (REGIN), U1.8 (VBUS)
VDD: C6.1, C9.1, C15.2, R13.1, U1.6 (VDD)
nFault: J17.7, J18.7, J19.7, J20.7
nSLP: J22.6, J23.6, J24.6, J28.6, U4.5 (IO1)

Notes on the sheet:
ISOLATION
HOTPLATE PERIPHERAL CONNECTIONS
boot start
I2C lanes
USB_PI
Mains power supply provides + 24V
Female connector to place on mainboard
parrallel to the drivers
DRV Step Pulldowns
ENDSTOP INPUTS
DIP SWITCHES
LCD connectors
STEP DISPERSAL
SPI is 1110
LEAVE R51 AND R49 EMPTY ONLY FOR TESTING
CP2102
check C15
SD CARD
FANS
DIP switch head Identifier pins
MCU
REGULATORS 3.3V, 5V
reset
Logic level shifter
MOTOR DRIVERS
confirm fan wiring and connector on ender3
Programmer_USB
adc may read a bit lower than actual

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
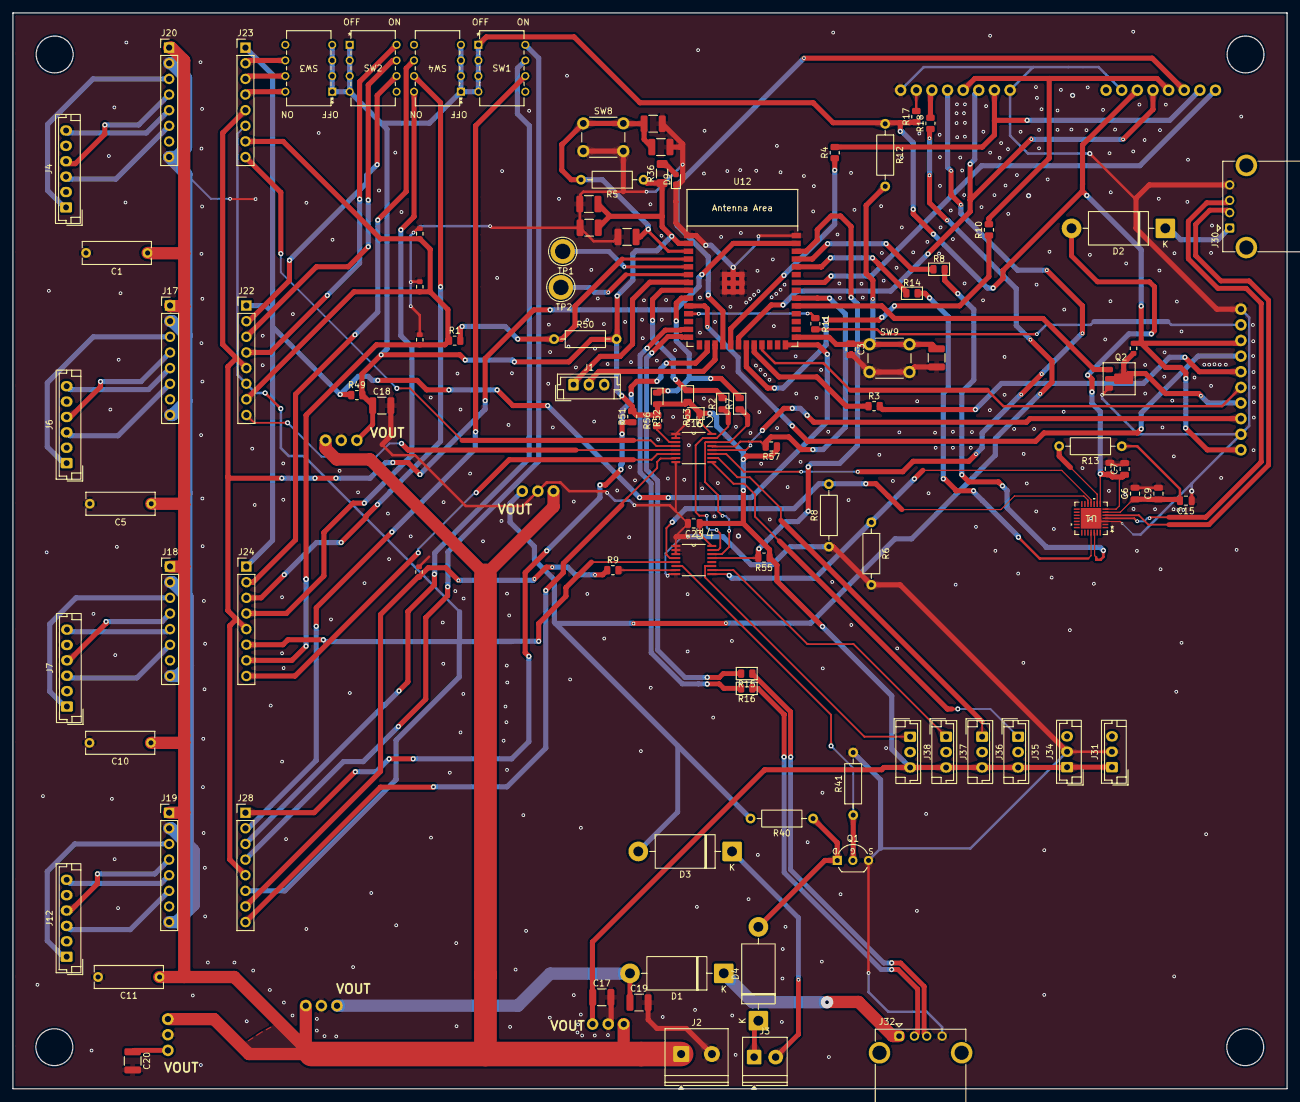
[picture p110: board Mainboard Layout No daisy chain cp2102 moved.kicad_pcb from above]

Board: 2 copper layers, 207.0 x 174.8 mm, 107 parts (0 on the bottom side), 104 nets.

Other parts of the board:
C4#2: 10uF; C_1210_3225Metric
R8#2: 0 ohmR_0805; R_0805_2012Metric

Their connections:
unnamed 70: C4#2.1; also elsewhere on the board
