ReadHeadRedemption/SeniorDesignSp26Su26/Hardware/KiCAD files/Swapping hotend board/Swapping hotend board.kicad_pcb

## KiCad design Hardware/KiCAD files/Swapping hotend board/Swapping hotend board.kicad_pcb (2026-06-23)

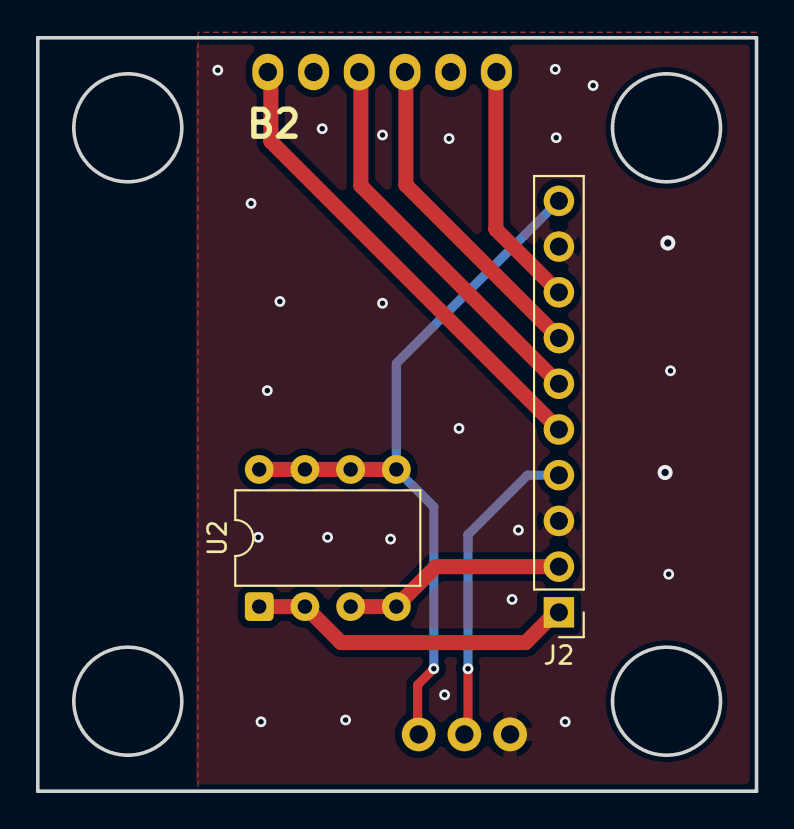
[picture p111: board Swapping hotend board.kicad_pcb from above]

Board: 2 copper layers, 39.9 x 41.9 mm, 4 parts (1 on the bottom side), 9 nets.

Parts:
J2: PINHD_1x10_Male; PinHeader_1x10_P2.54mm_Vertical
J3: JST_06; Pins_1x06_2.54mm_TH_SWD
J18: JST_1mm_3_Vertical; 1x03_P2.54mm
U2: DIP-8_W7.62mm

Connections:
/A1: J2.8, J3.1
/A2: J2.6, J3.4
/B1: J2.7, J3.3
/B2: J2.5, J3.6
GND: J2.3, J2.9, J18.1
unnamed: J2.4, J18.2
unnamed: J2.1, U2.1 (SW1-P1), U2.2 (SW1-P2)
unnamed: J2.10, J18.3, U2.5 (SW1-P1-input), U2.6 (SW1-P2-input), U2.7 (SW2-P1-input), U2.8 (SW2-P2-input)
unnamed: J2.2, U2.3 (SW2-P1), U2.4 (SW2-P4)
