ReadHeadRedemption/SeniorDesignSp26Su26/Hardware/KiCAD files/Non-swapping hotend board/Non swapping head board/Non swapping head board.kicad_pcb

## KiCad design Hardware/KiCAD files/Non-swapping hotend board/Non swapping head board/Non swapping head board.kicad_pcb (2026-06-04)

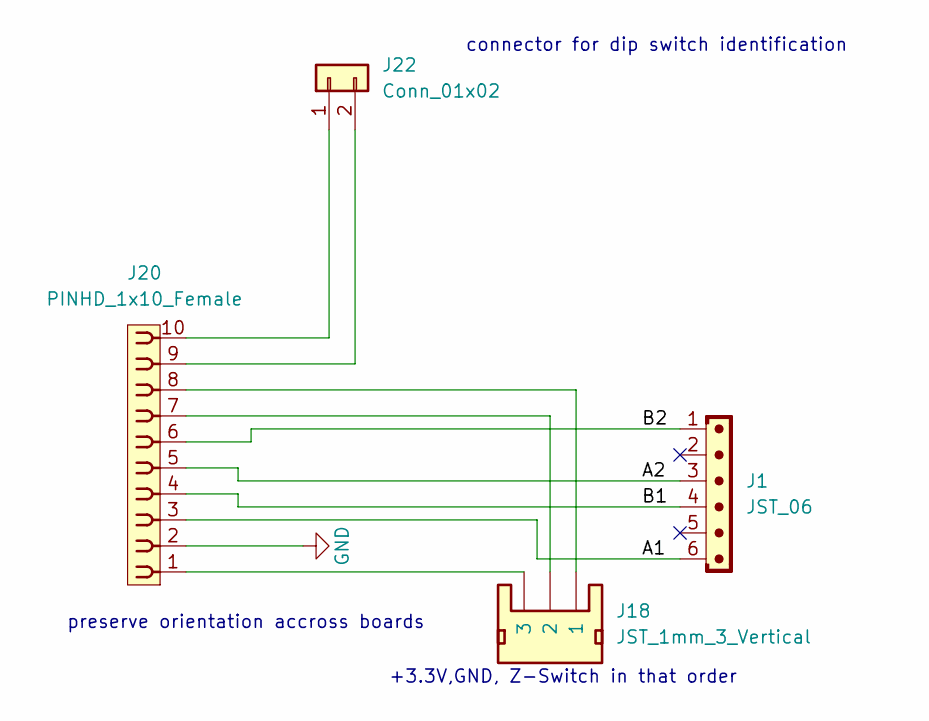
[picture p112: schematic Non swapping head board.kicad_sch]

Parts:
J1: JST_06; JST_EH_B6B-EH-A_1x06_P2.50mm_Vertical
J18: JST_1mm_3_Vertical; 1x03_P2.54mm
J20: PINHD_1x10_Female; PinSocket_1x10_P2.54mm_Horizontal
J22: Conn_01x02; 1x02_P2.54mm

Connections:
/A1: J1.6, J20.3
/A2: J1.3, J20.5
/B1: J1.4, J20.4
/B2: J1.1, J20.6
GND: J20.2
unnamed: J18.1, J20.8
unnamed: J18.2, J20.7
unnamed: J18.3, J20.1
unnamed: J20.10, J22.1
unnamed: J20.9, J22.2

Notes on the sheet:
connector for dip switch identification
+3.3V,GND, Z-Switch in that order
preserve orientation accross boards

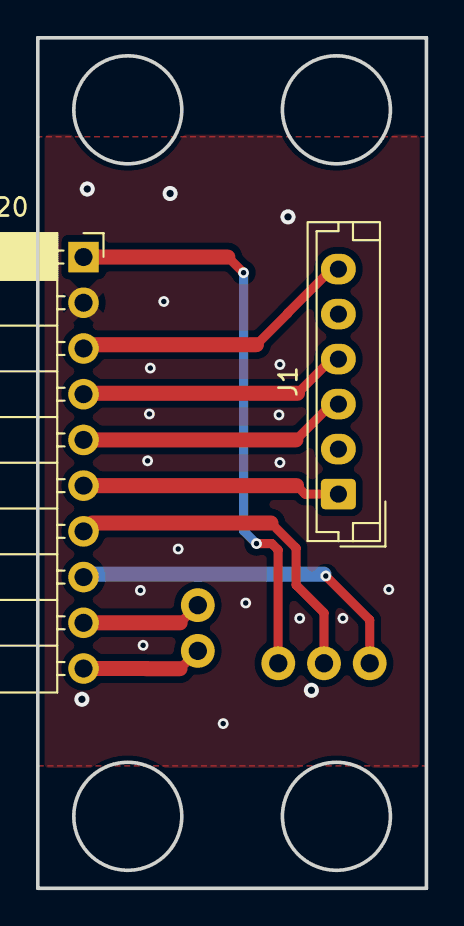
[picture p113: board Non swapping head board.kicad_pcb from above]

Board: 2 copper layers, 21.6 x 47.2 mm, 4 parts (0 on the bottom side), 9 nets.
