ReadHeadRedemption/SeniorDesignSp26Su26/Hardware/KiCAD files/LM2679PiRegulator/LM2679PiRegulator.kicad_pcb

## KiCad design Hardware/KiCAD files/LM2679PiRegulator/LM2679PiRegulator.kicad_pcb (2026-05-30)

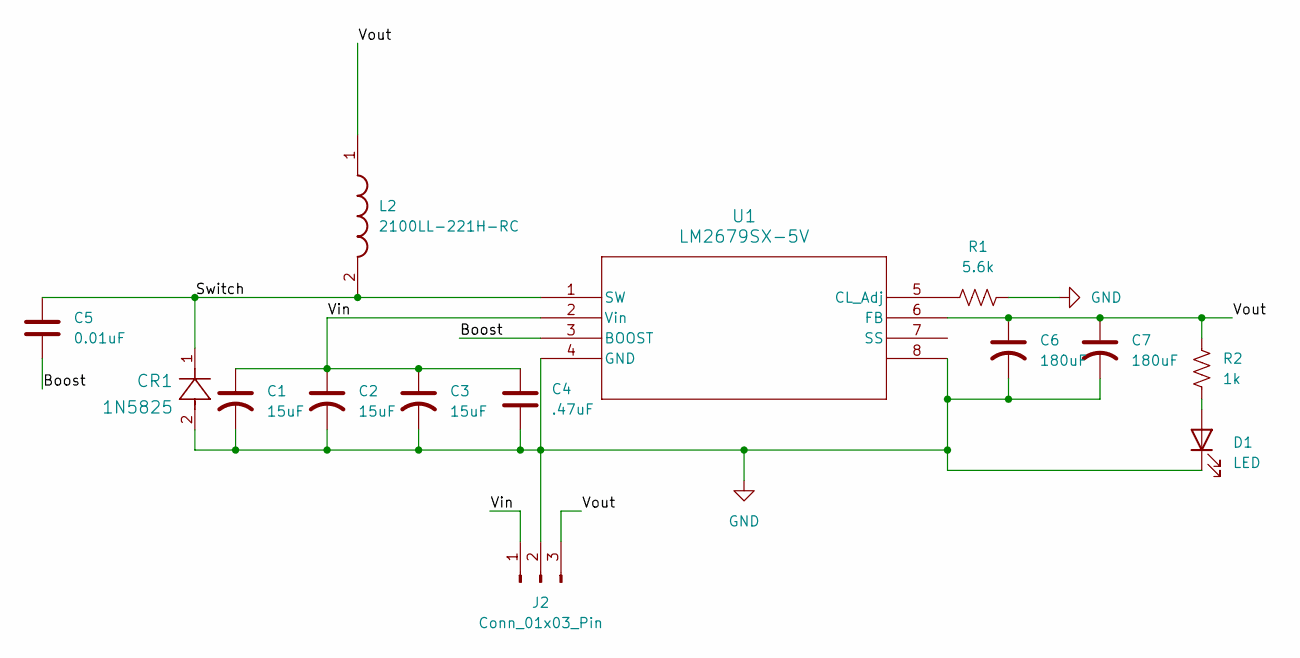
[picture p114: schematic LM2679PiRegulator.kicad_sch]

Parts:
C1, C2, C3: 15uF; C_Axial_L3.8mm_D2.6mm_P7.50mm_Horizontal
C4: .47uF; C_Axial_L3.8mm_D2.6mm_P7.50mm_Horizontal
C5: 0.01uF; C_Axial_L3.8mm_D2.6mm_P7.50mm_Horizontal
C6, C7: 180uF; C_Radial_D8.0mm_H7.0mm_P3.50mm
CR1: 1N5825; 1N5825_MCH
D1: LED; LED_1206_3216Metric_Pad1.42x1.75mm_HandSolder
J2: Conn_01x03_Pin; PinHeader_1x03_P2.54mm_Vertical
L2: 2100LL-221H-RC; 2100LL221HRC; Manufacturer_Part_Number 2100LL-221H-RC
R1: 5.6k; R_1206_3216Metric_Pad1.30x1.75mm_HandSolder
R2: 1k; R_1206_3216Metric_Pad1.30x1.75mm_HandSolder
U1: LM2679SX-5V; TS7B

Connections:
/Boost: C5.2, U1.3 (BOOST)
/Switch: C5.1, CR1.1, L2.2, U1.1 (SW)
/Vin: C1.1, C2.1, C3.1, C4.1, J2.1, U1.2 (Vin)
/Vout: C6.1, C7.1, J2.3, L2.1, R2.1, U1.6 (FB)
GND: C1.2, C2.2, C3.2, C4.2, C6.2, C7.2, CR1.2, D1.1 (K), J2.2, R1.2, U1.4 (GND), U1.8
unnamed: D1.2 (A), R2.2
unnamed: R1.1, U1.5 (CL_Adj)

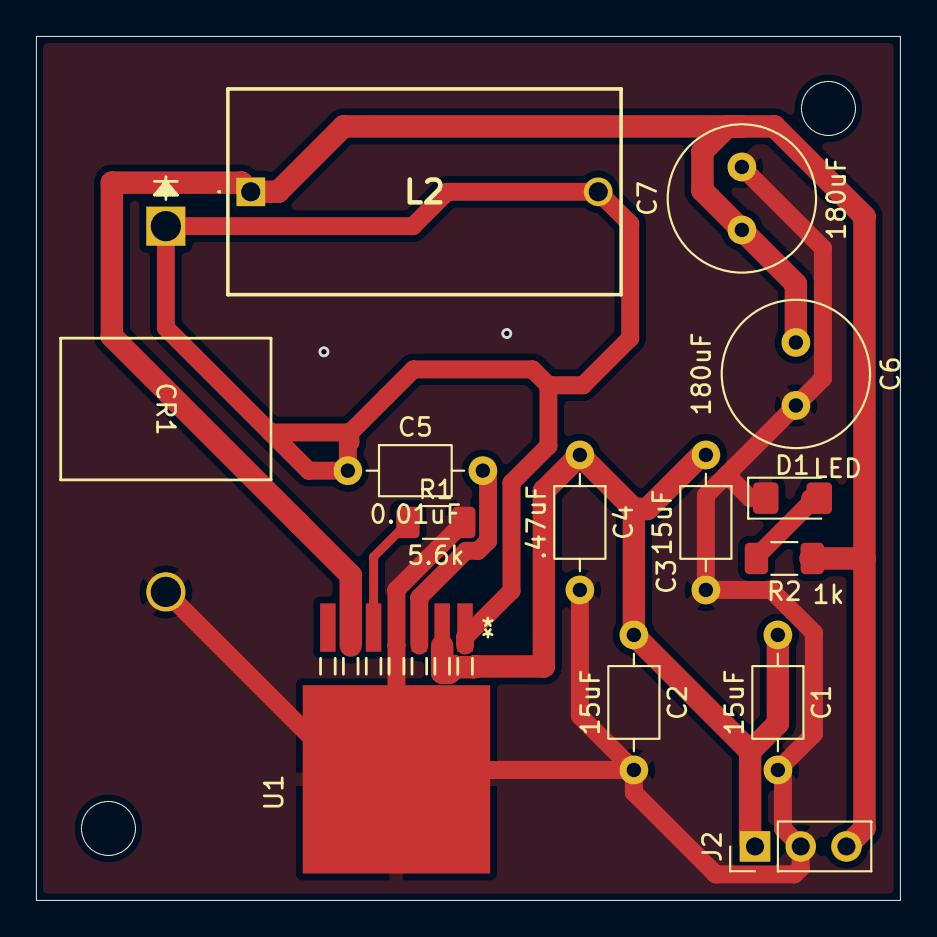
[picture p115: board LM2679PiRegulator.kicad_pcb from above]

Board: 2 copper layers, 48.0 x 48.0 mm, 14 parts (0 on the bottom side), 7 nets.
