ReadHeadRedemption/SeniorDesignSp26Su26/Hardware/KiCAD files/LM2576_Var_Volt_Reg/LM2576_Var_Volt_Reg.kicad_pcb

## KiCad design Hardware/KiCAD files/LM2576_Var_Volt_Reg/LM2576_Var_Volt_Reg.kicad_pcb (2026-05-30)

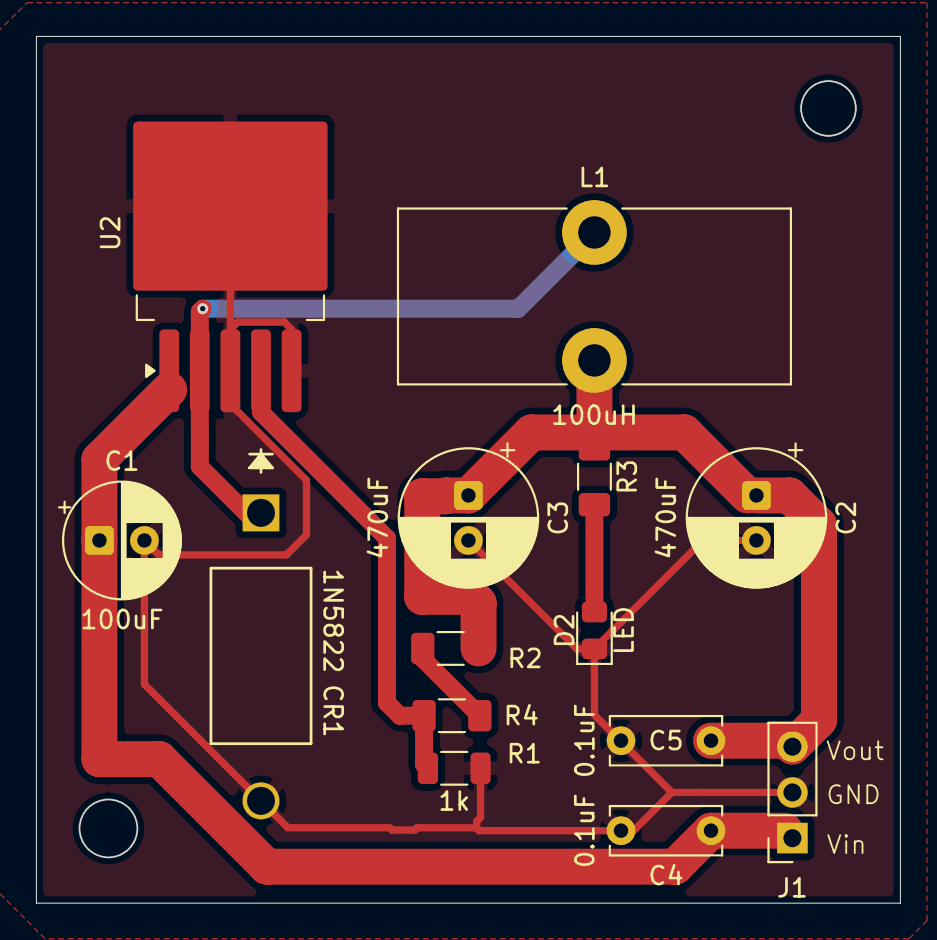
[picture p116: board LM2576_Var_Volt_Reg.kicad_pcb from above]

Board: 2 copper layers, 48.0 x 48.2 mm, 14 parts (0 on the bottom side), 7 nets.

Parts:
C1: 100uF; CP_Radial_D6.3mm_P2.50mm
C2, C3: 470uF; CP_Radial_D7.5mm_P2.50mm
C4, C5: 0.1uF; C_Disc_D6.0mm_W2.5mm_P5.00mm
CR1: 1N5822; DO-201AD_STM
D2: LED; LED_0805_2012Metric_Pad1.15x1.40mm_HandSolder
J1: Conn_01x03_Pin; PinSocket_1x03_P2.54mm_Vertical
L1: 100uH; L_Toroid_Vertical_L21.6mm_W9.5mm_P7.11mm_Pulse_C
R1: 1k; R_1206_3216Metric
R2: Rvar; R_1206_3216Metric_Pad1.30x1.75mm_HandSolder
R3: 1k; R_1206_3216Metric_Pad1.30x1.75mm_HandSolder
R4: Ropt; R_1206_3216Metric_Pad1.30x1.75mm_HandSolder
U2: LM2576HVS-ADJ; TO-263-5_TabPin3

Connections:
/FB: R1.1, R4.2, U2.4 (FB)
/Vin: C1.1, C4.1, J1.1, U2.1 (VIN)
/Vout: C2.1, C3.1, C5.1, J1.3, L1.2, R2.1, R3.1
GND: C1.2, C2.2, C3.2, C4.2, C5.2, CR1.2, D2.1 (K), J1.2, R1.2, U2.3 (GND), U2.5 (~ON/OFF)
unnamed: D2.2 (A), R3.2
unnamed: R2.2, R4.1
unnamed: CR1.1, L1.1, U2.2 (OUT)
