ReadHeadRedemption/SeniorDesignSp26Su26/Hardware/KiCAD files/Max temperature board/Max temperature V1/Max temperature V1.kicad_pcb

## KiCad design Hardware/KiCAD files/Max temperature board/Max temperature V1/Max temperature V1.kicad_pcb (2026-05-26)

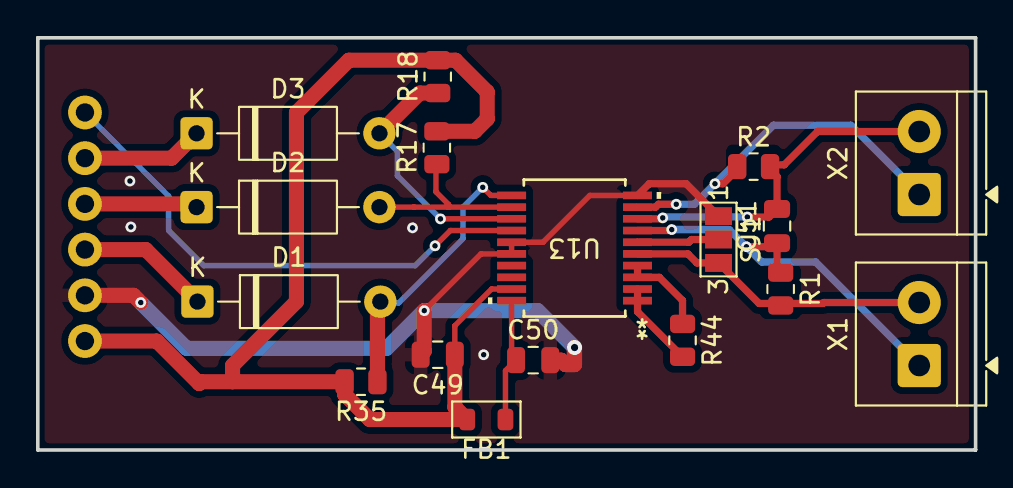
[picture p117: board Max temperature V1.kicad_pcb from above]

Board: 2 copper layers, 52.1 x 22.9 mm, 18 parts (0 on the bottom side), 17 nets.

Parts:
C49, C50: 0.1uF; C_0805_2012Metric
C51: 100nF; C_0805_2012Metric
D1, D2, D3: 1N4148 eq.; D_A-405_P10.16mm_Horizontal
FB1: FERRITE-0805NO; Ferrite_0805_2012Metric
J1: Conn_01x06; 1x06_P2.54mm
R1, R2: 0ohm; R_0805_2012Metric
R17, R18, R35: 10K; R_0805_2012Metric
R44: 430Ω / 4300Ω 0.1%; R_0805_2012Metric
SJ1: SOLDERJUMPER_2WAY; SolderJumper-3_P1.3mm_Open_Pad1.0x1.5mm_NumberLabels
U13: MAX31865; 21-0056C_20_MXM
X1, X2: 3.5mm; TerminalBlock_4Ucon_1x02_P3.50mm_Horizontal

Connections:
+3.3V: C49.1, FB1.2, J1.6, R17.2, R18.2, R35.2, U13.19 (DVDD)
/CHAINL0_MISO_1: D1.1 (K), J1.4
/MISO_1: J1.1, U13.14 (SDO)
/SPI1_CLK: D2.1 (K), J1.3
/SPI1_CS: D3.1 (K), J1.2
GND: C49.2, C50.2, J1.5, SJ1.1, U13.10 (AGND@2), U13.15 (GND), U13.16 (ANGD@1)
unnamed: D1.2 (A), R35.1, U13.11 (SDI)
unnamed: D2.2 (A), R17.1, U13.12 (SCLK)
unnamed: D3.2 (A), R18.1, U13.13 (CS)
unnamed: C50.1, FB1.1, U13.20 (VDD)
unnamed: R44.2, U13.1 (BIAS), U13.2 (REFIN+)
unnamed: SJ1.2, U13.6 (FORCE2)
unnamed: R1.2, SJ1.3, U13.5 (FORCE+), X1.2
unnamed: R2.1, U13.9 (FORCE-), X2.1
unnamed: R44.1, U13.3 (REFIN-), U13.4 (ISENSOR)
unnamed: C51.1, R1.1, U13.7 (RTDIN+), X1.1
unnamed: C51.2, R2.2, U13.8 (RTDIN-), X2.2
