ReadHeadRedemption/SeniorDesignSp26Su26/Hardware/KiCAD files/Standalone DRV8825/Standalone DRV8825.kicad_pcb

## KiCad design Hardware/KiCAD files/Standalone DRV8825/Standalone DRV8825.kicad_pcb (2026-05-26)

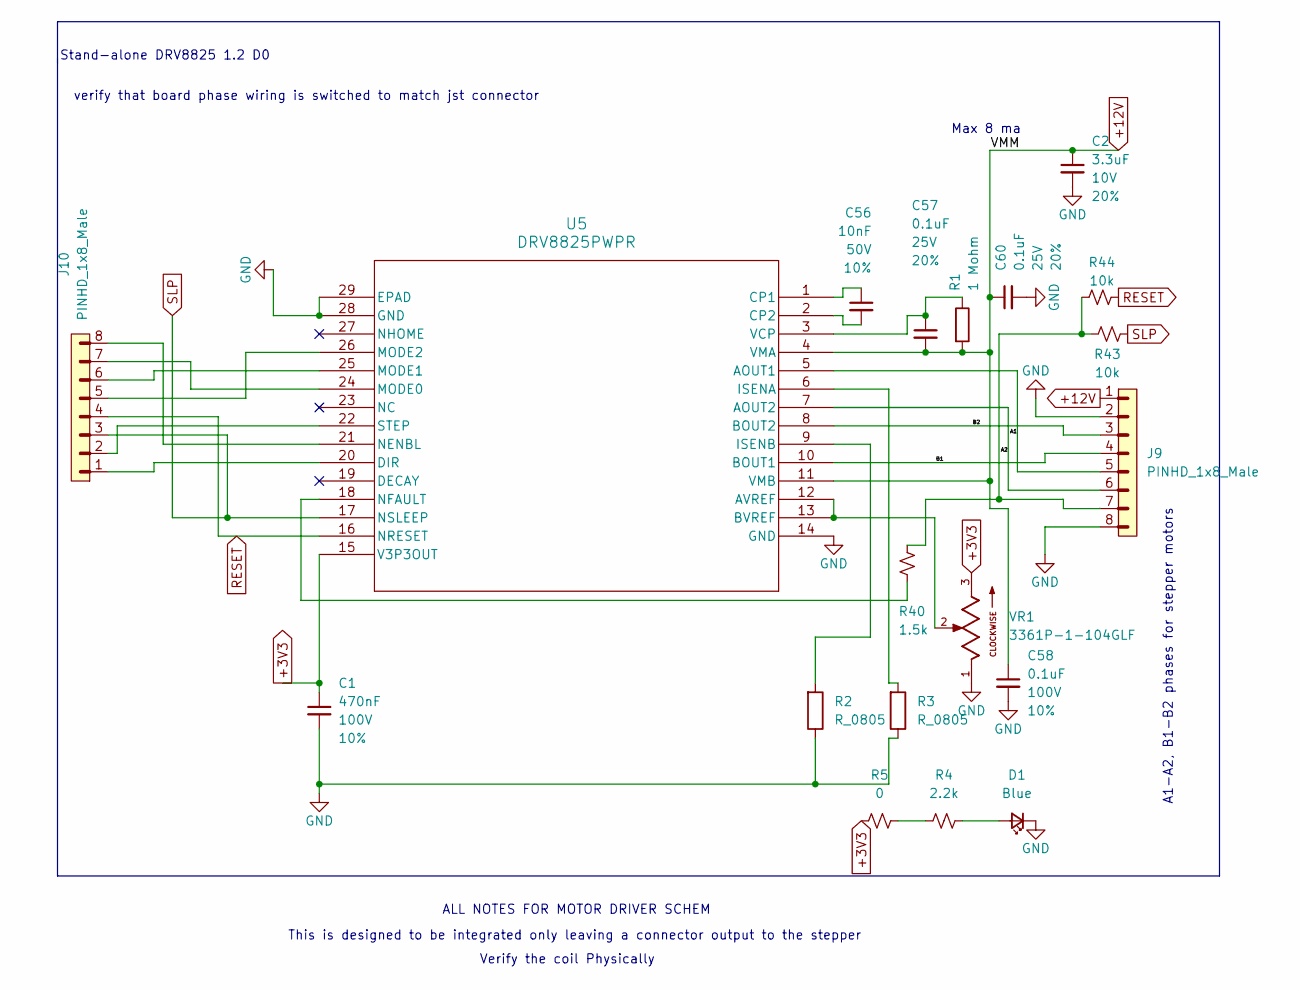
[picture p118: schematic Standalone DRV8825.kicad_sch]

Parts:
C1: 470nF; C_0805_2012Metric; Voltage 100V; Tolerance 10%
C2: 3.3uF; C_1206_3216Metric; Voltage 10V; Tolerance 20%
C56: 10nF; C_0603_1608Metric; Voltage 50V; Tolerance 10%
C57, C60: 0.1uF; C_0603_1608Metric; Voltage 25V; Tolerance 20%
C58: 0.1uF; C_0603_1608Metric; Voltage 100V; Tolerance 10%
D1: Blue; LED_0603_1608Metric_Blue
J9, J10: PINHD_1x8_Male; PinHeader_1x08_P2.54mm_Vertical
R1: 1 Mohm; R_0603_1608Metric
R2, R3: R_0805; R_0805_2012Metric
R4: 2.2k; R_0805_2012Metric
R5: 0; R_0805_2012Metric
R40: 1.5k; R_0603_1608Metric
R43, R44: 10k; R_0603_1608Metric
U5: DRV8825PWPR; IC_TPS61196PWPRQ1
VR1: 3361P-1-104GLF; TRIM_3361P-1-104GLF; PARTREV 08/19

Connections:
+3V3: C1.1, R5.1, U5.15 (V3P3OUT), VR1.3
+12V: C2.1, C57.2, C58.1, C60.1, J9.1, R1.1, U5.4 (VMA), U5.11 (VMB)
/A1: J9.5, U5.5 (AOUT1)
/A2: J9.6, U5.7 (AOUT2)
/B1: J9.4, U5.10 (BOUT1)
/B2: J9.3, U5.8 (BOUT2)
GND: C1.2, C2.2, C58.2, C60.2, D1.1 (K), J9.2, J9.8, R2.2, R3.2, U5.14 (GND), U5.28 (GND), U5.29 (EPAD), VR1.1
unnamed: D1.2 (A), R4.2
unnamed: J9.7, R40.2, R43.1, R44.1
unnamed: R4.1, R5.2
unnamed: U5.12 (AVREF), U5.13 (BVREF), VR1.2
unnamed: C56.1, U5.1 (CP1)
unnamed: C56.2, U5.2 (CP2)
unnamed: J10.1, U5.20 (DIR)
unnamed: R3.1, U5.6 (ISENA)
unnamed: R2.1, U5.9 (ISENB)
unnamed: J10.7, U5.24 (MODE0)
unnamed: J10.6, U5.25 (MODE1)
unnamed: J10.5, U5.26 (MODE2)
unnamed: J10.8, U5.21 (NENBL)
unnamed: R40.1, U5.18 (NFAULT)
unnamed: J10.2, U5.22 (STEP)
unnamed: C57.1, R1.2, U5.3 (VCP)
RESET: J10.4, R44.2, U5.16 (NRESET)
SLP: J10.3, R43.2, U5.17 (NSLEEP)

Notes on the sheet:
This is designed to be integrated only leaving a connector output to the stepper
ALL NOTES FOR MOTOR DRIVER SCHEM
verify that board phase wiring is switched to match jst connector
Max 8 ma
A1-A2, B1-B2 phases for stepper motors
Stand-alone DRV8825 1.2 D0
Verify the coil Physically

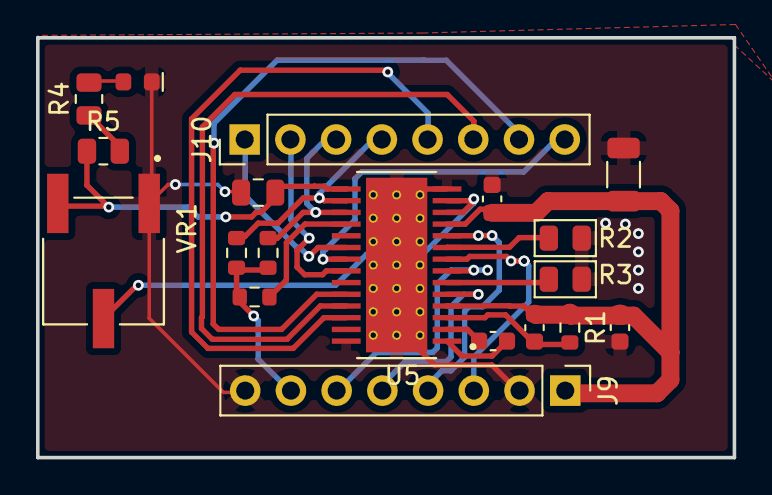
[picture p119: board Standalone DRV8825.kicad_pcb from above]

Board: 2 copper layers, 38.7 x 23.3 mm, 19 parts (0 on the bottom side), 25 nets.
