ReadHeadRedemption/SeniorDesignSp26Su26/Hardware/KiCAD files/Mainboard layout/Mainboard layout Pre-16 pin SD module.kicad_pcb

## KiCad design Hardware/KiCAD files/Mainboard layout/Mainboard layout Pre-16 pin SD module.kicad_pcb (2026-04-26)

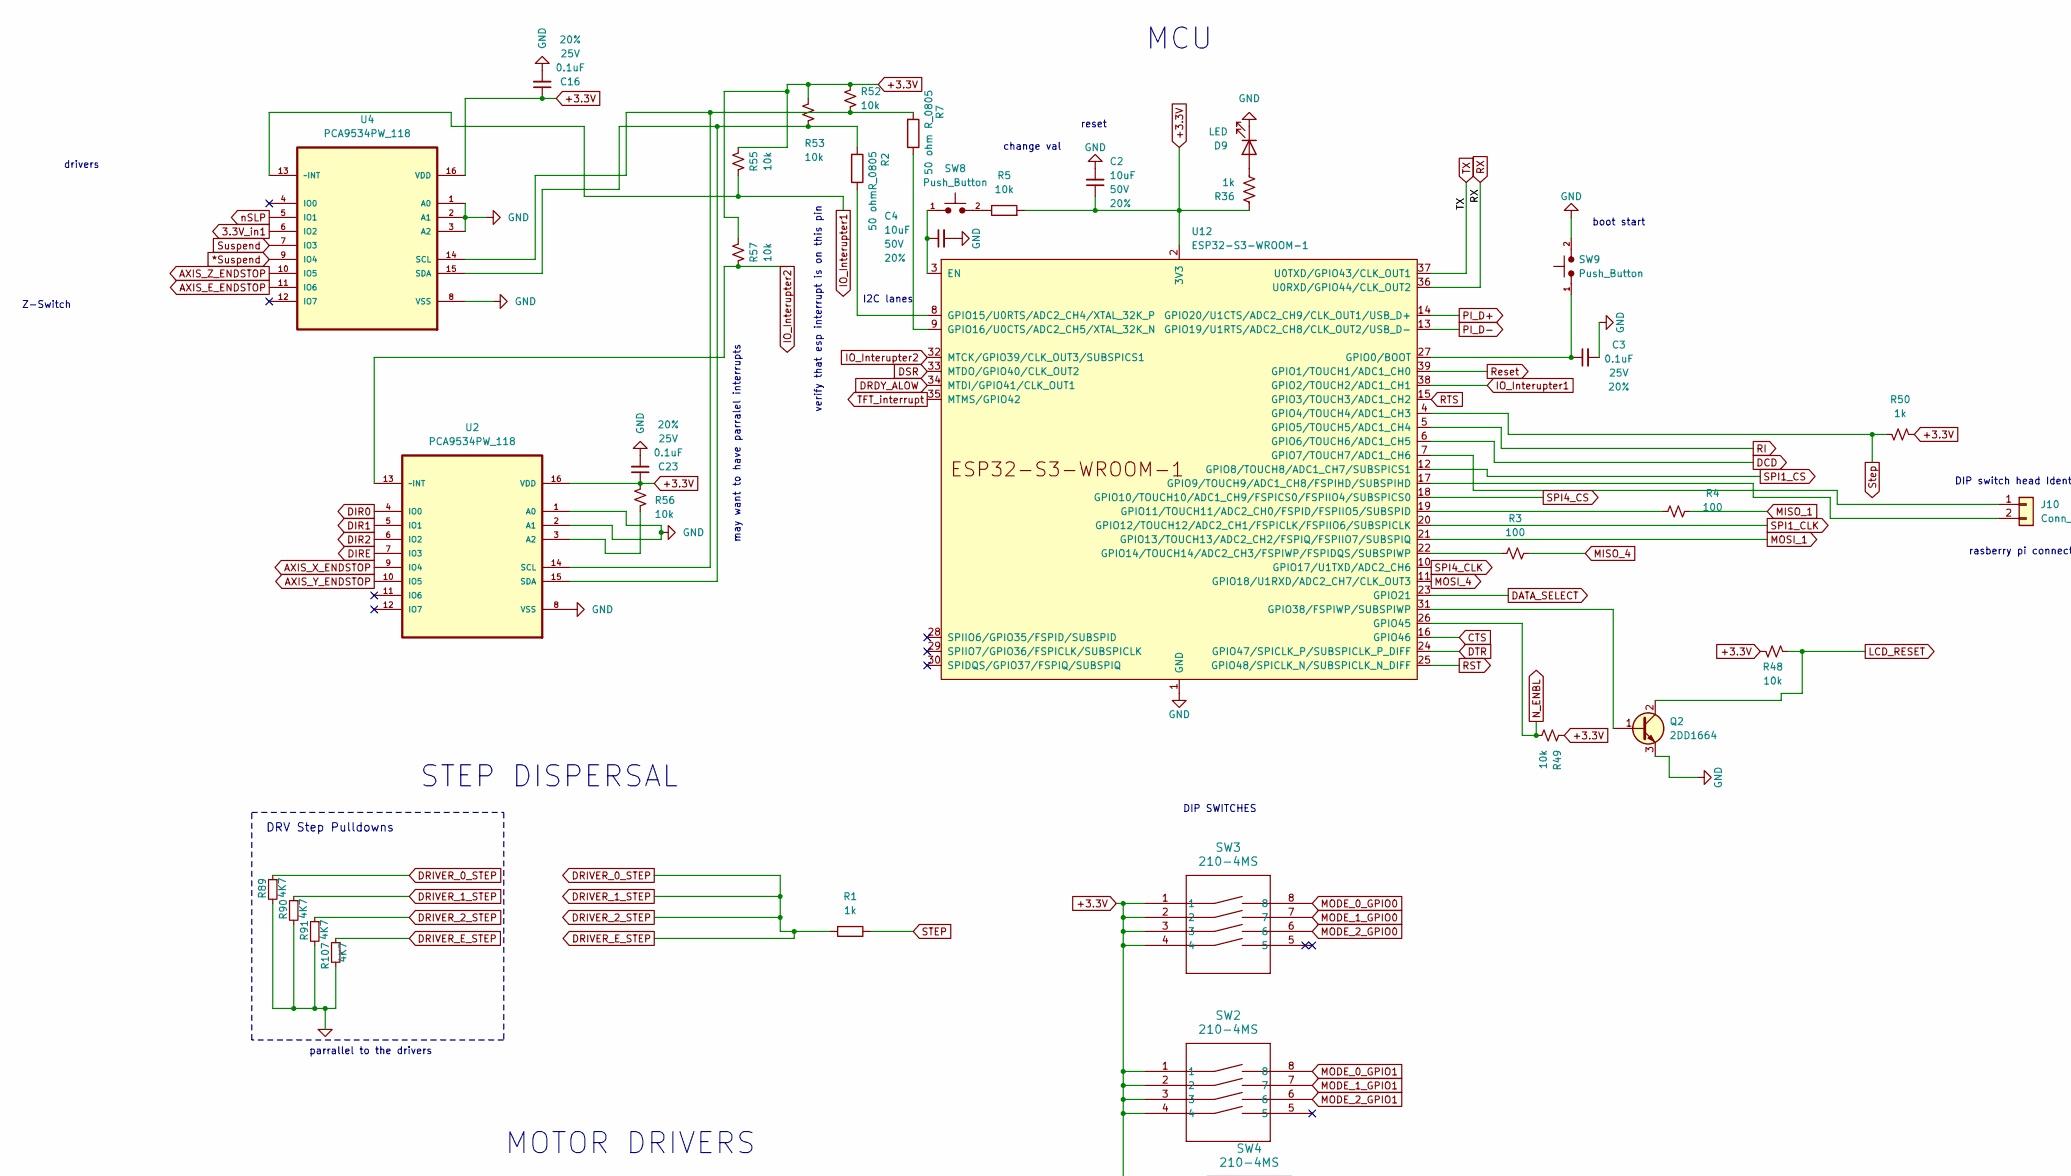
[picture p120: schematic Mainboard layout Pre-16 pin SD module.kicad_sch, part in row 1, column 1]

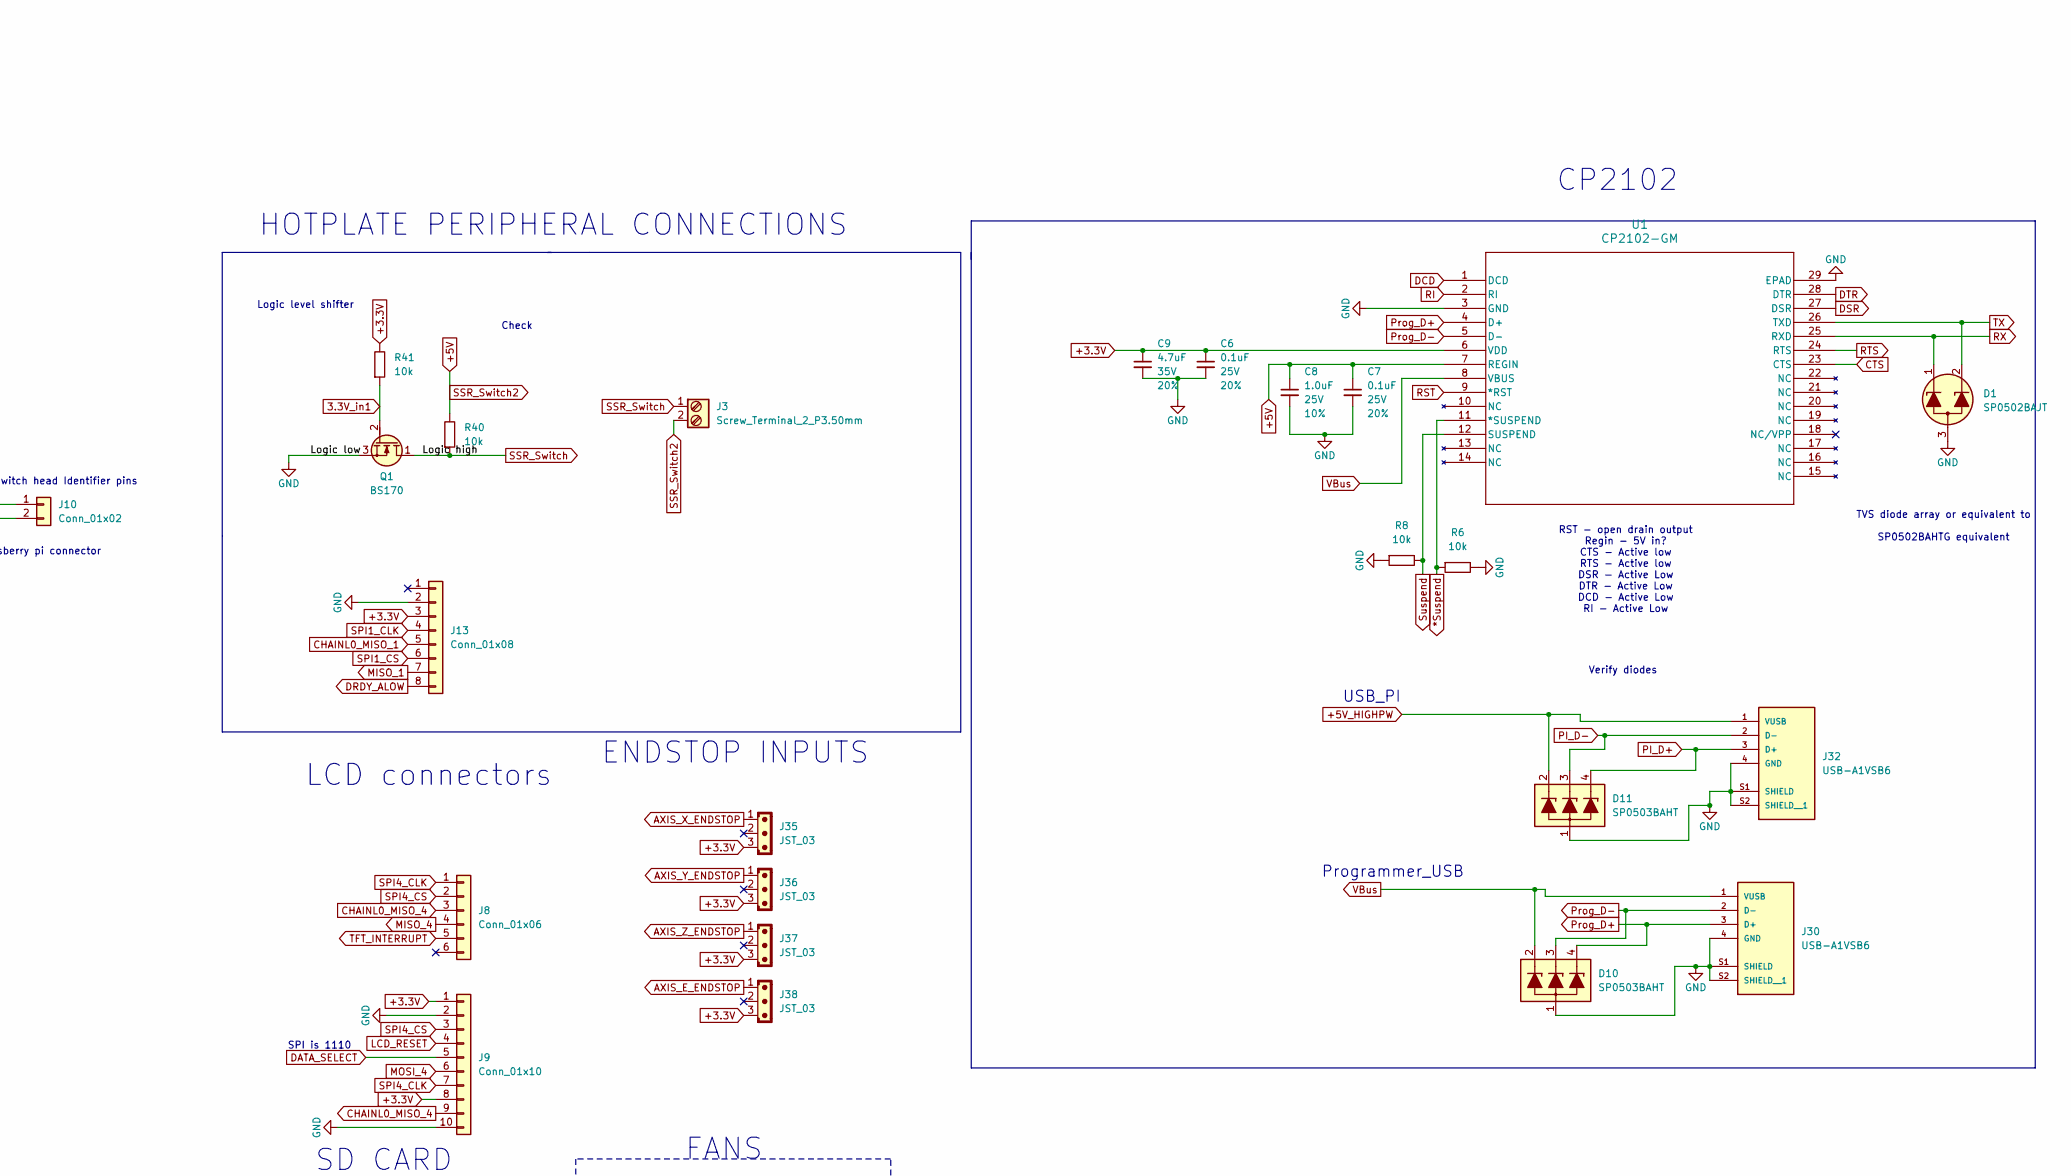
[picture p121: schematic Mainboard layout Pre-16 pin SD module.kicad_sch, part in row 1, column 2]

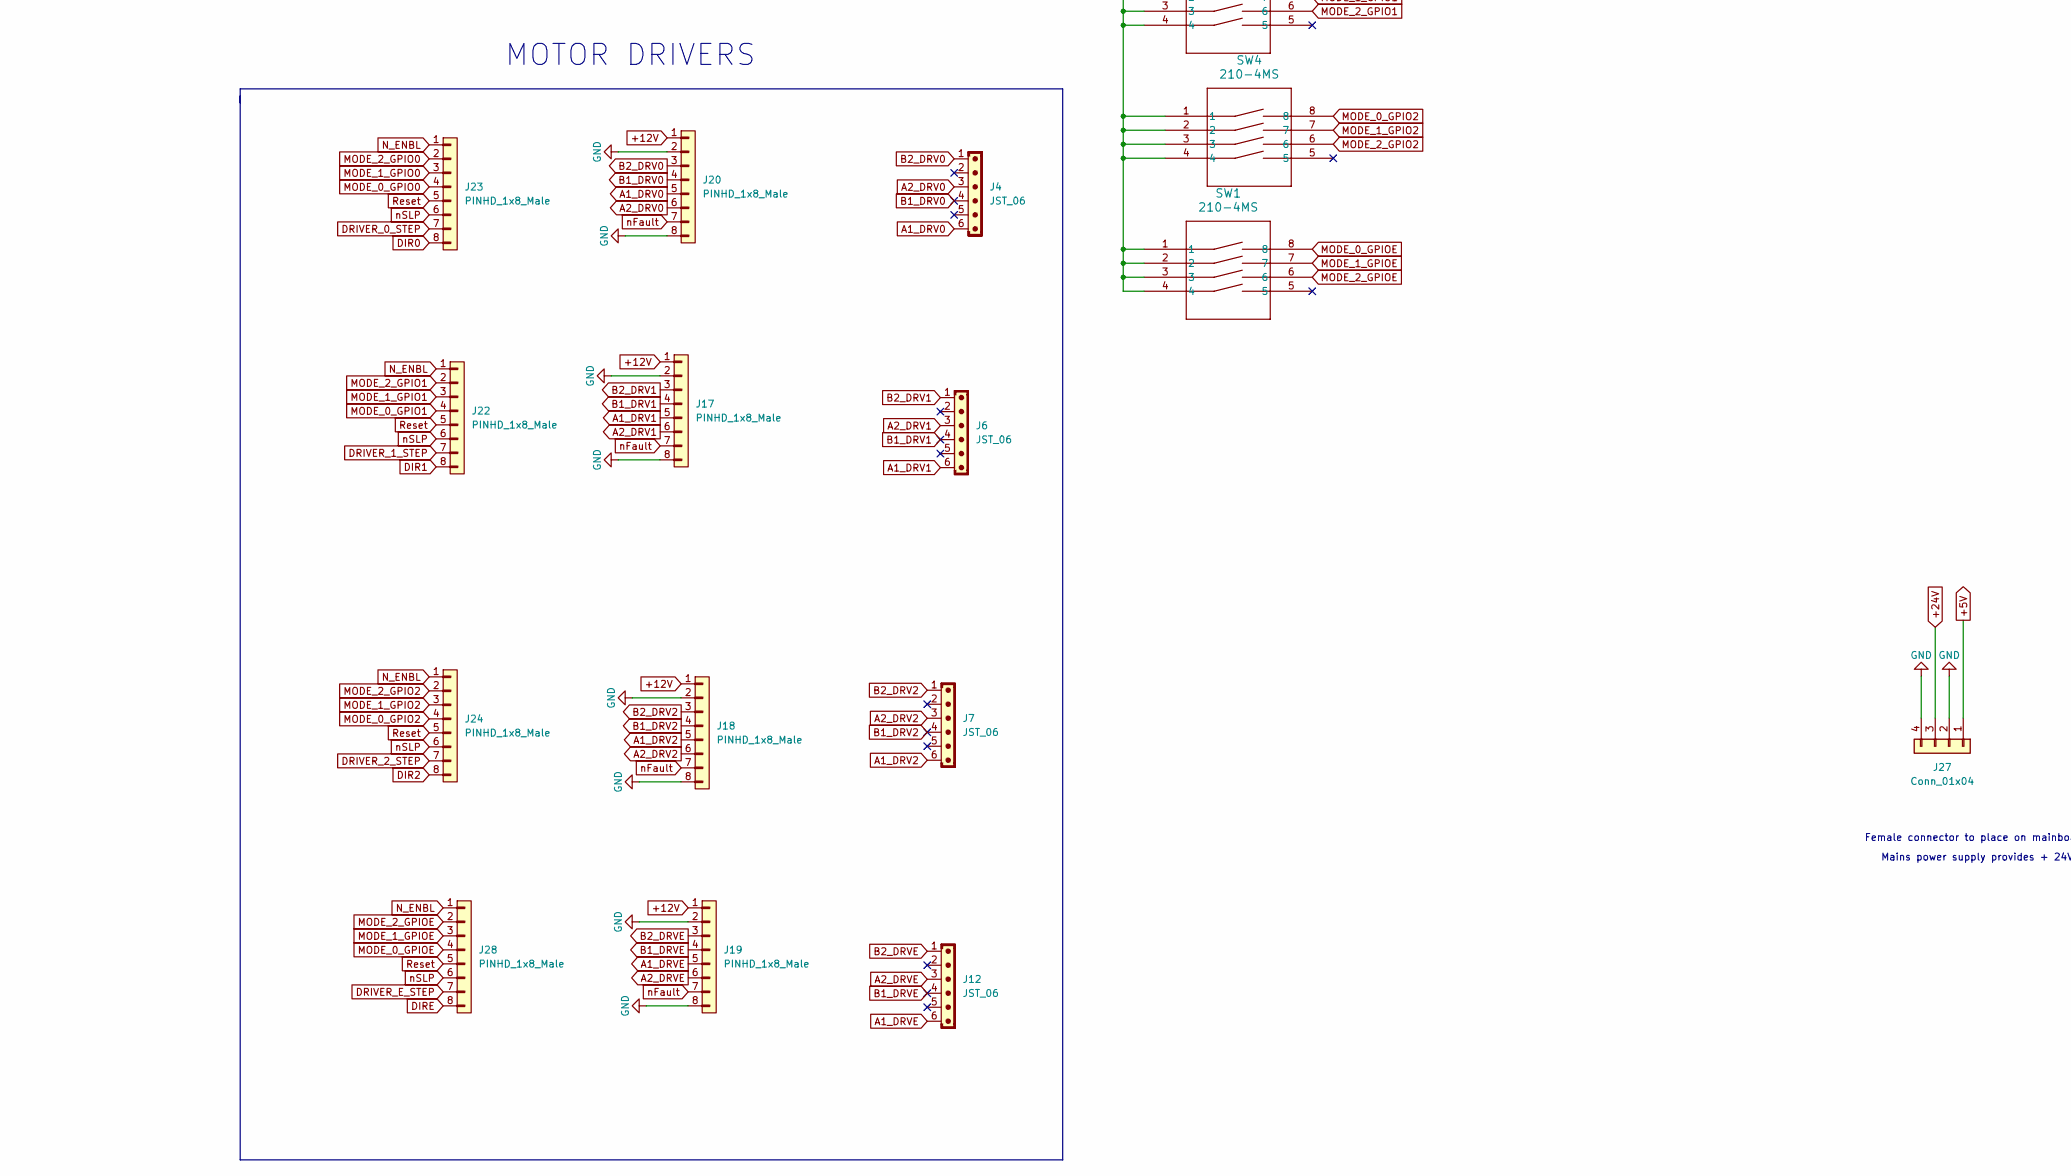
[picture p122: schematic Mainboard layout Pre-16 pin SD module.kicad_sch, part in row 2, column 1]

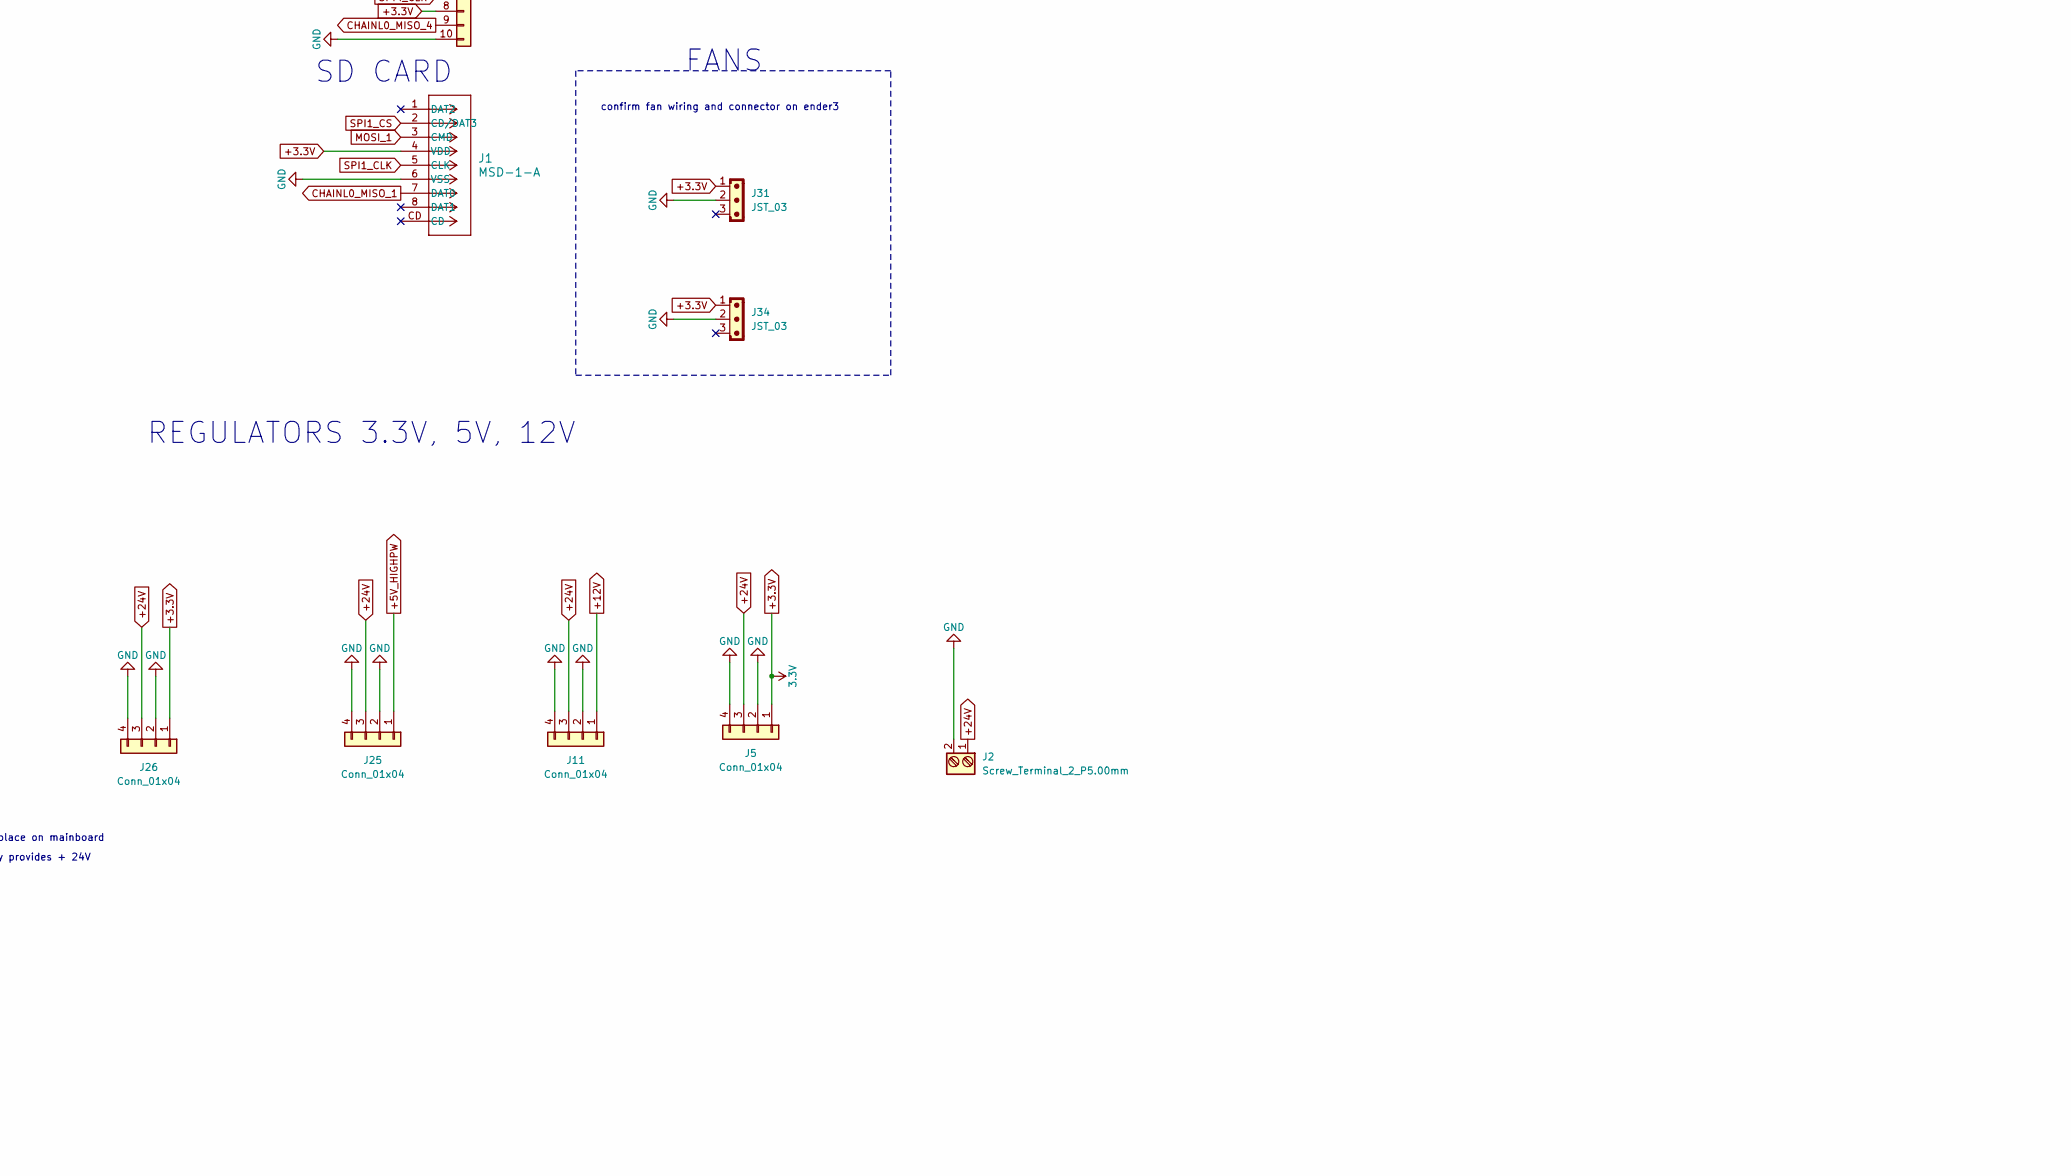
[picture p123: schematic Mainboard layout Pre-16 pin SD module.kicad_sch, part in row 2, column 2]

Parts:
C2, C4: 10uF; C_1210_3225Metric; Voltage 50V; Tolerance 20%
C3, C6, C7, C16, C23: 0.1uF; C_0603_1608Metric; Voltage 25V; Tolerance 20%
C8: 1.0uF; C_0805_2012Metric; Voltage 25V; Tolerance 10%
C9: 4.7uF; C_0603_1608Metric; Voltage 35V; Tolerance 20%
D1: SP0502BAJT; SOT-323_SC-70
D9: LED; LED_0603_1608Metric
D10, D11: SP0503BAHT; SOT-143
J1: MSD-1-A; SD_Hirose_DM1AA_SF_PEJ82
J2: Screw_Terminal_2_P5.00mm; TerminalBlock_Phoenix_PT-1,5-2-5.0-H_1x02_P5.00mm_Horizontal
J3: Screw_Terminal_2_P3.50mm; TerminalBlock_Phoenix_PT-1,5-2-3.5-H_1x02_P3.50mm_Horizontal
J4, J6, J7, J12: JST_06; JST_EH_B6B-EH-A_1x06_P2.50mm_Vertical
J5, J11, J25, J26, J27: Conn_01x04; 1x04_P2.54mm
J8: Conn_01x06; 1x06_P2.54mm
J9: Conn_01x10; 1x10_P2.54mm
J10: Conn_01x02; 1x02_P2.54mm
J13: Conn_01x08; 1x08_P2.54mm
J17, J18, J19, J20, J22, J23, J24, J28: PINHD_1x8_Male; PinHeader_1x08_P2.54mm_Vertical
J30, J32: USB-A1VSB6; USB_A_Kycon_KUSBX-AS1N-B_Horizontal; PARTREV D
J31, J34, J35, J36, J37, J38: JST_03; JST_EH_B3B-EH-A_1x03_P2.50mm_Vertical
Q1: BS170; TO-92_Inline_Wide_DGS
Q2: 2DD1664; SOT-89-3
R1: 1k; R_Axial_DIN0207_L6.3mm_D2.5mm_P10.16mm_Horizontal
R2: 50 ohmR_0805; R_0805_2012Metric
R3, R4: 100; R_0603_1608Metric
R5, R6, R8, R40, R41: 10k; R_Axial_DIN0207_L6.3mm_D2.5mm_P10.16mm_Horizontal
R7: 50 ohm R_0805; R_0805_2012Metric
R36: 1k; R_1206_3216Metric_Pad1.30x1.75mm_HandSolder
R48, R49, R52, R53, R55, R56, R57: 10k; R_0603_1608Metric
R50: 1k; R_0603_1608Metric
R89, R90, R91, R107: 4K7; R_0603_1608Metric; Part Number RK73H1ETTP4701F
SW1, SW2, SW3, SW4: 210-4MS; DIP8_210-4_CTS
SW8, SW9: Push_Button; SW_PUSH_6mm
U1: CP2102-GM; QFN28_5X5_SIL
U2, U4: PCA9534PW_118; SOP65P640X110-16N; MPN PCA9534PW,118
U12: ESP32-S3-WROOM-1

Connections:
3.3V_in1: Q1.2 (G), R41.1, U4.6 (IO2); also elsewhere on the board
*Suspend: R6.1, U1.11 (*SUSPEND), U4.9 (IO4); also elsewhere on the board
+3.3V: C2.1, C6.1, C9.1, C16.1, C23.1, J1.4 (VDD), J5.1, J9.1, J9.8, J13.3, J26.1, J31.1, J34.1, J35.3, J36.3, J37.3, J38.3, R5.1, R36.1, R41.2, R48.1, R49.2, R50.2, R52.2, R53.2, R55.1, R56.2, R57.1, SW1.1, SW1.2, SW1.3, SW1.4, SW2.1, SW2.2, SW2.3, SW2.4, SW3.1, SW3.2, SW3.3, SW3.4, SW4.1, SW4.2, SW4.3, SW4.4, U1.6 (VDD), U2.16 (VDD), U4.16 (VDD), U12.2 (3V3); also elsewhere on the board
+5V: C7.1, C8.1, J3.2, J27.1, R40.2, U1.7 (REGIN)
+5V_HIGHPW: D11.2 (L1), J25.1, J32.1 (VUSB)
+12V: J11.1, J17.1, J18.1, J19.1, J20.1
+24V: J2.1, J5.3, J11.3, J25.3, J26.3, J27.3
A1_DRV0: J4.6, J20.5
A1_DRV1: J6.6, J17.5
A1_DRV2: J7.6, J18.5
A1_DRVE: J12.6, J19.5
A2_DRV0: J4.3, J20.6
A2_DRV1: J6.3, J17.6
A2_DRV2: J7.3, J18.6
A2_DRVE: J12.3, J19.6
AXIS_E_ENDSTOP: J38.1, U4.11 (IO6); also elsewhere on the board
AXIS_X_ENDSTOP: J35.1, U2.9 (IO4); also elsewhere on the board
AXIS_Y_ENDSTOP: J36.1, U2.10 (IO5); also elsewhere on the board
AXIS_Z_ENDSTOP: J37.1, U4.10 (IO5); also elsewhere on the board
B1_DRV0: J4.4, J20.4
B1_DRV1: J6.4, J17.4
B1_DRV2: J7.4, J18.4
B1_DRVE: J12.4, J19.4
B2_DRV0: J4.1, J20.3
B2_DRV1: J6.1, J17.3
B2_DRV2: J7.1, J18.3
B2_DRVE: J12.1, J19.3
CHAINL0_MISO_1: J1.7 (DAT0), J13.5
CHAINL0_MISO_4: J8.3, J9.9
CTS: U1.23 (CTS), U12.16 (GPIO46)
DATA_SELECT: J9.5, U12.23 (GPIO21)
DCD: U1.1 (DCD), U12.6 (GPIO6/TOUCH6/ADC1_CH5)
DIR0: J23.8, U2.4 (IO0); also elsewhere on the board
DIR1: J22.8, U2.5 (IO1); also elsewhere on the board
DIR2: J24.8, U2.6 (IO2); also elsewhere on the board
DIRE: J28.8, U2.7 (IO3); also elsewhere on the board
DRDY_ALOW: J13.8, U12.34 (MTDI/GPIO41/CLK_OUT1)
DRIVER_0_STEP: J22.7, J23.7, J24.7, J28.7, R1.1, R89.1, R90.1, R91.1, R107.1
DSR: U1.27 (DSR), U12.33 (MTDO/GPIO40/CLK_OUT2)
DTR: U1.28 (DTR), U12.24 (GPIO47/SPICLK_P/SUBSPICLK_P_DIFF)
GND: C2.2, C3.2, C4.2, C6.2, C7.2, C8.2, C9.2, C16.2, C23.2, D1.3 (A), D9.1 (K), D10.1 (VN), D11.1 (VN), J1.6 (VSS), J2.2, J5.2, J5.4, J9.2, J9.10, J11.2, J11.4, J13.2, J17.2, J17.8, J18.2, J18.8, J19.2, J19.8, J20.2, J20.8, J25.2, J25.4, J26.2, J26.4, J27.2, J27.4, J30.4 (GND), J30.S1 (SHIELD), J30.S2 (SHIELD__1), J31.2, J32.4 (GND), J32.S1 (SHIELD), J32.S2 (SHIELD__1), J34.2, Q1.3 (S), Q2.3 (E), R6.2, R8.1, R89.2, R90.2, R91.2, R107.2, SW9.2, U1.3 (GND), U1.29 (EPAD), U2.1 (A0), U2.2 (A1), U2.8 (VSS), U4.1 (A0), U4.2 (A1), U4.3 (A2), U4.8 (VSS), U12.1 (GND), U12.40 (GND), U12.41 (GND); also elsewhere on the board
IO_Interupter1: R55.2, U4.13 (~INT), U12.38 (GPIO2/TOUCH2/ADC1_CH1); also elsewhere on the board
IO_Interupter2: R57.2, U2.13 (~INT), U12.32 (MTCK/GPIO39/CLK_OUT3/SUBSPICS1); also elsewhere on the board
LCD_RESET: J9.4, Q2.2 (C), R48.2
MISO_1: J13.7, R4.2
MISO_4: J8.4, R3.2
MODE_0_GPIO0: J23.4, SW3.8
MODE_0_GPIO1: J22.4, SW2.8
MODE_0_GPIO2: J24.4, SW4.8
MODE_0_GPIOE: J28.4, SW1.8
MODE_1_GPIO0: J23.3, SW3.7
MODE_1_GPIO1: J22.3, SW2.7
MODE_1_GPIO2: J24.3, SW4.7
MODE_1_GPIOE: J28.3, SW1.7
MODE_2_GPIO0: J23.2, SW3.6
MODE_2_GPIO1: J22.2, SW2.6
MODE_2_GPIO2: J24.2, SW4.6
MODE_2_GPIOE: J28.2, SW1.6
MOSI_1: J1.3 (CMD), U12.21 (GPIO13/TOUCH13/ADC2_CH2/FSPIQ/FSPIIO7/S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)
MOSI_4: J9.6, U12.11 (GPIO18/U1RXD/ADC2_CH7/CLK_OUT3)
N_ENBL: J22.1, J23.1, J24.1, J28.1, R49.1, U12.26 (GPIO45)
unnamed: D9.2 (A), R36.2
unnamed: J10.1, U12.7 (GPIO7/TOUCH7/ADC1_CH6)
unnamed: J10.2, U12.17 (GPIO9/TOUCH9/ADC1_CH8/FSPIHD/SUBSPIHD)
unnamed: Q2.1 (B), U12.31 (GPIO38/FSPIWP/SUBSPIWP)
unnamed: R5.2, SW8.2
unnamed 66: R7.1, R52.1, U2.14 (SCL), U4.14 (SCL); also elsewhere on the board
unnamed 67: R2.1, R53.1, U2.15 (SDA), U4.15 (SDA); also elsewhere on the board
unnamed 68: R56.1, U2.3 (A2); also elsewhere on the board
unnamed: C4.1, SW8.1, U12.3 (EN)
unnamed: C3.1, SW9.1, U12.27 (GPIO0/BOOT)
unnamed: R4.1, U12.19 (GPIO11/TOUCH11/ADC2_CH0/FSPID/FSPIIO5/S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)
unnamed: R3.1, U12.22 (GPIO14/TOUCH14/ADC2_CH3/FSPIWP/FSPIDQS/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)
unnamed: R2.2, U12.8 (GPIO15/U0RTS/ADC2_CH4/XTAL_32K_P)
unnamed: R7.2, U12.9 (GPIO16/U0CTS/ADC2_CH5/XTAL_32K_N)
PI_D+: D11.4 (L3), J32.3 (D+), U12.14 (GPIO20/U1CTS/ADC2_CH9/CLK_OUT1/USB_D+)
PI_D-: D11.3 (L2), J32.2 (D-), U12.13 (GPIO19/U1RTS/ADC2_CH8/CLK_OUT2/USB_D-)
Prog_D+: D10.4 (L3), J30.3 (D+), U1.4 (D+)
Prog_D-: D10.3 (L2), J30.2 (D-), U1.5 (D-)
RI: U1.2 (RI), U12.5 (GPIO5/TOUCH5/ADC1_CH4)
RST: U1.9 (*RST), U12.25 (GPIO48/SPICLK_N/SUBSPICLK_N_DIFF)
RTS: U1.24 (RTS), U12.15 (GPIO3/TOUCH3/ADC1_CH2)
RX: D1.1 (K1), U1.25 (RXD), U12.36 (U0RXD/GPIO44/CLK_OUT2)
Reset: J22.5, J23.5, J24.5, J28.5, U12.39 (GPIO1/TOUCH1/ADC1_CH0)
SPI1_CLK: J1.5 (CLK), J13.4, U12.20 (GPIO12/TOUCH12/ADC2_CH1/FSPICLK/FSPIIO6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)
SPI1_CS: J1.2 (CD/DAT3), J13.6, U12.12 (GPIO8/TOUCH8/ADC1_CH7/SUBSPICS1)
SPI4_CLK: J8.1, J9.7, U12.10 (GPIO17/U1TXD/ADC2_CH6)
SPI4_CS: J8.2, J9.3, U12.18 (GPIO10/TOUCH10/ADC1_CH9/FSPICS0/FSPIIO4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)
SSR_Switch: J3.1, Q1.1 (D), R40.1
STEP: R1.2
Step: R50.1, U12.4 (GPIO4/TOUCH4/ADC1_CH3)
Suspend: R8.2, U1.12 (SUSPEND), U4.7 (IO3); also elsewhere on the board
TFT_INTERRUPT: J8.5
TFT_interrupt: U12.35 (MTMS/GPIO42)
TX: D1.2 (K2), U1.26 (TXD), U12.37 (U0TXD/GPIO43/CLK_OUT1)
VBus: D10.2 (L1), J30.1 (VUSB), U1.8 (VBUS)
nFault: J17.7, J18.7, J19.7, J20.7
nSLP: J22.6, J23.6, J24.6, J28.6, U4.5 (IO1); also elsewhere on the board

Notes on the sheet:
change val
DIP switch head Identifier pins
drivers
reset
USB_PI
DIP SWITCHES
SD CARD
Female connector to place on mainboard
LCD connectors
STEP DISPERSAL
I2C lanes
Logic level shifter
DRV Step Pulldowns
parrallel to the drivers
Programmer_USB
Z-Switch
MCU
CP2102
Verify diodes
SPI is 1110
confirm fan wiring and connector on ender3
boot start
may want to have parralel interrupts
MOTOR DRIVERS
ENDSTOP INPUTS
HOTPLATE PERIPHERAL CONNECTIONS
REGULATORS 3.3V, 5V, 12V
RST - open drain output Regin - 5V in? CTS - Active low RTS - Active low DSR - Active Low DTR - Active Low DCD - Active Low RI - Active Low
Check
TVS diode array or equivalent to SP0502BAHTG equivalent
rasberry pi connector
verify that esp interrupt is on this pin
Mains power supply provides + 24V
FANS

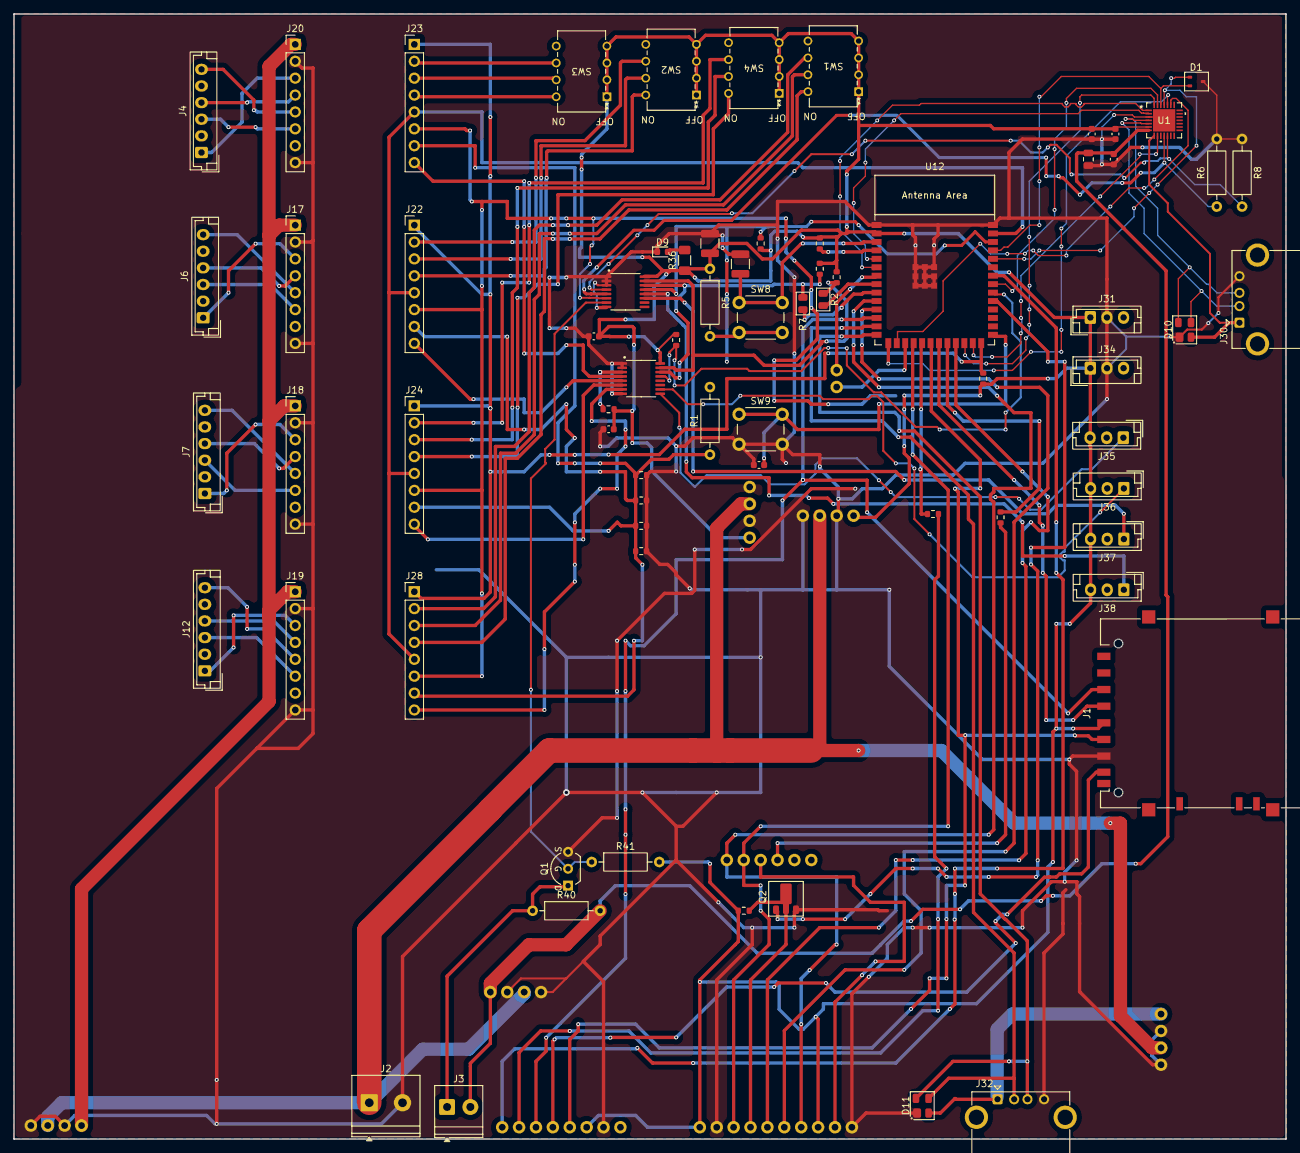
[picture p124: board Mainboard layout Pre-16 pin SD module.kicad_pcb from above]

Board: 2 copper layers, 191.3 x 169.2 mm, 80 parts (0 on the bottom side), 95 nets.

Other parts of the board:
U3, U5: PCA9534PW; TSSOP-16_4.4x5mm_P0.65mm

Their connections:
3.3V_in1: U3.7 (IO3); also elsewhere on the board
*Suspend: U3.5 (IO1); also elsewhere on the board
+3.3V: U3.16 (VDD), U5.16 (VDD); also elsewhere on the board
AXIS_E_ENDSTOP: U3.12 (IO7); also elsewhere on the board
AXIS_X_ENDSTOP: U5.9 (IO4); also elsewhere on the board
AXIS_Y_ENDSTOP: U5.10 (IO5); also elsewhere on the board
AXIS_Z_ENDSTOP: U3.11 (IO6); also elsewhere on the board
DIR0: U5.4 (IO0); also elsewhere on the board
DIR1: U5.5 (IO1); also elsewhere on the board
DIR2: U5.6 (IO2); also elsewhere on the board
DIRE: U5.7 (IO3); also elsewhere on the board
GND: U3.1 (A0), U3.2 (A1), U3.3 (A2), U3.8 (VSS), U5.1 (A0), U5.2 (A1), U5.8 (VSS); also elsewhere on the board
IO_Interupter1: U3.13 (~INT); also elsewhere on the board
IO_Interupter2: U5.13 (~INT); also elsewhere on the board
unnamed 66: U3.14 (SCL), U5.14 (SCL); also elsewhere on the board
unnamed 67: U3.15 (SDA), U5.15 (SDA); also elsewhere on the board
unnamed 68: U5.3 (A2); also elsewhere on the board
Suspend: U3.4 (IO0); also elsewhere on the board
nSLP: U3.6 (IO2); also elsewhere on the board
