ReadHeadRedemption/SeniorDesignSp26Su26/Hardware/KiCAD files/reference schematics/Senior design/drv8825 reference/Stepper-motor-driver-DRV8825-board-hardware-design-main/CAD/V1.0.0/Stepper_driver_DRV8825.kicad_pcb

## KiCad design Hardware/KiCAD files/reference schematics/Senior design/drv8825 reference/Stepper-motor-driver-DRV8825-board-hardware-design-main/CAD/V1.0.0/Stepper_driver_DRV8825.kicad_pcb (2026-04-21, an earlier design)

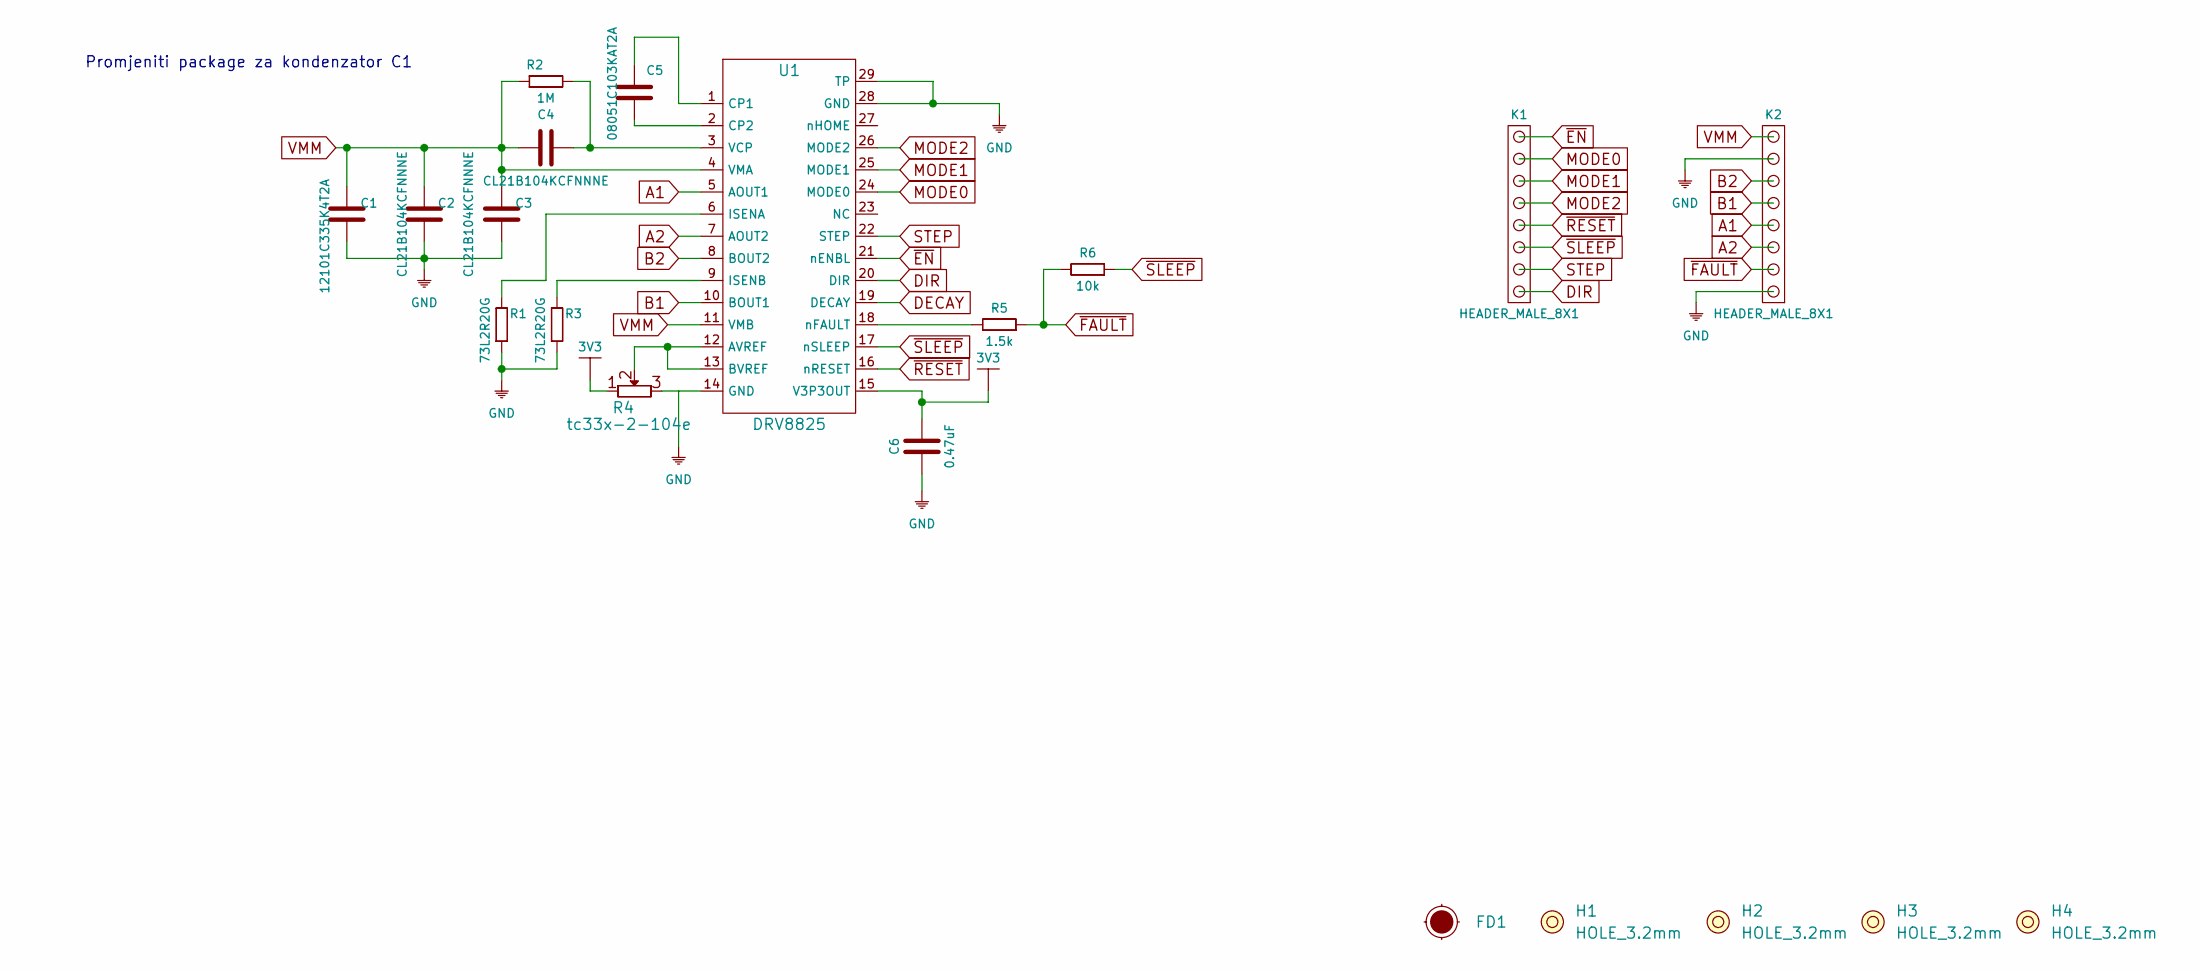
[picture p125: schematic Stepper_driver_DRV8825.kicad_sch]

Parts:
C1: 12101C335K4T2A; 0805C
C2, C3, C4: CL21B104KCFNNNE; 0805C
C5: 08051C103KAT2A; 0805C
C6: 0.47uF; 0603C
FD1: Fiducial_Stencil; FIDUCIAL_1MM_PASTE
H1, H2, H3, H4: HOLE_3.2mm
K1, K2: HEADER_MALE_8X1
R1, R3: 73L2R20G; 0603R
R2: 1M; 0603R
R4: tc33x-2-104e; tc33x-2-103e
R5: 1.5k; 0603R
R6: 10k; 0603R
U1: DRV8825

Connections:
3V3: C6.2, R4.1, U1.15 (V3P3OUT)
A1: K2.4, U1.5 (AOUT1)
A2: K2.3, U1.7 (AOUT2)
B1: K2.5, U1.10 (BOUT1)
B2: K2.6, U1.8 (BOUT2)
DECAY: U1.19 (DECAY)
DIR: K1.1, U1.20 (DIR)
GND: C1.1, C2.1, C3.1, C6.1, K2.1, K2.7, R1.1, R3.1, U1.14 (GND), U1.28 (GND), U1.29 (TP)
MODE0: K1.7, U1.24 (MODE0)
MODE1: K1.6, U1.25 (MODE1)
MODE2: K1.5, U1.26 (MODE2)
unnamed: C4.2, R2.2, U1.3 (VCP)
unnamed: C5.1, U1.2 (CP2)
unnamed: C5.2, U1.1 (CP1)
unnamed: R1.2, U1.6 (ISENA)
unnamed: R3.2, U1.9 (ISENB)
unnamed: R4.2, U1.12 (AVREF), U1.13 (BVREF)
unnamed: R5.2, U1.18 (nFAULT)
STEP: K1.2, U1.22 (STEP)
VMM: C1.2, C2.2, C3.2, C4.1, K2.8, R2.1, U1.4 (VMA), U1.11 (VMB)
~EN: K1.8, U1.21 (nENBL)
~FAULT: K2.2, R5.1, R6.2
~RESET: K1.4, U1.16 (nRESET)
~SLEEP: K1.3, R6.1, U1.17 (nSLEEP)

Notes on the sheet:
Promjeniti package za kondenzator C1

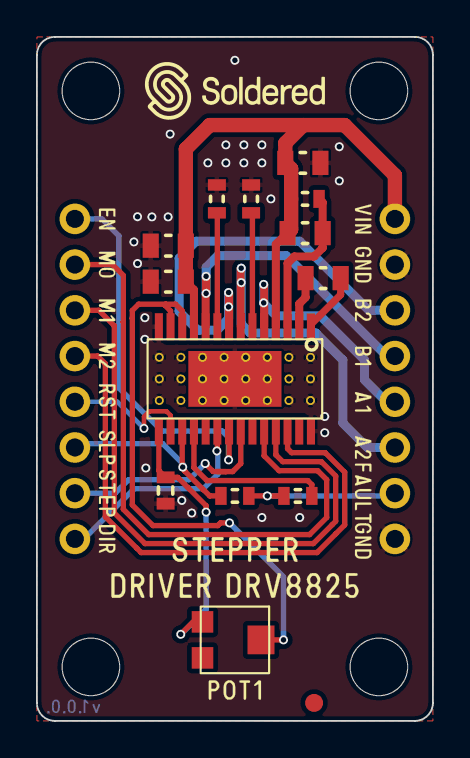
[picture p126: board Stepper_driver_DRV8825.kicad_pcb from above]

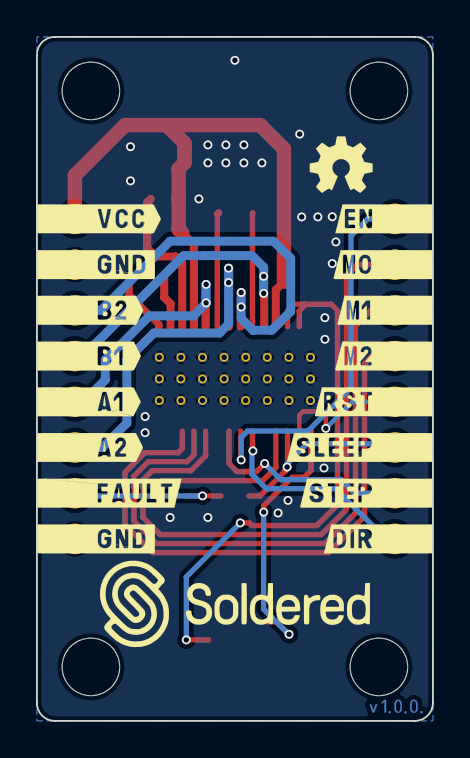
[picture p127: board Stepper_driver_DRV8825.kicad_pcb from below]

Board: 2 copper layers, 22.0 x 38.0 mm, 20 parts (2 on the bottom side), 23 nets.
