ReadHeadRedemption/SeniorDesignSp26Su26/Hardware/KiCAD files/Mainboard layout/Mainboard layout V1.kicad_pcb

## KiCad design Hardware/KiCAD files/Mainboard layout/Mainboard layout V1.kicad_pcb (2026-04-20, an earlier design)

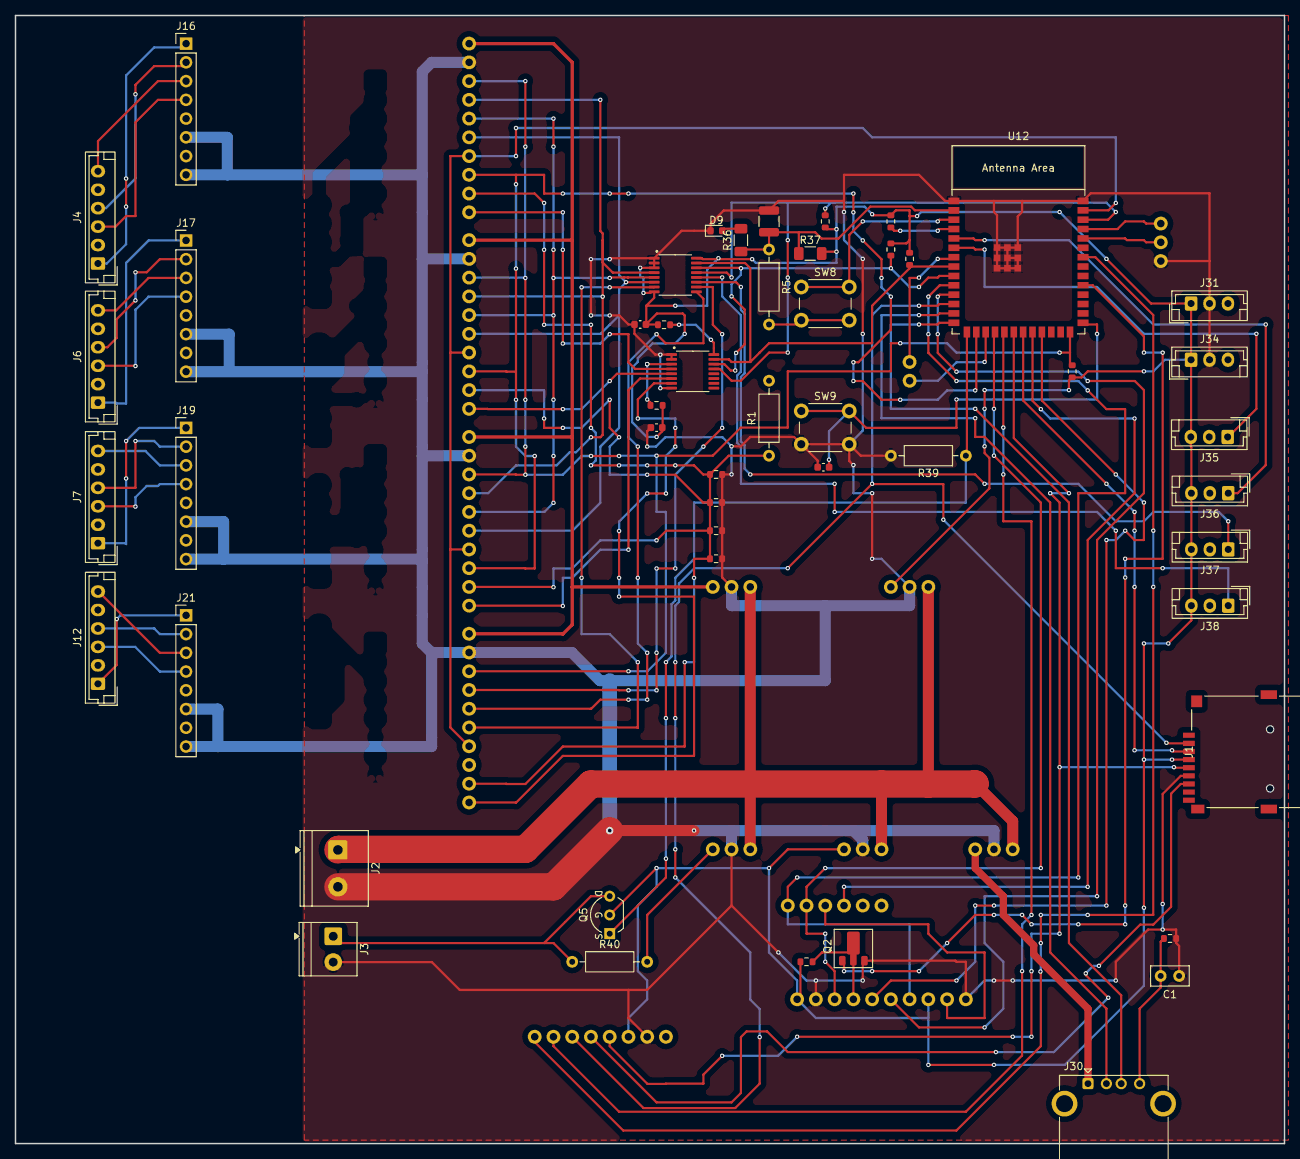
[picture p128: board Mainboard layout V1.kicad_pcb from above]

Board: 2 copper layers, 172.0 x 152.9 mm, 64 parts (0 on the bottom side), 75 nets.

Parts:
C1: 1nF_Ceramic; C_Disc_D5.0mm_W2.5mm_P2.50mm
C2: 10uF; C_1210_3225Metric
C3, C16, C23: 0.1uF; C_0603_1608Metric
D9: LED; LED_0603_1608Metric
J1: MSD-1-A; CONN9_MSD-1_CUD
J2: Screw_Terminal_2_P5.00mm; TerminalBlock_Phoenix_PT-1,5-2-5.0-H_1x02_P5.00mm_Horizontal
J3: Screw_Terminal_2_P3.50mm; TerminalBlock_Phoenix_PT-1,5-2-3.5-H_1x02_P3.50mm_Horizontal
J4, J6, J7, J12: JST_06; JST_EH_B6B-EH-A_1x06_P2.50mm_Vertical
J8: Conn_01x06; 1x06_P2.54mm
J9, J18, J20, J23, J24: Conn_01x10; 1x10_P2.54mm
J10: Conn_01x02; 1x02_P2.54mm
J11, J14, J15, J22, J28, J29: Conn_01x03; 1x03_P2.54mm
J13: Conn_01x08; 1x08_P2.54mm
J16, J17, J19, J21: PINHD_1x8_Male; PinHeader_1x08_P2.54mm_Vertical
J30: USB-A1VSB6; USB_A_Kycon_KUSBX-AS1N-B_Horizontal
J31, J34, J35, J36, J37, J38: JST_03; JST_EH_B3B-EH-A_1x03_P2.50mm_Vertical
Q2: 2DD1664; SOT-89-3
Q5: 2N7000; TO-92_Inline_Wide_SGD
R1: 1k; R_Axial_DIN0207_L6.3mm_D2.5mm_P10.16mm_Horizontal
R5, R39: 10k; R_Axial_DIN0207_L6.3mm_D2.5mm_P10.16mm_Horizontal
R6: 1M; R_0603_1608Metric
R36, R37: 1k; R_1206_3216Metric_Pad1.30x1.75mm_HandSolder
R40: 100k; R_Axial_DIN0207_L6.3mm_D2.5mm_P10.16mm_Horizontal
R48, R49, R50, R52, R53, R54, R55, R56: 10k; R_0603_1608Metric
R89, R90, R91, R107: 4K7; R_0603_1608Metric
SW8, SW9: Push_Button; SW_PUSH_6mm
U3, U5: PCA9534PW; TSSOP-16_4.4x5mm_P0.65mm
U12: ESP32-S3-WROOM-1

Connections:
3.3V_in1: Q5.1 (S), R39.1, U12.15 (GPIO3/TOUCH3/ADC1_CH2)
+3.3V: C16.1, C23.1, J1.4 (VDD), J9.1, J9.8, J13.3, J15.1, J22.1, J31.1, J34.1, J35.3, J36.3, J37.3, J38.3, Q5.2 (G), R37.2, R48.1, R49.2, R50.2, R52.2, R53.2, R54.2, R55.1, R56.2, U3.16 (VDD)
+5V: J14.1, R40.2
+5V_HIGHPW: J28.1, J30.1 (VUSB)
+12V: J18.10, J20.10, J23.10, J24.10, J29.1
+24V: J2.1, J14.3, J15.3, J22.3, J28.3, J29.3
/RX: J11.2, U12.36 (U0RXD/GPIO44/CLK_OUT2)
/TX: J11.1, U12.37 (U0TXD/GPIO43/CLK_OUT1)
A1_DRV0: J4.6, J16.3
A1_DRV1: J6.6, J17.3
A1_DRV2: J7.6, J19.3
A1_DRVE: J12.6, J21.3
A2_DRV0: J4.3, J16.4
A2_DRV1: J6.3, J17.4
A2_DRV2: J7.3, J19.4
A2_DRVE: J12.3, J21.4
AXIS_E_ENDSTOP: J38.1, U3.12 (IO7)
AXIS_X_ENDSTOP: J35.1, U12.6 (GPIO6/TOUCH6/ADC1_CH5)
AXIS_Y_ENDSTOP: J36.1, U12.5 (GPIO5/TOUCH5/ADC1_CH4)
AXIS_Z_ENDSTOP: J37.1, U3.11 (IO6)
B1_DRV0: J4.4, J16.2
B1_DRV1: J6.4, J17.2
B1_DRV2: J7.4, J19.2
B1_DRVE: J12.4, J21.2
B2_DRV0: J4.1, J16.1
B2_DRV1: J6.1, J17.1
B2_DRV2: J7.1, J19.1
B2_DRVE: J12.1, J21.1
CHAINL0_MISO_1: J1.7 (DAT0), J13.5
CHAINL0_MISO_4: J8.3, J9.9
D+: J30.3 (D+), U12.14 (GPIO20/U1CTS/ADC2_CH9/CLK_OUT1/USB_D+)
D-: J30.2 (D-), U12.13 (GPIO19/U1RTS/ADC2_CH8/CLK_OUT2/USB_D-)
DATA_SELECT: J9.5, U12.23 (GPIO21)
DIR0: J18.1, U5.4 (IO0)
DIR1: J20.1, U5.5 (IO1)
DIR2: J23.1, U5.6 (IO2)
DIRE: J24.1, U5.7 (IO3)
DRDY_ALOW: J13.8, U12.34 (MTDI/GPIO41/CLK_OUT1)
DRIVER_0_STEP: J18.2, J20.2, J23.2, J24.2, R1.1, R89.1, R90.1, R91.1, R107.1
GND: C1.1, C2.2, C3.2, C16.2, C23.2, D9.1 (K), J1.6 (VSS), J2.2, J3.2, J9.2, J9.10, J11.3, J13.2, J14.2, J15.2, J16.6, J16.8, J17.6, J17.8, J18.9, J19.6, J19.8, J20.9, J21.6, J21.8, J22.2, J23.9, J24.9, J28.2, J29.2, J31.2, J34.2, Q2.3 (E), R6.1, R39.2, R89.2, R90.2, R91.2, R107.2, SW9.2, U3.1 (A0), U3.2 (A1), U3.3 (A2), U3.8 (VSS), U5.1 (A0), U5.2 (A1), U5.8 (VSS), U12.1 (GND), U12.40 (GND), U12.41 (GND)
IO_Interupter: R55.2, U3.13 (~INT), U5.13 (~INT), U12.38 (GPIO2/TOUCH2/ADC1_CH1)
LCD_RESET: J9.4, Q2.2 (C), R48.2
MISO_1: J13.7, U12.19 (GPIO11/TOUCH11/ADC2_CH0/FSPID/FSPIIO5/S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)
MISO_4: J8.4, U12.22 (GPIO14/TOUCH14/ADC2_CH3/FSPIWP/FSPIDQS/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)
MODE_0_GPIO: J18.7, J20.7, J23.7, U3.4 (IO0)
MODE_0_GPIOE: J24.7, U3.10 (IO5)
MODE_1_GPIO: J18.6, J20.6, J23.6, U3.5 (IO1)
MODE_1_GPIOE: J24.6, U3.9 (IO4)
MODE_2_GPIO: J18.5, J20.5, J23.5, U3.6 (IO2)
MODE_2_GPIOE: J24.5, U3.7 (IO3)
MOSI_1: J1.3 (CMD), U12.21 (GPIO13/TOUCH13/ADC2_CH2/FSPIQ/FSPIIO7/S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)
MOSI_4: J9.6, U12.11 (GPIO18/U1RXD/ADC2_CH7/CLK_OUT3)
N_ENBL: J18.8, J20.8, J23.8, J24.8, R49.1, U12.26 (GPIO45)
unnamed: D9.2 (A), R36.2
unnamed: J10.1, U12.7 (GPIO7/TOUCH7/ADC1_CH6)
unnamed: J10.2, U12.17 (GPIO9/TOUCH9/ADC1_CH8/FSPIHD/SUBSPIHD)
unnamed: C1.2, J30.4 (GND), R6.2
unnamed: Q2.1 (B), U12.31 (GPIO38/FSPIWP/SUBSPIWP)
unnamed: R5.2, SW8.2
unnamed: R56.1, U5.3 (A2)
unnamed: R54.1, U5.16 (VDD)
unnamed: C2.1, R5.1, R36.1, R37.1, U12.2 (3V3)
unnamed: SW8.1, U12.3 (EN)
unnamed: C3.1, SW9.1, U12.27 (GPIO0/BOOT)
unnamed: R53.1, U3.15 (SDA), U5.15 (SDA), U12.8 (GPIO15/U0RTS/ADC2_CH4/XTAL_32K_P)
unnamed: R52.1, U3.14 (SCL), U5.14 (SCL), U12.9 (GPIO16/U0CTS/ADC2_CH5/XTAL_32K_N)
Reset: J18.4, J20.4, J23.4, J24.4, U12.39 (GPIO1/TOUCH1/ADC1_CH0)
SPI1_CLK: J1.5 (CLK), J13.4, U12.20 (GPIO12/TOUCH12/ADC2_CH1/FSPICLK/FSPIIO6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)
SPI1_CS: J1.2 (CD/DAT3), J13.6, U12.12 (GPIO8/TOUCH8/ADC1_CH7/SUBSPICS1)
SPI4_CLK: J8.1, J9.7, U12.10 (GPIO17/U1TXD/ADC2_CH6)
SPI4_CS: J8.2, J9.3, U12.18 (GPIO10/TOUCH10/ADC1_CH9/FSPICS0/FSPIIO4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)
SSR_Switch: J3.1, Q5.3 (D), R40.1
Step: R50.1, U12.4 (GPIO4/TOUCH4/ADC1_CH3)
nFault: J16.5, J17.5, J19.5, J21.5
nSLP: J18.3, J20.3, J23.3, J24.3, U12.16 (GPIO46)
