ReadHeadRedemption/SeniorDesignSp26Su26/Hardware/KiCAD files/Standalone DRV8825/in case ghosting fails Standalone DRV8825.kicad_pcb

## KiCad design Hardware/KiCAD files/Standalone DRV8825/in case ghosting fails Standalone DRV8825.kicad_pcb (2026-04-20)

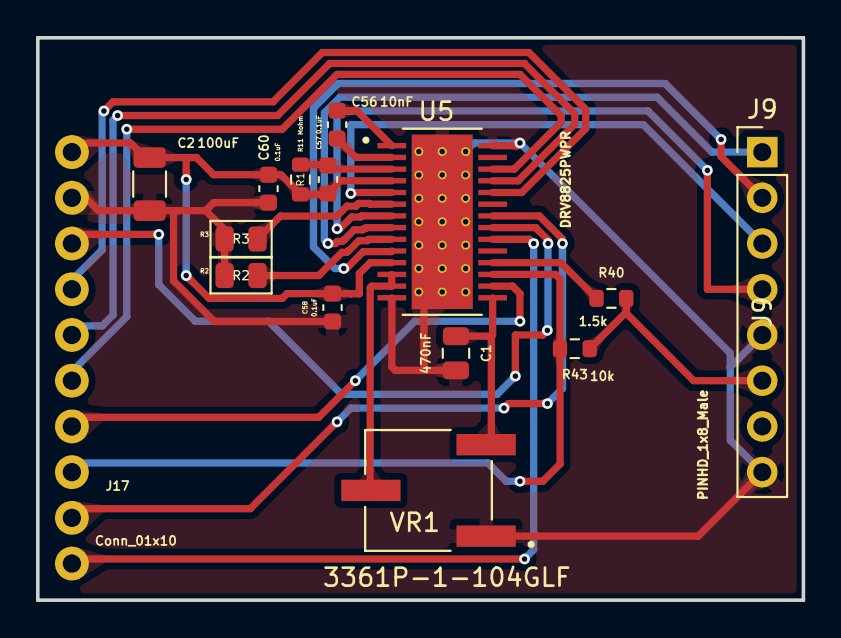
[picture p129: board in case ghosting fails Standalone DRV8825.kicad_pcb from above]

Board: 2 copper layers, 42.5 x 31.2 mm, 15 parts (0 on the bottom side), 23 nets.

Parts:
C1: 470nF; C_0805_2012Metric
C2: 100uF; C_1206_3216Metric
C56: 10nF; C_0603_1608Metric
C57, C58, C60: 0.1uF; C_0603_1608Metric
J9: PINHD_1x8_Male; PinHeader_1x08_P2.54mm_Vertical
J17: Conn_01x10; 1x10_P2.54mm
R1: 1 Mohm; R_0603_1608Metric
R2, R3: R_0805; R_0805_2012Metric
R40: 1.5k; R_0603_1608Metric
R43: 10k; R_0603_1608Metric
U5: DRV8825PWPR; IC_TPS61196PWPRQ1
VR1: 3361P-1-104GLF; TRIM_3361P-1-104GLF

Connections:
+3V3: C1.1, U5.15 (V3P3OUT), VR1.3
+12V: C2.1, C57.2, C58.1, C60.1, J17.10, R1.1, U5.4 (VMA), U5.11 (VMB)
/A1: J9.3, U5.5 (AOUT1)
/A2: J9.4, U5.7 (AOUT2)
/B1: J9.2, U5.10 (BOUT1)
/B2: J9.1, U5.8 (BOUT2)
/Set Home: J17.4, U5.16 (NRESET)
GND: C1.2, C2.2, C58.2, C60.2, J9.5, J9.8, J17.9, R2.2, R3.2, U5.14 (GND), U5.28 (GND), U5.29 (EPAD), U5.30, U5.31, U5.32, U5.33, U5.34, U5.35, U5.36, U5.37, U5.38, U5.39, U5.40, U5.41, U5.42, U5.43, U5.44, U5.45, U5.46, U5.47, U5.48, U5.49, U5.50, VR1.1
unnamed: J9.6, R40.2, R43.1
unnamed: J17.1, U5.20 (DIR)
unnamed: J17.2, U5.22 (STEP)
unnamed: J17.5, U5.26 (MODE2)
unnamed: J17.6, U5.25 (MODE1)
unnamed: J17.7, U5.24 (MODE0)
unnamed: J17.8, U5.21 (NENBL)
unnamed: U5.12 (AVREF), U5.13 (BVREF), VR1.2
unnamed: C56.1, U5.1 (CP1)
unnamed: C56.2, U5.2 (CP2)
unnamed: R3.1, U5.6 (ISENA)
unnamed: R2.1, U5.9 (ISENB)
unnamed: R40.1, U5.18 (NFAULT)
unnamed: C57.1, R1.2, U5.3 (VCP)
SLP: J17.3, R43.2, U5.17 (NSLEEP)
