ReadHeadRedemption/SeniorDesignSp26Su26/Hardware/KiCAD files/imported schems/seperate cshems/2026-03-30_09-39-17.sch

## EAGLE design Hardware/KiCAD files/imported schems/seperate cshems/2026-03-30_09-39-17.sch (2026-03-30)

Schematic: 2026-03-30_09-39-17.sch

Parts:
D1: 650mV; SOD-123HE
GND, GND2: WB_GND
L1: 15uH; DR1040
U1: TPS54231DR; D0008A
