ReadHeadRedemption/SeniorDesignSp26Su26/Hardware/KiCAD files/imported schems/seperate cshems/2026-03-30_09-39-17_1.kicad_sch

## KiCad design Hardware/KiCAD files/imported schems/seperate cshems/2026-03-30_09-39-17_1.kicad_sch (2026-03-30)

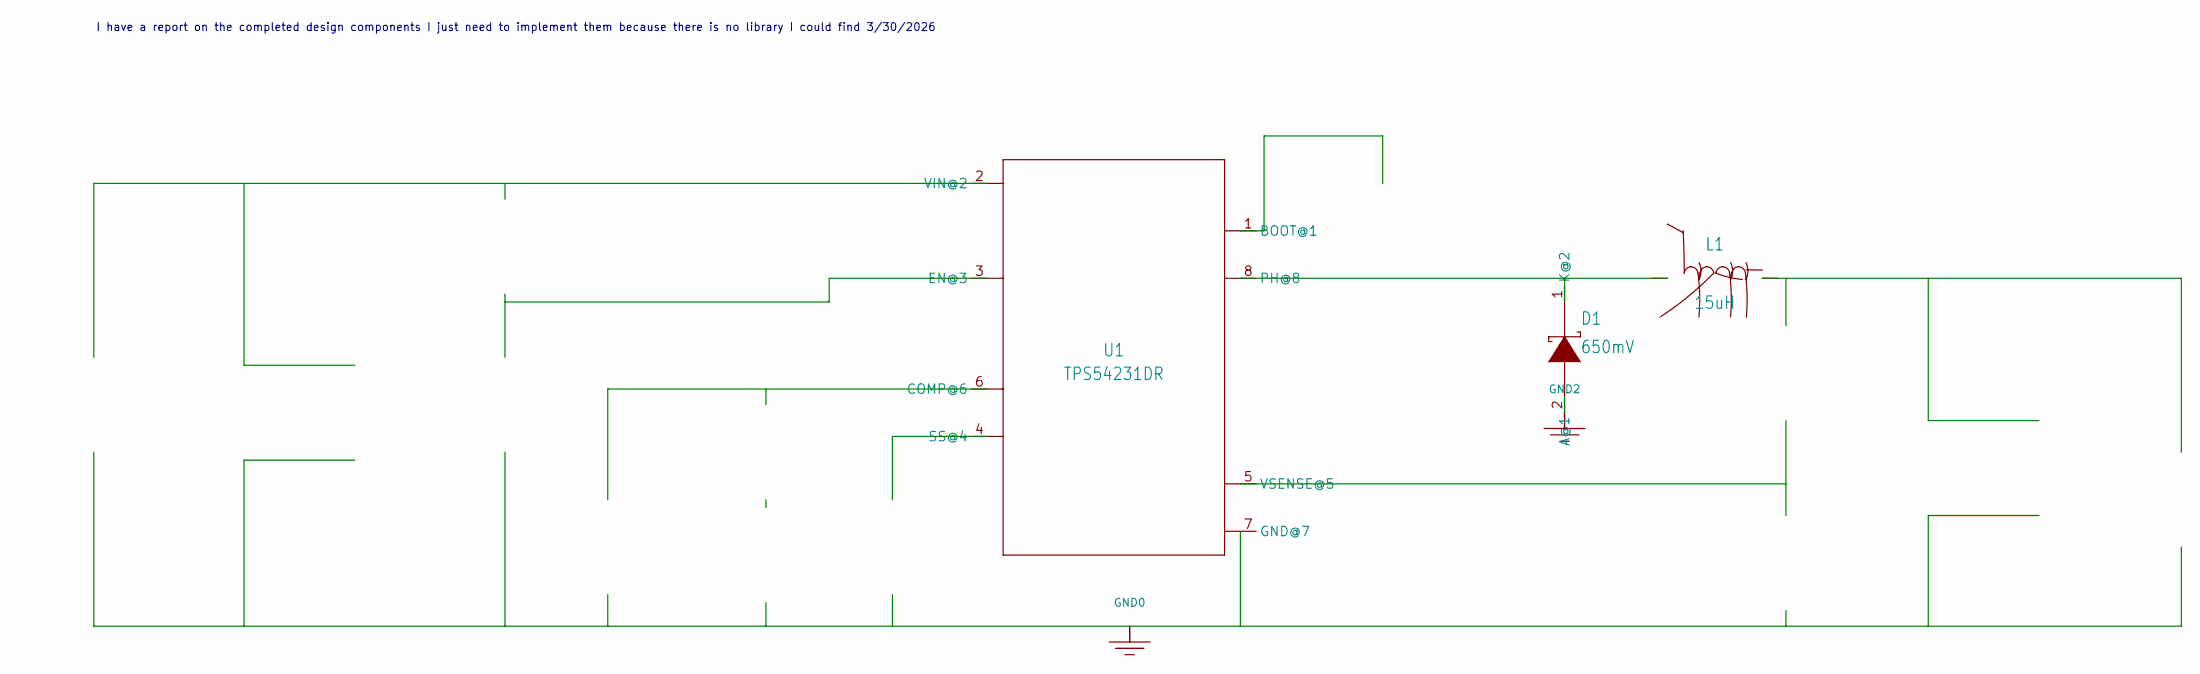
[picture p133: schematic 2026-03-30_09-39-17_1.kicad_sch]

Parts:
D1: 650mV; SOD-123HE
GND0, GND2: WB_GND
L1: 15uH; DR1040
U1: TPS54231DR; D0008A

Connections:
unnamed: D1.2 (A@1), GND2.1
unnamed: L1.2 (2@2), U1.8 (PH@8)

Notes on the sheet:
I have a report on the completed design components I just need to implement them because there is no library I could find 3/30/2026
