ReadHeadRedemption/SeniorDesignSp26Su26/Hardware/KiCAD files/tmc2160/tmc2160/tmc2160.kicad_sch

## KiCad design Hardware/KiCAD files/tmc2160/tmc2160/tmc2160.kicad_sch (2026-03-30)

Schematic: tmc2160.kicad_sch

Parts:
C2, C5: 2u2 16V; C_0603_1608Metric_Wbry; Part Number EMK107BC6225KA-T
C7: 0u1 10V; C_0402_1005Metric_Wbry; Part Number CL05A104KP5NNNC
C9: 470n 16V; C_0603_1608Metric_Wbry; Part Number CL10B474KO8NNNC
C11, C16: 2n2 50V; C_0402_1005Metric_Wbry; Part Number GCM155R71H222KA37D
C13, C18, C24, C26: 220n 16V; C_0603_1608Metric_Wbry; Part Number CL10B224KO8NNNC
C20, C28: 0u1 100V; C_0603_1608Metric_Wbry; Part Number HMK107B7104MA-T or similar
C22: 22n X7R 10% 100V; C_0603_1608Metric_Wbry; Part Number C0603C223K1RACTU
C30: 220u 63V; CP_Radial_D10.0mm_P5.00mm; Part Number 860010775018
C32, C33, C36, C38: 220n 100V; C_1206_3216Metric; Part Number C3216X7R2A224K115AA
C40, C41, C42, C44: 1n 100V; C_0603_1608Metric_Wbry; Part Number CGA3E2X7R2A102K080AA
D38, D39, D40, D41: BAT40V; SOT-563; Part Number BAT40V-7
J1: Conn_01x02; 1x02_P2.54mm
NT5, NT7: NT_SBG; NetTie-2_SMD_Pad0.25mm; Part Number Virtual Component DNP
Q1, Q2: DMHT6016LFJ; DMHT6016LFJ-13; Part Number DMHT6016LFJ
R5: 2R2 1%; R_0402_1005Metric_Wbry; Part Number RMCF0402FT2R20
R9, R10, R13, R14: 47R 1%; R_0402_1005Metric_Wbry; Part Number RMCF0402FT47R0
R25, R26, R36, R37, R62, R63, R64, R65: 150R; R_0402_1005Metric_Wbry; Part Number RMCF0402FT150R
R70, R75: 0R05 1% 1W; R_1206_3216Metric_Pad1.24x1.80mm_HandSolder; Part Number ERJ-8CWFR050V
U1: TMC2160; TMC5160-TA; Part Number TMC2160A-TA

Connections:
12V_VG: C2.2, U1.3 (12VOUT), U1.4 (VSA)
+3.3V: C7.2, J1.1, U1.20 (VCC_IO), U1.21 (SD_MODE), U1.22 (SPI_MODE)
D0_5VOUT: C5.2, R5.1, U1.5 (5VOUT)
D0_CA1: C26.2, U1.42 (CA1)
D0_CA2: C18.2, U1.35 (CA2)
D0_CB1: C24.2, U1.2 (CB1)
D0_CB2: C13.2, U1.43 (CB2)
D0_CPI: C22.2, U1.31 (CPO)
D0_CPO: C22.1, U1.32 (CPI)
D0_HA1: D39.4 (C), R63.1, U1.41 (HA1)
D0_HA2: D38.6 (C), R62.1, U1.36 (HA2)
D0_HAG1: D39.3 (A), Q1.12 (G4), R63.2
D0_HAG2: D38.1 (A), Q1.1 (G1), R62.2
D0_HB1: D41.4 (C), R26.1, U1.1 (HB1)
D0_HB2: D40.6 (C), R25.1, U1.44 (HB2)
D0_HBG1: D41.3 (A), Q2.12 (G4), R26.2
D0_HBG2: D40.1 (A), Q2.1 (G1), R25.2
D0_LA1: D39.6 (C), R64.1, U1.39 (LA1)
D0_LA2: D38.4 (C), R65.1, U1.38 (LA2)
D0_LAG1: D39.1 (A), Q1.9 (G3), R64.2
D0_LAG2: D38.3 (A), Q1.4 (G2), R65.2
D0_LB1: D41.6 (C), R36.1, U1.47 (LB1)
D0_LB2: D40.4 (C), R37.1, U1.46 (LB2)
D0_LBG1: D41.1 (A), Q2.9 (G3), R36.2
D0_LBG2: D40.3 (A), Q2.4 (G2), R37.2
D0_SRAG: NT5.1, R14.2
D0_SRAH: C16.2, R13.1, U1.8 (SRAH)
D0_SRAL: C16.1, R14.1, U1.7 (SRAL)
D0_SRAT: Q1.5 (S2), Q1.6 (S2), Q1.7 (S3), Q1.8 (S3), R13.2, R70.2
D0_SRBG: NT7.1, R10.2
D0_SRBH: C11.2, R9.1, U1.9 (SRBH)
D0_SRBL: C11.1, R10.1, U1.10 (SRBL)
D0_SRBT: Q2.5 (S2), Q2.6 (S2), Q2.7 (S3), Q2.8 (S3), R9.2, R75.2
D0_VCC: C9.2, R5.2, U1.29 (VCC)
D0_VCP: C20.1, U1.34 (VCP)
D0_VS: C20.2, C28.1, C30.1, C32.2, C33.2, C36.2, C38.2, Q1.2 (D1/D4), Q1.11 (D1/D4), Q1.14 (D1/D4), Q2.2 (D1/D4), Q2.11 (D1/D4), Q2.14 (D1/D4), U1.33 (VS)
DRIVER_0_A1: C26.1, C41.2, Q1.10 (S4/D3), Q1.15 (S4/D3), U1.40 (BMA1)
DRIVER_0_A2: C18.1, C40.2, Q1.3 (S1/D2), Q1.13 (S1/D2), U1.37 (BMA2)
DRIVER_0_B1: C24.1, C44.2, Q2.10 (S4/D3), Q2.15 (S4/D3), U1.48 (BMB1)
DRIVER_0_B2: C13.1, C42.2, Q2.3 (S1/D2), Q2.13 (S1/D2), U1.45 (BMB2)
DRIVER_0_DIAG0: U1.26 (DIAG0_SWN)
DRIVER_0_DIR: U1.18 (REFR_DIR)
DRIVER_0_SDO: U1.16 (SDO_CFG0)
DRIVER_0_STEP: U1.17 (REFL_STEP)
DRIVER_CS: U1.13 (CSN_CFG3)
DRIVER_ENN: U1.28 (DRV_ENN)
GND: C2.1, C5.1, C7.1, C9.1, C28.2, C30.2, C32.1, C33.1, C36.1, C38.1, C40.1, C41.1, C42.1, C44.1, J1.2, NT5.2, NT7.2, R70.1, R75.1
unnamed: U1.6 (GNDA), U1.11 (TST_MODE), U1.12 (CLK), U1.19 (GNDD), U1.23 (ENCB_DCEN_CFG4), U1.24 (ENCA_DCIN_CFG5), U1.30 (GNDD), U1.EPAD
SCK1: U1.14 (SCK_CFG2)
TXD1: U1.15 (SDI_CFG1)
