ReadHeadRedemption/SeniorDesignSp26Su26/(commit log)

2026-03-29 Refactor code structure for improved readability and maintainability
    [config.txt]
2026-03-29 add marlin as a gitsubmodule
    added marlin so now i can branch when adding features
2026-03-30 added current hardware from kicad, inital upload
    [2026-03-30_09-39-17.sch, 2026-03-30_09-39-17_1.kicad_sch, BOM(V0.7)_ESP32-S3-WROOM-2.xls, Comms.kicad_sch, Comms.sch, Duet3_MB.sch, Duet3_MB_6HC.kicad_sch, Endstops.kicad_sch]
2026-03-30 added more schematics for initial design
    [Peripherals.kicad_sch, motor_controls.kicad_sch]
2026-03-30 DRV8825 initial design
    [motor_controls.kicad_sch]
2026-04-02 Schematic adjustments made prior to initial submission to Chan thursday
    [BGA100C80P10X10_800X800X110.PcbLib, EDI2CAP.CFG, PSU.kicad_sch, Peripherals.kicad_sch, STM32H723VEH6.SchLib, STM32H723VEH6.stp, TFT_320x240_touch_r0.step, bga100c80p10x10_800x800x110.psm]
2026-04-02 Created Voltage Reg Schem
    Created voltage reg schematic on kicad for chapter 6. Adjustable voltage regulator
    [LM2576_Var_Volt_Reg.kicad_pcb, LM2576_Var_Volt_Reg.kicad_sch, do-201.stp]
2026-04-02 MCU power, new MCU placed, LCD communication, AC coupling of voltage reg on MCU
    [EDI2CAP.CFG, Peripherals.kicad_sch, QFP50P2200X2200X160-144N.PcbLib, STM32H723ZGT6.SchLib, chips.prt, motor_controls.kicad_sch, qfp50p2200x2200x160-144n.psm, untitled.kicad_sch]
2026-04-03 IO pull resistors, Motor driver V1, LCD communication
    [IO_expander.kicad_sch, PSU.kicad_sch, Peripherals.kicad_sch, Senior design Mainboard.kicad_sch, motor_controls.kicad_sch, untitled.kicad_sch]
2026-04-05 1.1, devices have been cleaned up
    [IO_expander.kicad_sch, PSU.kicad_sch, Peripherals.kicad_sch, hot-end_board.kicad_sch, hot-end_swap-in_board.kicad_sch, motor_controls.kicad_sch, testing_pads.kicad_sch, untitled.kicad_sch]
2026-04-06 added lm2679
    Updated LM2576 schematic and started creating PCB layout
    Created LM2679 Schematic
    Updated some slicer code to open config file more easily when only main is open
    [LM2576_Var_Volt_Reg.kicad_pcb, LM2576_Var_Volt_Reg.kicad_sch, LM2679PiRegulator.kicad_pcb, LM2679PiRegulator.kicad_sch, MBR360G.step, do-201.stp]
2026-04-06 ESP-32 Firmware Initial Commit
    Description:
    - Comes with SD card and serial port GCode command reading
    - Can move motor in various ways; check code
    - Needs configuration on pinouts for more functionality
2026-04-07 Voltage Regulator
    Finished creating schematics for LM2576 and LM2679. Also finished PCBs for them
    All PCBs 48x48 mm with drill holes in bottom left top right 4mm in on both sides
    [LM2576_Var_Volt_Reg.kicad_pcb, LM2576_Var_Volt_Reg.kicad_sch, LM2679PiRegulator.kicad_pcb, LM2679PiRegulator.kicad_sch, MBR360G.step]
2026-04-08 swapping connectors and rewiring through the project.
    we verified connections with the ender3. a few placeholders replaced.
    [PSU.kicad_sch, Peripherals.kicad_sch, USB-A1VSB6.step, motor_controls.kicad_sch, untitled.kicad_sch]
2026-04-11 New project made to reflect layouts
    New project files made in order to generate accurate layouts and create neatness.
    [IO_expander.kicad_sch, Mainboard layout.kicad_pcb, Mainboard layout.kicad_sch, Non swapping head board.kicad_pcb, Non swapping head board.kicad_sch, PSU.kicad_sch, Peripherals.kicad_sch, Swapping hotend board.kicad_pcb]
2026-04-11 Layout start
    Was having issues with assigning pinouts on my initial schematics due to missing footprints, layouts broken into different schematics.
    [Mainboard layout.kicad_pcb, Mainboard layout.kicad_sch, Swapping hotend board.kicad_pcb, Swapping hotend board.kicad_sch, freerouting.dsn, temp-freerouting.dsn]
2026-04-11 general update stuff
    - updated PCBs
    - removed marlin submodule
    - played with firmware
    [LM2576_Var_Volt_Reg.kicad_pcb]
2026-04-16 Mainboard Layout V1
    completed Mainboard V1 layout and one swapping side, a hotfix to come of the other board to take swapping side
    [Adafruit MAX31865.brd, Adafruit MAX31865.sch, Comms.kicad_sch, Duet3_MB_6HC.kicad_sch, Endstops.kicad_sch, Headers.kicad_sch, Htr_Fan.kicad_sch, IO_expander.kicad_sch]
2026-04-16 Hotfix to create non-swapping board
    hotfix on non-swapping done, swapping board is mapped for completion after CAD modeling phase begins
    [Mainboard layout.kicad_pcb, Mainboard layout.kicad_sch, Non swapping head board.kicad_pcb, Non swapping head board.kicad_sch, Swapping hotend board.kicad_pcb]
2026-04-16 Updated Website
    Updated Website and some of the kicad files to increase trace width on the regulators
    *** THE DEMO VIDOE IS NOT COMMITED AS THE FILE SIZE IS TOO LARGE ***
2026-04-17 another hotfix to the board, little adjustments
    [Mainboard layout.kicad_sch, Peripherals.kicad_sch]
2026-04-20 1st push of PCB's for printing
    This is pre-peer review. This almost certainly has section that need adjustment. also realized I'm missing the USB-Uart bridge. first thing added in next version.
    [3361P-1-104GLF.step, DRV8825PWP.step, LM2576_Var_Volt_Reg.kicad_pcb, LM2576_Var_Volt_Reg.kicad_sch, LM2679PiRegulator.kicad_pcb, Mainboard layout V1.kicad_pcb, Mainboard layout.kicad_pcb, Mainboard layout.kicad_sch]
2026-04-21 general progress and adjustments
    new footprint for pi reg inductor, var reg checked concurred with current part and value. re footprinted motor driver. started swapping head. adjusted some device footprints.
    [2100LL-221H-RC.SchLib, 2100LL-221H-RC.stp, 2100LL221HRC.PcbLib, 2100ll221hrc.psm, Change Log.xlsx, EDI2CAP.CFG, LM2576_Var_Volt_Reg.kicad_pcb, LM2576_Var_Volt_Reg.kicad_sch]
2026-04-22 general updates to the schematics and layouts
    includes some backchecks tot he master schematic to be accurate for the paper
    [LM2576_Var_Volt_Reg_12V.kicad_sch, LM2576_Var_Volt_Reg_3.3V.kicad_sch, LM2576_Var_Volt_Reg_5V.kicad_sch, LM2679PiRegulator.kicad_pcb, Mainboard layout.kicad_pcb, Mainboard layout.kicad_sch, Peripherals.kicad_sch, Standalone DRV8825.kicad_pcb]
2026-04-25 DRV 8825 and regulator purchased set
    [IO_expander.kicad_sch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]
2026-04-26 Most recent changes to final submission
    [LM2576_Var_Volt_Reg.csv, LM2679PiRegulator.kicad_pcb, Mainboard layout Pre-16 pin SD module.kicad_pcb, Mainboard layout Pre-16 pin SD module.kicad_sch, PCA9534PW_118.step]
2026-05-15 Slight adjustments for EMI
    trace changes primarily
    [Mainboard layout.kicad_pcb, Mainboard layout.kicad_sch, Max temperature V1.kicad_pcb, Max temperature V1.kicad_sch, PCA9534PW_118.step]
2026-05-15 slight addition
    includes some things that DR. weeks mentioned in class
    [Mainboard layout.kicad_sch]
2026-05-19 part of the way through next iteration
    Non-daisy chain Mainboard is ~50% through
    [.kicad_sch, LM2576_Var_Volt_Reg.kicad_pcb, Mainboard Layout No daisy chain.kicad_pcb, Mainboard Layout No daisy chain.kicad_sch, Mainboard layout Daisy chain removed.kicad_pcb, Mainboard layout Daisy chain removed.kicad_sch, Non swapping head board.kicad_pcb, Standalone DRV8825.kicad_pcb]
2026-05-22 1st submitted iteration
    added a folder for reviewing PCB's.
    fixed various smaller issues on the PCB.
    [LM2576_Var_Volt_Reg.kicad_pcb, LM2679PiRegulator.kicad_pcb, Maimbourd layout pre-weeks check 1.kicad_pcb, Maimbourd layout pre-weeks check 1.kicad_sch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]
2026-05-26 sick weekend changes
    small adjustments left our some larger protection changes till after talking to weeks
    [Mainboard Layout No daisy chain cp2102 moved.kicad_pcb, Mainboard Layout No daisy chain cp2102 moved.kicad_sch, Standalone DRV8825.kicad_pcb, Standalone DRV8825.kicad_sch]
2026-05-26 Compatability mods
    basic modifications to work toward compatability between boards physically on the hotend
    [Mainboard Layout No daisy chain cp2102 moved.kicad_pcb, Mainboard Layout No daisy chain cp2102 moved.kicad_sch, Max temperature V1.kicad_pcb, Max temperature V1.kicad_sch, Non swapping head board.kicad_pcb, Swapping hotend board.kicad_pcb, Swapping hotend board.kicad_sch]
2026-05-30 approved with final adjustments
    [LM2576_Var_Volt_Reg-B_Cu.gbr, LM2576_Var_Volt_Reg-B_Mask.gbr, LM2576_Var_Volt_Reg-B_Paste.gbr, LM2576_Var_Volt_Reg-B_Silkscreen.gbr, LM2576_Var_Volt_Reg-Edge_Cuts.gbr, LM2576_Var_Volt_Reg-F_Cu.gbr, LM2576_Var_Volt_Reg-F_Mask.gbr, LM2576_Var_Volt_Reg-F_Paste.gbr]
2026-06-04 V1 boards after final board invoice
    [LM2576_Var_Volt_Reg.kicad_sch, Mainboard Layout No daisy chain cp2102 moved.kicad_sch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]
2026-06-23 V2 mainboard
    [LM2576_Var_Volt_Reg.kicad_sch, LM2576_Var_Volt_Reg_12V.kicad_sch, LM2576_Var_Volt_Reg_3.3V.kicad_sch, LM2576_Var_Volt_Reg_5V.kicad_sch, LM2679PiRegulator.kicad_sch, Maimbourd layout pre-weeks check 1.kicad_pcb, Maimbourd layout pre-weeks check 1.kicad_sch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]
