ReadHeadRedemption/SeniorDesignSp26Su26/(notices)

Notices in the files:
Software/FirmwareSoftware/config.txt:
it under the terms of the GNU General Public License as published by
parts and their libraries:
microbuilder: This work is placed in the public domain, and may be freely used for commercial and non-commercial work with the following conditions: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
